furkankarakaya/GaN-Studies/README.md

# GaN-Studies
In this repository, GaN FET characterization and some power electronics topologies with GaN FETs are studied. <br />
Power Lab - http://power.eee.metu.edu.tr/
