furkankarakaya/GaN-Studies/Thesis/Appendix/Readme.md

# Personal Background
* [You can see my background through this link (CV)](https://sites.google.com/view/furkankarakaya/ana-sayfa)

# Papers
* [Investigation of Turn-on and Turn-off Characteristics of Enhancement-Mode GaN Power Transistors](https://ieeexplore.ieee.org/document/8515323)
* [PCB Layout Based Short-Circuit Protection Scheme for GaN HEMTs](https://ieeexplore.ieee.org/document/8913081)
* [Comparison of Wide-Band-Gap Technologies for Soft-Switching Losses at High Frequencies](https://ieeexplore.ieee.org/document/9079584)
* [Enhanced DAB for Efficiency Preservation Using Adjustable-Tap High-Frequency Transformer](https://ieeexplore.ieee.org/document/8930089)
* [High-Accuracy Calibration-Free Calorimeter for the Measurement of Low Power Losses](https://ieeexplore.ieee.org/document/9112711)
* [97.4%-Efficient All-GaN Dual-Active-Bridge Converter with High Step-up High-Frequency Matrix Transformer](https://ieeexplore.ieee.org/document/9178210)

# Simulation Documents

* [Switching Performance Analysis in Chapter 3](Chapter3_SimulinkModel.slx)
* [Buck Converter in Chapter 5](BuckConverter.asc)
* [Boost Converter in Chapter 5](BoostConverter.asc)

# PCB Documents
## Gate Charge Characterization Board

#### Top layer and top overlay

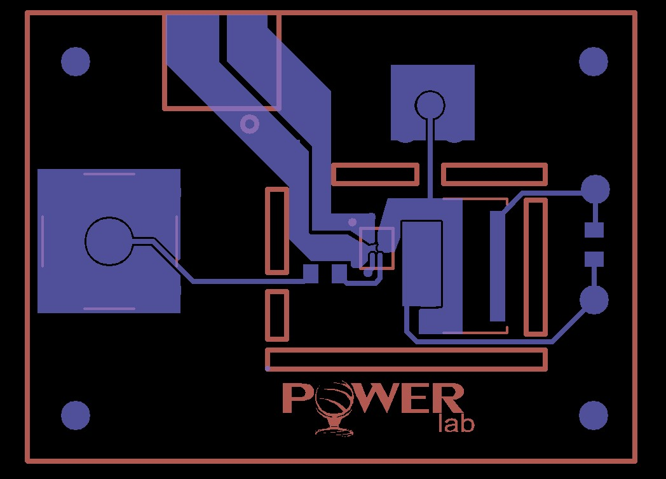
[picture p1: Thesis/Appendix/GateLossPCB.jpg]
</br>

## Output Capacitance Characterization Board

#### Top layer and top overlay

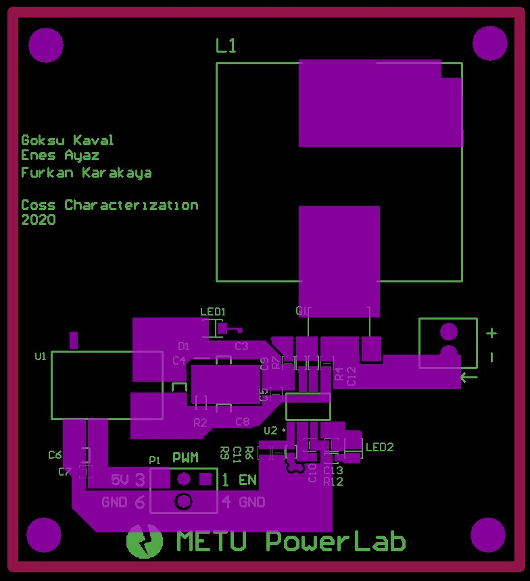
[picture p2: Thesis/Appendix/CossPCBTL.jpg]
</br>

#### Bottom layer and bottom overlay

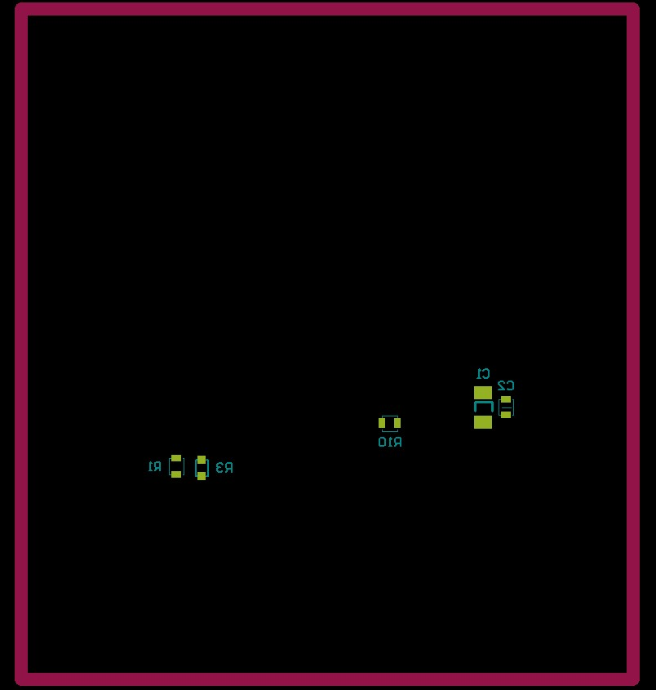
[picture p3: Thesis/Appendix/CossPCBBL.jpg]
</br>

## Control Board

#### Top layer and top overlay

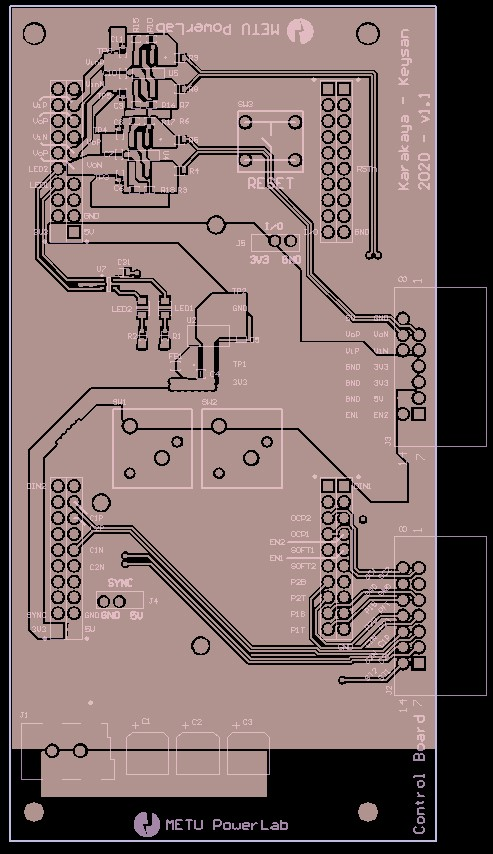
[picture p4: Thesis/Appendix/ControlBoardTL.jpg]
</br>

#### Bottom layer and bottom overlay

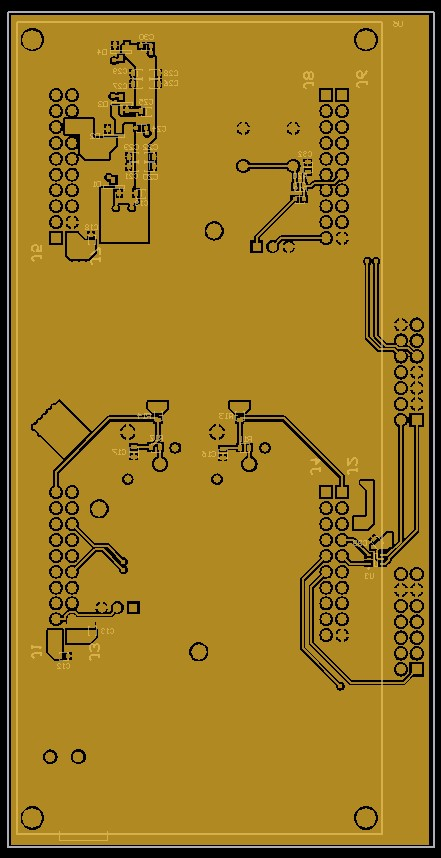
[picture p5: Thesis/Appendix/ControlBoardBL.jpg]
</br>

## DC/DC Converter Board

#### Top layer and top overlay

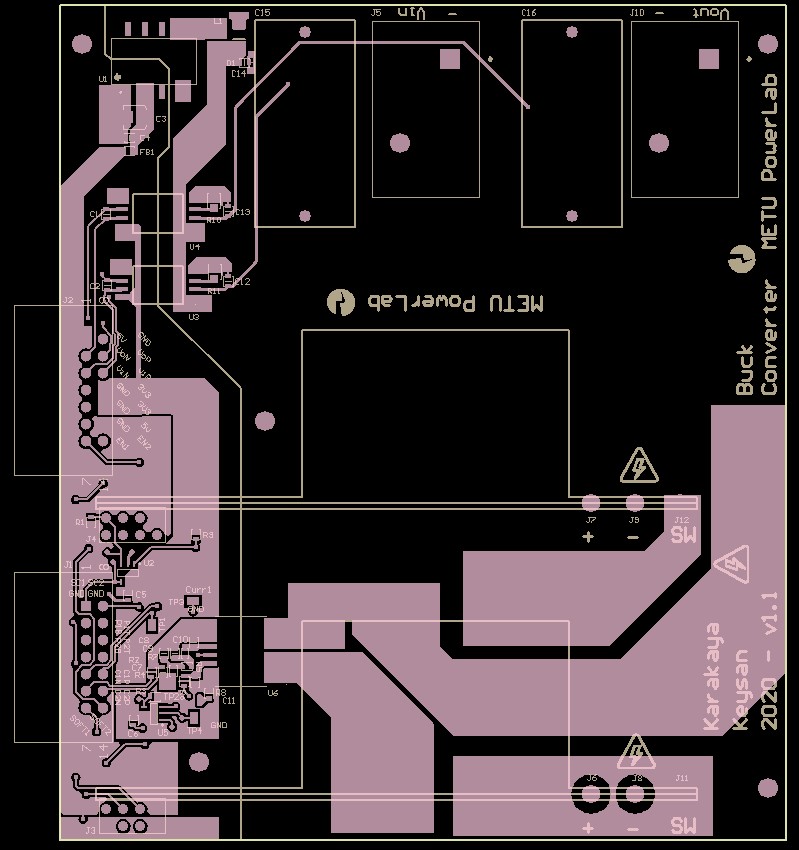
[picture p6: Thesis/Appendix/ConverterBoardTL.jpg]
</br>

#### Bottom layer and bottom overlay

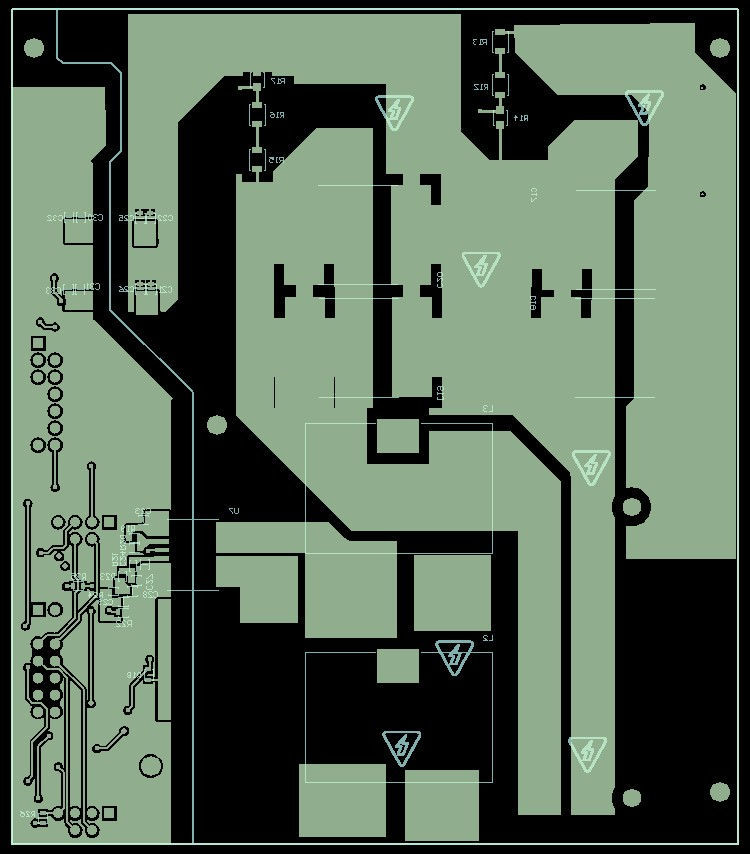
[picture p7: Thesis/Appendix/ConverterBoardBL.jpg]
</br>

## Half Bridge Board

#### Top layer and top overlay

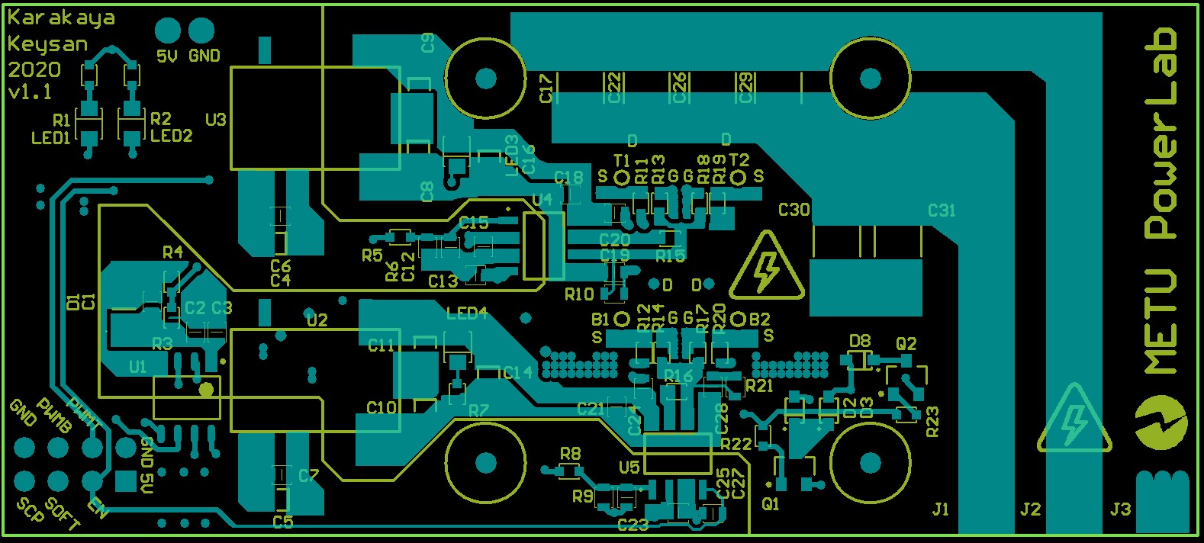
[picture p8: Thesis/Appendix/HalfBridgeBoardTL.jpg]
</br>

#### Middle 1

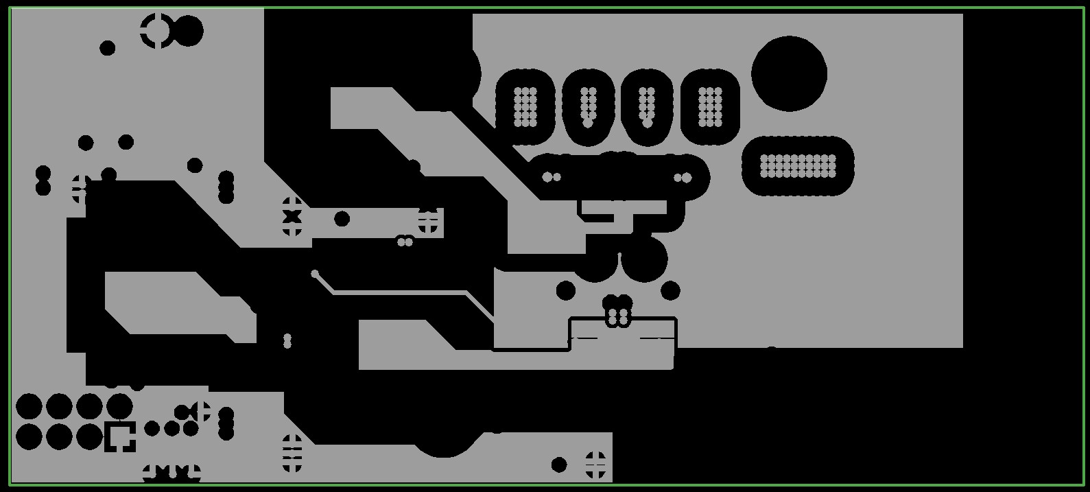
[picture p9: Thesis/Appendix/HalfBridgeBoardG1.jpg]
</br>

#### Middle 2

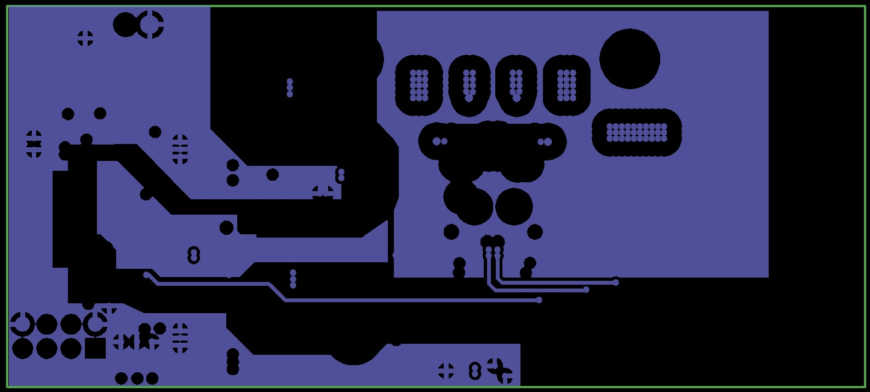
[picture p10: Thesis/Appendix/HalfBridgeBoardG2.jpg]
</br>

#### Bottom layer and bottom overlay

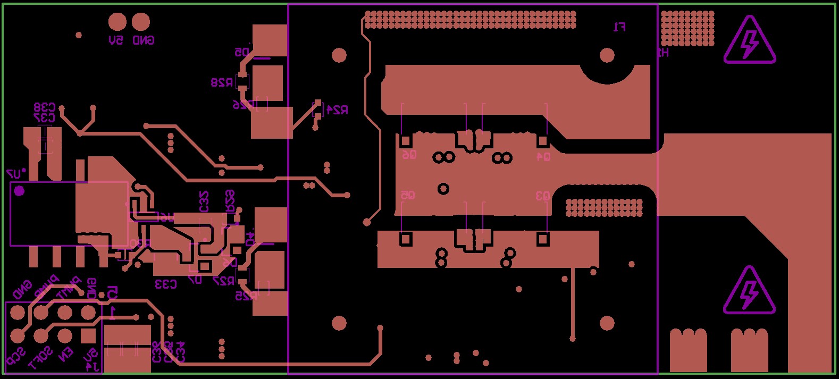
[picture p11: Thesis/Appendix/HalfBridgeBoardBL.jpg]
</br>
