furkankarakaya/GaN-Studies/Thesis/abbreviations.tex

\begin{theglossary}{LONGESTABBRV}

\item[2D]   2 Dimensional
\item[3D]   3 Dimensional
\item[UAV]  Unmanned Aerial Vehicle
\item[MDP]  Markov Decision Processes
\item[RL]   Reinforcement Learning
\item[DRL]  Deep Reinforcement Learning
\item[TRPO] Trust Region Policy Optimization
\item[PPO]  Proximal Policy Optimization
\item[PSO]  Particle Swarm Optimization
\item[MLP]  Multilayer Perceptron
\item[KL]   Kullback–Leibler
\item[PD]   Proportional-Derivative
\item[CoM]  Center of Mass
\item[p2p]  Point-to-point

\end{theglossary}

\newpage

\begin{theglossaryvar}{LONGESTABBRV}

\item[$M$]  Mass of bi-rotor body
\item[$m$]  Mass of tail
\item[$I$]  Inertia of bi-rotor body
\item[$I_{tail}$]  Inertia of tail
\item[$g$]  Gravitational acceleration
\item[$\mathbf{x}$]  State vector of bi-rotor system
\item[$p_x$]  Position of bi-rotor in x-direction
\item[$p_y$]  Position of bi-rotor in y-direction
\item[$\vartheta$]  Orientation of bi-rotor
\item[$v_x$]  Velocity of bi-rotor in x-direction
\item[$v_y$]  Velocity of bi-rotor in y-direction
\item[$\omega$]  Angular velocity of bi-rotor
\item[$\varphi$]  Orientation of tail with respect to bi-rotor body
\item[$\mathbf{u}$]  Input vector of bi-rotor system
\item[$f_l$]    Thrust of left rotor
\item[$f_r$]    Thrust of right rotor
\item[$\tau_{tail}$]   Torque applied to tail
\item[$\tau$]   Equivalent torque of left and right rotor thrusts
\item[$f$]   Sum of left and right rotor thrusts
\item[$s$]   State of an MDP
\item[$a$]   Action of an MDP
\item[$r$]   Reward of an MDP

\end{theglossaryvar}
