furkankarakaya/GaN-Studies/Thesis/chapters/chapter_2relwork.tex

\chapter{Related Work}%subject to change
\label{chp:relwork}

\section{Deep Reinforcement Learning}

\section{Curriculum Learning}

\section{Multi-rotor Control}
