furkankarakaya/GaN-Studies/Thesis/chapters/chapter_3mathbackgnd.tex

\chapter{Mathematical Background}
\label{chp:background}

\section{Bi-rotor Dynamics and Control}
\label{sec:dynamics}
