furkankarakaya/GaN-Studies/Weekly Reports/2020.05.18 - 2020.05.25.pptx

Inductor Design

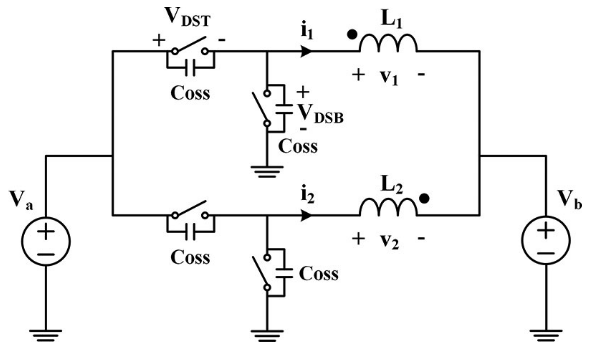
[picture p36: figure]

- Individual inductors for each phase
- Coupled inductor for two phases

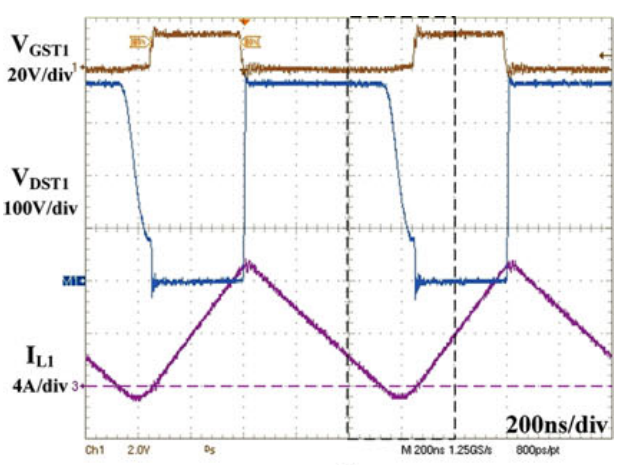
[picture p37: figure]
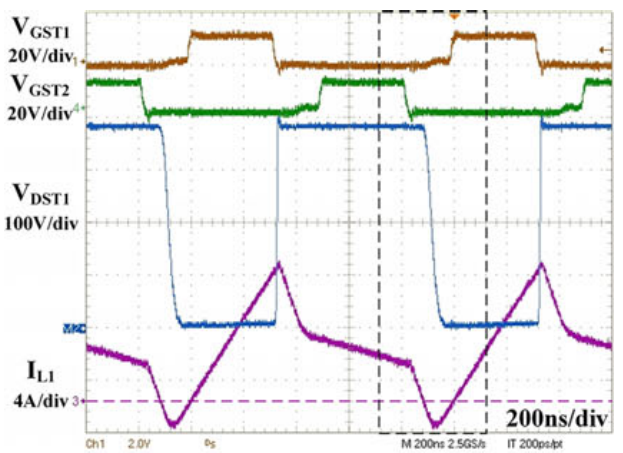
[picture p38: figure]

Individual Inductor

Coupled Inductor

## Slide 2

Inductor Design

5W losses for full load operation (8A) at 1 MHz switching frequency

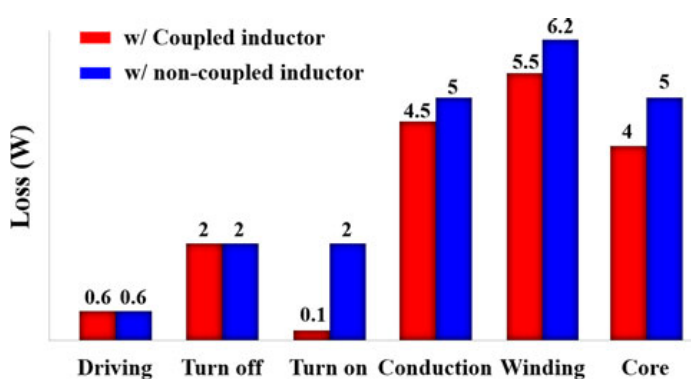
[picture p39: figure]

Coupled cores are advantageous for
  - Shorter resonant period
  - Lower core losses
  - Lower current ripple

but
  - Requires complex design

«Core loss is also reduced with coupled inductor since core volume can be shrink due to certain dc flux cancellation»

## Slide 3

Lets verify it

Non-coupled inductor material

ER23 (http://ferroxcube.home.pl/prod/assets/er23.pdf) core with 3F45 (https://elnamagnetics.com/wp-content/uploads/library/Ferroxcube-Materials/3F45_Material_Specification.pdf) material from Ferroxcube
- AL -> 1850 nH
- μr -> 840

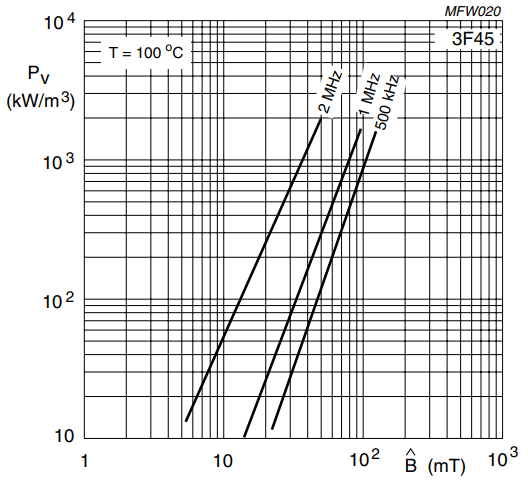
[picture p40: figure]

Specific power loss of 3F45 material

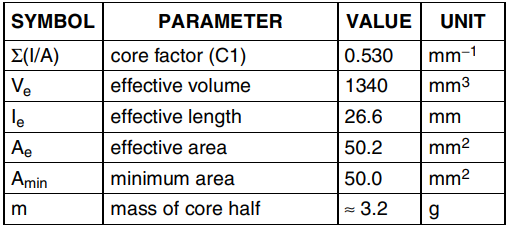
[picture p41: figure]

Effective core parameters

## Slide 4

Lets verify it

L = 8 μH
N =sqrt(L/(A_L)) = 2.079 −> 2
φ=(NI)/R
ΔB=(NΔI)/(RA_e)
R=(l_e)/(μ_r μ_o A_e)
ΔB=(NΔIμ_r μ_o)/(l_e)
ΔB=(2∗9 ∗840∗4π10^(−7))/(26.6∗10^(−3))=714 mT

Current Waveform

5Arms current with 4A average

9App ripple on inductor

## Slide 5

Lets verify it

P_(sp) =4∗10^5 (kW)/(m^3)
V_e =1340 mm^3
P_(core) =1340∗10^(−9) ∗4∗10^8
P_(core) =536 W

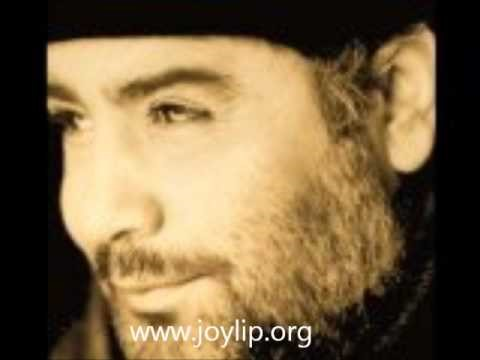
[picture p42: figure]

40x
