furkankarakaya/GaN-Studies/Weekly Reports/2020.03.30 - 2020.04.06.pptx

Common Mode Noise

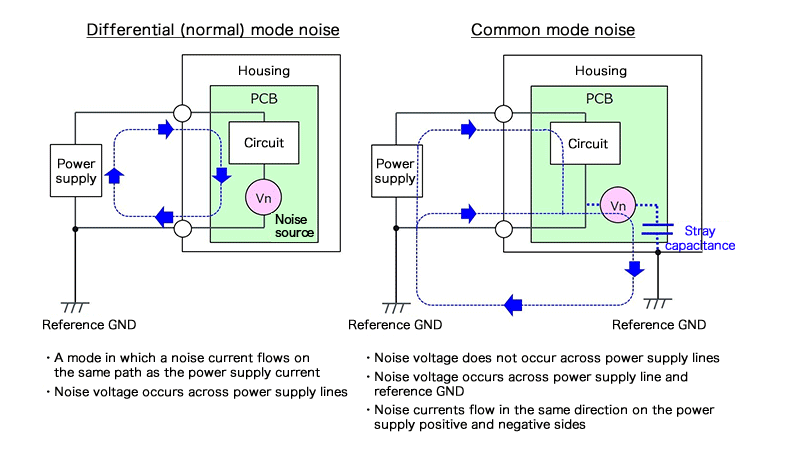
[picture p48: figure]

## Slide 2

Common Mode Noise

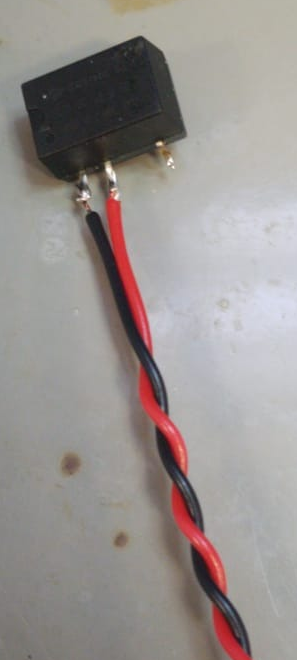
[picture p49: figure]

High side isolated converter

## Slide 3

Common Mode Noise

## Slide 4

Common Mode Noise

## Slide 5

SCP

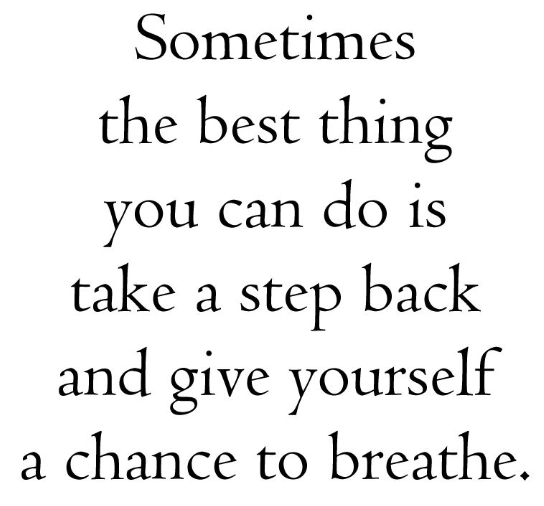
[picture p50: figure]

## Slide 6

Power Converters

Ciso -> Not given

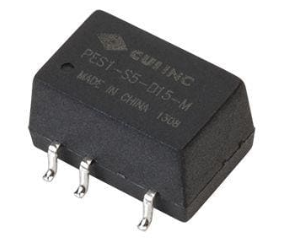
[picture p51: figure]

PES1-S5-S9-M (https://www.mouser.com.tr/ProductDetail/CUI-Inc/PES1-S5-S9-M)

Ciso -> 15 pF

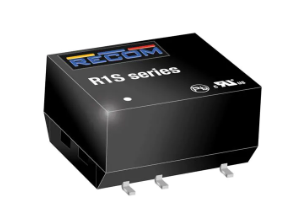
[picture p52: figure]

R1S-0509/HP (https://www.mouser.com.tr/ProductDetail/RECOM-Power/R1S-0509-HP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)

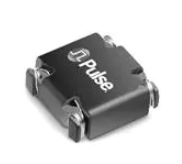
[picture p53: figure]

PL8209 (https://www.mouser.com.tr/ProductDetail/PulseR/PL8209?qs=sGAEpiMZZMsVJzu5wKIZCQwVz3yUW2PGb9zrT75a8DU%3D)

6 kohm @ 10 MHz

R1S-0505/HP (https://www.mouser.com.tr/ProductDetail/RECOM-Power/R1S-0505-HP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)

Ciso -> 35 pF

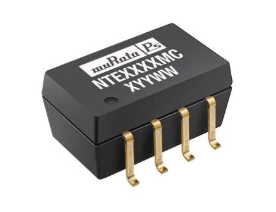
[picture p54: figure]

NTE0505MC (https://www.mouser.com.tr/ProductDetail/Murata-Power-Solutions/NTE0505MC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)

## Slide 7

Thesis Outline

- Introduction
- Gate Charge Characterization (EPFL, TPEL), Output Capacitance Characterization (Göksu + Enes)
- Modelling and Switching Characteristics (EPE + ECCE)
- Half-Bridge Design, Layout, SC, Paralleling (TPEL)
- DC/DC Converter Design (TPEL)
- 5-ph Inverter Design (Optional ?)
- Conclusion
