furkankarakaya/GaN-Studies/Weekly Reports/2020.03.02 - 2020.03.09.pptx

DPT

Ferrite Core + Normal Wire
vs
Air Core + Litz Wire

Air core + litz wire have linear characteristic which makes them preferrable

## Slide 2

DPT

Voltage/Current ratio is as constant as 10

## Slide 3

DPT

## Slide 4

DPT

Clamped before SC Trig

This is a pure noise

DSP is triggered by an AND gate IC which ands SCP and OCP signals. Even though the SCP had not been triggered yet (green), STO was enabled (red) which indicated the OCP signal reaction. All damaged current sensor ICs are desoldered and then, DPTs are done upto 350V without a mis-trigger.

## Slide 5

SCT

Actual
response for SC

We have a clear noise problem which requires filtering for best result

Probe neg. terminal is connected to variable voltage point

SC exists for 100 nsec

## Slide 6

SCT

0 < fbandpass < 150 MHz

On-board R-C filter

0 < fbandpass < 15 MHz

## Slide 7

SCT

BONUS
How to decide threshold level?

## Slide 8

SCT

SC exists for 200 nsec

SC exists for 100 nsec

## Slide 9

SCT

100V

200V

## Slide 10

SCT

300V

400V
