furkankarakaya/GaN-Studies/Weekly Reports/2020.01.20 - 2020.01.27 - Kopya.pptx

Thermal Tests

0.5 C/W

3.5 C/W

15.87 C/W

Measured
90˚ rotated
Theatsink -> 76.4 C
Vgan = 461 mV
Igan = 7.5 A
Ploss = 3.46 W
Thermal resistance of HS 15.87 C/W heatsink resist.
Nonrotated
Theatsink -> 74 C
Vgan = 450.5 mV
Igan = 7.5 A
Ploss = 3.38 W

20 C

7.5 A source current

Rotation does not affect the result significantly but it worsened the situation

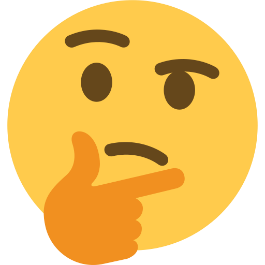
[picture p67: figure]
emoji thinking ile ilgili görsel sonucu

## Slide 2

Thermal Tests

These results are valid for 6mm HS with the fan (LLB)

The resistance varies with temperature

Rated Loss
Ptop = 4.6 W
Pbot = 3.8 W
Ptotal = 16.8 W

Similar loss is applied

The tests are completed without a failure

## Slide 3

Thermal Tests

Estimated thermal resistance of heatsink

R_(heatsink) =11.97∗T_(heatsink)^0.356

These results are valid for 6mm HS with the fan (LLB)

140˚ of junction temperature
has been achieved

## Slide 4

Thermal Tests

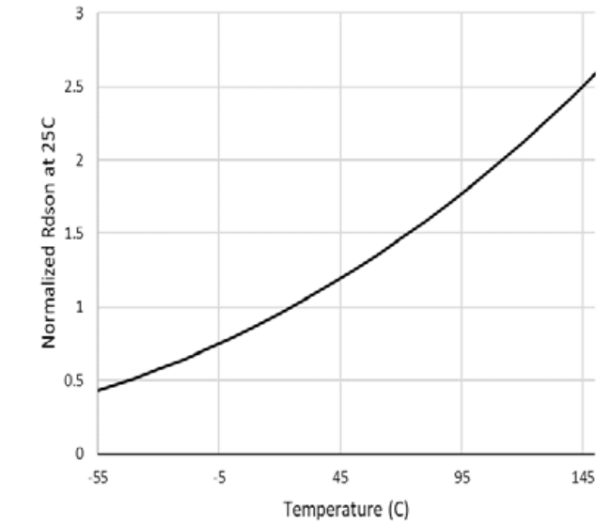
[picture p68: figure]

Junction temperature does not affect the on-state resistance that significantly

## Slide 5

Thermal Tests - Conclusion

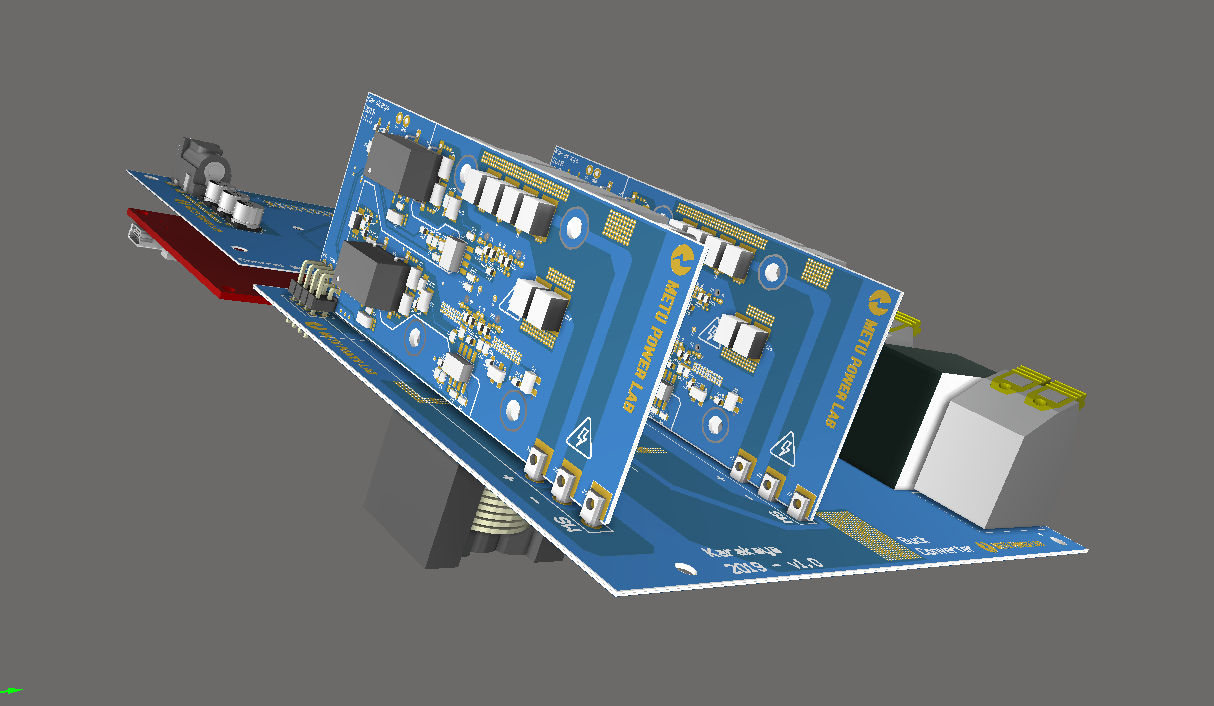
[picture p69: figure]

Version 1.0
Volume = 0.8545 lt
Power Denisty = 9.363 kW/lt
Version 1.1 – 6mm HS
Volume = 0.7652 lt
Power Density = 10.455 kW/lt
Version 1.1 – 10mm HS
Volume = 0.80901 lt
Power Density = 9.889 kW/lt

134 mm edge should be reduced to 125 mm to have 10 kW/lt power density

40

109

18.5

134

## Slide 6

Analog Voltage Measurements

Input Voltage
VDC | Vamp,out | DSP
51.7 V | -263 mV | -25V ± 3
100.9 V | -505 mV | -48V ± 2.5
150.7 V | -760 mV | -72V ± 2
201.7 | -1017 mV | -98V ± 3

0.5% error at rated voltage

Output Voltage
VDC | Vamp,out | DSP
51.11 V | -346 mV | -25V ± 2
101.2 V | -681 mV | -50V ± 2.5
150.5 V | -1012 mV | -72V ± 3
199.6 V | -1325 mV | -98V ± 2.5

0.75% error at rated voltage

How to reduce error ?

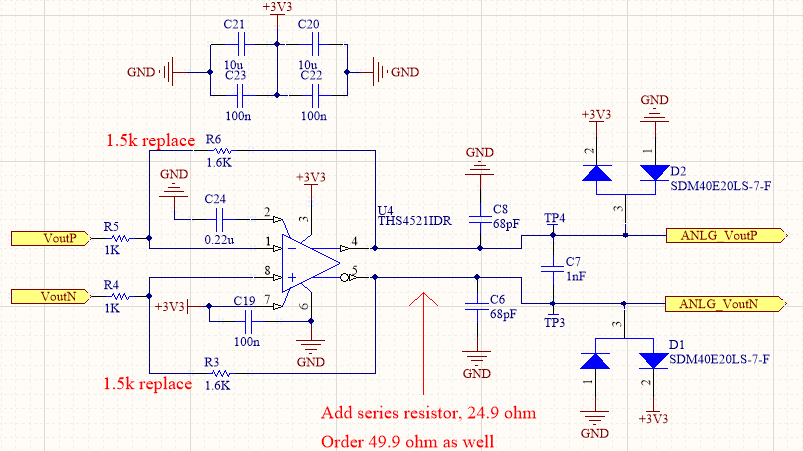
[picture p70: figure]

## Slide 7

New Board Designs – Connector Selection

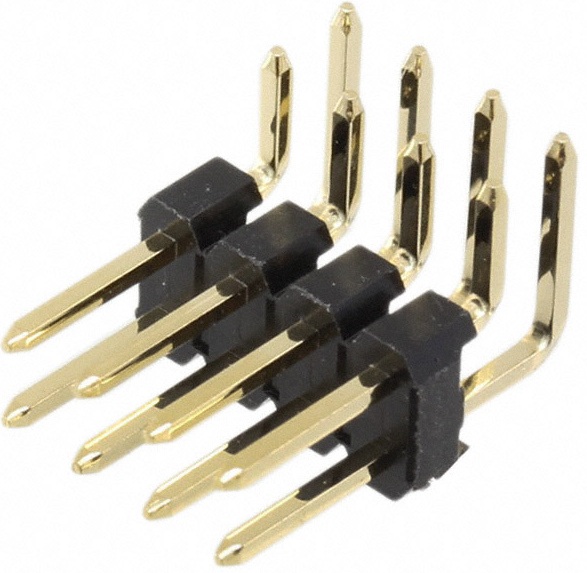
[picture p71: figure]

0.906 mm diameter

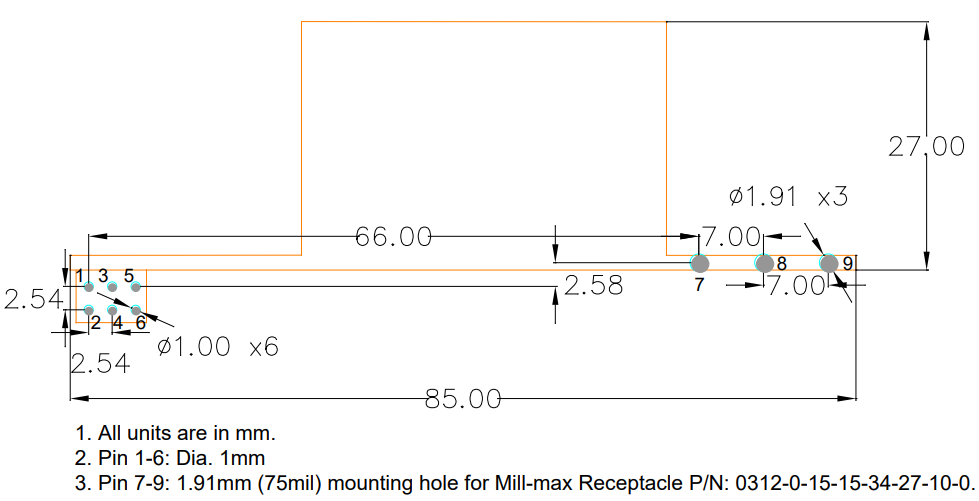
[picture p72: figure]

GaN Systems Solution

8 vias with 0.95 mm hole diameter

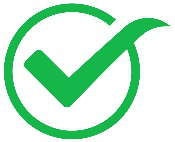
[picture p73: figure]
tick symbol ile ilgili görsel sonucu
