furkankarakaya/GaN-Studies/Weekly Reports/2019.09.18 - 2019.09.25 Report.pptx

Capacitor Selection

(x2)

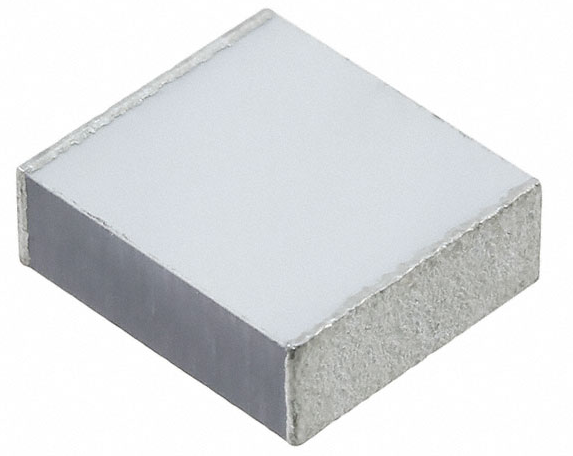
[picture p74: figure]

(x1)

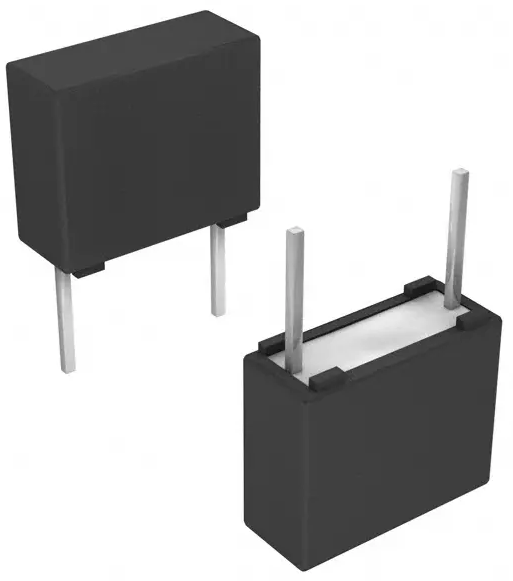
[picture p75: figure]

SMD component – 0.22uF
(LDEPH3220KA5N00 (https://www.digikey.com/product-detail/en/kemet/LDEPH3220KA5N00/399-12904-1-ND/5731478))

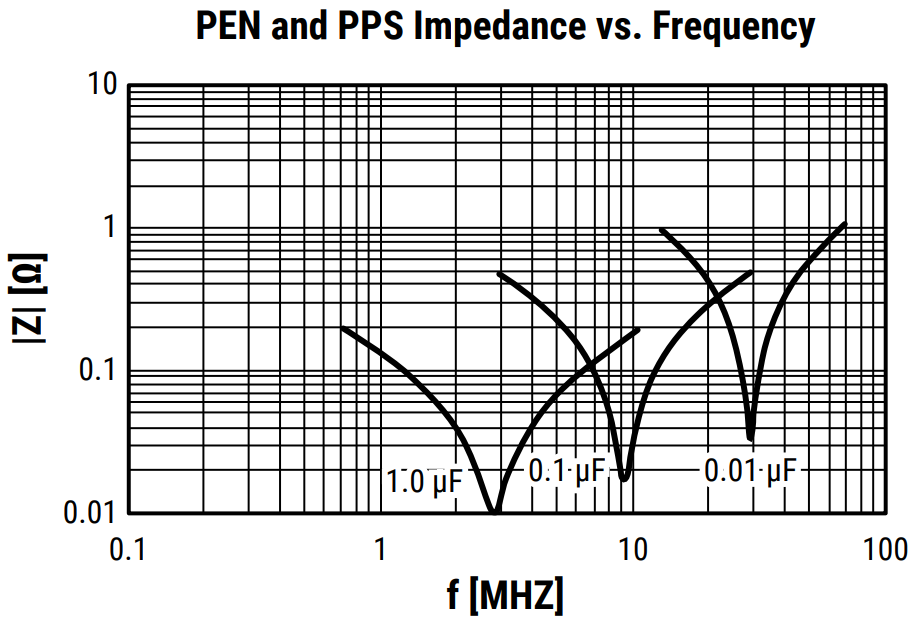
[picture p76: figure]

+

TH component – 0.68uF
(BFC238320684 (https://www.digikey.com/product-detail/en/vishay-bc-components/BFC238320684/BC1880-ND/502660))

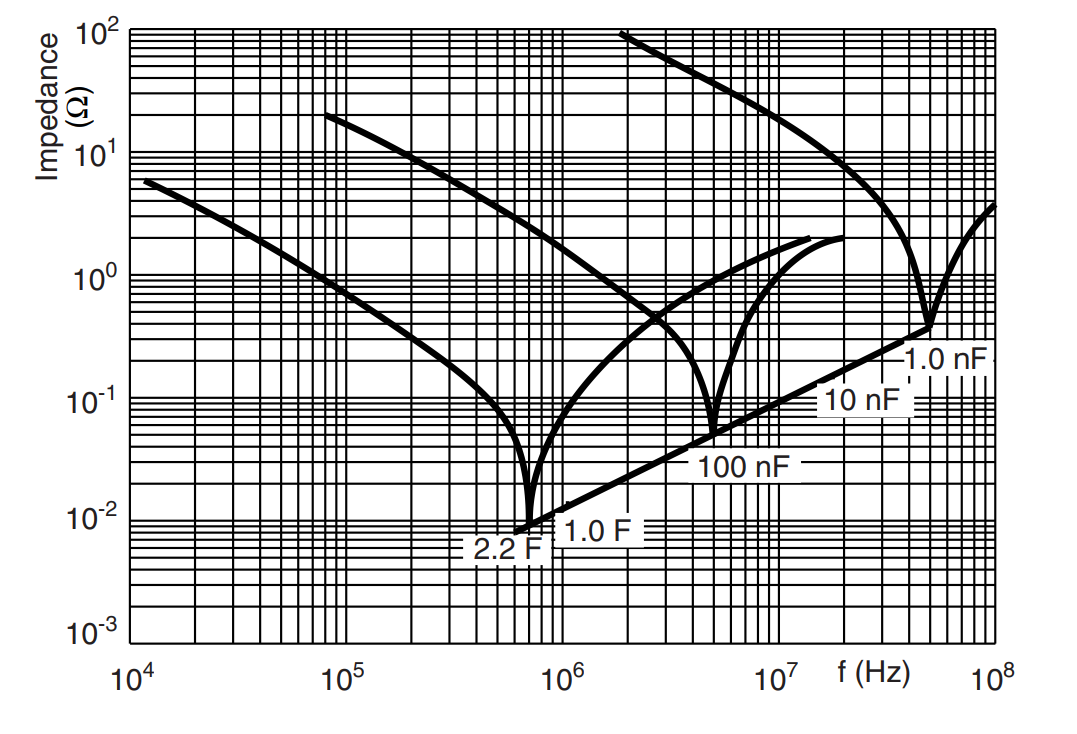
[picture p77: figure]

= 6 Capacitors: 3 Inp + 3 Out

## Slide 2

Capacitor Selection – Bypass Capacitor

IMMD Bypass Capacitors
C3216X7T2W104K160AE – 1206 Package
- Capacitance: 100 nF
- ESL: 0.75 nH
- ESR: 17.5 mohm
- Voltage: 450 Vdc

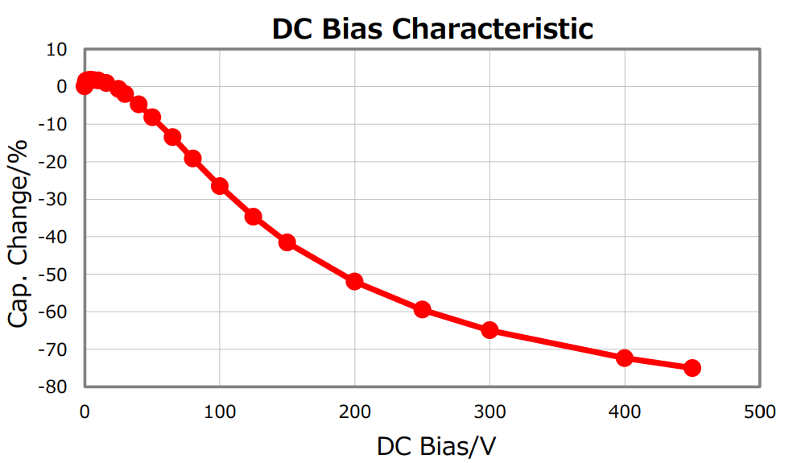
[picture p78: figure]

Buck Conv. Bypass Capacitors
C4532X7T2J224M200KC – 1812 Package
- Capacitance: 220 nF
- ESL: 0.7 nH
- ESR: 13.4 mohm
- Voltage: 630 Vdc

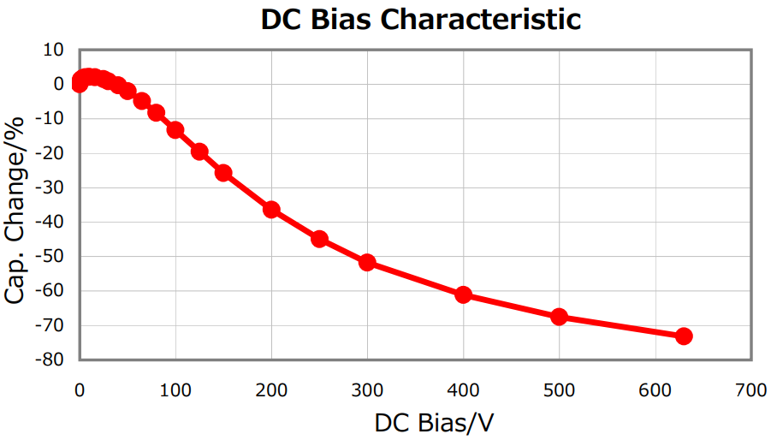
[picture p79: figure]

Effective Capacitance
35 nF

Effective Capacitance
66 nF

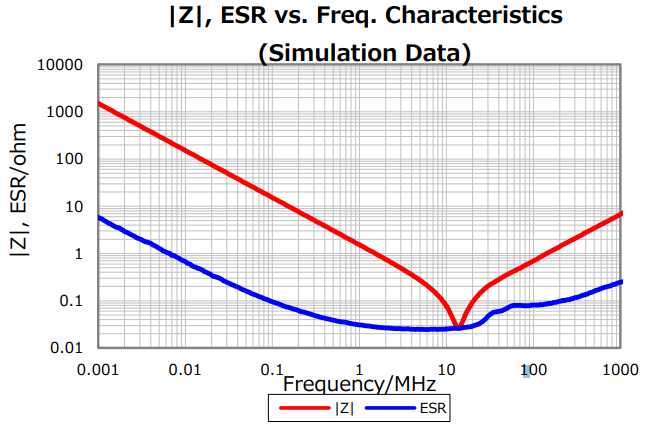
[picture p80: figure]
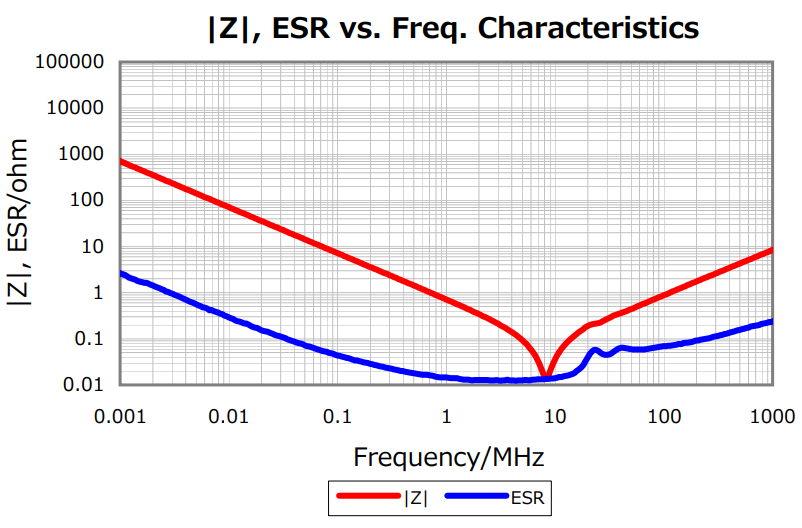
[picture p81: figure]

Low number of this capacitor can be used

## Slide 3

Heat Sink Selection – Daughter Board Example

TIM is the bottleneck

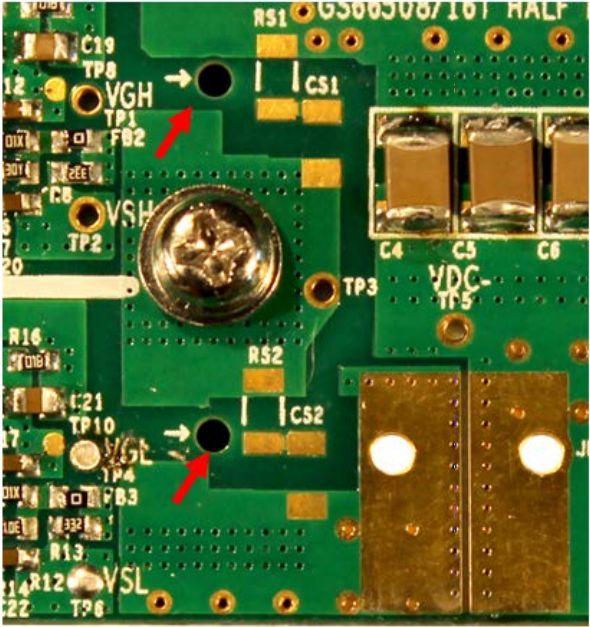
[picture p82: figure]
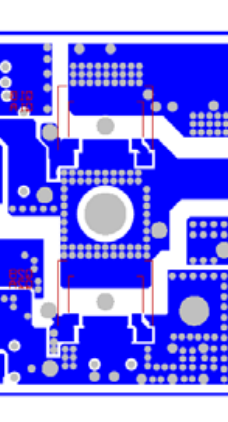
[picture p83: figure]
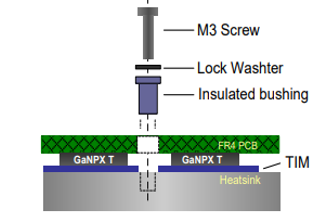
[picture p84: figure]
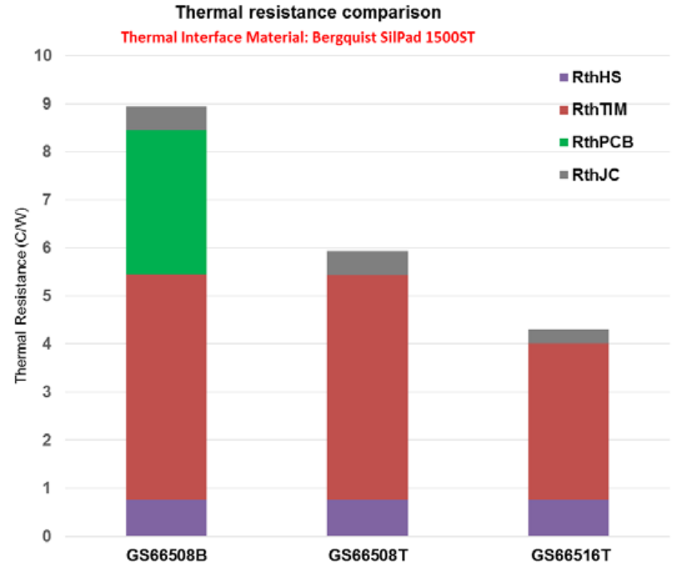
[picture p85: figure]

Thermal pad of 516T is 2.3 times of 508T’s thermal pad

Important Disadvantage for Bottom Cooled Transistors

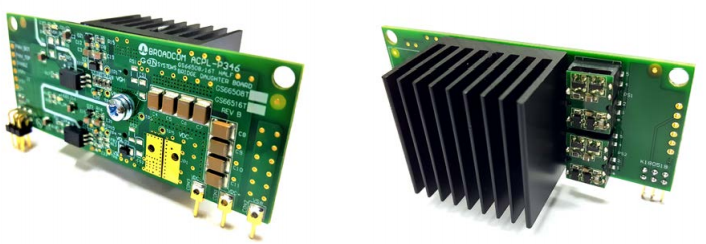
[picture p86: figure]

## Slide 4

Heat Sink Selection – Thermal Resistance Calculation

Assumptions:
- Losses are calculated as 4.6 W and 3.8 W for top and bottom transistors. These losses are assumed as 6 W.
- Ambient temperature is assumed as 40 ˚C.
- Operation temperature is set as 120 ˚C.
- Junction-to-case thermal resistance is taken from datasheet and its value is 0.45 ˚C/W.
- TIM is selected as A17682-008 (https://www.mouser.com.tr/ProductDetail/Laird-Performance-Materials/A17682-008) and its thermal resistance is calculated as 3.56 K/W. (A better option is A10092-01 (https://www.digikey.com/product-detail/en/laird-technologies-thermal-materials/A10092-01/926-1540-ND/2754543) and its thermal resistance is 2.28 K/W)

R_(TIM) =α ∗(25.4)^2 ∗1/((Length_(mm) ∗Width_(mm) ∗1.5^2 ))

α is thermal impedance in °C∗(in^2)/W

R_(th) _(total) =(T_j −T_(amb))/(P_(loss))

R_(th) _(total) −R_(TIM) −R_(JC) =8∗R_(HS)

R_(th) _(total) −R_(TIM) −R_(JC) =8∗R_(HS) →R_(HS) ≅1.21 °C/W

OR

R_(HS) ≅2.4 °C/W for seperate bridges

## Slide 5

Heat Sink Selection – Option #1

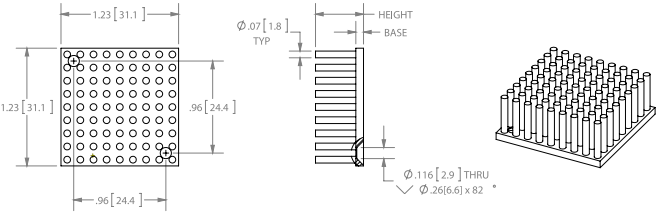
[picture p87: figure]

Air flow (CFM) is proportional to thickness of fan and its power

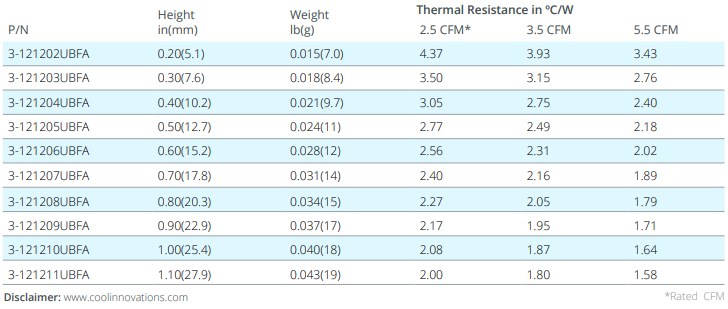
[picture p88: figure]

240.13 LFM - 1.22 m/s

Link (http://www.coolinnovations.com/datasheets/3-1212XXUBFA.pdf)

## Slide 6

Heat Sink Selection – Option #2

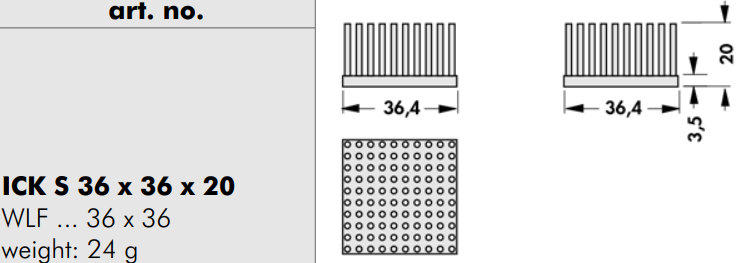
[picture p89: figure]
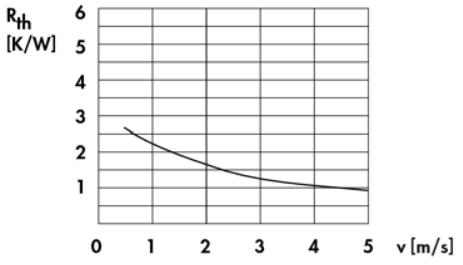
[picture p90: figure]

@ 2.75 CFM & 197 LFM

Link - NonStock (https://tr.rsdelivers.com/product/fischer-elektronik/%c4%b1ck-s-36x36x20/heatsink-soutucu-32k-w-yapkan-folyo-iletken-folyo/6744822)

## Slide 7

Heat Sink Selection – Option #3

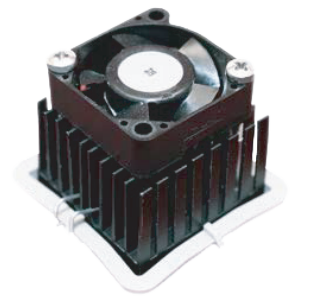
[picture p91: figure]
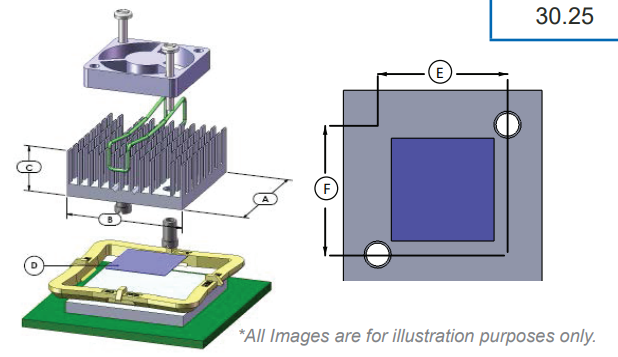
[picture p92: figure]

L x W x H – 30.25 x 30.25 x 14.5 - 2.1 C/W @ 200LFM, 1 m/s, 2 CFM

Link (https://www.mouser.com.tr/ProductDetail/Advanced-Thermal-Solutions/ATS-61310K-C1-R0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)

## Slide 8

Heat Sink Selection – Option #4

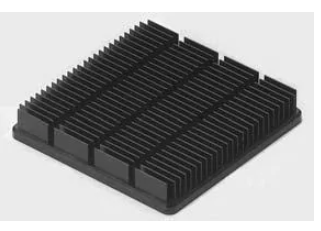
[picture p93: figure]
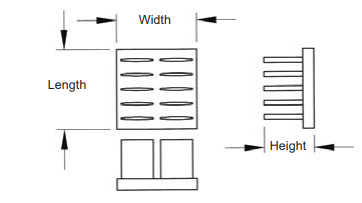
[picture p94: figure]

L x W x H – 30 x 30 x 12.7 - 2.7 C/W @ 200LFM, 1 m/s, 2 CFM

L x W x H – 40 x 40 x 9.5 – 2.5 C/W @ 200LFM, 1 m/s, 3.44 CFM

Link (https://www.digikey.com/product-detail/en/cts-thermal-management-products/APF30-30-13CB-A01/294-1156-ND/1278282)

## Slide 9

Heat Sink Selection – Option #5

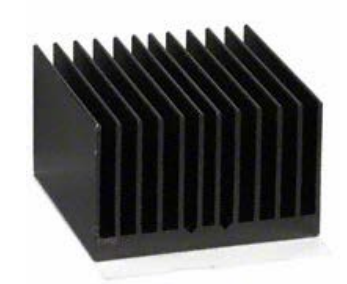
[picture p95: figure]
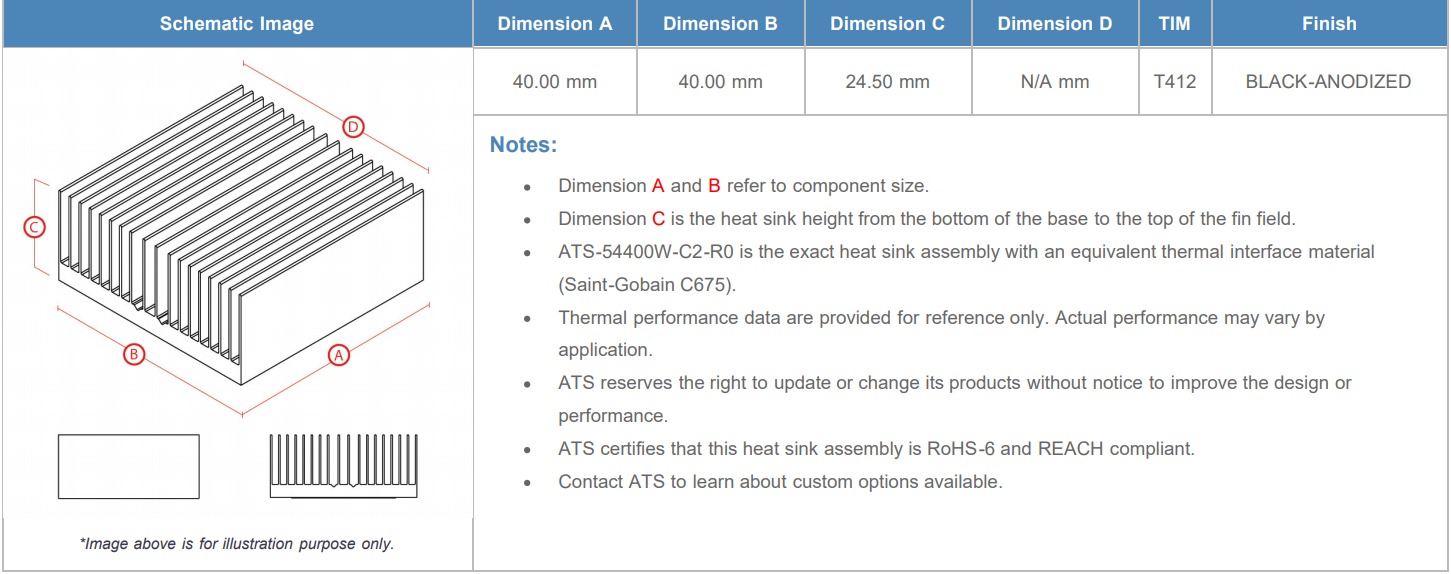
[picture p96: figure]

L x W x H – 40 x 40 x 24.5 – 2.4 C/W @ 200LFM, 1 m/s, 3.44 CFM

Link (https://www.mouser.com.tr/ProductDetail/Advanced-Thermal-Solutions/ATS-54400W-C1-R0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)

## Slide 10

Heat Sink Selection – Option #6

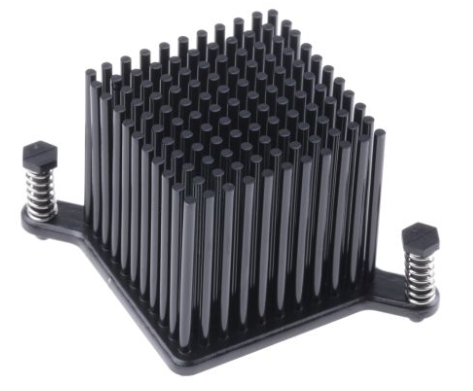
[picture p97: figure]

L x W x H –37.5 x 37.5 x 33 – 2.4 C/W @ 100LFM, 1 m/s, 1.51 CFM

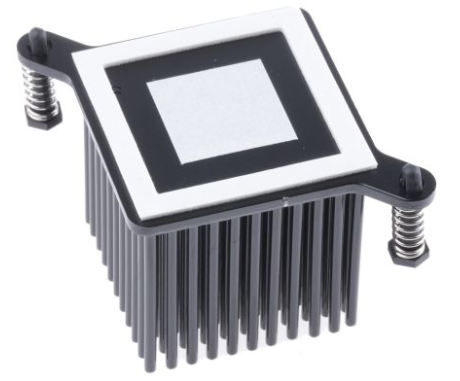
[picture p98: figure]

Link (https://tr.rsdelivers.com/product/malico/cmba024949/heatsink-soutucu-25k-w-vidal-bga/0467523)
