furkankarakaya/GaN-Studies/Weekly Reports/2019.12.23 - 2019.12.30.pptx

Peak level (234V)

SC Begins

Hard Turn-Off

10V

## Slide 2

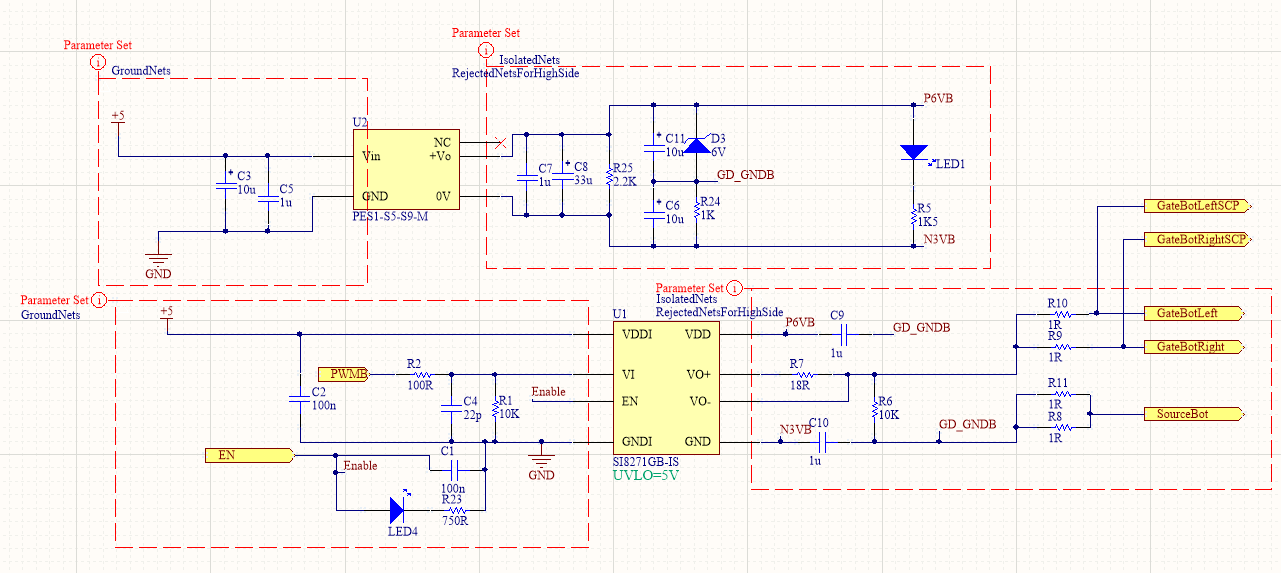
[picture p124: figure]
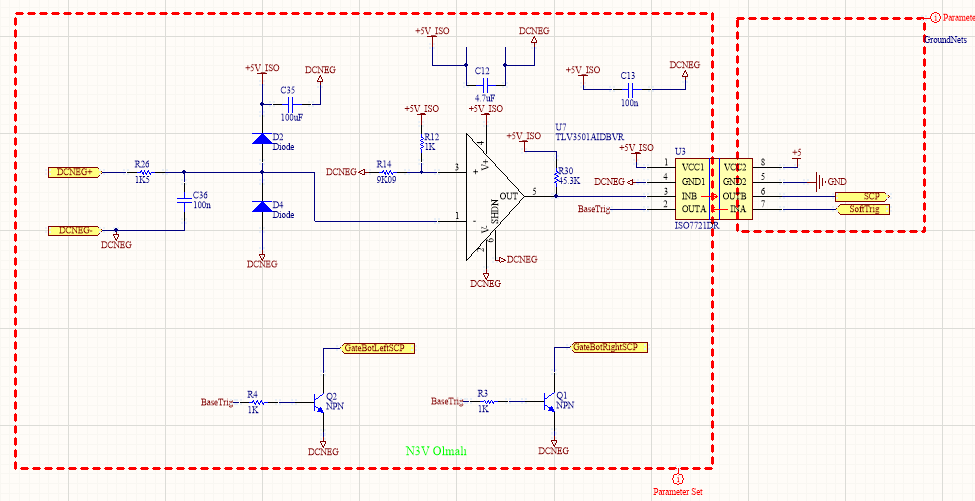
[picture p125: figure]

## Slide 3

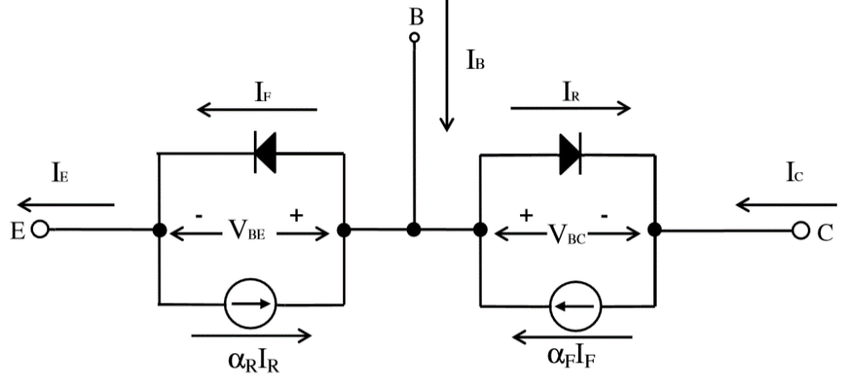
[picture p126: figure]
bjt eber moll model ile ilgili görsel sonucu

Ebers Moll Model

## Slide 4

???

Observation List
- BJT Base voltage wrt Emitter voltage
- BJT Collector voltage wrt Emitter voltage
- BaseTrig voltage wrt Emitter voltage
- Isolated supply for comparator
- Positive and negative terminal voltages of isolated gate driver supply wrt gnd net

## Slide 5

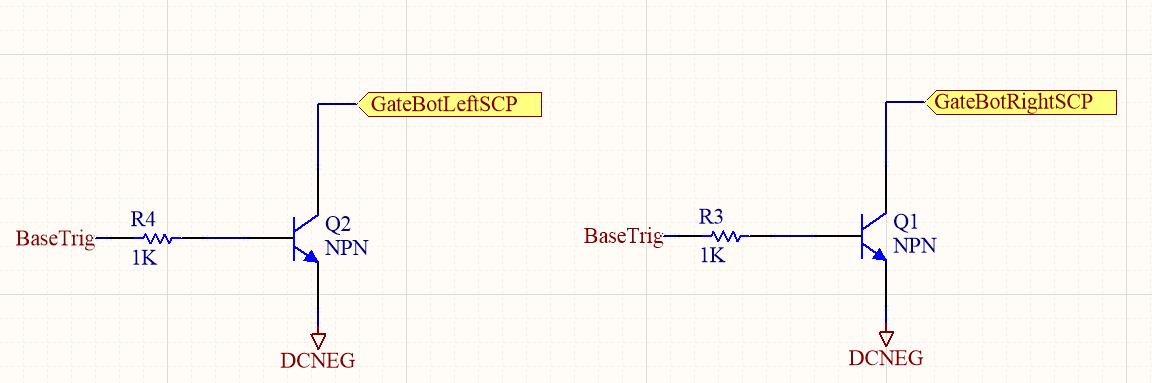
[picture p127: figure]

Solution
