furkankarakaya/GaN-Studies/Weekly Reports/2019.11.25 - 2019.12.02.pptx

Inductor Loss Considerations

Aim: To investigate temperature rise of inductor w.r.t. switching frequency under constant current ripple

Conditions: ΔI = 30App L = 6.8uH
Rload = 24 Ω
Iout = 6A
Vout = 144V
Pout = 864W

Outcome:
There will be a temperature vs frequency plot at the end of this test

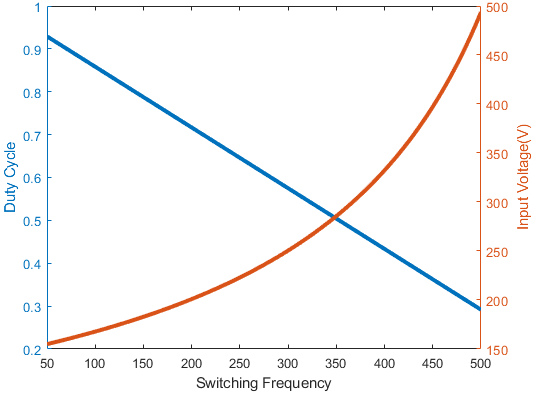
[picture p128: figure]

D=1−(L∗f_(sw) ∗δI)/(V_(out))

V_(inp) =(V_(out))/D
