furkankarakaya/GaN-Studies/Weekly Reports/2019.09.25 - 2019.10.02 Report.pptx

Heatsink Selections – Fan Selection

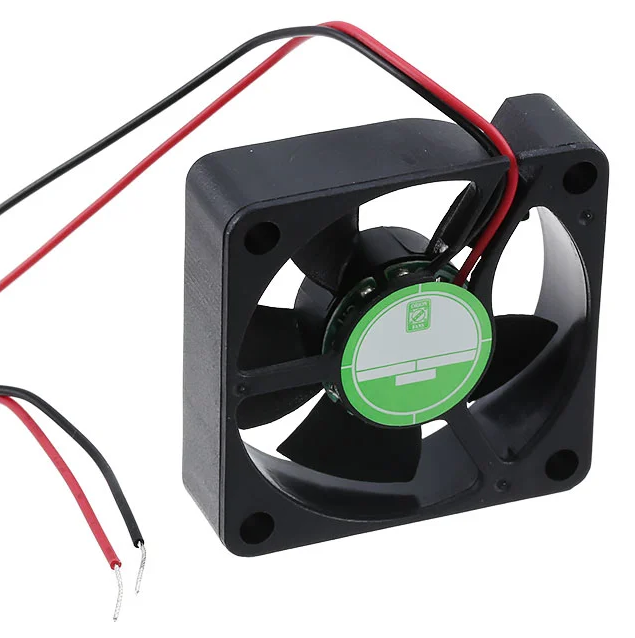
[picture p129: figure]
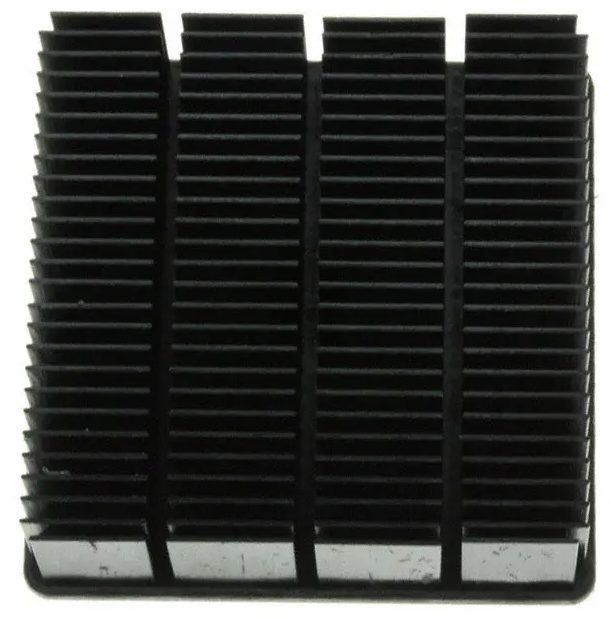
[picture p130: figure]
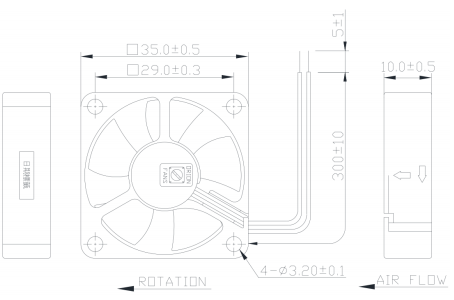
[picture p131: figure]

Link (https://www.digikey.com/product-detail/en/cts-thermal-management-products/APF40-40-13CB/294-1161-ND/1278287)

Link (https://www.digikey.com/product-detail/en/orion-fans/OD3510-05LLB/1053-1684-ND/5361041)

## Slide 2

PCB Design – Gate Loop

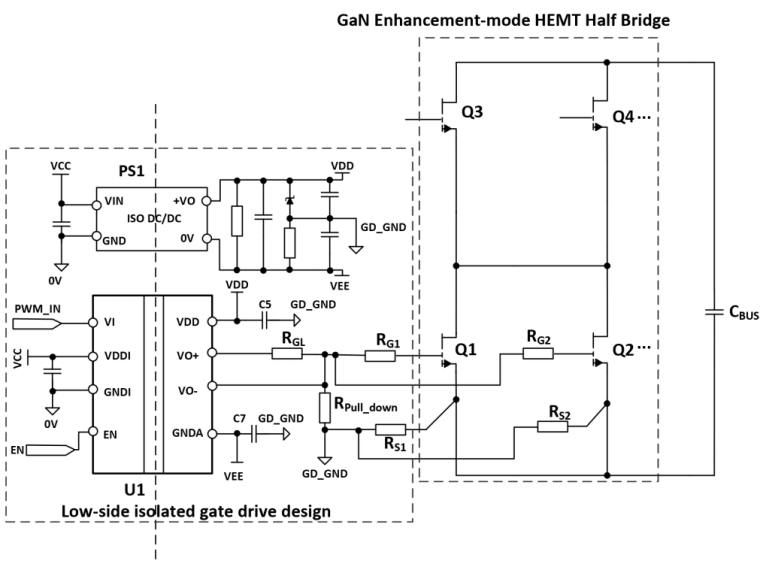
[picture p132: figure]

Resistances to be placed on CSI loops to eliminate unbalance and oscillations

## Slide 3

PCB Design – Power Loop

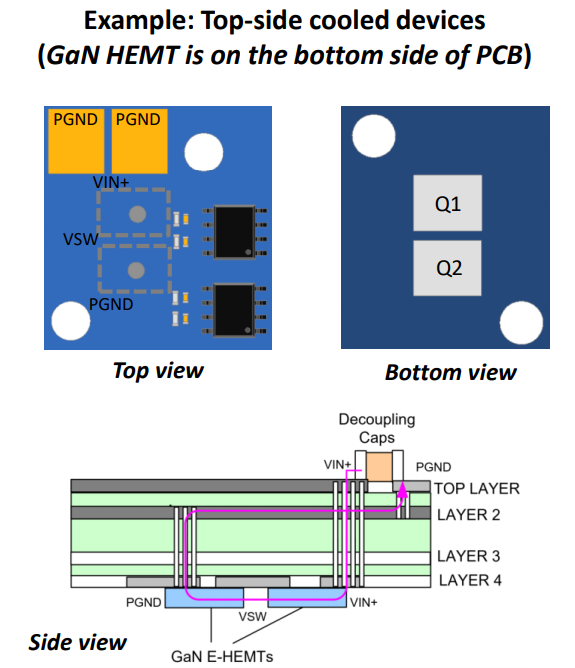
[picture p133: figure]

The main concern for top cooled transistors is having bypass capacitors on the top layer because of the heatsink

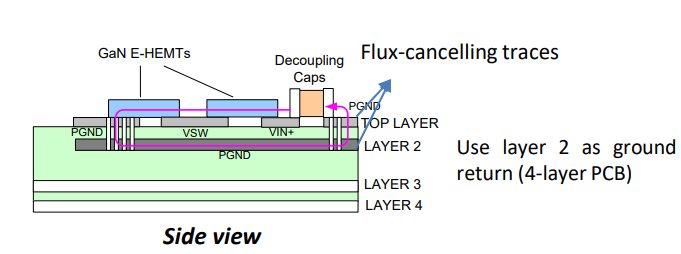
[picture p134: figure]

Not possible

Positive and negative nets of DC Bus coincide here. Clearence and route width are the concerns
