furkankarakaya/GaN-Studies/Paralleling/Parallelling Report.docx

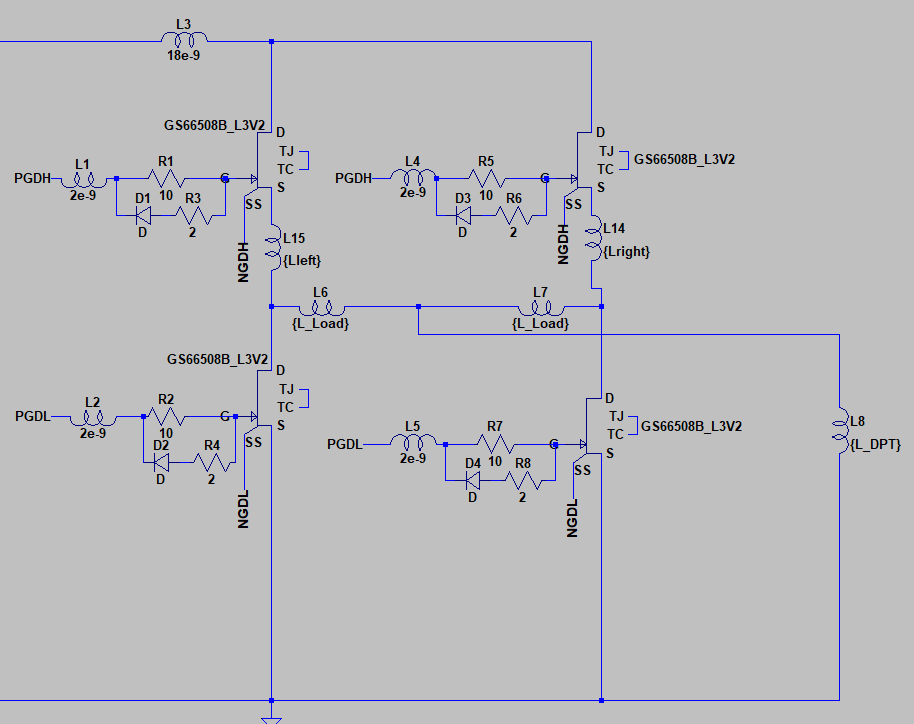
[picture p176: figure]

Figure 1: Simulation Circuit

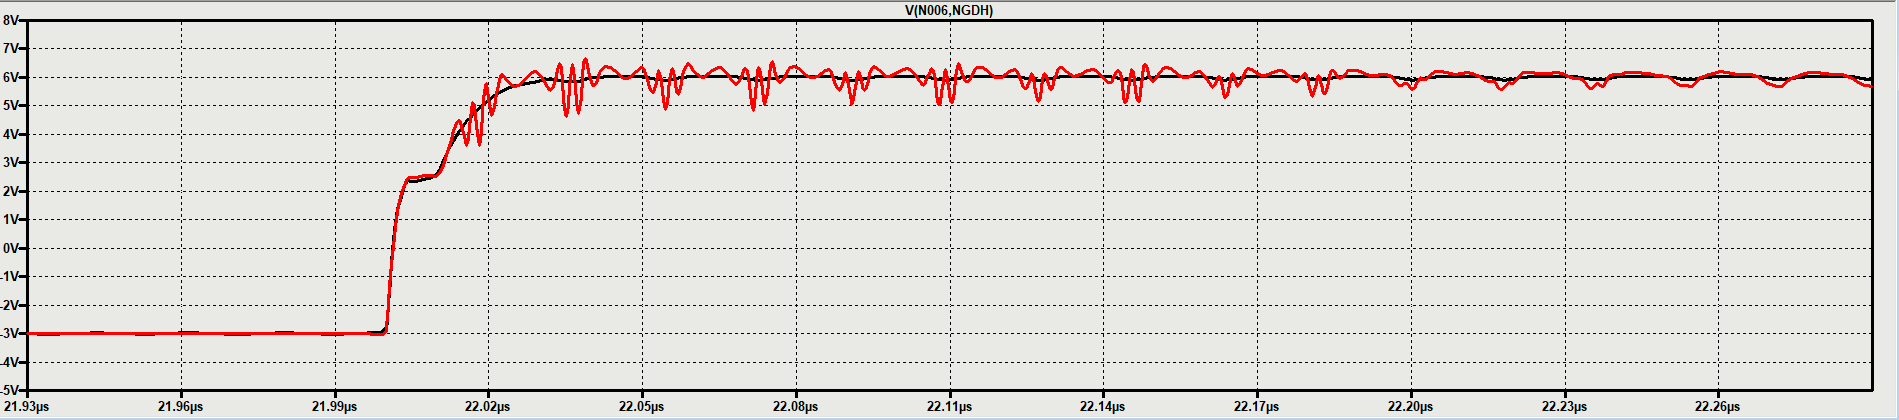
[picture p177: figure]

Figure 2: 1nH - 1nH & 1nH - 6nH Top Switch GS Waveforms when Load Conn. Ind. is 3nH

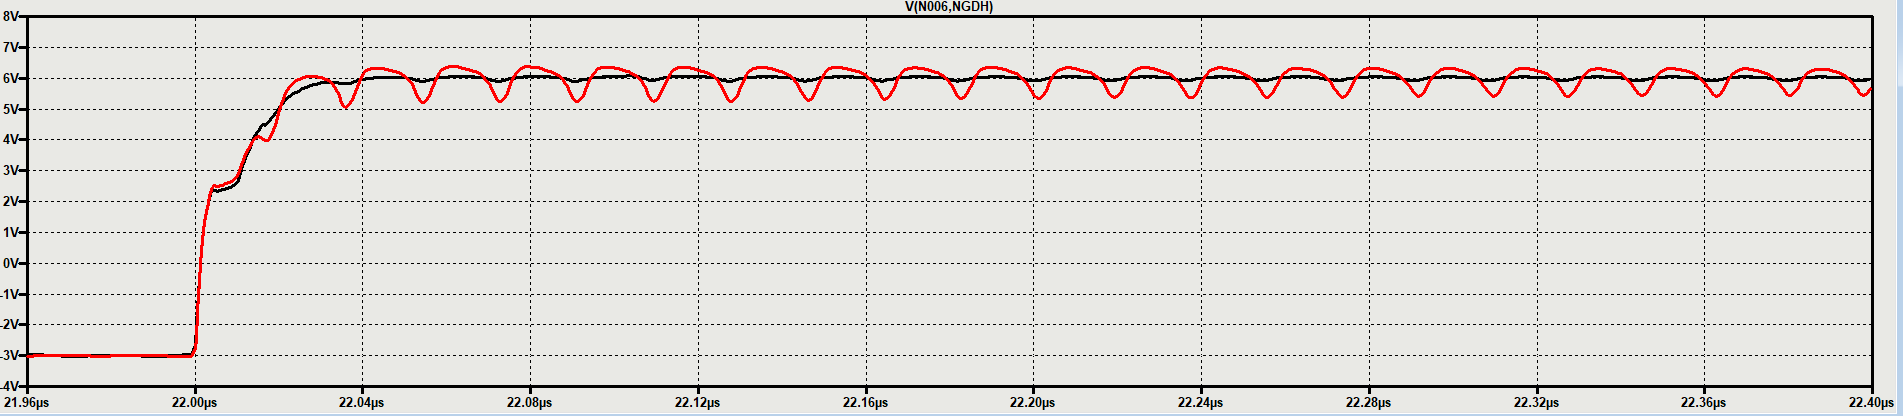
[picture p178: figure]

Figure 3: 1nH - 1nH & 1nH - 6nH Top Switch GS Waveforms when Load Conn. Ind. is 0 nH

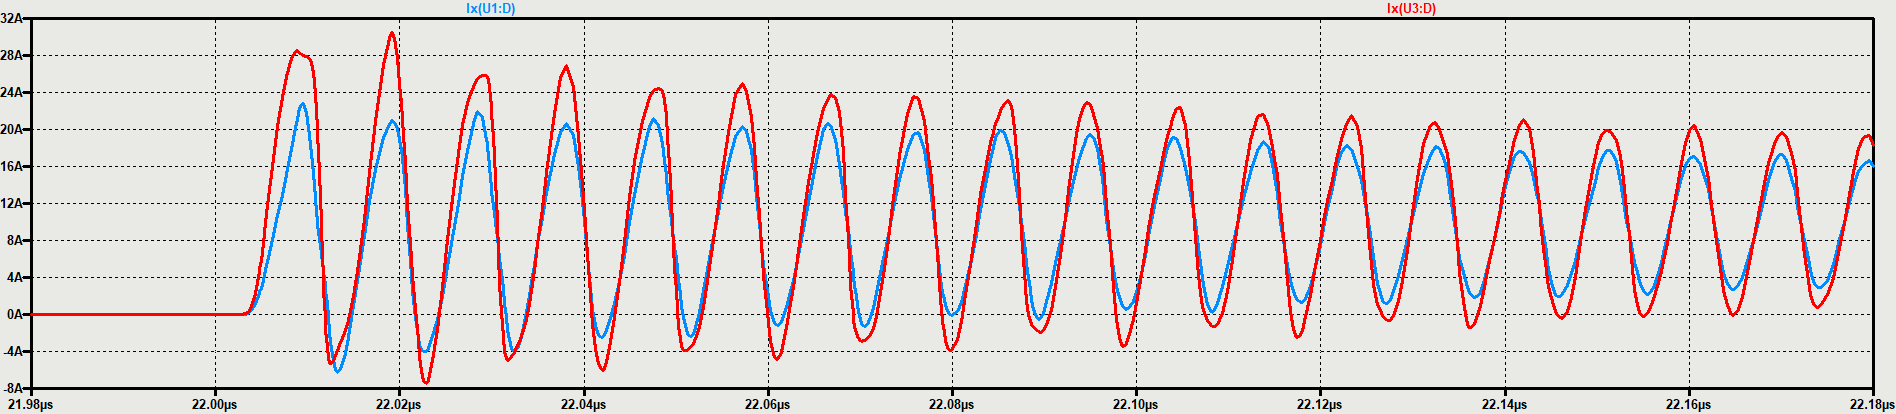
[picture p179: figure]

Figure 4: 1nH - 6nH Switching Current Waveforms when the Load Conn. Ind. is 3nH

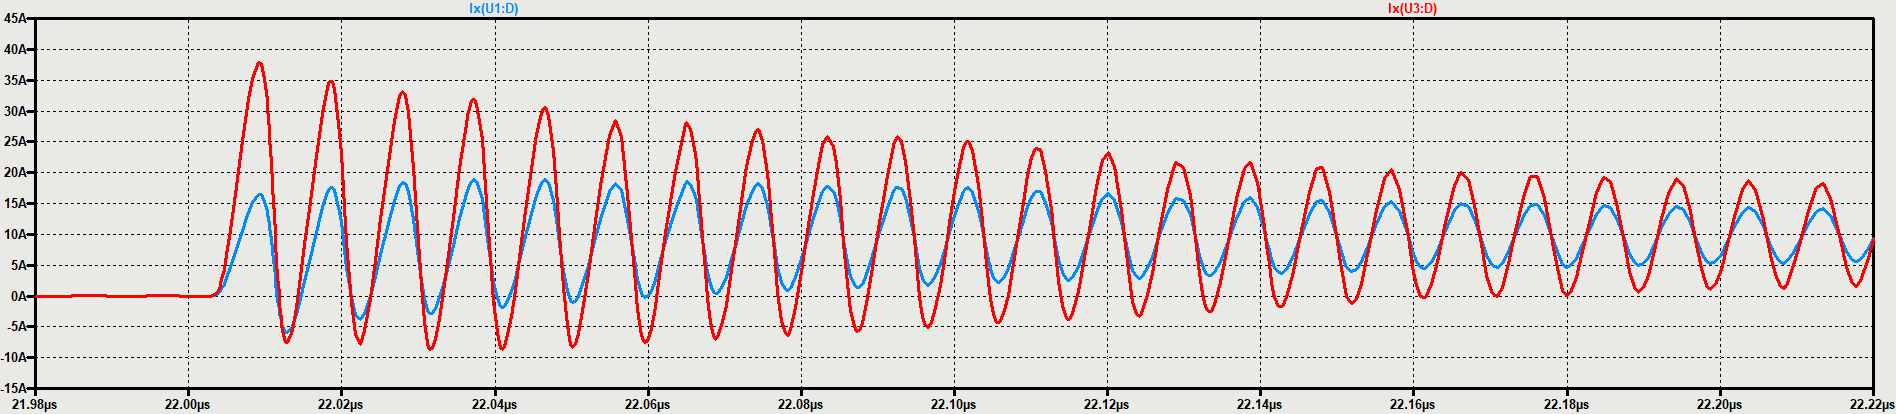
[picture p180: figure]

Figure 5: 1nH - 6nH Switching Current when the Load Conn. Ind. is 0
