furkankarakaya/GaN-Studies/Protection Circuits/TPEL Letter/PaperFigures/Fig7-FEA.pdf

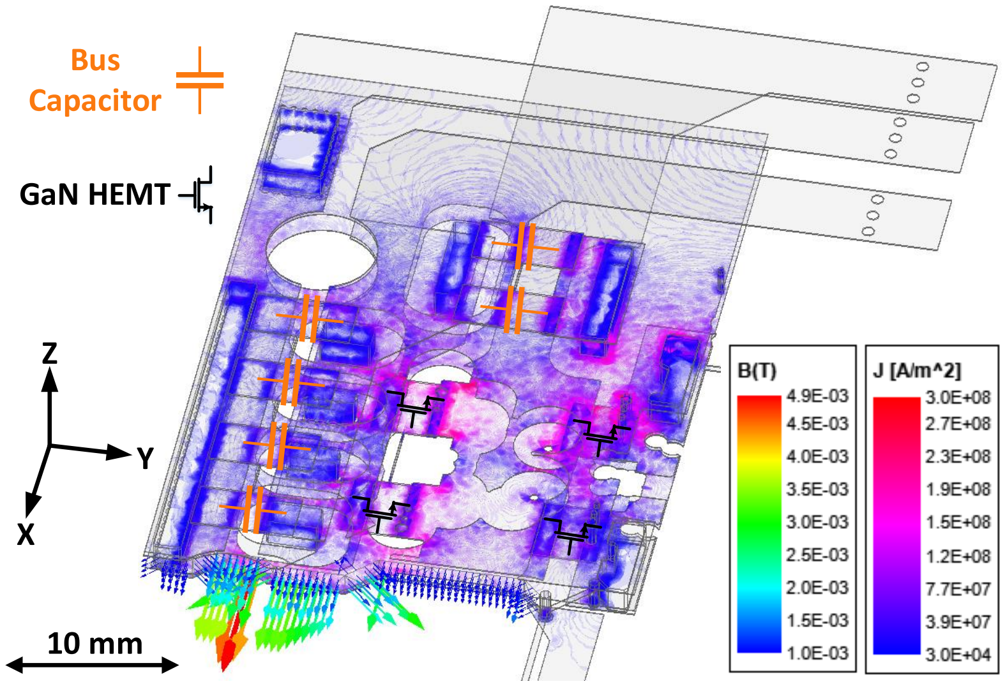
[picture p217: page 1]

Bus
Capacitor

GaN HEMT

### 10 mm

X

Y

Z
