furkankarakaya/GaN-Studies/Protection Circuits/TPEL Letter/PaperFigures/Fig1a-CircuitSchematic-v2.pdf

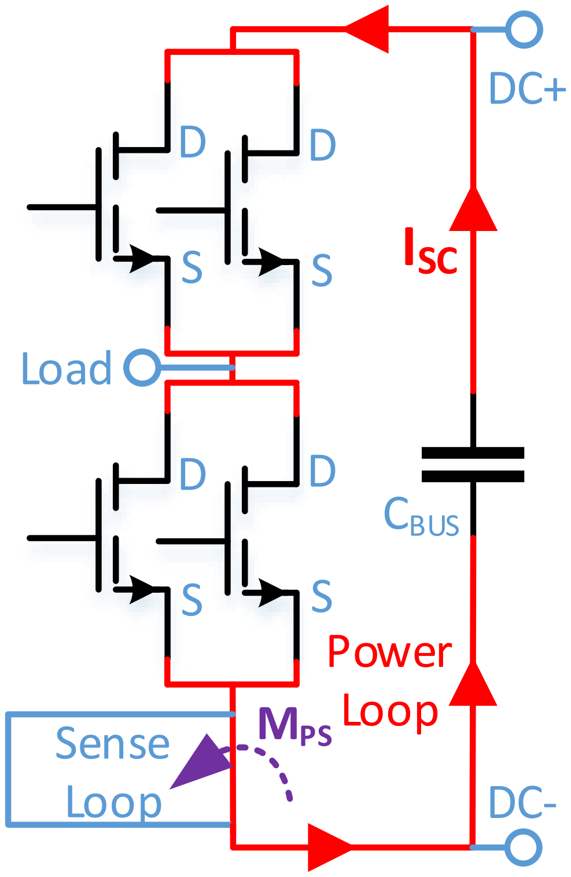
[picture p218: page 1]

D

S

DC+

CBUS

ISC

D

S

D

S

Load

D

S
Power
Loop

DC-

Sense
Loop

MPS
