furkankarakaya/GaN-Studies/Thesis/Figures/Ch5/Ch5_BuckModeEfficiency.pdf

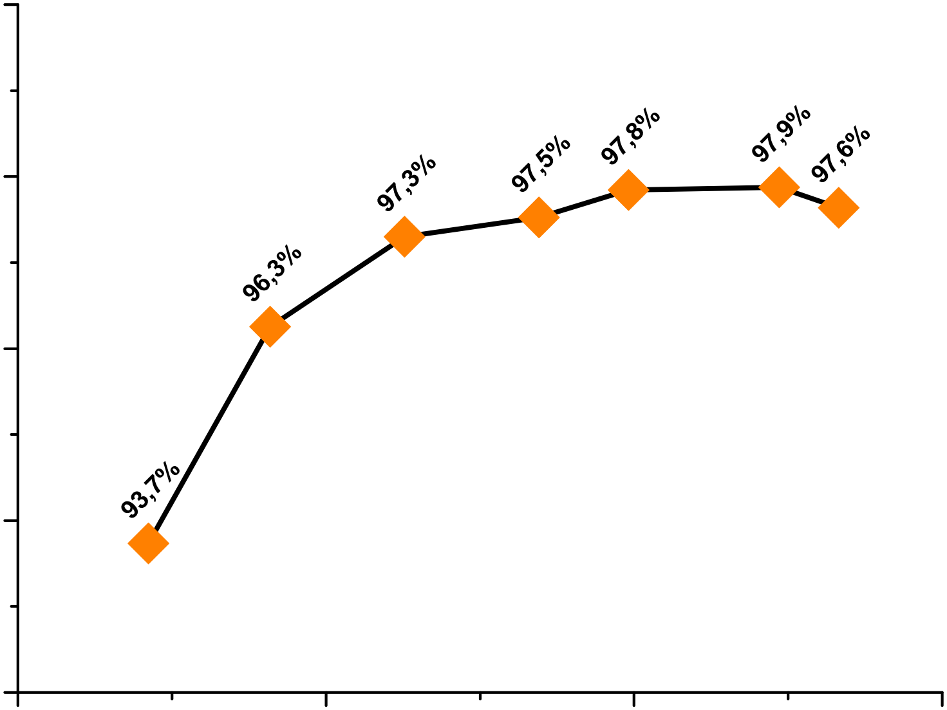
[picture p219: figure]

0 | 2 | 4 | 6

92

94

96

98

1 00

# Ou tpu t Power (kW)

E

f

fi ci e

n

c

y

(

%

)
