furkankarakaya/GaN-Studies/Thesis/Figures/Ch5/Ch5_BoostModeTemp.pdf

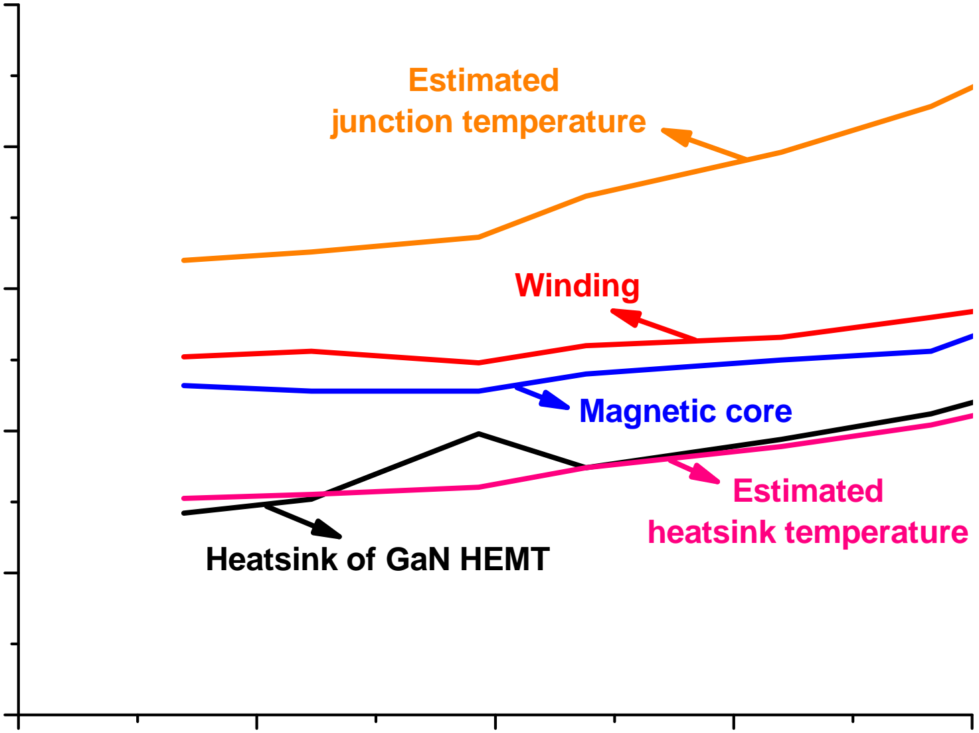
[picture p220: figure]
Estimated ju n ction temperatu re; Magneti c core; Wi ndi ng; Heatsi n k of GaN HEMT; Estimated heatsi n k temperatu re

0 | 5 | 1 0 | 1 5 | 20

25

50

75

1 00

1 25

1 50

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
### I n pu t Cu rren t (A)
