furkankarakaya/GaN-Studies/Thesis/Figures/Ch5/Ch5_ConstantAverageVaryingRipple.pdf

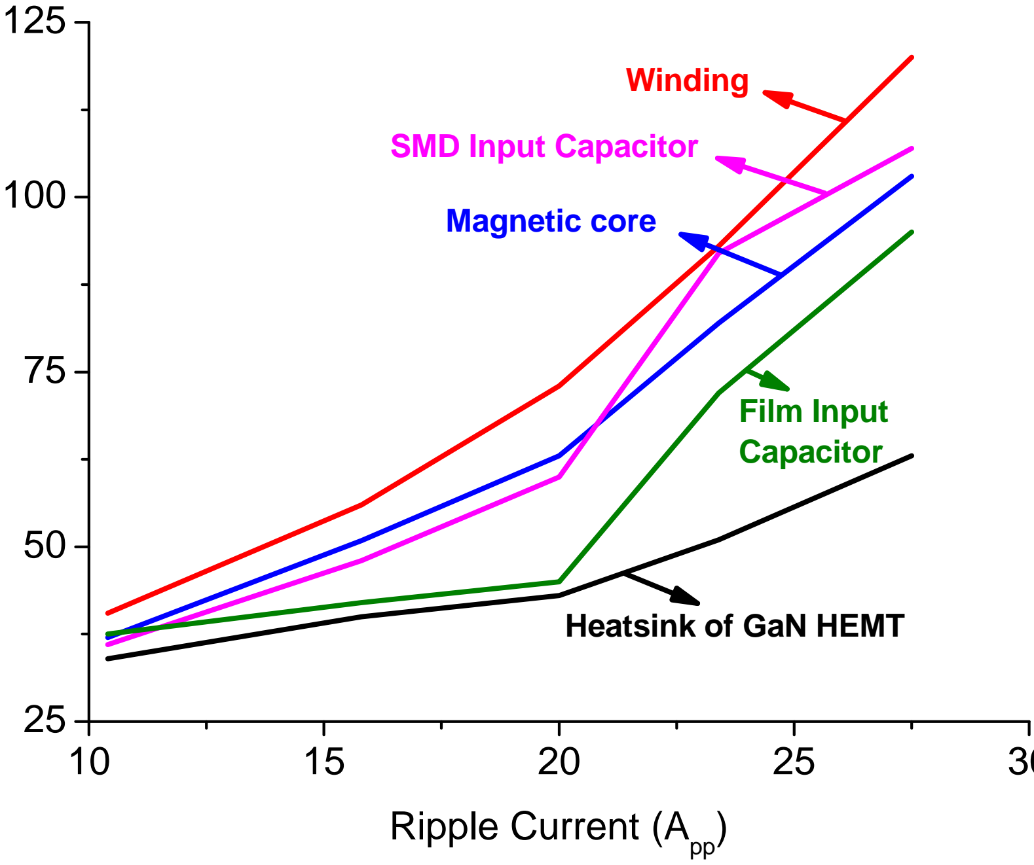
[picture p221: figure]
citor Magneti c core; u rre; p) Wi ndi n; atsi n; u t Capacitor

0

### Temperatu re ( oC)
