furkankarakaya/GaN-Studies/Thesis/Figures/Ch5/Ch5_ConstantRippleVaryingAverage.pdf

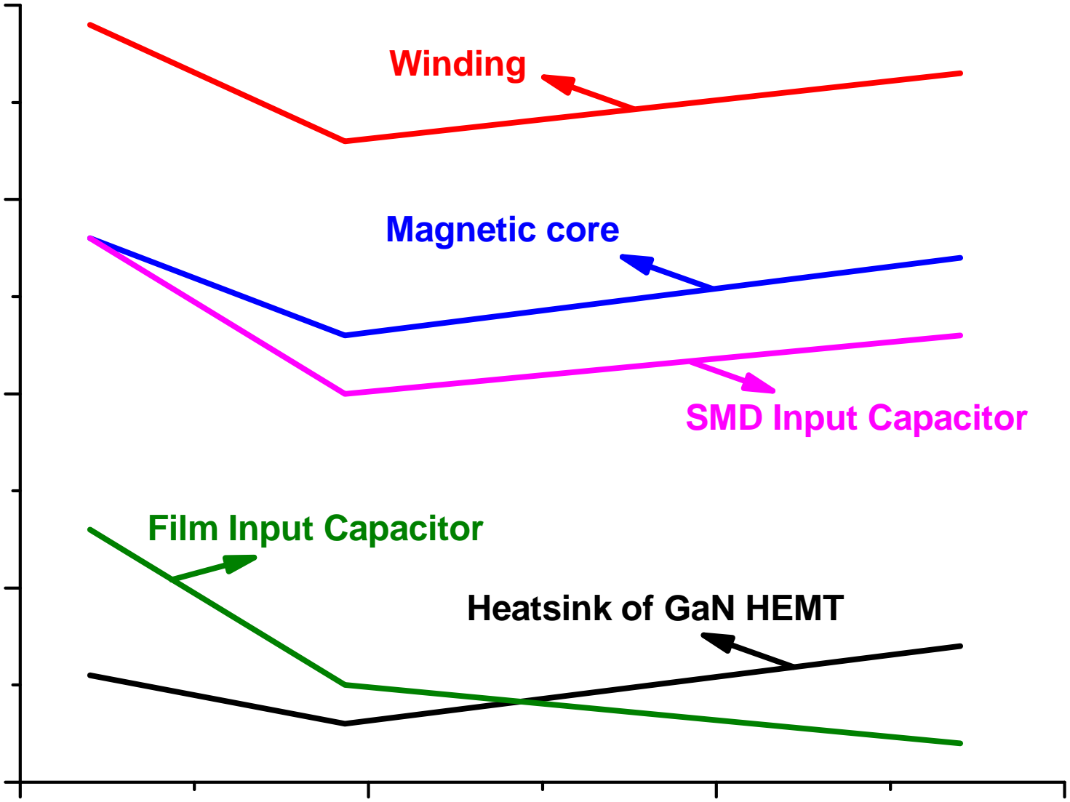
[picture p222: figure]
SMD I npu t Capacitor; Magneti c core; Wi ndi ng; Heatsi n k of GaN HEMT; Fi lm I npu t Capacitor

3 | 6 | 9 | 1 2

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
### Average Cu rren t (A)
