furkankarakaya/GaN-Studies/Thesis/Figures/Ch5/Ch5_FanPlacedView.pdf

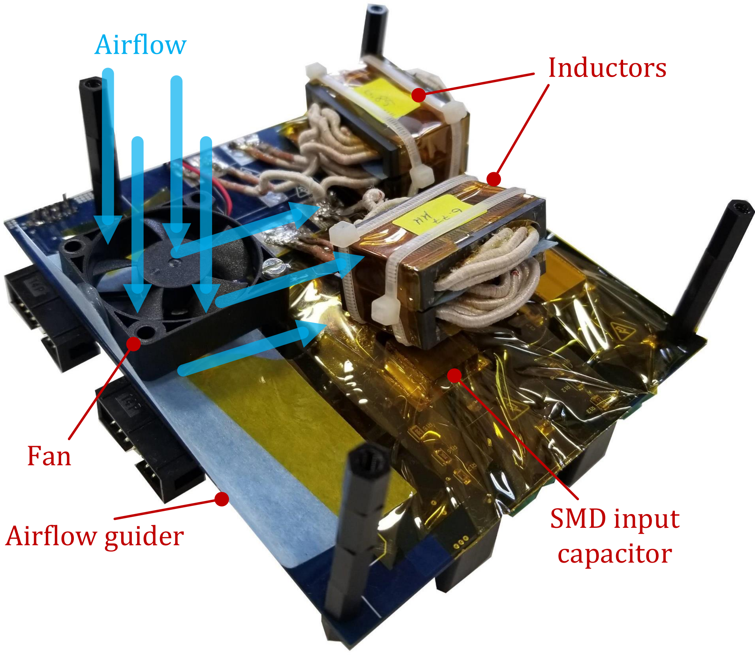
[picture p223: page 1]

Inductors

Fan

SMD input
capacitor

Airflow

Airflow guider
