furkankarakaya/GaN-Studies/Thesis/Figures/Ch5/Ch5_THCapacitorFreq.pdf

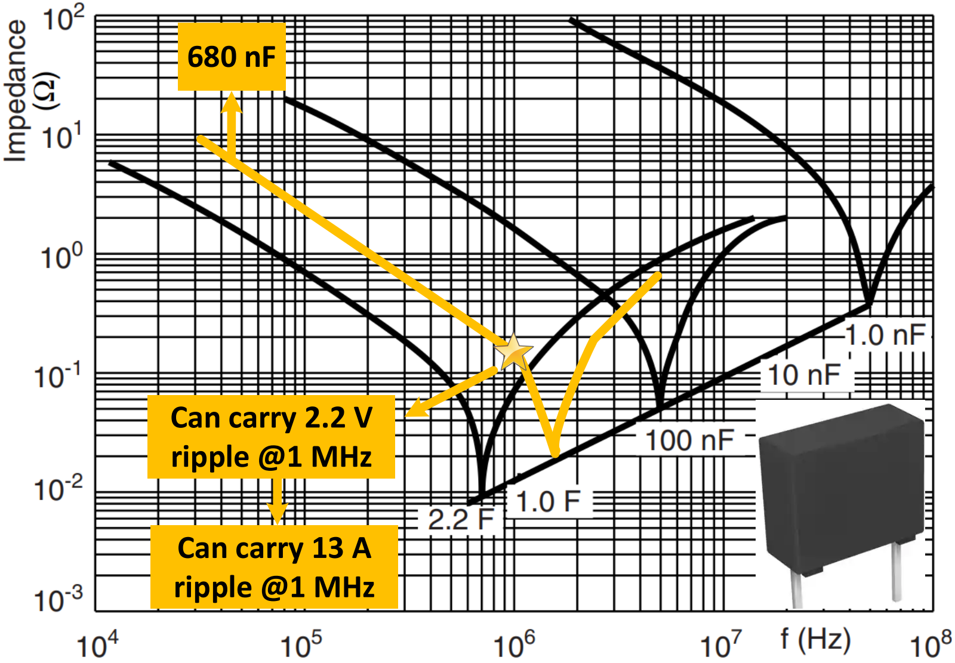
[picture p224: page 1]

680 nF

Can carry 2.2 V
ripple @1 MHz

Can carry 13 A
ripple @1 MHz
