furkankarakaya/GaN-Studies/Protection Circuits/TPEL Letter/PaperFigures/Fig9-FFT_DPTvsSC.pdf

0 | 1 00 | 200 | 300 | 400 | 500

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
0 | 25 | 50 | 75 | 1 00

1 0
0
I n terested
Range

Short Circu it Fau lt
Normal Switch i ng

M

a

g

n i t

u

d

e

(

V

)

### Frequ en cy (MH z)

Osci l l ation
Frequen cy
