furkankarakaya/GaN-Studies/Thesis/Presentation/Excel Plots.xlsx

Sheet: Sheet1
Method | Gate Charge (Qg)
Datasheet | 6.10
Thermal Calibration | 4.90
Impedance Analyzer | 4.70

Sheet: Sheet2
 | Left switch | Right switch
Power Loop | 0.87 | 0.87
P. Gate Loop | 4.14 | 4.23
N. Gate Loop | 3.88 | 4.04
Mutual | 0.114 | 0.117

Sheet: Sheet3
Boost |  | Buck
0.8804 | 94.0500 | 0.8479 | 93.7354
1.5948 | 96.5830 | 1.6362 | 96.2520
2.5382 | 97.5990 | 2.5087 | 97.3005
3.1447 | 98.0320 | 3.3829 | 97.5270
4.2739 | 98.9450 | 3.9636 | 97.8457
5.1128 | 98.6380 | 4.9413 | 97.8759
5.3785 | 98.7210 | 5.3280 | 97.6380
