furkankarakaya/GaN-Studies/Thesis/chapters/chapter_1intro.tex

\chapter{introduction}
\label{chp:intro}

\section{Motivation and Problem Definition}  %subject to change
\label{sec:intro_motivation}

%\begin{figure}[ht]
%   \centering
%    \includegraphics[width=0.6\textwidth]{figures/crazyflie.jpg}
%    \caption{A crazyflie 2.0 quad-rotor UAV \cite{bitcraze2016crazyflie}}
%    \label{fig:quad_sample_image}
%\end{figure}

\section{Contributions} %subject to change

\section{The Outline of the Thesis} %subject to change
