furkankarakaya/GaN-Studies/MDPI_template/MDPI_template/template.tex

%  LaTeX support: latex@mdpi.com 
%  For support, please attach all files needed for compiling as well as the log file, and specify your operating system, LaTeX version, and LaTeX editor.

%=================================================================
\documentclass[journal,article,submit,moreauthors,pdftex]{Definitions/mdpi} 

% For posting an early version of this manuscript as a preprint, you may use "preprints" as the journal and change "submit" to "accept". The document class line would be, e.g., \documentclass[preprints,article,accept,moreauthors,pdftex]{mdpi}. This is especially recommended for submission to arXiv, where line numbers should be removed before posting. For preprints.org, the editorial staff will make this change immediately prior to posting.
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
\TitleCitation{Title}

% Author Orchid ID: enter ID or remove command
\newcommand{\orcidauthorA}{0000-0000-0000-000X} % Add \orcidA{} behind the author's name
%\newcommand{\orcidauthorB}{0000-0000-0000-000X} % Add \orcidB{} behind the author's name

% Authors, for the paper (add full first names)
\Author{Firstname Lastname $^{1,\dagger,\ddagger}$\orcidA{}, Firstname Lastname $^{1,\ddagger}$ and Firstname Lastname $^{2,}$*}

% MDPI internal command: Authors, for metadata in PDF
\AuthorNames{Firstname Lastname, Firstname Lastname and Firstname Lastname}

% MDPI internal command: Authors, for citation in the left column
\AuthorCitation{Lastname, F.; Lastname, F.; Lastname, F.}

% Affiliations / Addresses (Add [1] after \address if there is only one affiliation.)
\address{%
$^{1}$ \quad Affiliation 1; e-mail@e-mail.com\\
$^{2}$ \quad Affiliation 2; e-mail@e-mail.com}

% Contact information of the corresponding author
\corres{Correspondence: e-mail@e-mail.com; Tel.: (optional; include country code; if there are multiple corresponding authors, add author initials) +xx-xxxx-xxx-xxxx (F.L.)}

% Current address and/or shared authorship
\firstnote{Current address: Affiliation 3} 
\secondnote{These authors contributed equally to this work.}
% The commands \thirdnote{} till \eighthnote{} are available for further notes

%\simplesumm{} % Simple summary

%\conference{} % An extended version of a conference paper

% Abstract (Do not insert blank lines, i.e. \\) 
\abstract{A single paragraph of about 200 words maximum. For research articles, abstracts should give a pertinent overview of the work. We strongly encourage authors to use the following style of structured abstracts, but without headings: (1) Background: place the question addressed in a broad context and highlight the purpose of the study; (2) Methods: describe briefly the main methods or treatments applied; (3) Results: summarize the article's main findings; (4) Conclusion: indicate the main conclusions or interpretations. The abstract should be an objective representation of the article, it must not contain results which are not presented and substantiated in the main text and should not exaggerate the main conclusions.}

% Keywords
\keyword{keyword 1; keyword 2; keyword 3 (List three to ten pertinent keywords specific to the article; yet reasonably common within the subject discipline.)} 

% The fields PACS, MSC, and JEL may be left empty or commented out if not applicable
%\PACS{J0101}
%\MSC{}
%\JEL{}

%%%%%%%%%%%%%%%%%%%%%%%%%%%%%%%%%%%%%%%%%%
% Only for the journal Diversity
%\LSID{\url{http://}}

%%%%%%%%%%%%%%%%%%%%%%%%%%%%%%%%%%%%%%%%%%
% Only for the journal Applied Sciences:
%\featuredapplication{Authors are encouraged to provide a concise description of the specific application or a potential application of the work. This section is not mandatory.}
%%%%%%%%%%%%%%%%%%%%%%%%%%%%%%%%%%%%%%%%%%

%%%%%%%%%%%%%%%%%%%%%%%%%%%%%%%%%%%%%%%%%%
% Only for the journal Data:
%\dataset{DOI number or link to the deposited data set in cases where the data set is published or set to be published separately. If the data set is submitted and will be published as a supplement to this paper in the journal Data, this field will be filled by the editors of the journal. In this case, please make sure to submit the data set as a supplement when entering your manuscript into our manuscript editorial system.}

%\datasetlicense{license under which the data set is made available (CC0, CC-BY, CC-BY-SA, CC-BY-NC, etc.)}

%%%%%%%%%%%%%%%%%%%%%%%%%%%%%%%%%%%%%%%%%%
% Only for the journal Toxins
%\keycontribution{The breakthroughs or highlights of the manuscript. Authors can write one or two sentences to describe the most important part of the paper.}

%%%%%%%%%%%%%%%%%%%%%%%%%%%%%%%%%%%%%%%%%%
% Only for the journal Encyclopedia
%\encyclopediadef{Instead of the abstract}
%\entrylink{The Link to this entry published on the encyclopedia platform.}
%%%%%%%%%%%%%%%%%%%%%%%%%%%%%%%%%%%%%%%%%%

\begin{document}
%%%%%%%%%%%%%%%%%%%%%%%%%%%%%%%%%%%%%%%%%%

\section{How to Use this Template}

The template details the sections that can be used in a manuscript. Note that the order and names of article sections may differ from the requirements of the journal (e.g., the positioning of the Materials and Methods section). Please check the instructions on the authors' page of the journal to verify the correct order and names. For any questions, please contact the editorial office of the journal or support@mdpi.com. For LaTeX-related questions please contact latex@mdpi.com.
%The order of the section titles is: Introduction, Materials and Methods, Results, Discussion, Conclusions for these journals: aerospace,algorithms,antibodies,antioxidants,atmosphere,axioms,biomedicines,carbon,crystals,designs,diagnostics,environments,fermentation,fluids,forests,fractalfract,informatics,information,inventions,jfmk,jrfm,lubricants,neonatalscreening,neuroglia,particles,pharmaceutics,polymers,processes,technologies,viruses,vision

\section{Introduction}

The introduction should briefly place the study in a broad context and highlight why it is important. It should define the purpose of the work and its significance. The current state of the research field should be reviewed carefully and key publications cited. Please highlight controversial and diverging hypotheses when necessary. Finally, briefly mention the main aim of the work and highlight the principal conclusions. As far as possible, please keep the introduction comprehensible to scientists outside your particular field of research. Citing a journal paper \cite{ref-journal}. Now citing a book reference \cite{ref-book1,ref-book2} or other reference types \cite{ref-unpublish,ref-communication,ref-proceeding}. Please use the command \citep{ref-thesis,ref-url} for the following MDPI journals, which use author--date citation: Administrative Sciences, Arts, Econometrics, Economies, Genealogy, Histories, Humanities, IJFS, Journal of Intelligence, Journalism and Media, JRFM, Languages, Laws, Religions, Risks, Social Sciences.
 
%%%%%%%%%%%%%%%%%%%%%%%%%%%%%%%%%%%%%%%%%%
\section{Materials and Methods}

Materials and Methods should be described with sufficient details to allow others to replicate and build on published results. Please note that publication of your manuscript implicates that you must make all materials, data, computer code, and protocols associated with the publication available to readers. Please disclose at the submission stage any restrictions on the availability of materials or information. New methods and protocols should be described in detail while well-established methods can be briefly described and appropriately cited.

Research manuscripts reporting large datasets that are deposited in a publicly avail-able database should specify where the data have been deposited and provide the relevant accession numbers. If the accession numbers have not yet been obtained at the time of submission, please state that they will be provided during review. They must be provided prior to publication.

Interventionary studies involving animals or humans, and other studies require ethical approval must list the authority that provided approval and the corresponding ethical approval code.
\begin{quote}
This is an example of a quote.
\end{quote}

%%%%%%%%%%%%%%%%%%%%%%%%%%%%%%%%%%%%%%%%%%
\section{Results}

This section may be divided by subheadings. It should provide a concise and precise description of the experimental results, their interpretation as well as the experimental conclusions that can be drawn.
\subsection{Subsection}
\subsubsection{Subsubsection}

Bulleted lists look like this:
\begin{itemize}
\item	First bullet;
\item	Second bullet;
\item	Third bullet.
\end{itemize}

Numbered lists can be added as follows:
\begin{enumerate}
\item	First item; 
\item	Second item;
\item	Third item.
\end{enumerate}

The text continues here. 

\subsection{Figures, Tables and Schemes}

All figures and tables should be cited in the main text as Figure~\ref{fig1}, Table~\ref{tab1}, etc.

\begin{figure}[H]

\caption{This is a figure. Schemes follow the same formatting. If there are multiple panels, they should be listed as: (\textbf{a}) Description of what is contained in the first panel. (\textbf{b}) Description of what is contained in the second panel. Figures should be placed in the main text near to the first time they are cited. A caption on a single line should be centered.\label{fig1}}
\end{figure}   

% The MDPI table float is called specialtable
\begin{specialtable}[H] 
\caption{This is a table caption. Tables should be placed in the main text near to the first time they are~cited.\label{tab1}}
%%% \tablesize{} %% You can specify the fontsize here, e.g., \tablesize{\footnotesize}. If commented out \small will be used.
\begin{tabular}{ccc}
\toprule
\textbf{Title 1}	& \textbf{Title 2}	& \textbf{Title 3}\\
\midrule
Entry 1		& Data			& Data\\
Entry 2		& Data			& Data\\
\bottomrule
\end{tabular}
\end{specialtable}

%\begin{listing}[H]
%\caption{Title of the listing}
%\rule{\columnwidth}{1pt}
%\raggedright Text of the listing. In font size footnotesize, small, or normalsize. Preferred format: left aligned and single spaced. Preferred border format: top border line and bottom border line.
%\rule{\columnwidth}{1pt}
%\end{listing}

Text.

Text.

\subsection{Formatting of Mathematical Components}

This is the example 1 of equation:
\begin{equation}
a = 1,
\end{equation}
the text following an equation need not be a new paragraph. Please punctuate equations as regular text.
%% If the documentclass option "submit" is chosen, please insert a blank line before and after any math environment (equation and eqnarray environments). This ensures correct linenumbering. The blank line should be removed when the documentclass option is changed to "accept" because the text following an equation should not be a new paragraph.

This is the example 2 of equation:
\end{paracol}
\nointerlineskip
\begin{equation}
a = b + c + d + e + f + g + h + i + j + k + l + m + n + o + p + q + r + s + t + u + v + w + x + y + z
\end{equation}

% Example of a figure that spans the whole page width (the commands \widefigure and \begin{paracol}{2}, \linenumbers, and\switchcolumn need to be present). The same concept works for tables, too.
\begin{figure}[H]	
\widefigure

\caption{This is a wide figure.\label{fig2}}
\end{figure}  
\begin{paracol}{2}
\linenumbers
\switchcolumn

Please punctuate equations as regular text. Theorem-type environments (including propositions, lemmas, corollaries etc.) can be formatted as follows:
%% Example of a theorem:
\begin{Theorem}
Example text of a theorem.
\end{Theorem}

The text continues here. Proofs must be formatted as follows:

%% Example of a proof:
\begin{proof}[Proof of Theorem 1]
Text of the proof. Note that the phrase ``of Theorem 1'' is optional if it is clear which theorem is being referred to.
\end{proof}
The text continues here.

%%%%%%%%%%%%%%%%%%%%%%%%%%%%%%%%%%%%%%%%%%
\section{Discussion}

Authors should discuss the results and how they can be interpreted from the perspective of previous studies and of the working hypotheses. The findings and their implications should be discussed in the broadest context possible. Future research directions may also be highlighted.

%%%%%%%%%%%%%%%%%%%%%%%%%%%%%%%%%%%%%%%%%%
\section{Conclusions}

This section is not mandatory, but can be added to the manuscript if the discussion is unusually long or complex.

%%%%%%%%%%%%%%%%%%%%%%%%%%%%%%%%%%%%%%%%%%
\section{Patents}

This section is not mandatory, but may be added if there are patents resulting from the work reported in this manuscript.

%%%%%%%%%%%%%%%%%%%%%%%%%%%%%%%%%%%%%%%%%%
\vspace{6pt} 

%%%%%%%%%%%%%%%%%%%%%%%%%%%%%%%%%%%%%%%%%%
%% optional
%\supplementary{The following are available online at \linksupplementary{s1}, Figure S1: title, Table S1: title, Video S1: title.}

% Only for the journal Methods and Protocols:
% If you wish to submit a video article, please do so with any other supplementary material.
% \supplementary{The following are available at \linksupplementary{s1}, Figure S1: title, Table S1: title, Video S1: title. A supporting video article is available at doi: link.} 

%%%%%%%%%%%%%%%%%%%%%%%%%%%%%%%%%%%%%%%%%%
\authorcontributions{For research articles with several authors, a short paragraph specifying their individual contributions must be provided. The following statements should be used ``Conceptualization, X.X. and Y.Y.; methodology, X.X.; software, X.X.; validation, X.X., Y.Y. and Z.Z.; formal analysis, X.X.; investigation, X.X.; resources, X.X.; data curation, X.X.; writing---original draft preparation, X.X.; writing---review and editing, X.X.; visualization, X.X.; supervision, X.X.; project administration, X.X.; funding acquisition, Y.Y. All authors have read and agreed to the published version of the manuscript.'', please turn to the  \href{http://img.mdpi.org/data/contributor-role-instruction.pdf}{CRediT taxonomy} for the term explanation. Authorship must be limited to those who have contributed substantially to the work~reported.}

\funding{Please add: ``This research received no external funding'' or ``This research was funded by NAME OF FUNDER grant number XXX.'' and  and ``The APC was funded by XXX''. Check carefully that the details given are accurate and use the standard spelling of funding agency names at \url{https://search.crossref.org/funding}, any errors may affect your future funding.}

\institutionalreview{In this section, you should add the Institutional Review Board Statement and approval number, if relevant to your study. You might choose to exclude this statement if the study did not require ethical approval. Please note that the Editorial Office might ask you for further information. Please add ``The study was conducted according to the guidelines of the Declaration of Helsinki, and approved by the Institutional Review Board (or Ethics Committee) of NAME OF INSTITUTE (protocol code XXX and date of approval).'' OR ``Ethical review and approval were waived for this study, due to REASON (please provide a detailed justification).'' OR ``Not applicable'' for studies not involving humans or animals.}

\informedconsent{Please add ``Informed consent was obtained from all subjects involved in the study.'' OR ``Patient consent was waived due to REASON (please provide a detailed justification).'' OR ``Not applicable'' for studies not involving humans.}

\dataavailability{Please refer to suggested Data Availability Statements in section “MDPI Research Data Policies” at \href{https://www.mdpi.com/ethics}{https://www.mdpi.com/ethics}.} 

\acknowledgments{In this section you can acknowledge any support given which is not covered by the author contribution or funding sections. This may include administrative and technical support, or donations in kind (e.g., materials used for experiments).}

\conflictsofinterest{Declare conflicts of interest or state ``The authors declare no conflict of interest.'' Authors must identify and declare any personal circumstances or interest that may be perceived as inappropriately influencing the representation or interpretation of reported research results. Any role of the funders in the design of the study; in the collection, analyses or interpretation of data; in the writing of the manuscript, or in the decision to publish the results must be declared in this section. If there is no role, please state ``The funders had no role in the design of the study; in the collection, analyses, or interpretation of data; in the writing of the manuscript, or in the decision to publish the~results''.} 

%% Optional
\sampleavailability{Samples of the compounds ... are available from the authors.}

%%%%%%%%%%%%%%%%%%%%%%%%%%%%%%%%%%%%%%%%%%
%% Only for journal Encyclopedia
%\entrylink{The Link to this entry published on the encyclopedia platform.}

%%%%%%%%%%%%%%%%%%%%%%%%%%%%%%%%%%%%%%%%%%
%% Optional
\abbreviations{The following abbreviations are used in this manuscript:\\

\noindent 
\begin{tabular}{@{}ll}
MDPI & Multidisciplinary Digital Publishing Institute\\
DOAJ & Directory of open access journals\\
TLA & Three letter acronym\\
LD & Linear dichroism
\end{tabular}}

%%%%%%%%%%%%%%%%%%%%%%%%%%%%%%%%%%%%%%%%%%
%% Optional
\appendixtitles{no} % Leave argument "no" if all appendix headings stay EMPTY (then no dot is printed after "Appendix A"). If the appendix sections contain a heading then change the argument to "yes".
\appendix
\section{}
\subsection{}
The appendix is an optional section that can contain details and data supplemental to the main text---for example, explanations of experimental details that would disrupt the flow of the main text but nonetheless remain crucial to understanding and reproducing the research shown; figures of replicates for experiments of which representative data are shown in the main text can be added here if brief, or as Supplementary Data. Mathematical proofs of results not central to the paper can be added as an appendix.

\section{}
All appendix sections must be cited in the main text. In the appendices, Figures, Tables, etc. should be labeled, starting with ``A''---e.g., Figure A1, Figure A2, etc. 

%%%%%%%%%%%%%%%%%%%%%%%%%%%%%%%%%%%%%%%%%%
\end{paracol}
\reftitle{References}

% Please provide either the correct journal abbreviation (e.g. according to the “List of Title Word Abbreviations” http://www.issn.org/services/online-services/access-to-the-ltwa/) or the full name of the journal.
% Citations and References in Supplementary files are permitted provided that they also appear in the reference list here. 

%=====================================
% References, variant A: external bibliography
%=====================================
%\externalbibliography{yes}
%\bibliography{your_external_BibTeX_file}

%=====================================
% References, variant B: internal bibliography
%=====================================
\begin{thebibliography}{999}
% Reference 1
\bibitem[Author1(year)]{ref-journal}
Author~1, T. The title of the cited article. {\em Journal Abbreviation} {\bf 2008}, {\em 10}, 142--149.
% Reference 2
\bibitem[Author2(year)]{ref-book1}
Author~2, L. The title of the cited contribution. In {\em The Book Title}; Editor1, F., Editor2, A., Eds.; Publishing House: City, Country, 2007; pp. 32--58.
% Reference 3
\bibitem[Author3(year)]{ref-book2}
Author 1, A.; Author 2, B. \textit{Book Title}, 3rd ed.; Publisher: Publisher Location, Country, 2008; pp. 154--196.
% Reference 4
\bibitem[Author4(year)]{ref-unpublish}
Author 1, A.B.; Author 2, C. Title of Unpublished Work. \textit{Abbreviated Journal Name} stage of publication (under review; accepted; in~press).
% Reference 5
\bibitem[Author5(year)]{ref-communication}
Author 1, A.B. (University, City, State, Country); Author 2, C. (Institute, City, State, Country). Personal communication, 2012.
% Reference 6
\bibitem[Author6(year)]{ref-proceeding}
Author 1, A.B.; Author 2, C.D.; Author 3, E.F. Title of Presentation. In Title of the Collected Work (if available), Proceedings of the Name of the Conference, Location of Conference, Country, Date of Conference; Editor 1, Editor 2, Eds. (if available); Publisher: City, Country, Year (if available); Abstract Number (optional), Pagination (optional).
% Reference 7
\bibitem[Author7(year)]{ref-thesis}
Author 1, A.B. Title of Thesis. Level of Thesis, Degree-Granting University, Location of University, Date of Completion.
% Reference 8
\bibitem[Author8(year)]{ref-url}
Title of Site. Available online: URL (accessed on Day Month Year).
\end{thebibliography}

% The following MDPI journals use author-date citation: Arts, Econometrics, Economies, Genealogy, Humanities, IJFS, JRFM, Laws, Religions, Risks, Social Sciences. For those journals, please follow the formatting guidelines on http://www.mdpi.com/authors/references
% To cite two works by the same author: \citeauthor{ref-journal-1a} (\citeyear{ref-journal-1a}, \citeyear{ref-journal-1b}). This produces: Whittaker (1967, 1975)
% To cite two works by the same author with specific pages: \citeauthor{ref-journal-3a} (\citeyear{ref-journal-3a}, p. 328; \citeyear{ref-journal-3b}, p.475). This produces: Wong (1999, p. 328; 2000, p. 475)

%%%%%%%%%%%%%%%%%%%%%%%%%%%%%%%%%%%%%%%%%%
%% for journal Sci
%\reviewreports{\\
%Reviewer 1 comments and authors’ response\\
%Reviewer 2 comments and authors’ response\\
%Reviewer 3 comments and authors’ response
%}
%%%%%%%%%%%%%%%%%%%%%%%%%%%%%%%%%%%%%%%%%%
\end{document}
