furkankarakaya/GaN-Studies/Weekly Reports/2020.05.11 - 2020.05.18.pptx

Soft Starting

Constant Inductor Ripple (30App)

Max 5% Ripple

Capacitor Stress

## Slide 2

Soft Starting @150 kHz

Soft start of duty cycle from 0.2 to 0.788

## Slide 3

Soft Starting @200 kHz

Soft start of duty cycle from 0.18 to 0.717

## Slide 4

Soft Starting @250 kHz

Soft start of duty cycle from 0.162 to 0.646

## Slide 5

Soft Starting @300 kHz

Soft start of duty cycle from 0.144 to 0.575

## Slide 6

Soft Starting @350 kHz

Soft start of duty cycle from 0.126 to 0.504

## Slide 7

Soft Starting @400 kHz

Soft start of duty cycle from 0.108 to 0.433

## Slide 8

Soft Starting @450 kHz

Soft start of duty cycle from 0.091 to 0.363

## Slide 9

Soft Starting @500 kHz

Soft start of duty cycle from 0.073 to 0.292
