furkankarakaya/GaN-Studies/Protection Circuits/TPEL Letter/PaperFigures/Fig10-RC_FilterBode.pdf

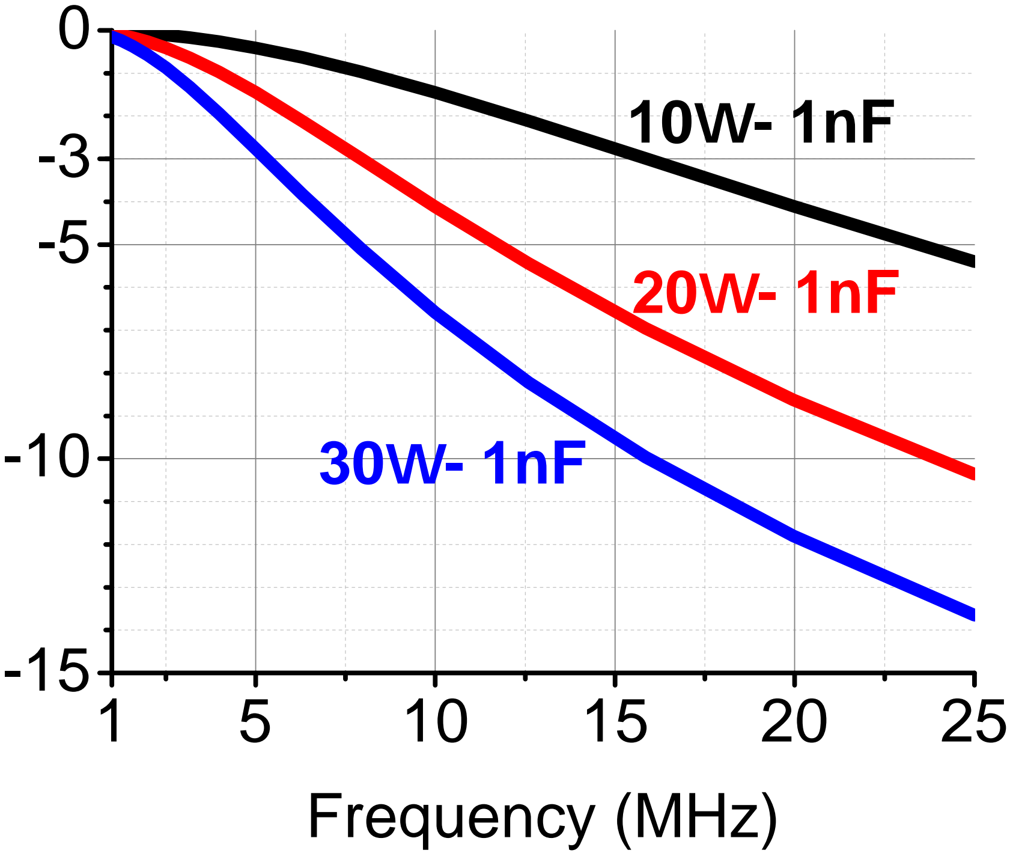
[picture p225: figure]
Fre

Magn i tu de (dB)
