furkankarakaya/GaN-Studies/Thesis/Figures/Ch5/Ch5_BoostModeEfficiency.pdf

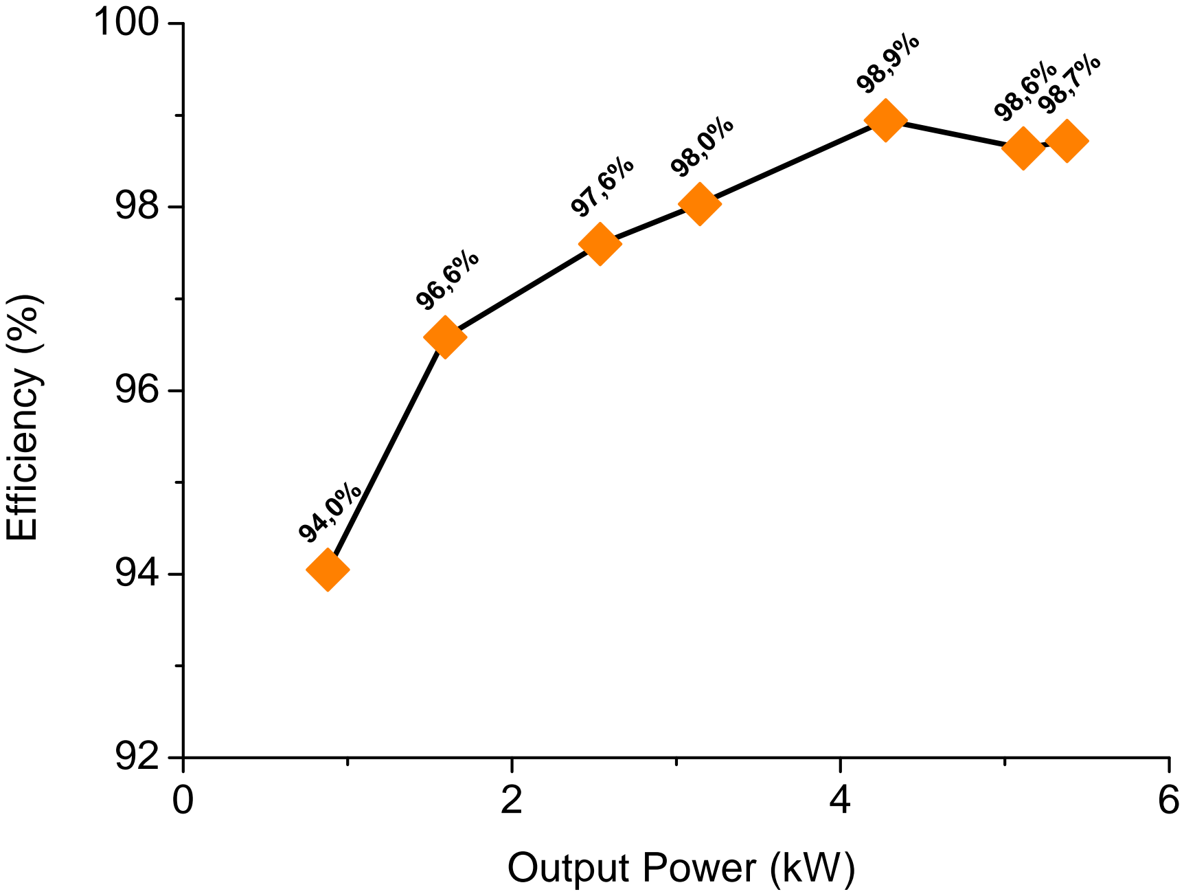
[picture p226: figure]
W) E ffi ci en cy ⁽%⁾
