furkankarakaya/GaN-Studies/Thesis/Figures/Ch5/Ch5_BoostThermalCamera.pdf

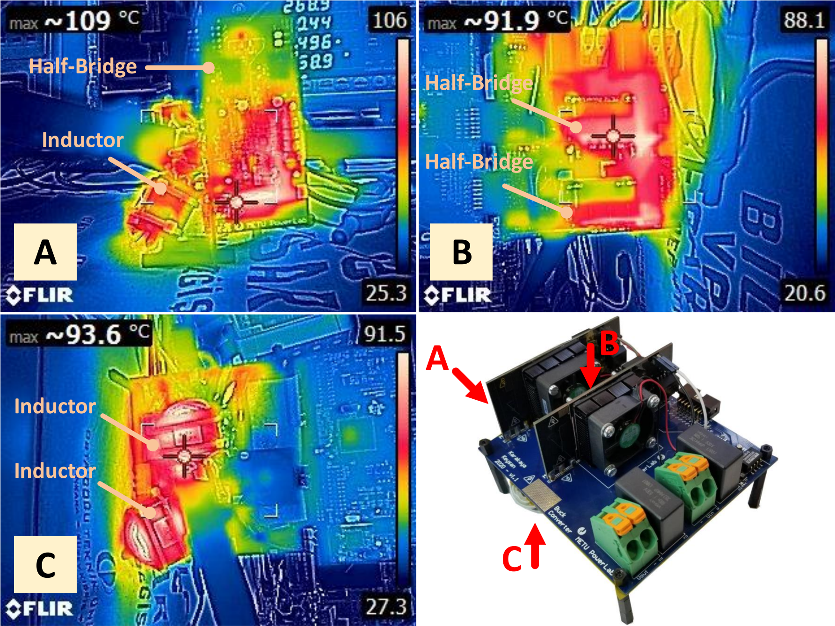
[picture p227: page 1]

A B

C

A

B

C

Half-Bridge

Inductor

Inductor

Inductor

Half-Bridge

Half-Bridge
