furkankarakaya/GaN-Studies/Thesis/Figures/Ch5/Ch5_ECore.pdf

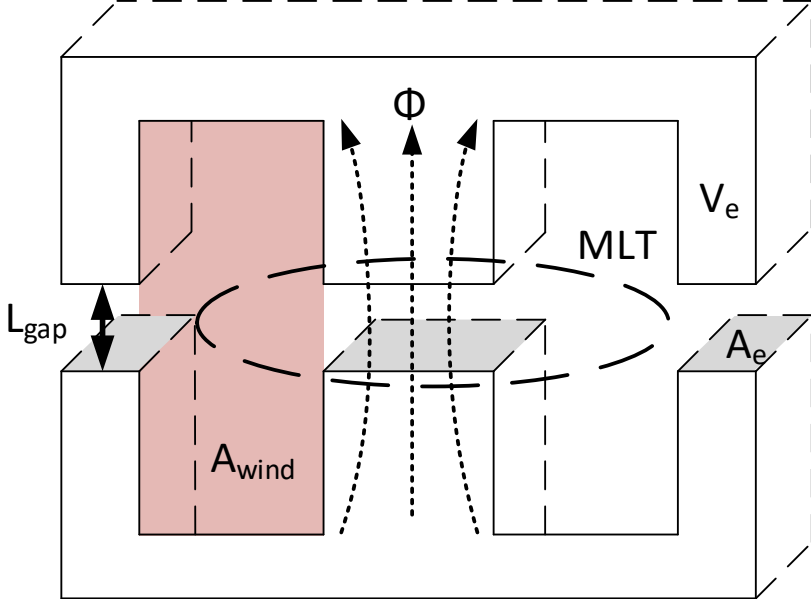
[picture p228: figure]
Lgap; Awind; MLT
