furkankarakaya/GaN-Studies/Thesis/Figures/Ch5/Ch5_InductorClosedView.pdf

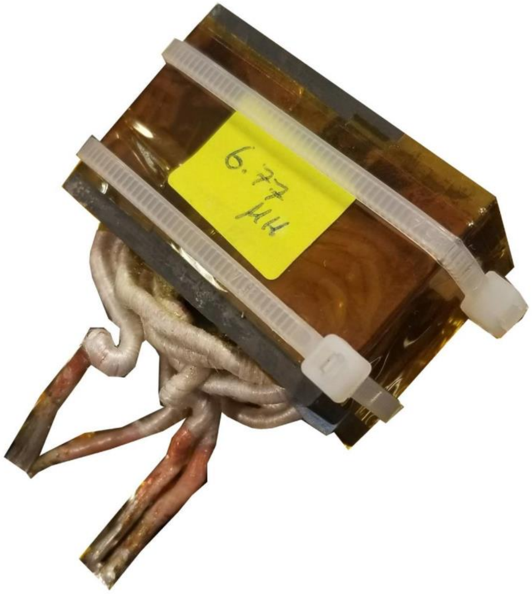
[picture p229: page 1]
