furkankarakaya/GaN-Studies/Thesis/Figures/Ch5/Ch5_InductorHeating.pdf

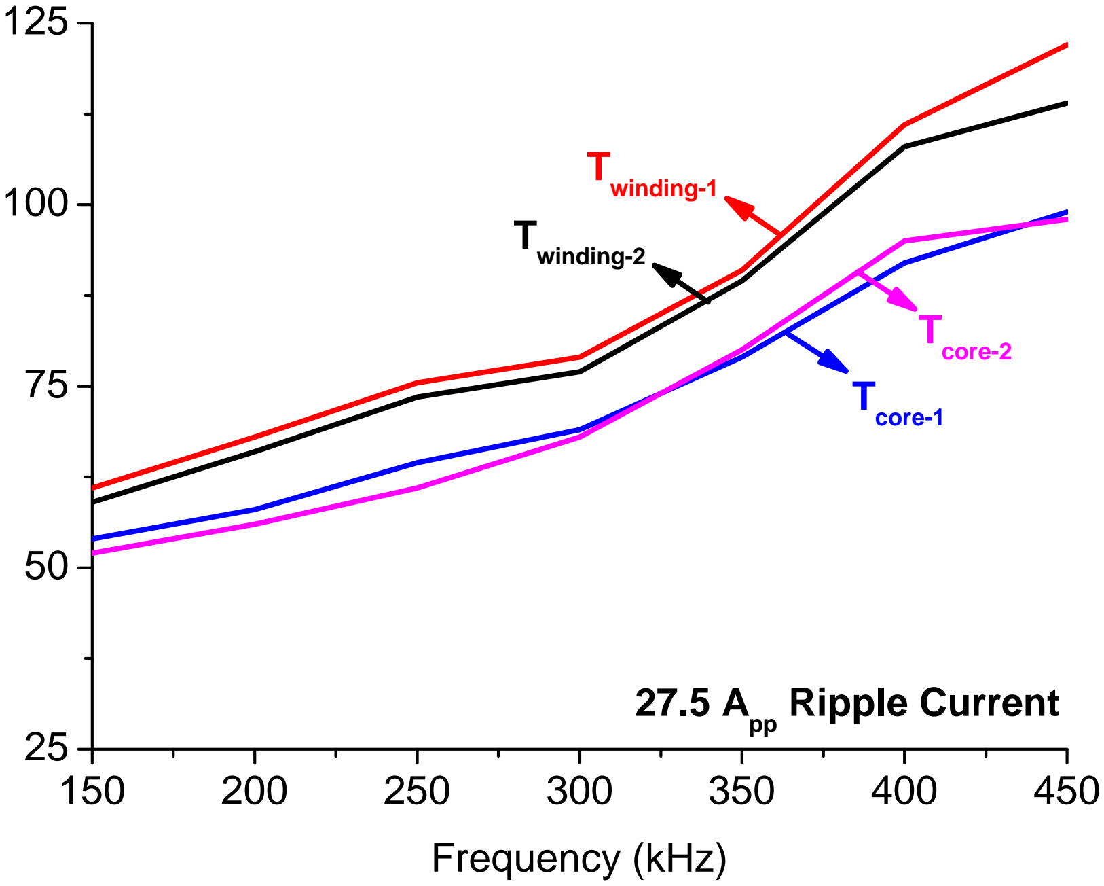
[picture p230: figure]
T core-2; T wi ndi ng-2; Frequ en cy (kH z); T wi ndi ng-1; T core-1; Ri ppl e Cu rren t

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
