furkankarakaya/GaN-Studies/Thesis/Figures/Ch5/Ch5_InductorOpenView.pdf

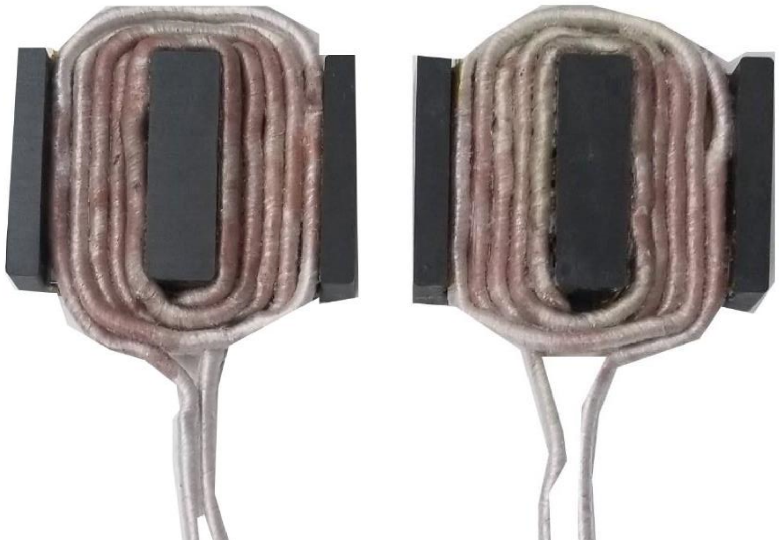
[picture p231: page 1]
