furkankarakaya/GaN-Studies/Thesis/Figures/Ch5/Ch5_InductorThermalPoints.pdf

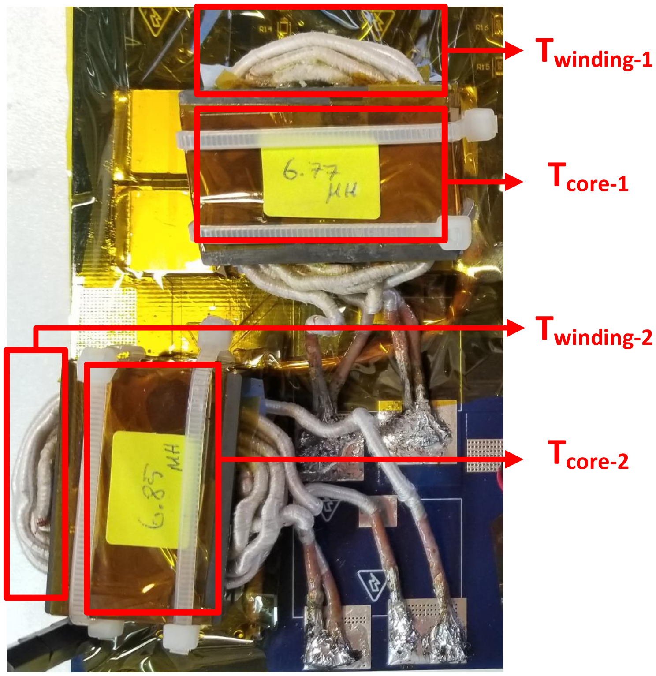
[picture p232: page 1]

Twinding-1

Tcore-1

Twinding-2

Tcore-2
