furkankarakaya/GaN-Studies/Thesis/Figures/Ch5/Ch5_InterleavedConverterTiming.pdf

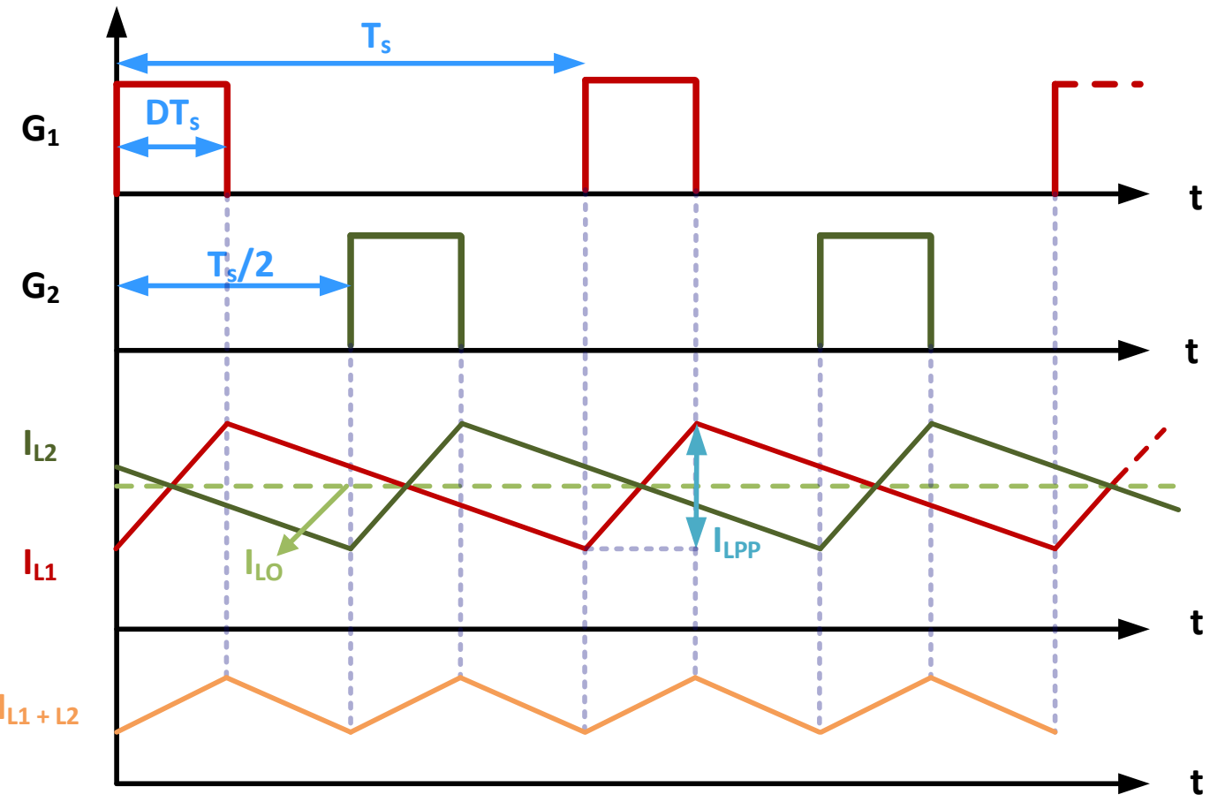
[picture p233: figure]
tttt; LPP

G

G

I

I
