furkankarakaya/GaN-Studies/Thesis/Figures/Ch5/Ch5_SMDCapacitorFreq.pdf

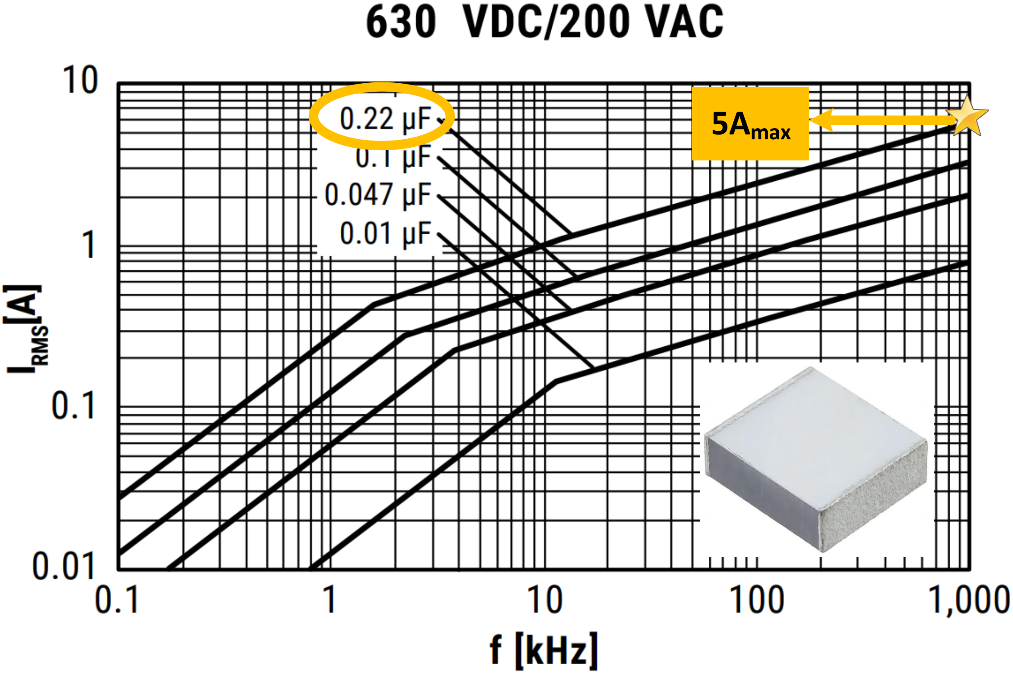
[picture p234: page 1]

5Amax
