furkankarakaya/GaN-Studies/Thesis/Figures/Ch4/Ch4_SenseLoopBVector.pdf

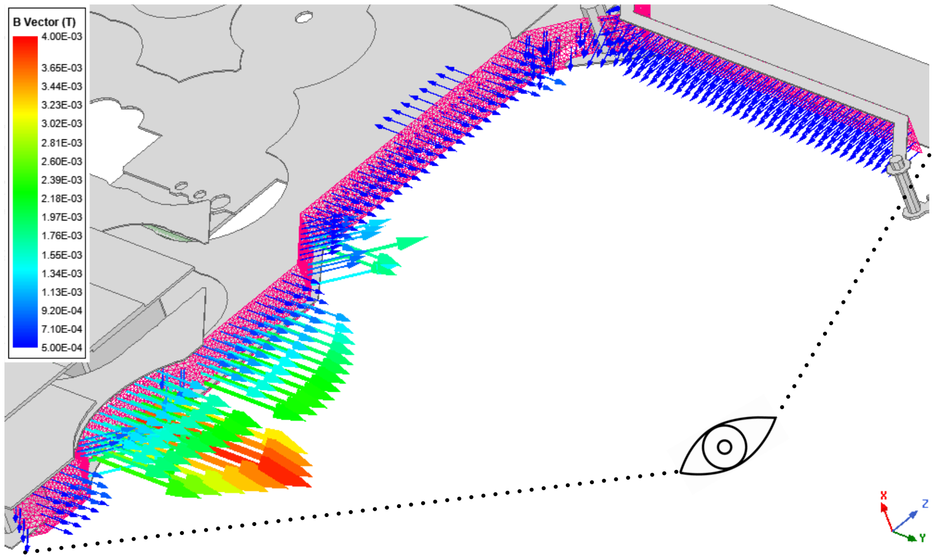
[picture p235: page 1]
