furkankarakaya/GaN-Studies/Thesis/Figures/Ch4/Ch4_RC_FilterBode.pdf

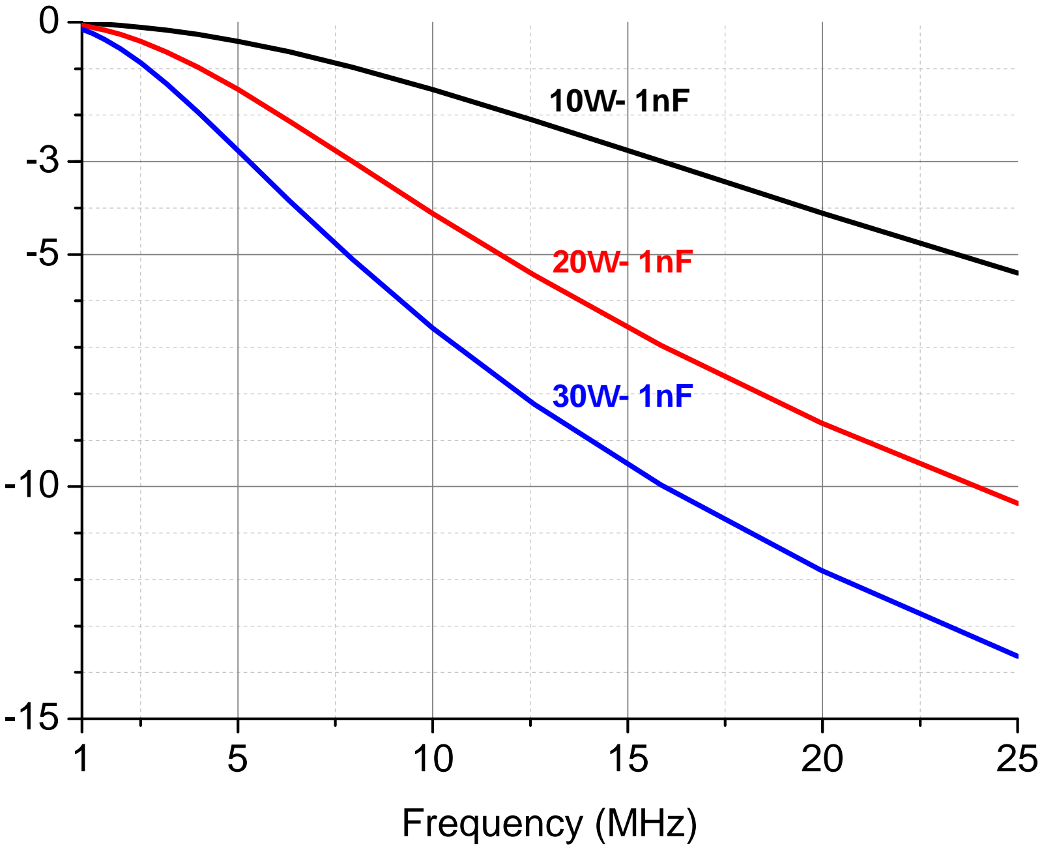
[picture p236: figure]
Fre

Magn i tu de (dB)
