furkankarakaya/GaN-Studies/Thesis/Figures/Ch1/Ch1_Cascode.pdf

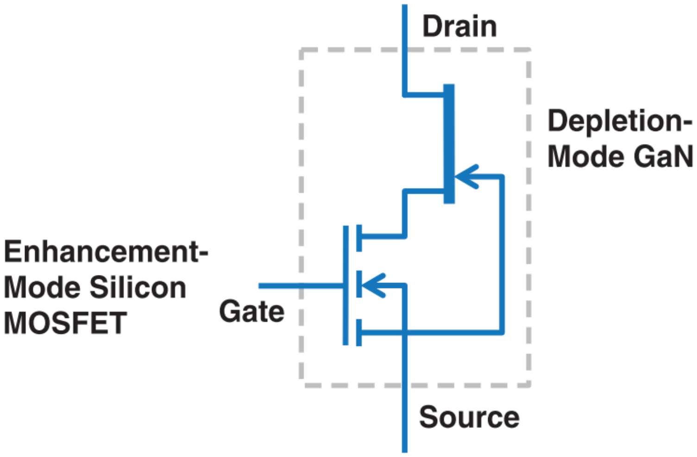
[picture p237: page 1]
