furkankarakaya/GaN-Studies/Thesis/Figures/Ch1/Ch1_CSI.pdf

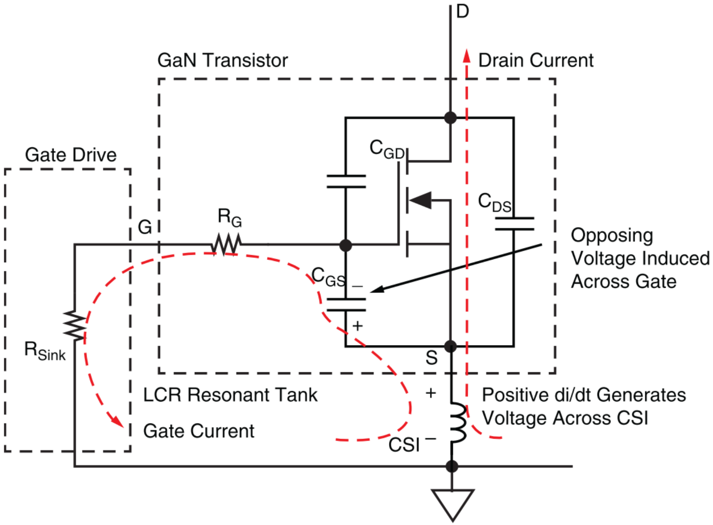
[picture p238: page 1]
