furkankarakaya/GaN-Studies/Thesis/Figures/Ch1/Ch1_CurrentCollapse.pdf

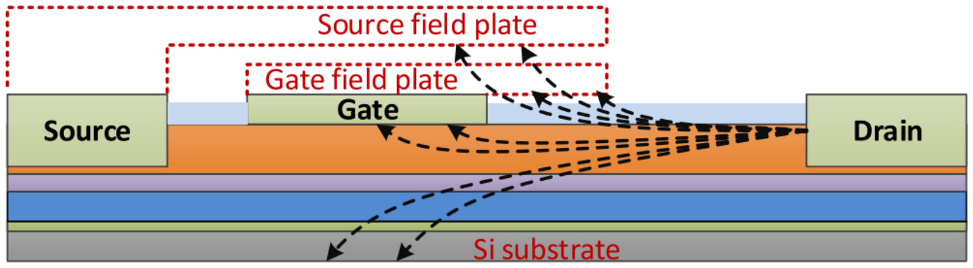
[picture p239: page 1]
