furkankarakaya/GaN-Studies/Thesis/Figures/Ch1/Ch1_DepletionMode.pdf

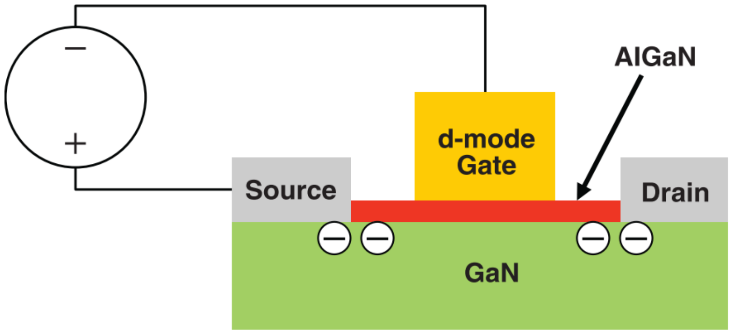
[picture p240: page 1]
