furkankarakaya/GaN-Studies/Thesis/Figures/Ch1/Ch1_ParasiticCapacitance.pdf

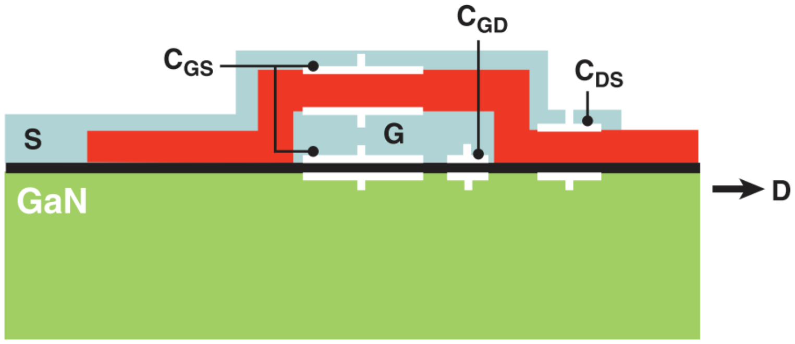
[picture p241: page 1]
