furkankarakaya/GaN-Studies/GaNCircConf.jpg

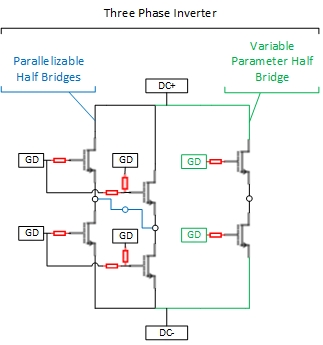
GaNCircConf.jpg
