furkankarakaya/GaN-Studies/images/SwitchingEnergyScaling.png

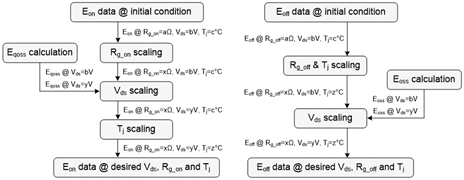
images/SwitchingEnergyScaling.png
