furkankarakaya/GaN-Studies/Protection Circuits/ECCE2019/BodePlot.jpg

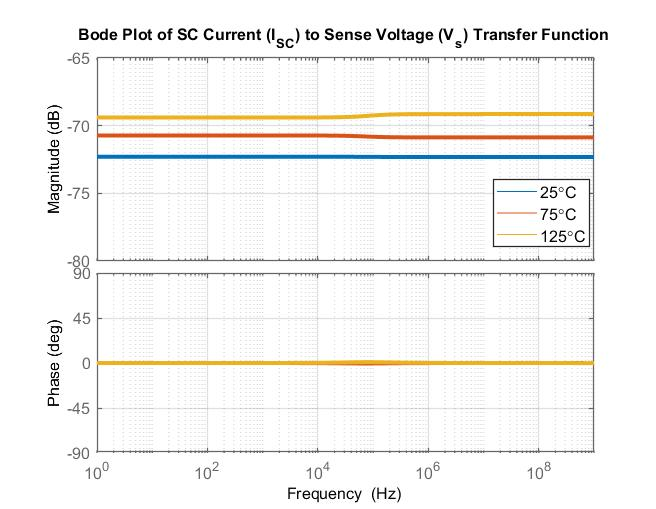
Protection Circuits/ECCE2019/BodePlot.jpg
