furkankarakaya/GaN-Studies/Protection Circuits/ECCE2019/Full Paper/MainBlockDiagram.jpg

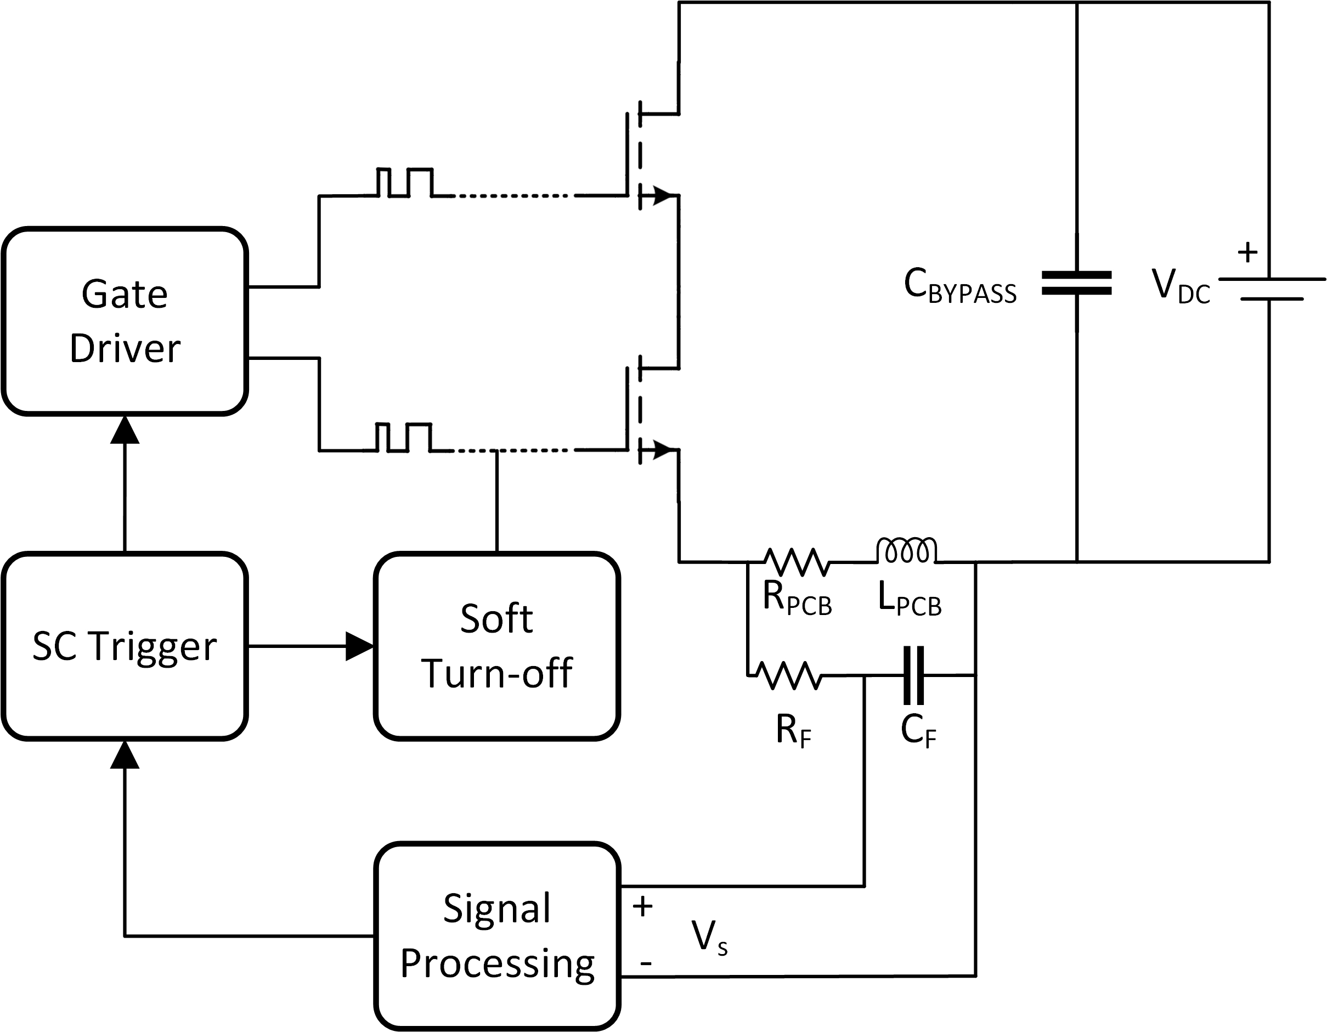
Protection Circuits/ECCE2019/Full Paper/MainBlockDiagram.jpg
