furkankarakaya/GaN-Studies/Protection Circuits/ECCE2019/MainBlockDiagram.jpg

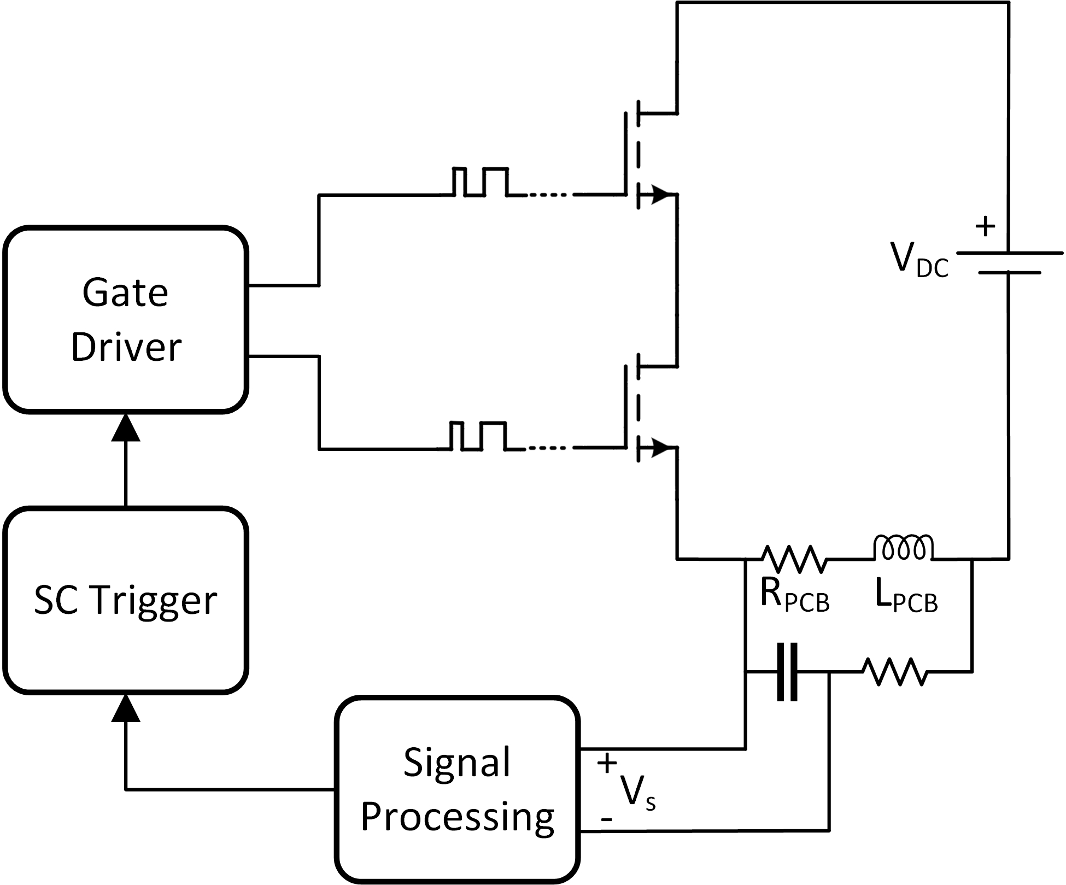
Protection Circuits/ECCE2019/MainBlockDiagram.jpg
