furkankarakaya/GaN-Studies/Protection Circuits/ECCE2019/PCB.jpeg

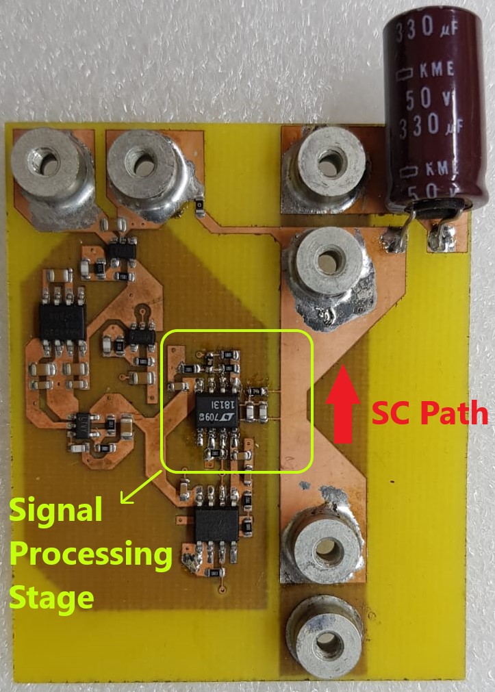
Protection Circuits/ECCE2019/PCB.jpeg
