furkankarakaya/GaN-Studies/Protection Circuits/ECCE2019/RC_Network.jpg

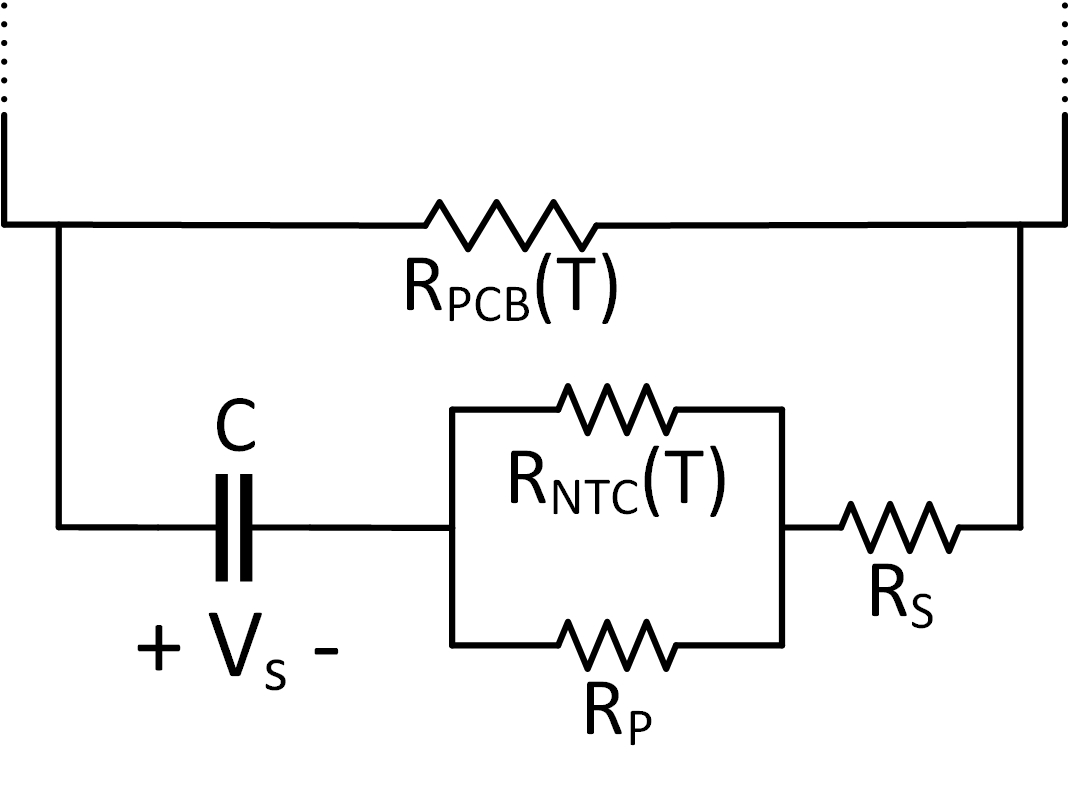
Protection Circuits/ECCE2019/RC_Network.jpg
