furkankarakaya/GaN-Studies/Protection Circuits/ECCE2019/SignalProcessingBlock.jpg

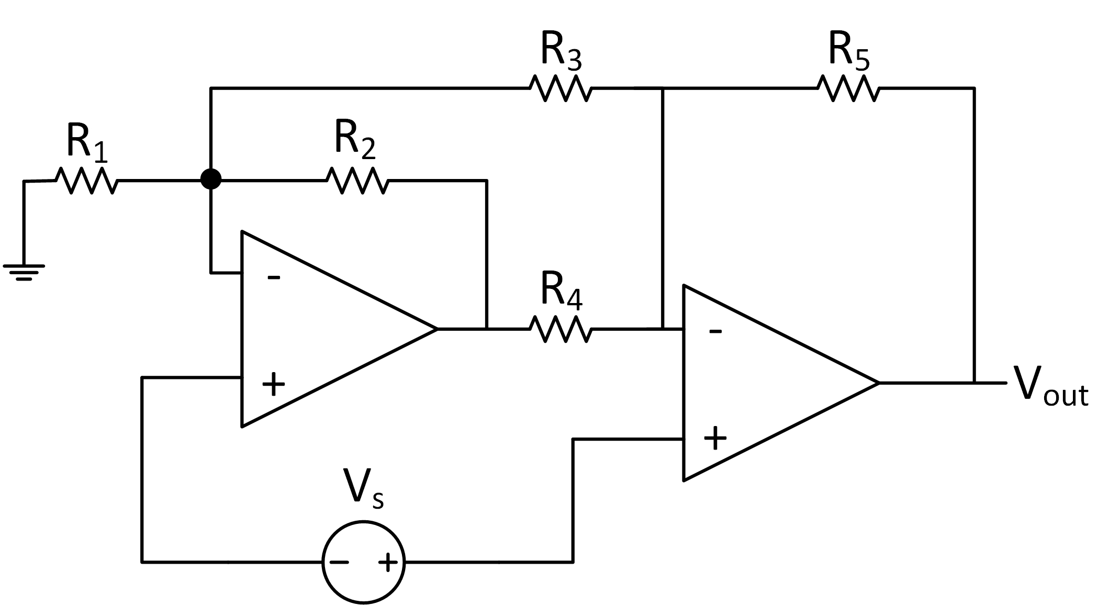
Protection Circuits/ECCE2019/SignalProcessingBlock.jpg
