furkankarakaya/GaN-Studies/Protection Circuits/ECCE2019/TrackFrequency.jpg

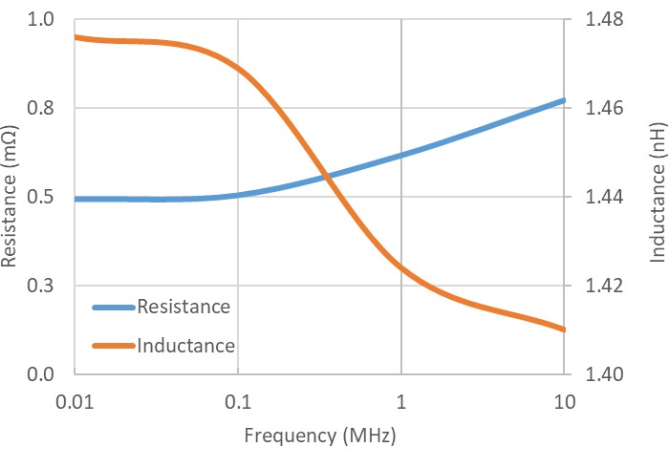
Protection Circuits/ECCE2019/TrackFrequency.jpg
