furkankarakaya/GaN-Studies/Protection Circuits/ECCE2019/TrackLength.jpg

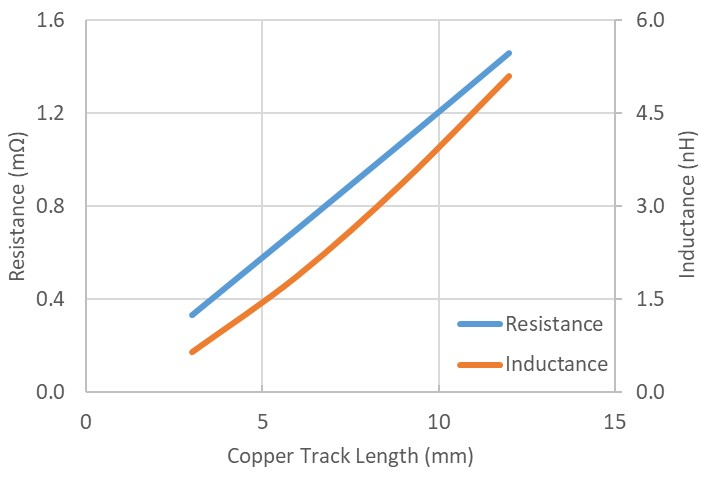
Protection Circuits/ECCE2019/TrackLength.jpg
