furkankarakaya/GaN-Studies/Protection Circuits/ECCE2019/TrackThickness.jpg

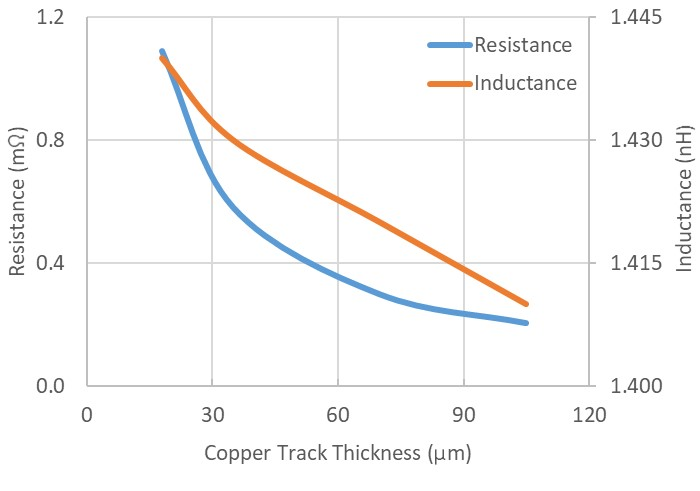
Protection Circuits/ECCE2019/TrackThickness.jpg
