furkankarakaya/GaN-Studies/Protection Circuits/ECCE2019/TrackWidth.jpg

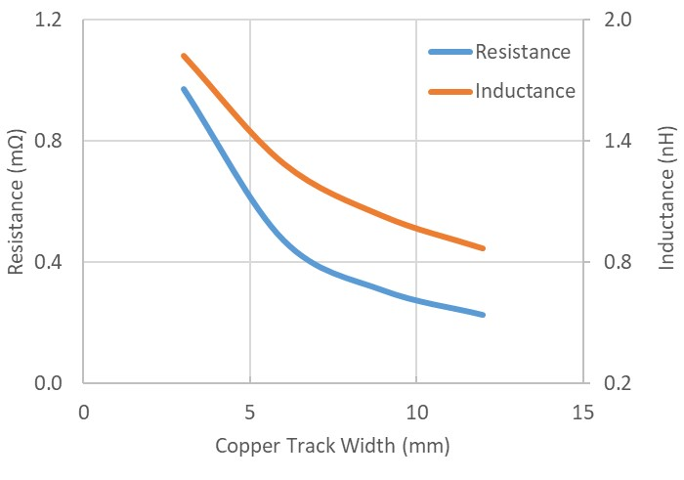
Protection Circuits/ECCE2019/TrackWidth.jpg
