furkankarakaya/GaN-Studies/Protection Circuits/TPEL Letter/20200427_124608.jpg

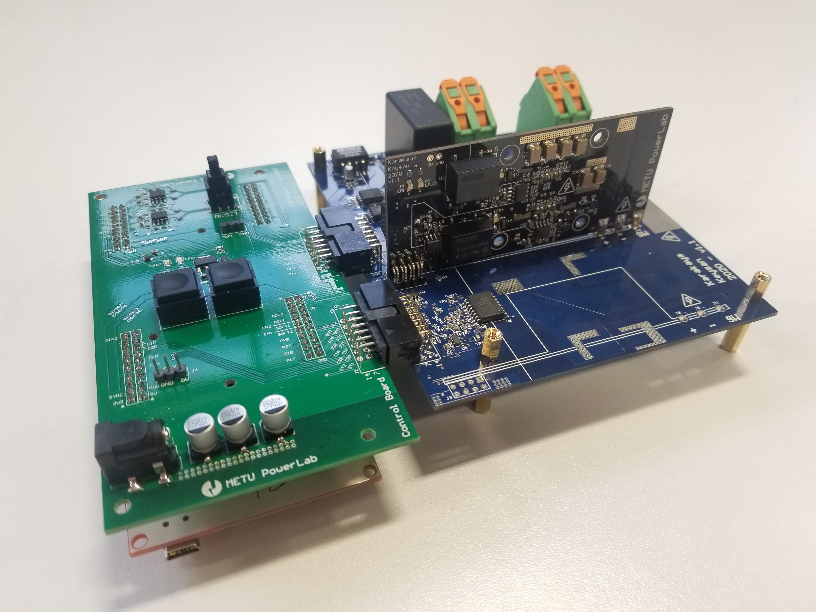
Protection Circuits/TPEL Letter/20200427_124608.jpg
