furkankarakaya/GaN-Studies/Protection Circuits/TPEL Letter/OLAB/Graph2.jpg

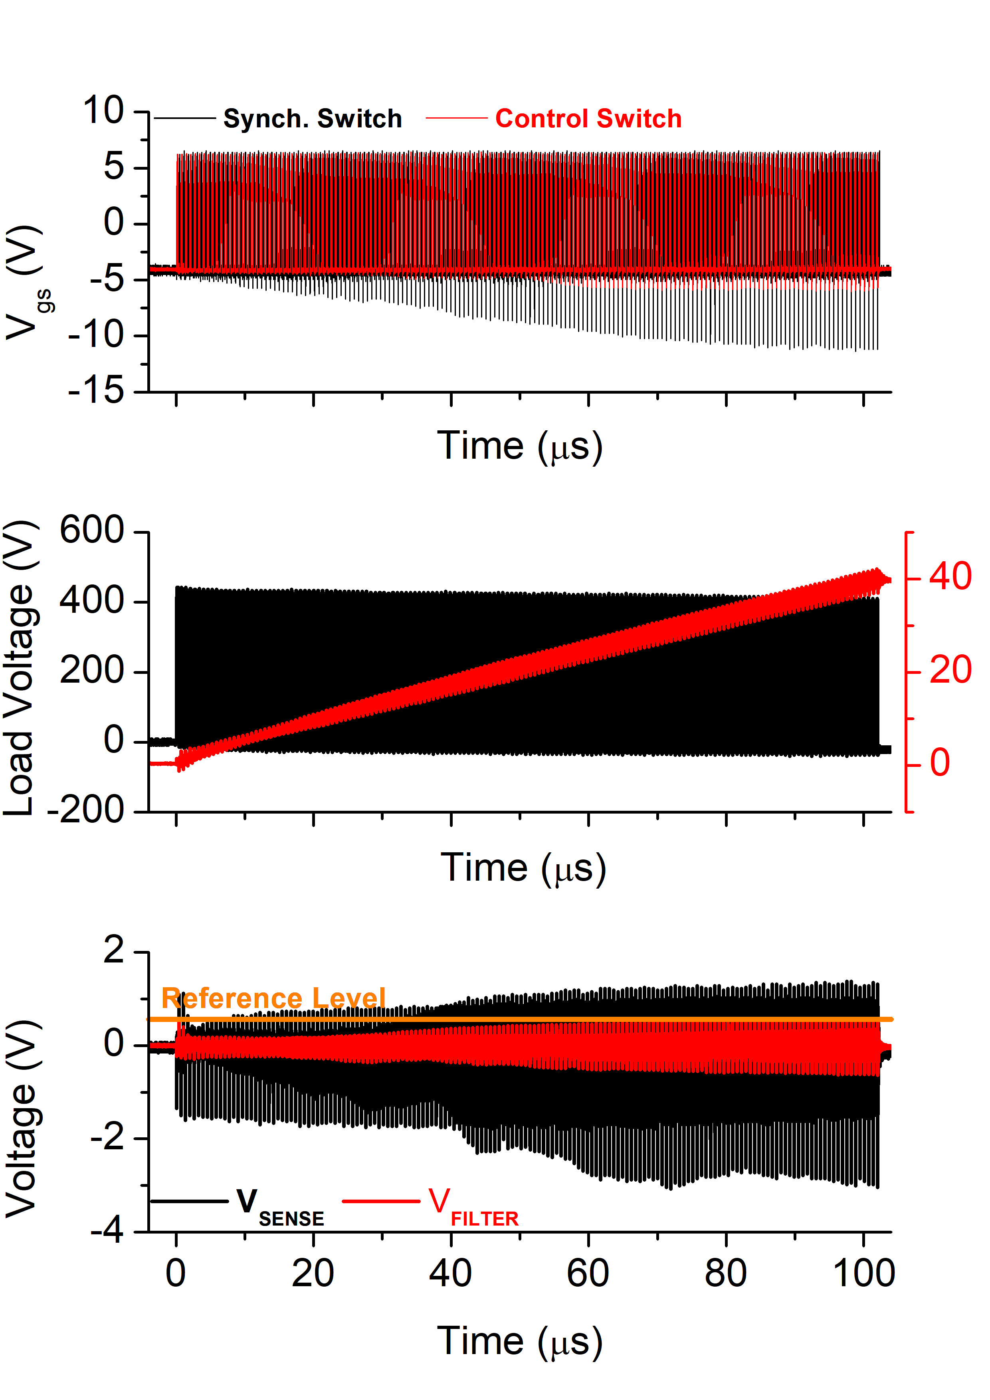
Protection Circuits/TPEL Letter/OLAB/Graph2.jpg
