furkankarakaya/GaN-Studies/Protection Circuits/TPEL Letter/PNG/DecreaseGraphandCirc.png

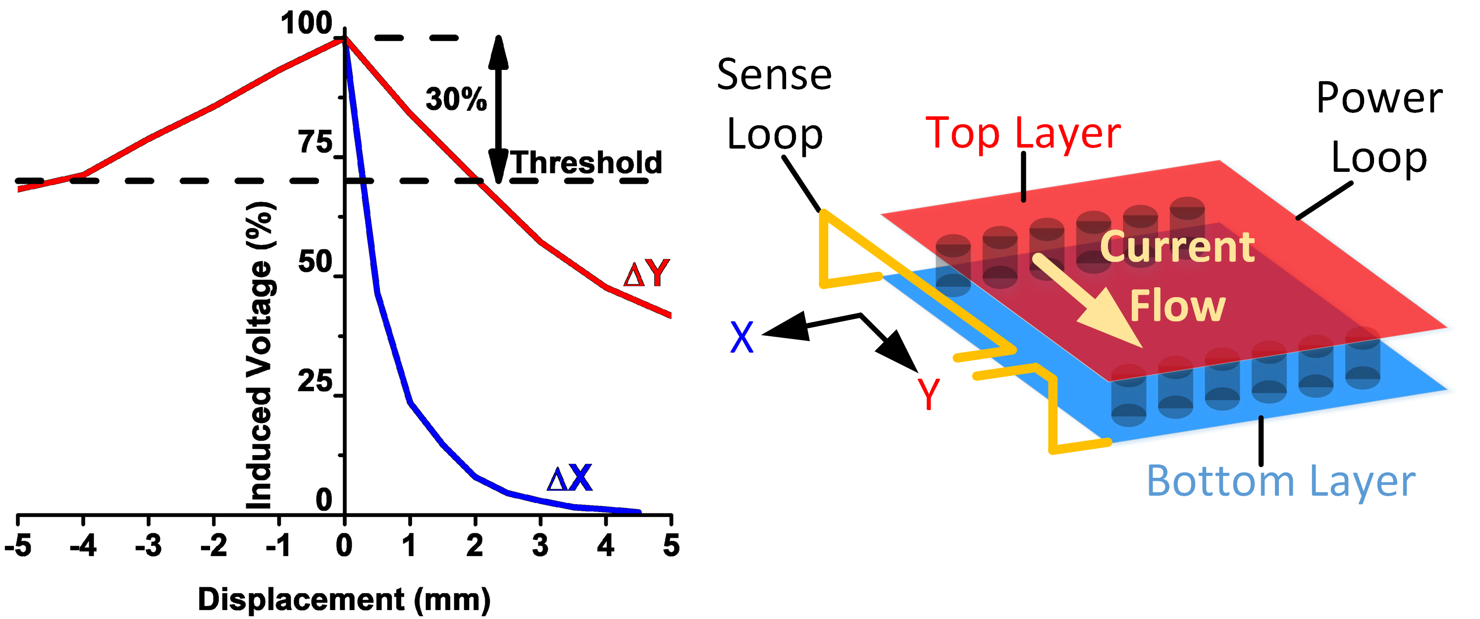
Protection Circuits/TPEL Letter/PNG/DecreaseGraphandCirc.png
