furkankarakaya/GaN-Studies/Protection Circuits/TPEL Letter/PNG/DecreasePNG.png

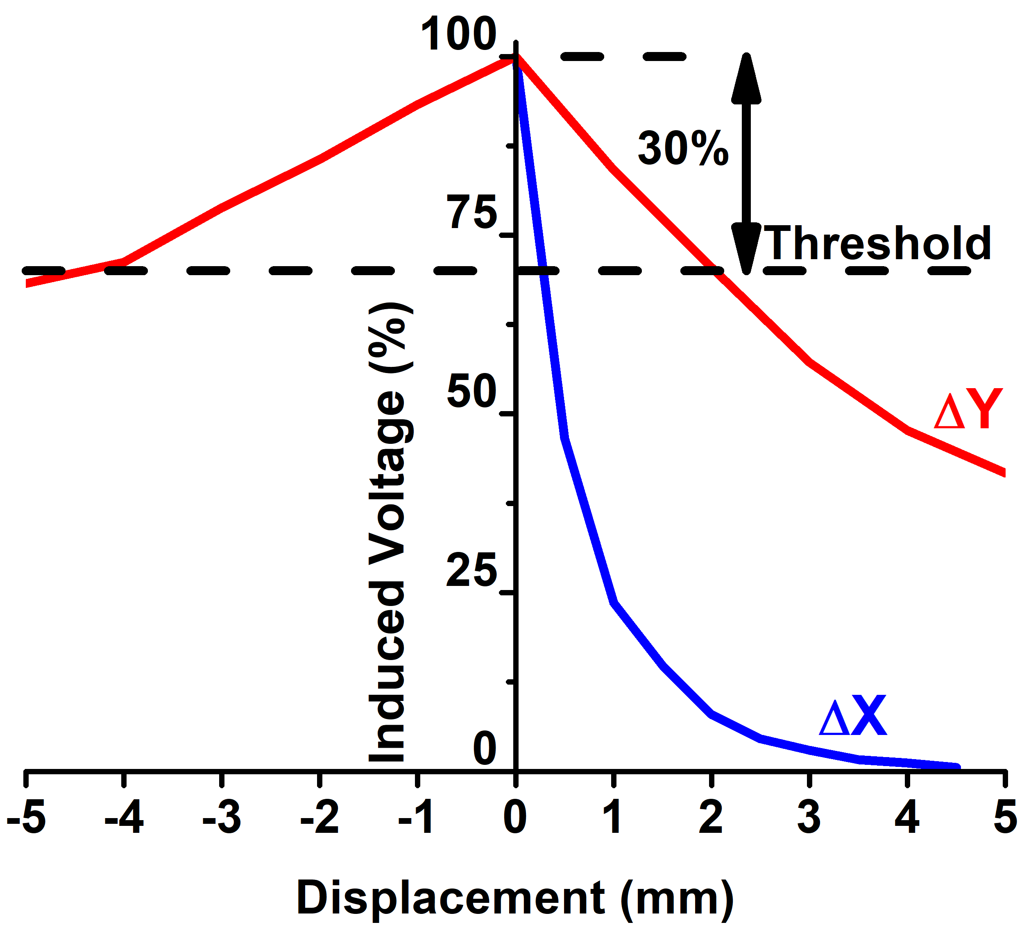
Protection Circuits/TPEL Letter/PNG/DecreasePNG.png
