furkankarakaya/GaN-Studies/Protection Circuits/TPEL Letter/PNG/Difference.png

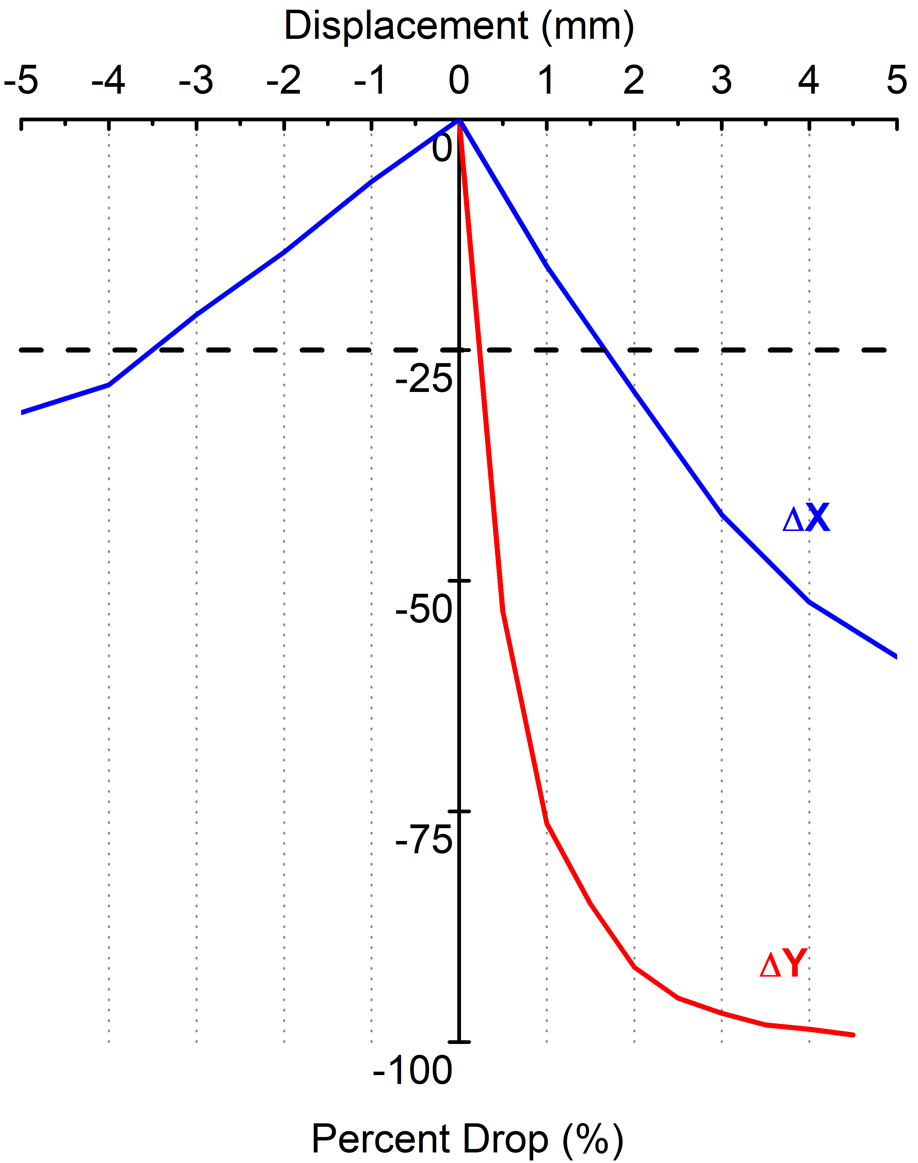
Protection Circuits/TPEL Letter/PNG/Difference.png
