furkankarakaya/GaN-Studies/Protection Circuits/TPEL Letter/PNG/DPTvsSCPFiltouts.png

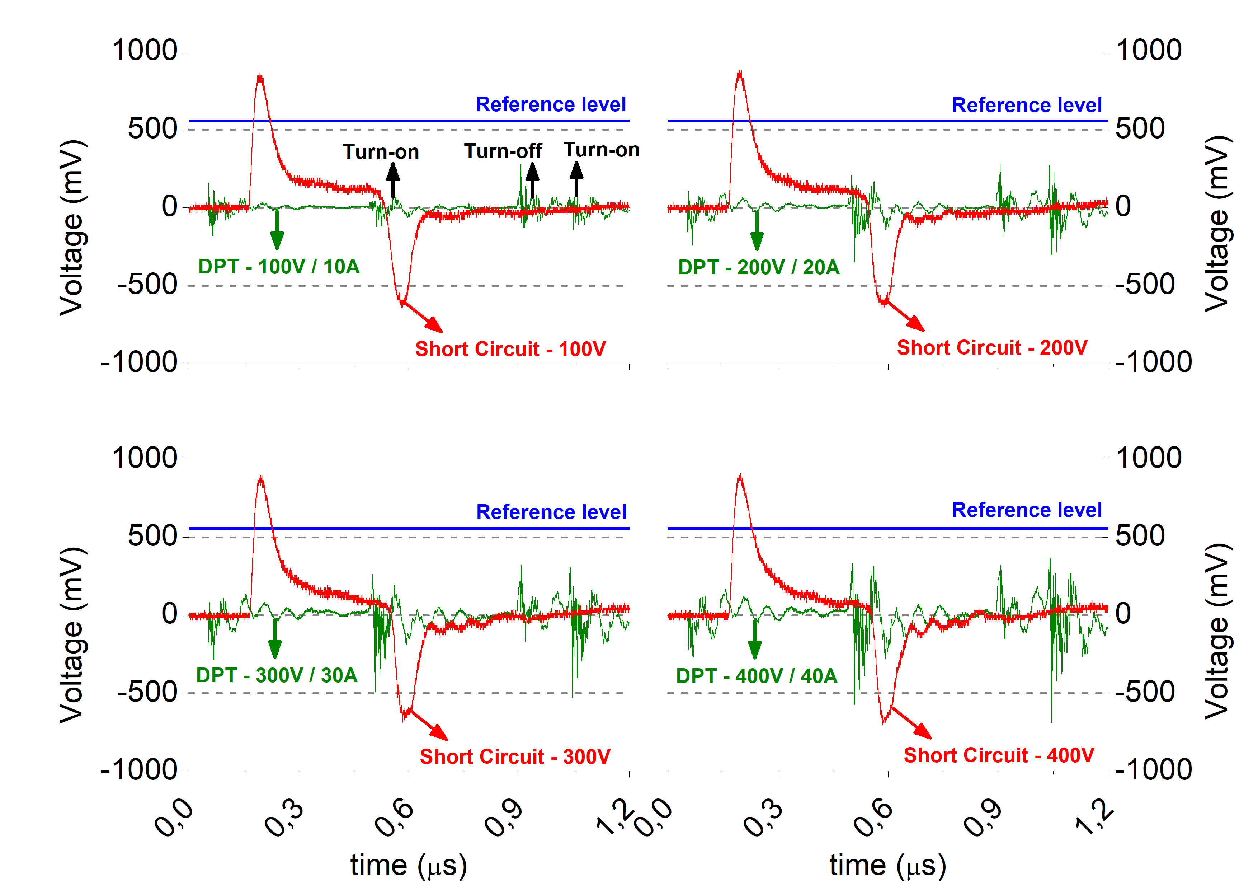
Protection Circuits/TPEL Letter/PNG/DPTvsSCPFiltouts.png
