furkankarakaya/GaN-Studies/Protection Circuits/TPEL Letter/PNG/FFTComparison.png

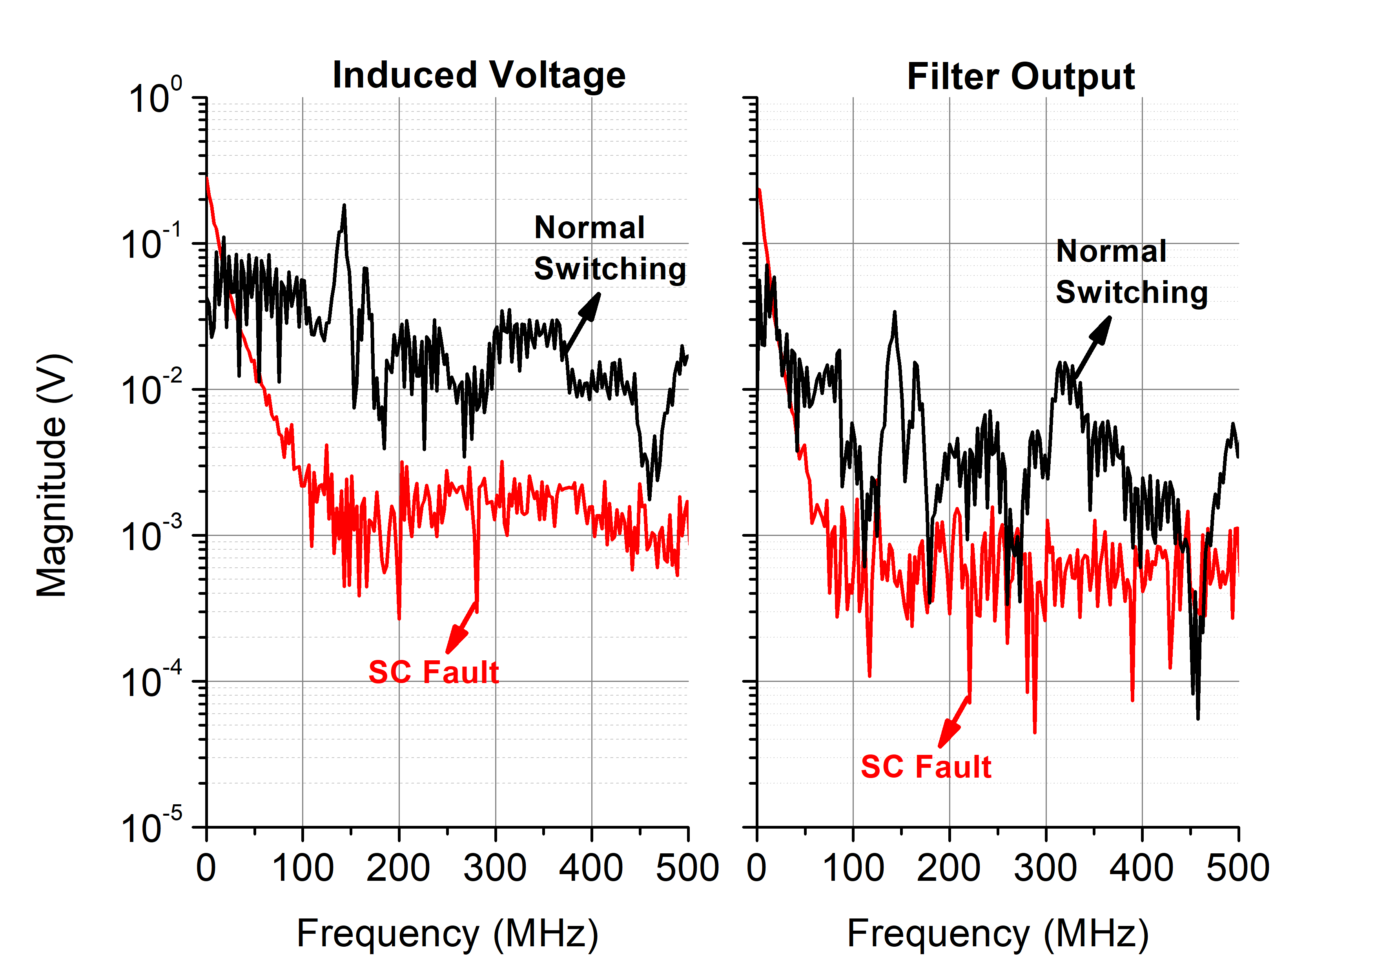
Protection Circuits/TPEL Letter/PNG/FFTComparison.png
