furkankarakaya/GaN-Studies/Protection Circuits/TPEL Letter/PNG/LayoutDrawing.png

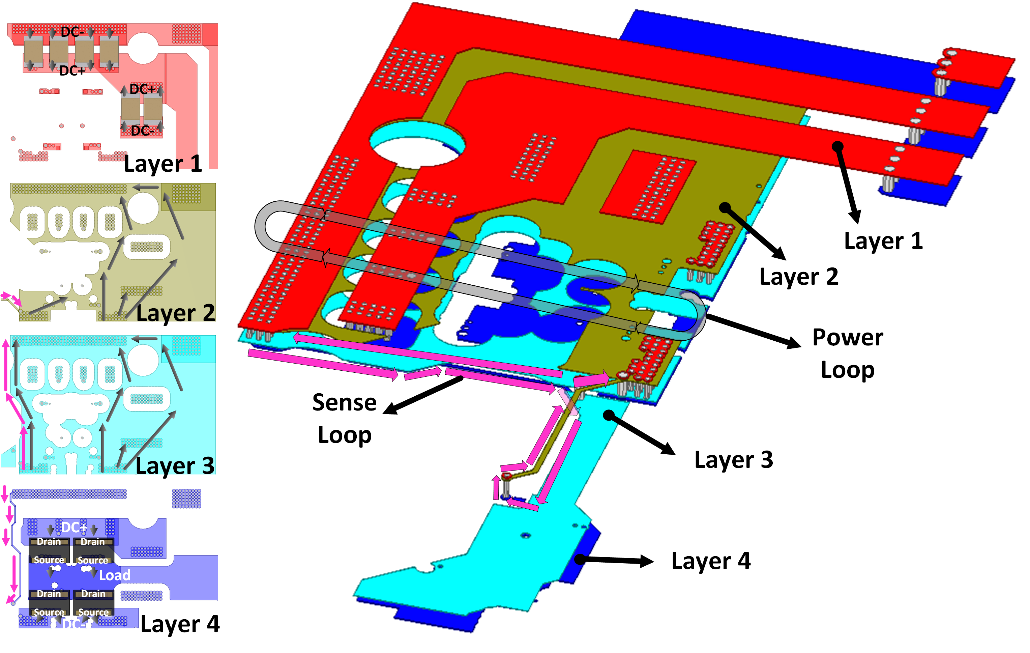
Protection Circuits/TPEL Letter/PNG/LayoutDrawing.png
