furkankarakaya/GaN-Studies/Protection Circuits/TPEL Letter/PNG/SCDynamics.png

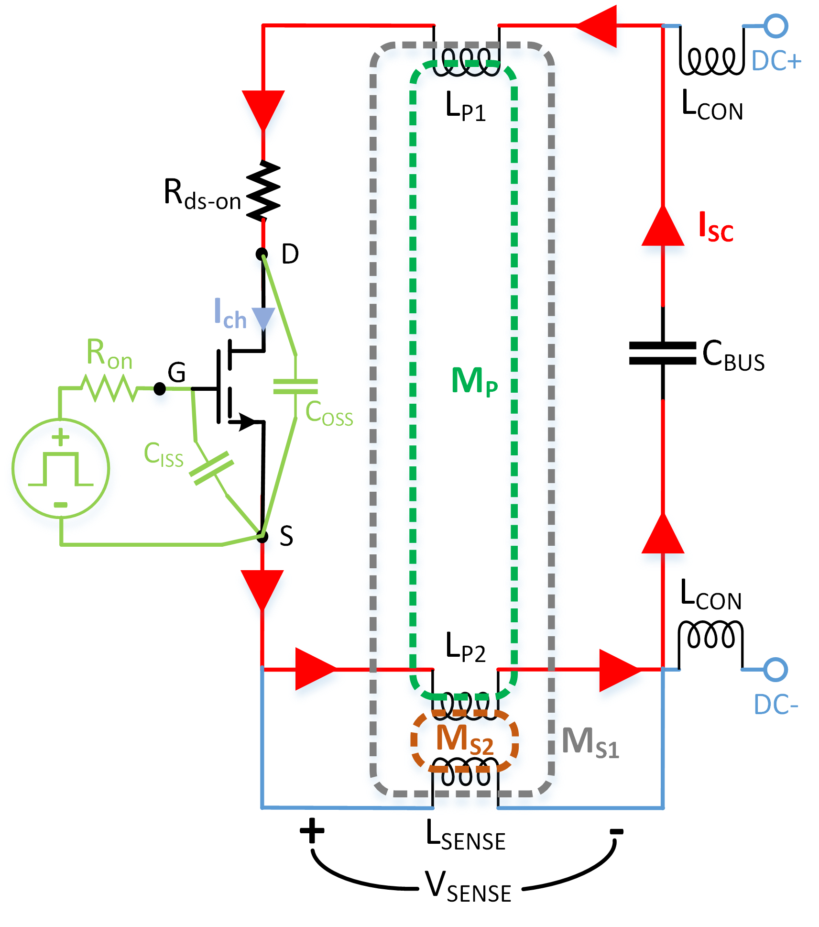
Protection Circuits/TPEL Letter/PNG/SCDynamics.png
