furkankarakaya/GaN-Studies/Protection Circuits/TPEL Letter/PNG/SenseOptions - v2.png

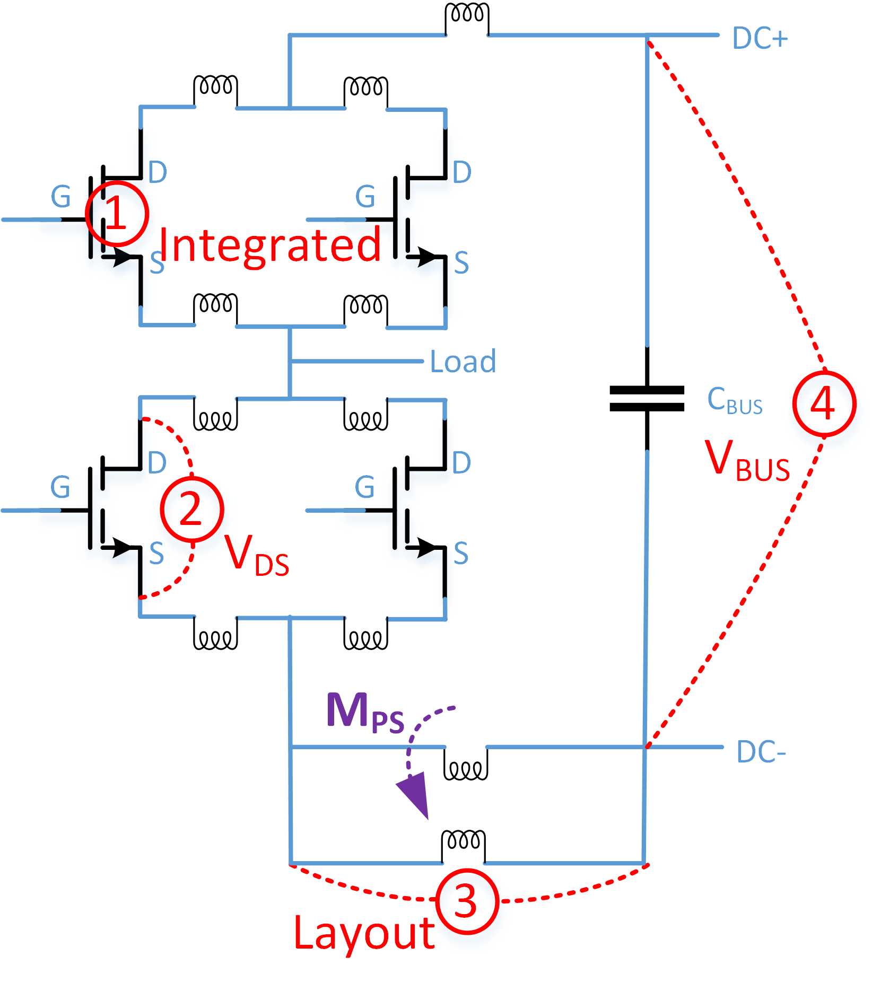
Protection Circuits/TPEL Letter/PNG/SenseOptions - v2.png
