furkankarakaya/GaN-Studies/Protection Circuits/TPEL Letter/PNG/SignalProcessingBlock - v2.png

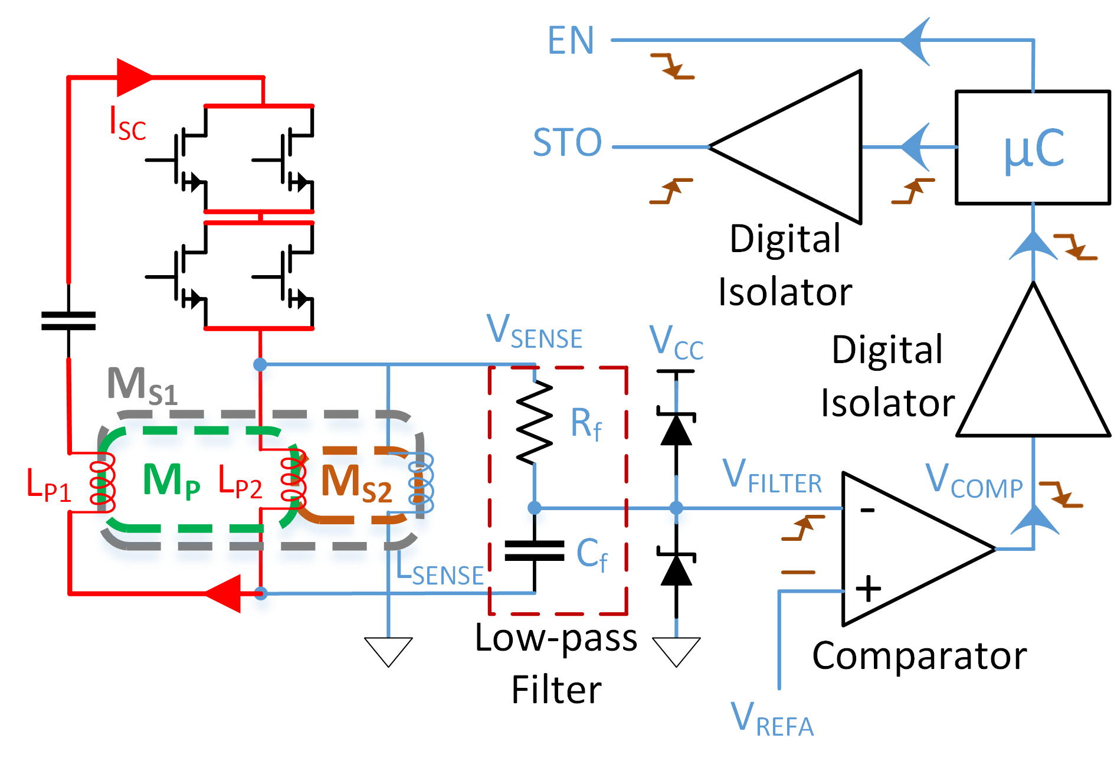
Protection Circuits/TPEL Letter/PNG/SignalProcessingBlock - v2.png
