furkankarakaya/GaN-Studies/Protection Circuits/TPEL Letter/Symbolic Layout-axes.png

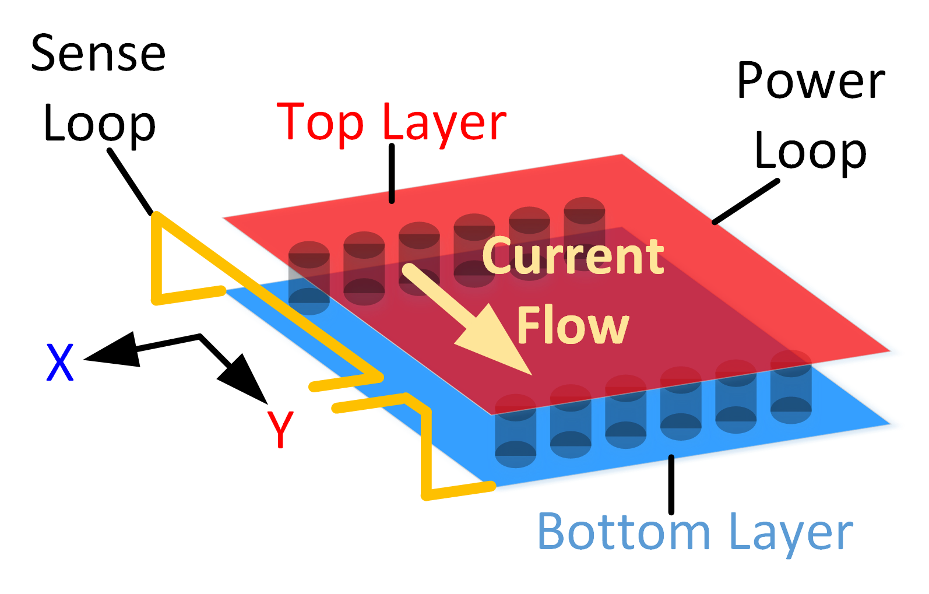
Protection Circuits/TPEL Letter/Symbolic Layout-axes.png
