furkankarakaya/GaN-Studies/Protection Circuits/TPEL Letter/timing.jpg

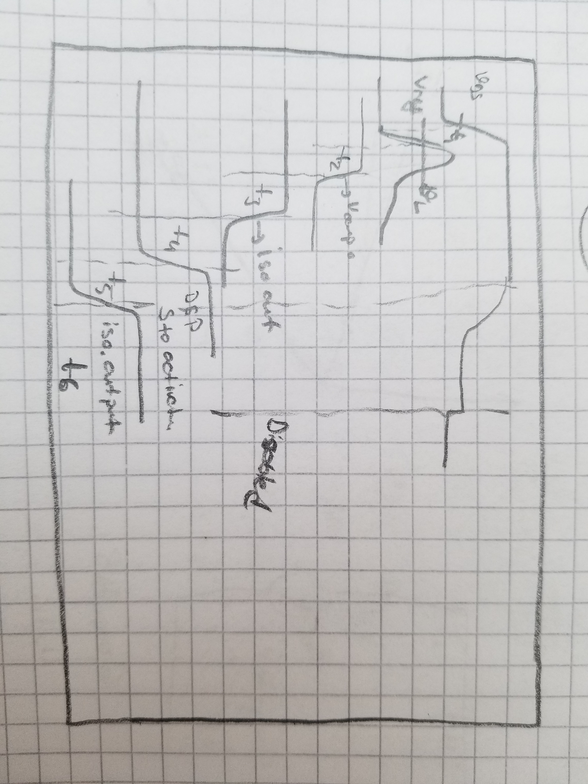
Protection Circuits/TPEL Letter/timing.jpg
