furkankarakaya/GaN-Studies/Thesis/Figures/Ch1/Pentagon.jpg

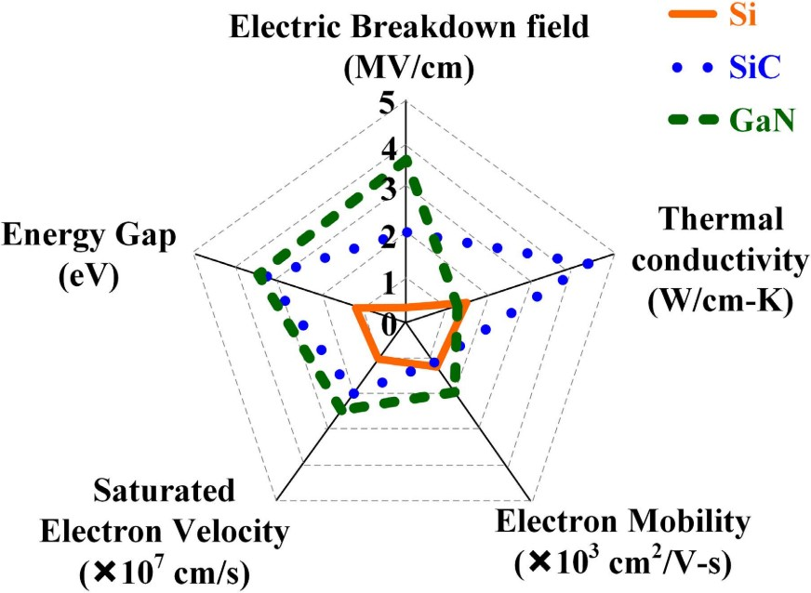
Thesis/Figures/Ch1/Pentagon.jpg
