furkankarakaya/GaN-Studies/Thesis/Figures/Ch1/Piezo.jpg

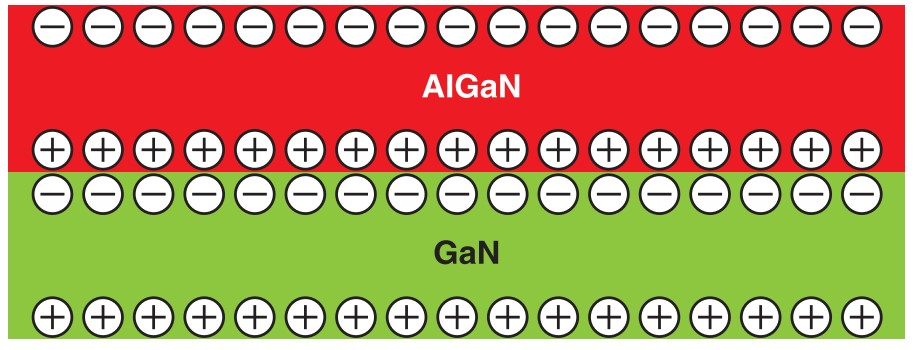
Thesis/Figures/Ch1/Piezo.jpg
