furkankarakaya/GaN-Studies/Thesis/Figures/Ch2/Ch2_HardGateDriver.jpg

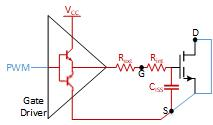
Thesis/Figures/Ch2/Ch2_HardGateDriver.jpg
