furkankarakaya/GaN-Studies/Thesis/Figures/Ch2/Ch2_HardGateDriver.png

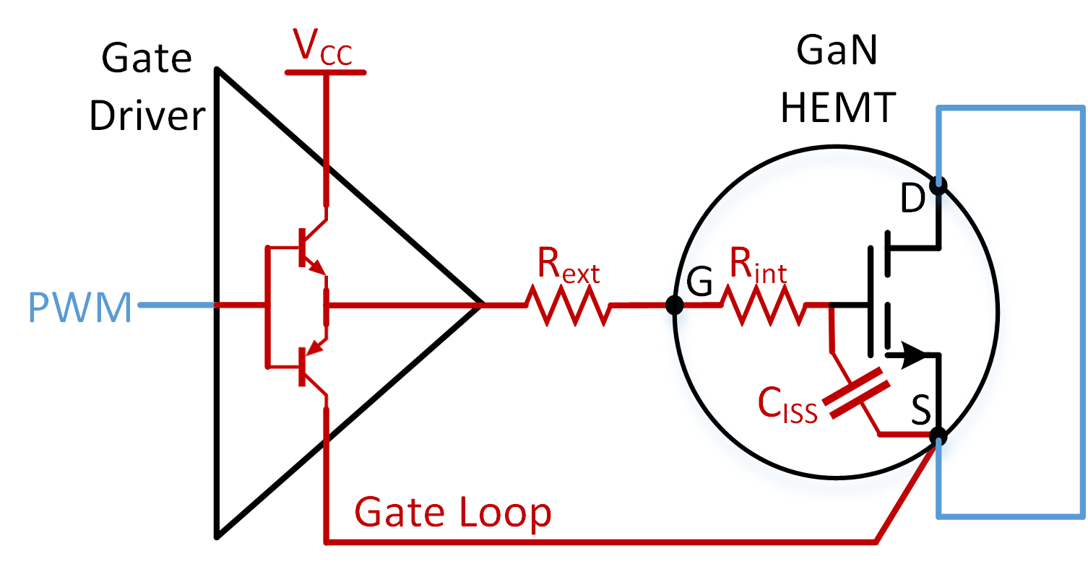
Thesis/Figures/Ch2/Ch2_HardGateDriver.png
