furkankarakaya/GaN-Studies/Thesis/Figures/Ch4/Ch4_SimplifiedModel.jpg

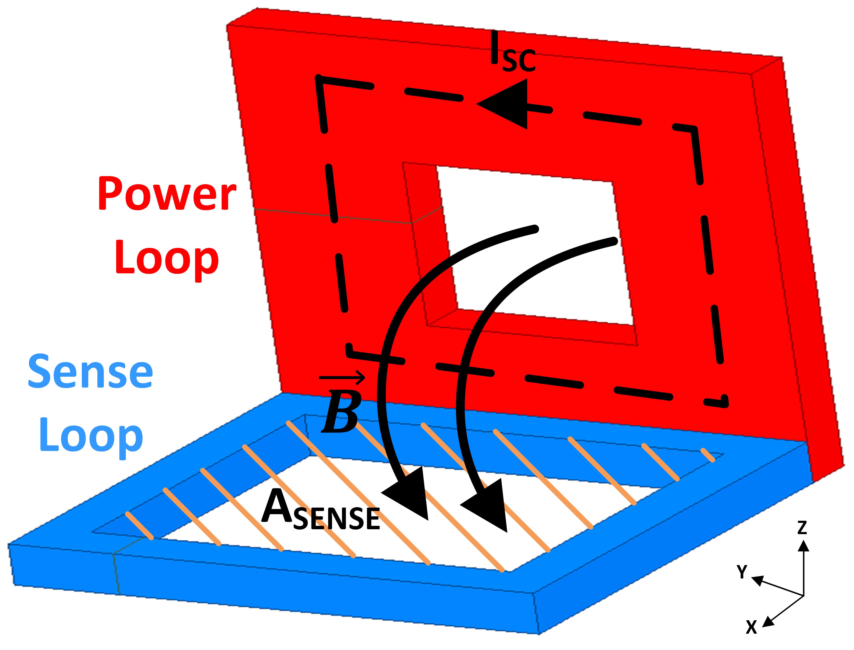
Thesis/Figures/Ch4/Ch4_SimplifiedModel.jpg
