furkankarakaya/GaN-Studies/Thesis/Presentation/Ch2_CissVSVgs.jpg

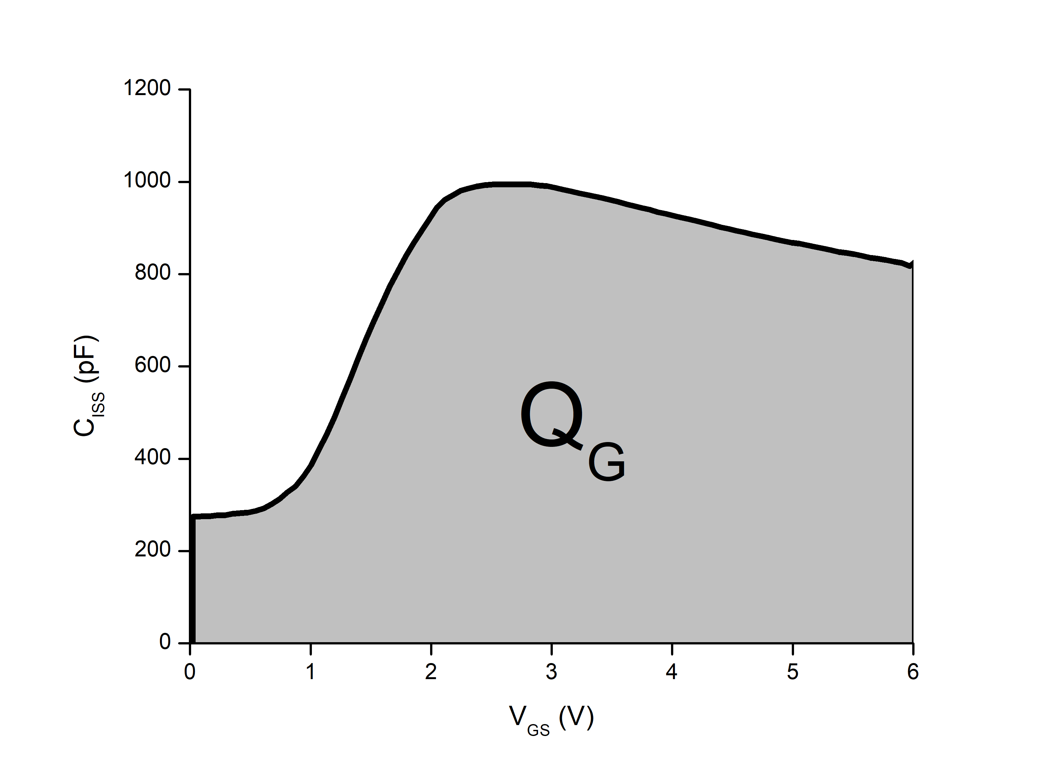
Thesis/Presentation/Ch2_CissVSVgs.jpg
