furkankarakaya/GaN-Studies/Thesis/Presentation/Ch2_CossCircuit.jpg

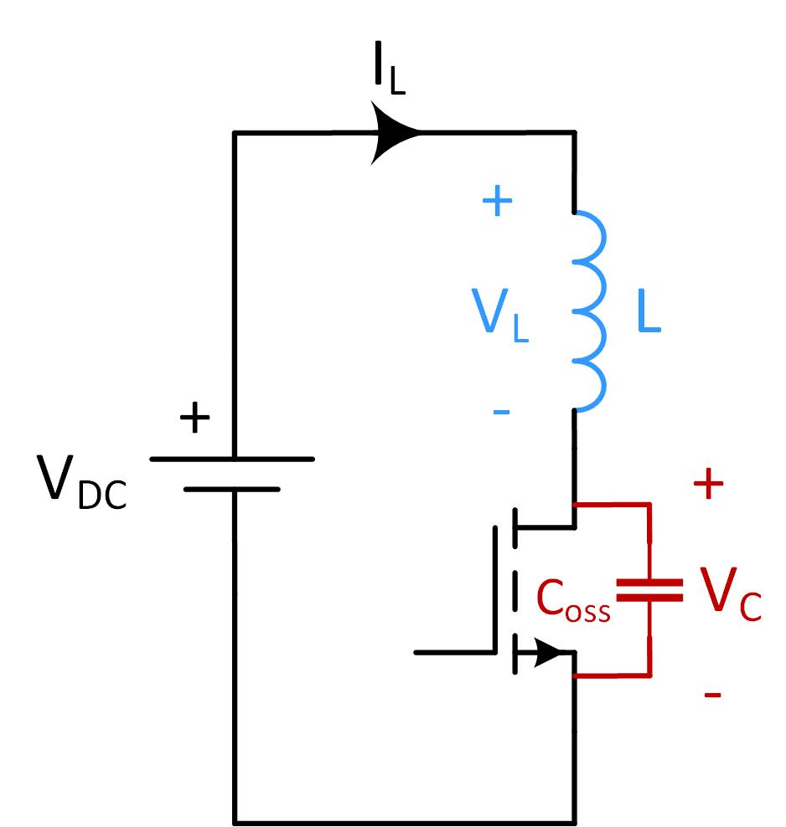
Thesis/Presentation/Ch2_CossCircuit.jpg
