furkankarakaya/GaN-Studies/Thesis/Presentation/Ch2_CossTheory.jpg

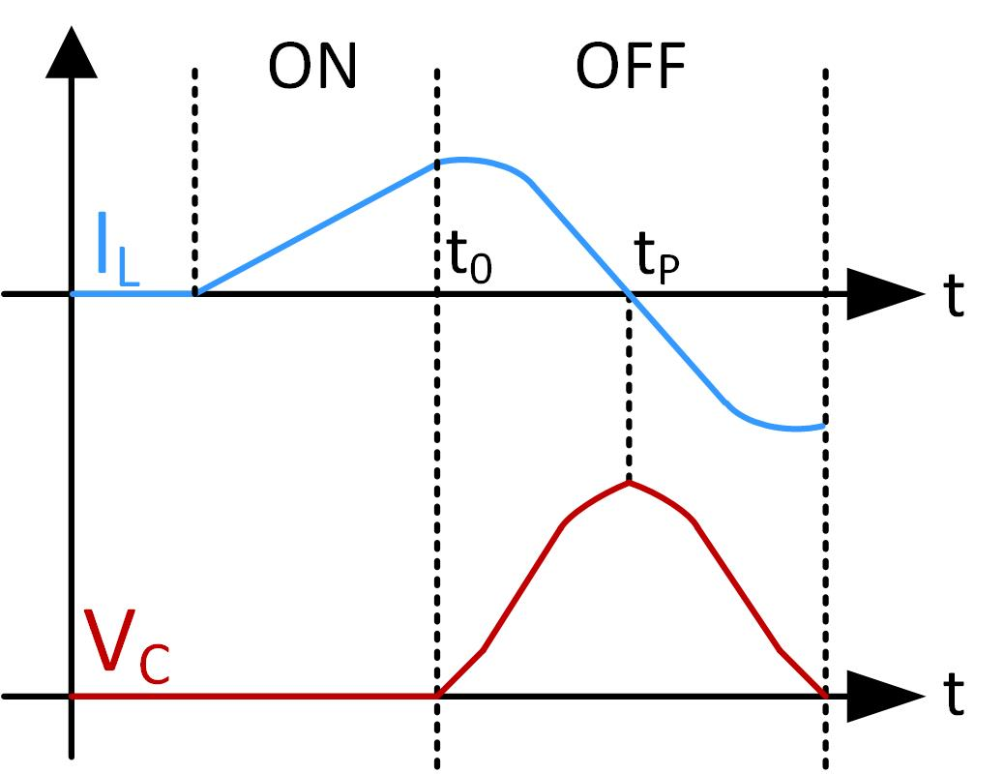
Thesis/Presentation/Ch2_CossTheory.jpg
