furkankarakaya/GaN-Studies/Thesis/Presentation/Ch2_CossVds.jpg

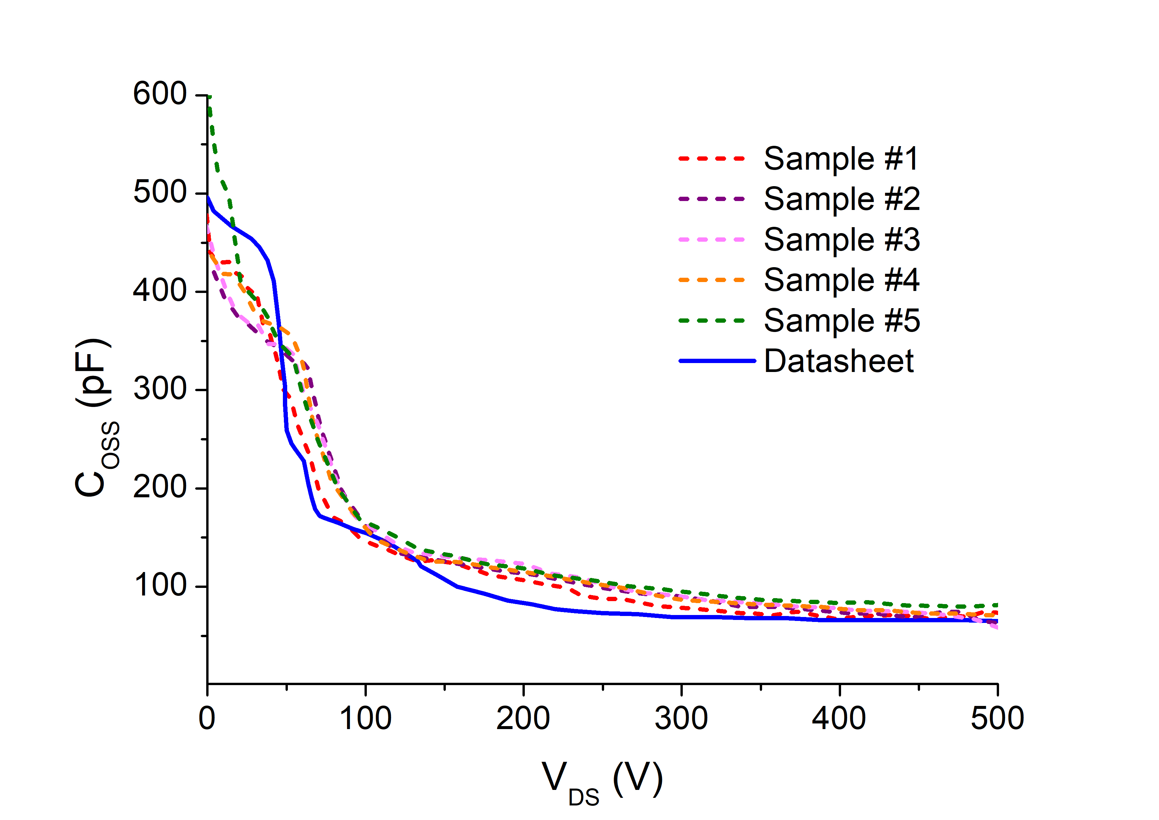
Thesis/Presentation/Ch2_CossVds.jpg
