furkankarakaya/GaN-Studies/Thesis/Presentation/Ch2_EossVds.jpg

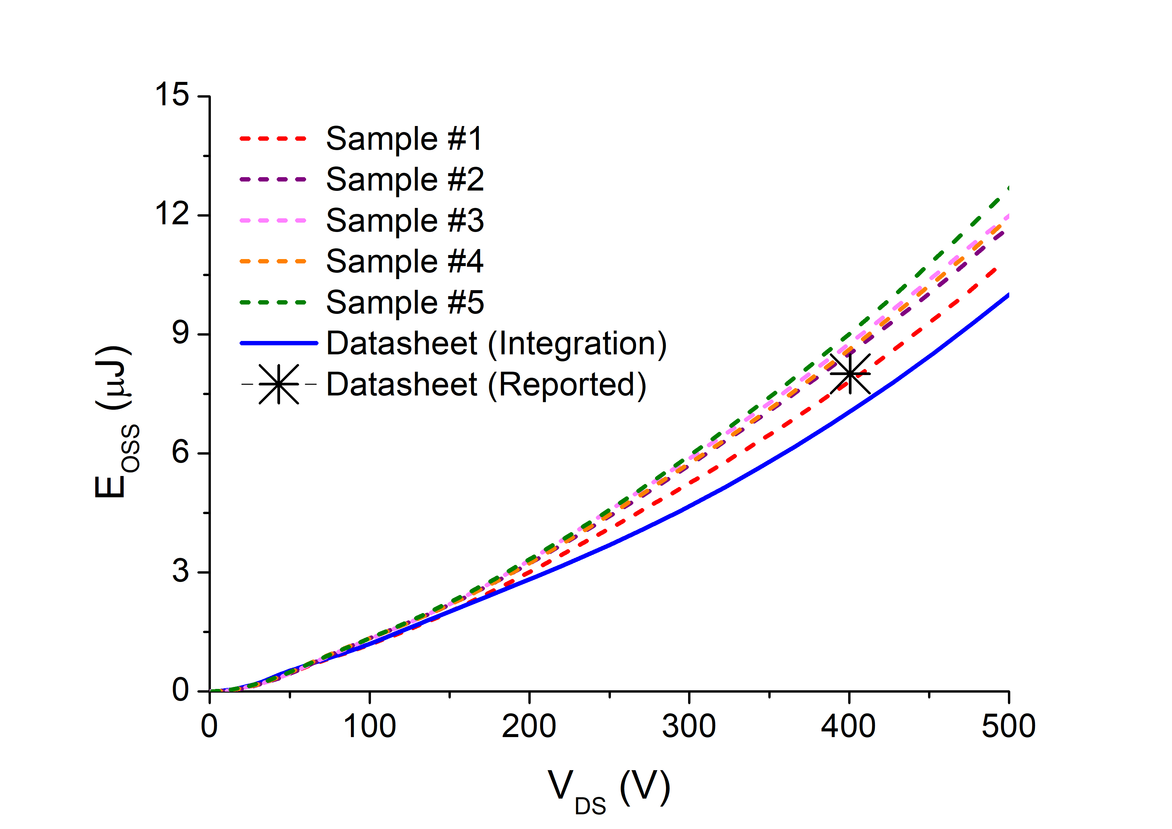
Thesis/Presentation/Ch2_EossVds.jpg
