furkankarakaya/GaN-Studies/Thesis/Presentation/Ch2_GateChargePCB.jpg

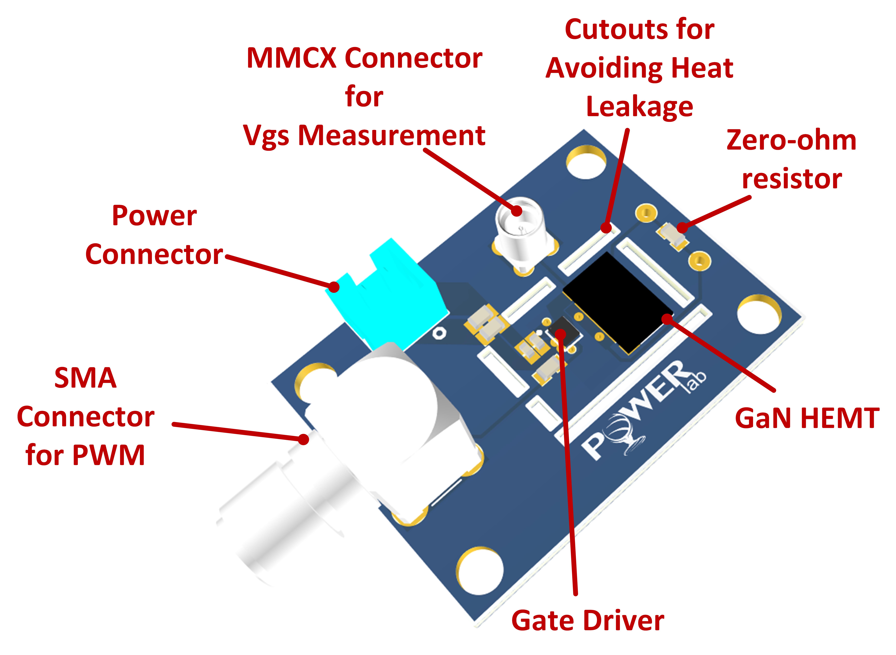
Thesis/Presentation/Ch2_GateChargePCB.jpg
