furkankarakaya/GaN-Studies/Thesis/Presentation/Ch2_GateDriverLoss .jpg

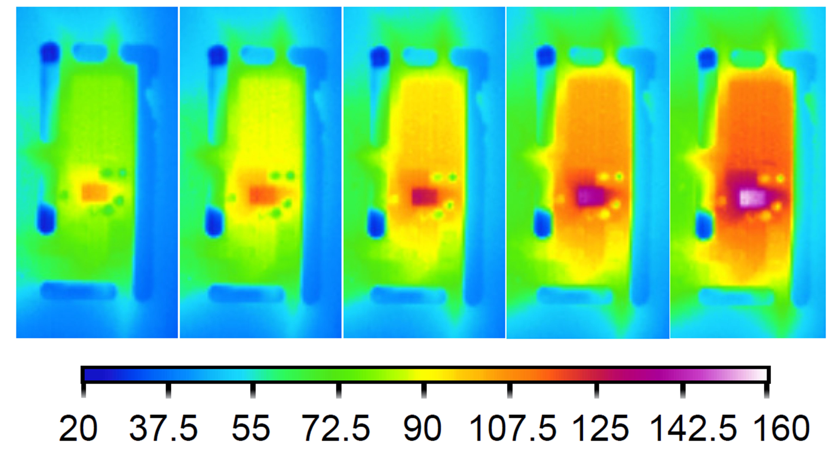
Thesis/Presentation/Ch2_GateDriverLoss .jpg
