furkankarakaya/GaN-Studies/Thesis/Presentation/Ch2_GateLossvsFreq.jpg

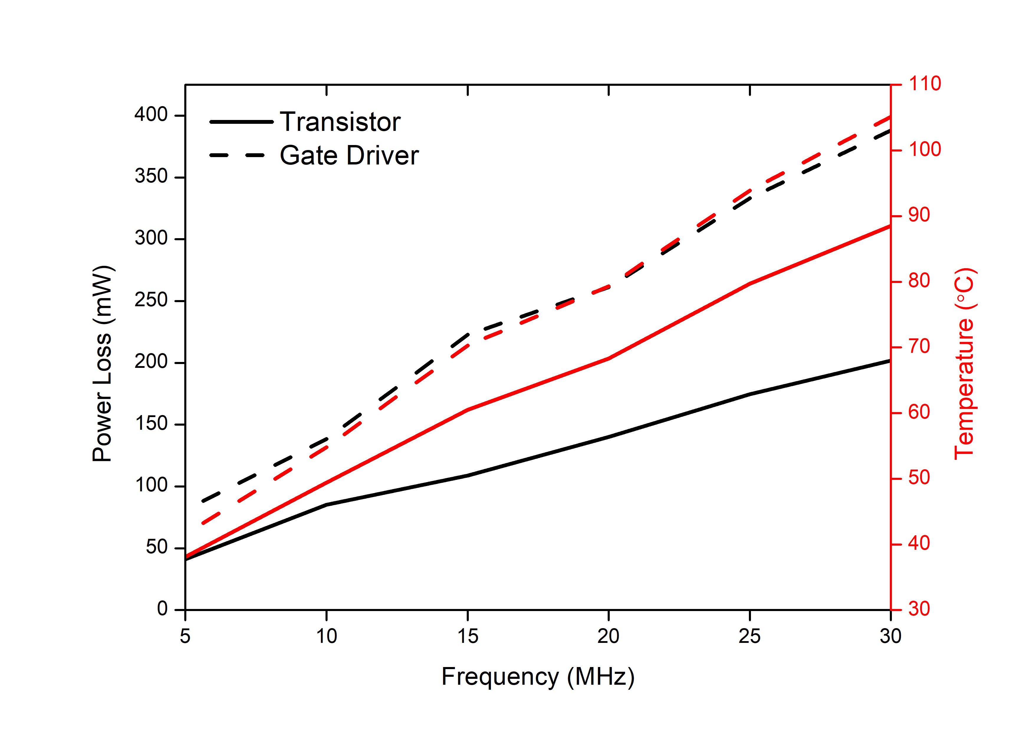
Thesis/Presentation/Ch2_GateLossvsFreq.jpg
