furkankarakaya/GaN-Studies/Thesis/Presentation/Ch2_Thermal Network.jpg

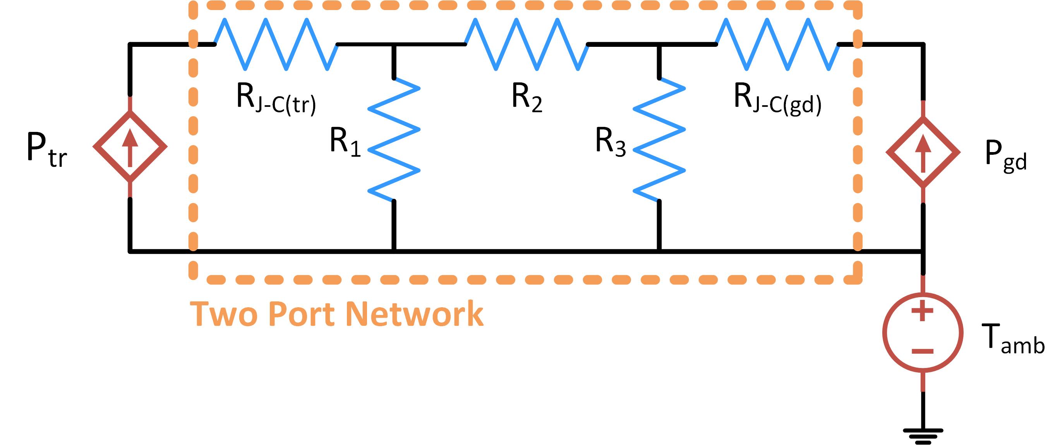
Thesis/Presentation/Ch2_Thermal Network.jpg
