furkankarakaya/GaN-Studies/Thesis/Presentation/Ch2_ThermalCamera.jpg

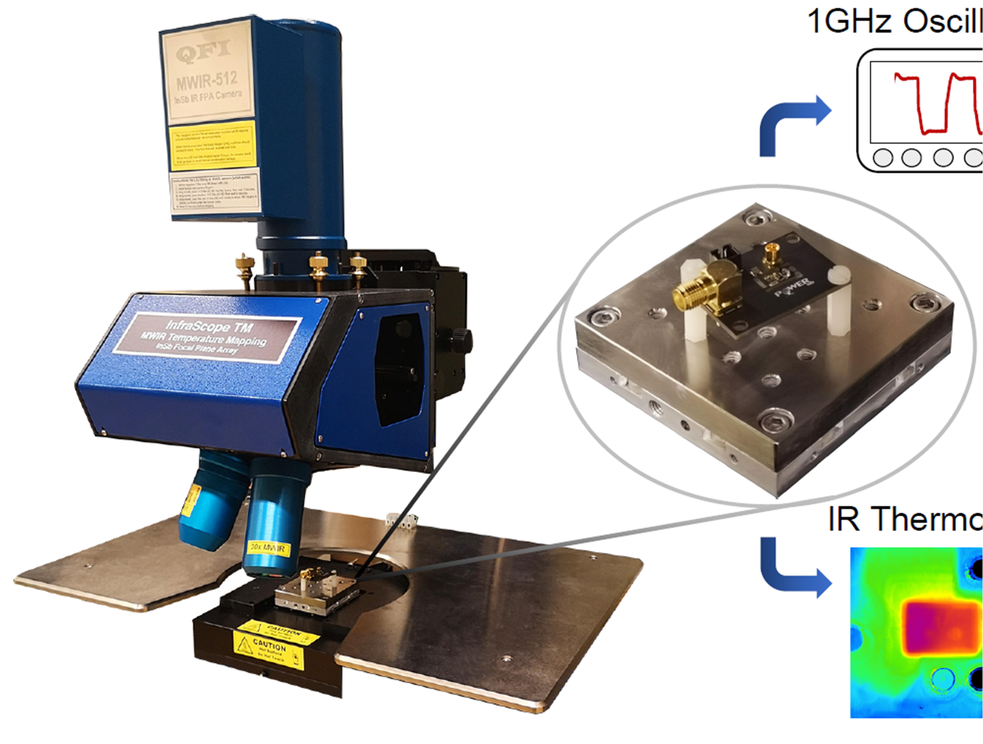
Thesis/Presentation/Ch2_ThermalCamera.jpg
