furkankarakaya/GaN-Studies/Thesis/Presentation/Ch2_TransistorLoss.jpg

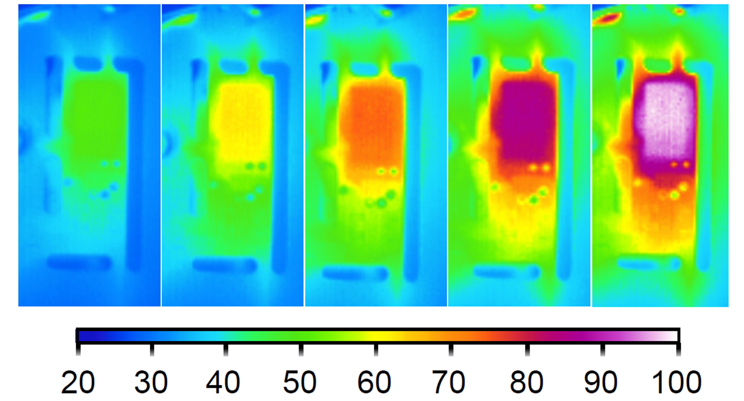
Thesis/Presentation/Ch2_TransistorLoss.jpg
