furkankarakaya/GaN-Studies/Thesis/Presentation/Ch2_VdsVgsCoss.jpg

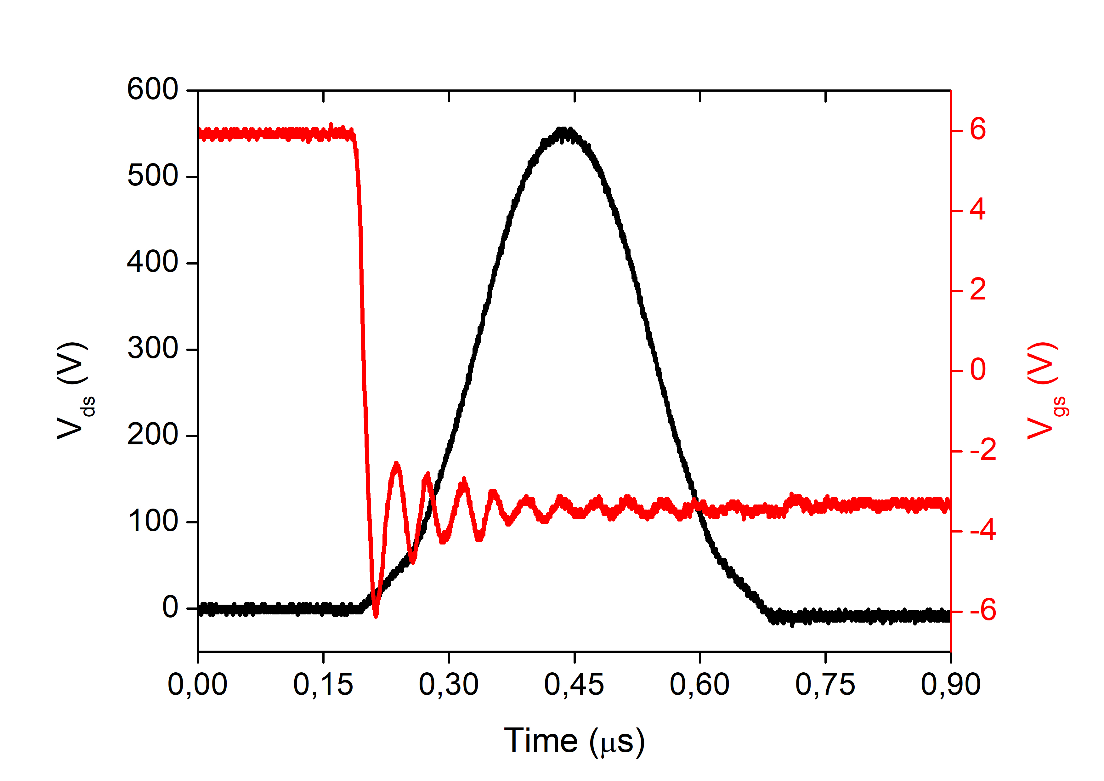
Thesis/Presentation/Ch2_VdsVgsCoss.jpg
