furkankarakaya/GaN-Studies/Thesis/Presentation/Ch3_DPT Circuit.jpg

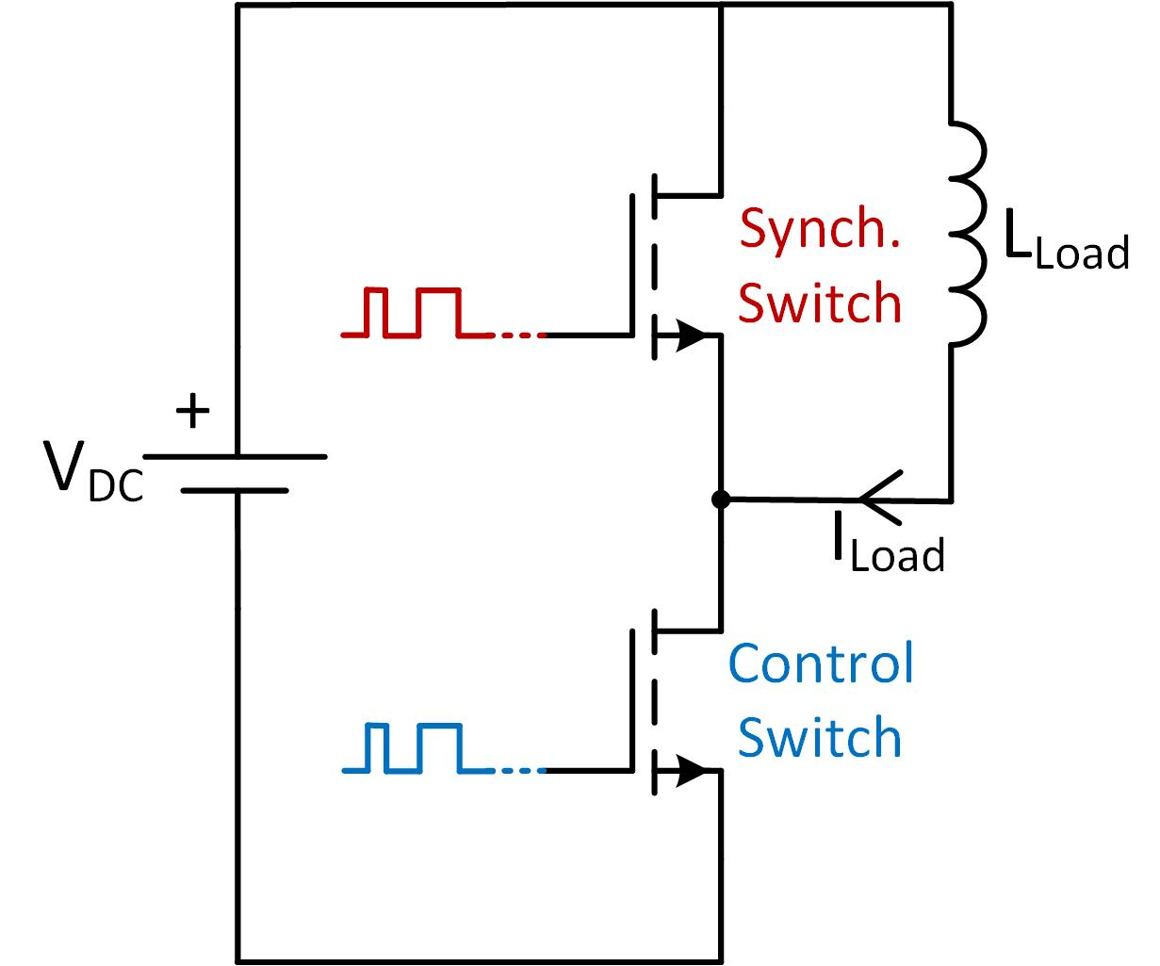
Thesis/Presentation/Ch3_DPT Circuit.jpg
