furkankarakaya/GaN-Studies/Thesis/Presentation/Ch3_Model1_BON.jpg

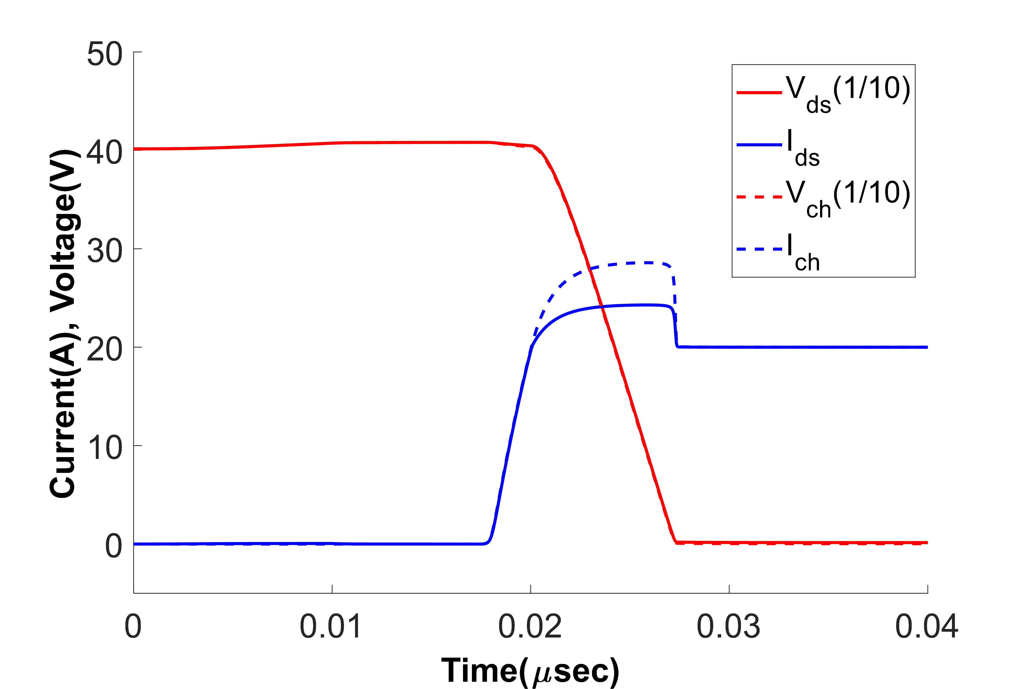
Thesis/Presentation/Ch3_Model1_BON.jpg
