furkankarakaya/GaN-Studies/Thesis/Presentation/Ch3_Model2_BON.jpg

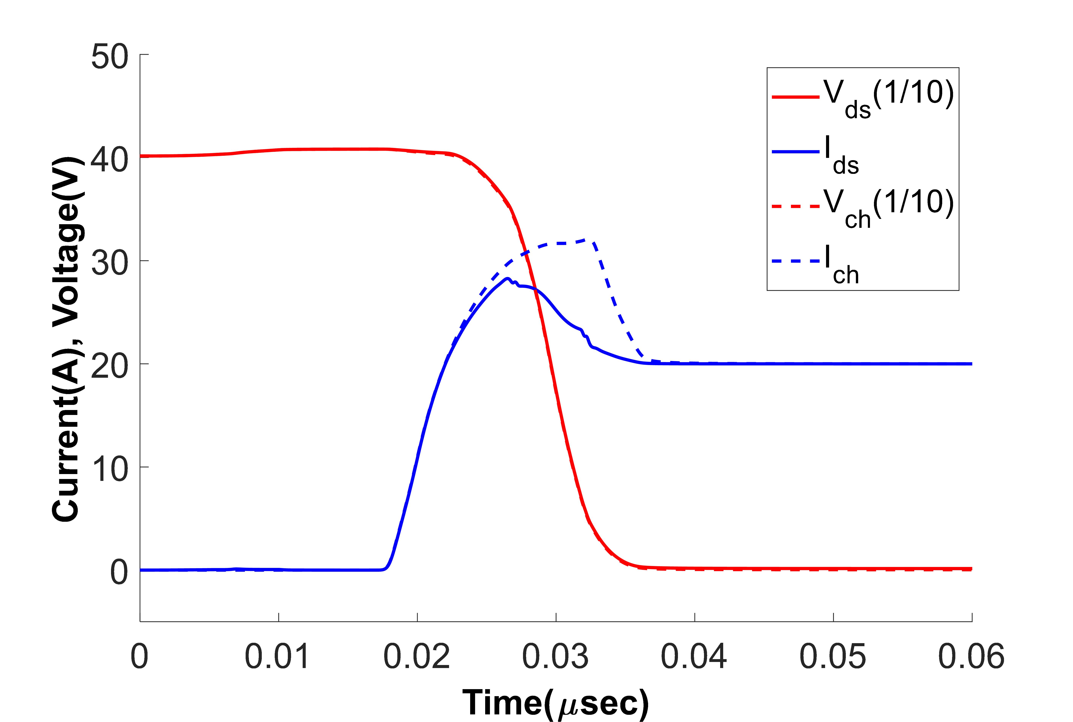
Thesis/Presentation/Ch3_Model2_BON.jpg
