furkankarakaya/GaN-Studies/Thesis/Presentation/Ch3_Model3_BON.jpg

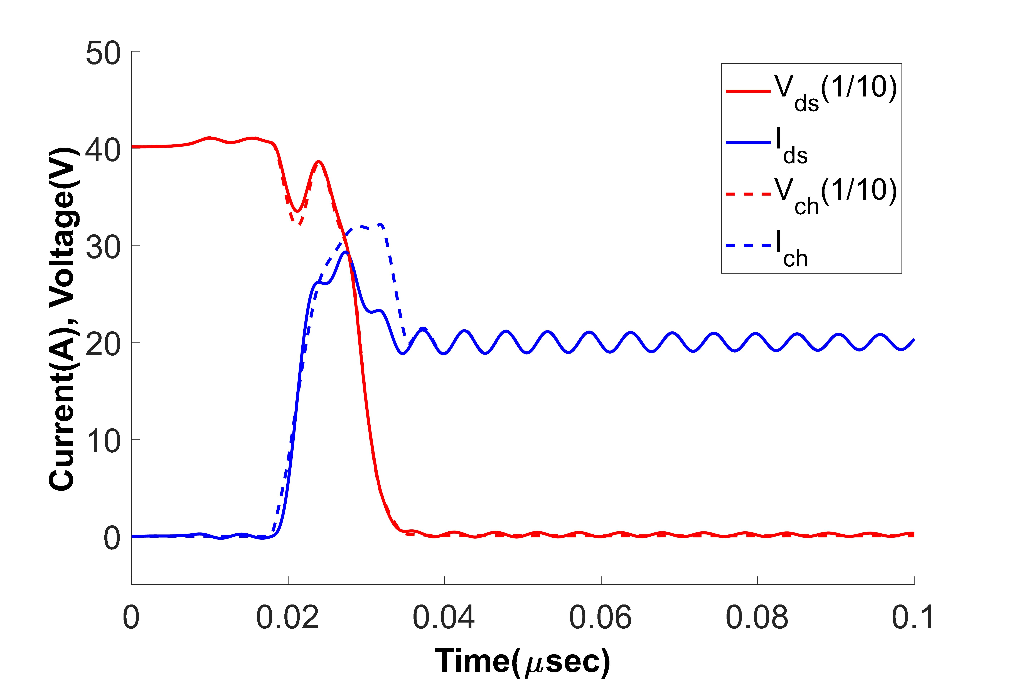
Thesis/Presentation/Ch3_Model3_BON.jpg
