furkankarakaya/GaN-Studies/Thesis/Presentation/Ch3_R_BOFF.jpg

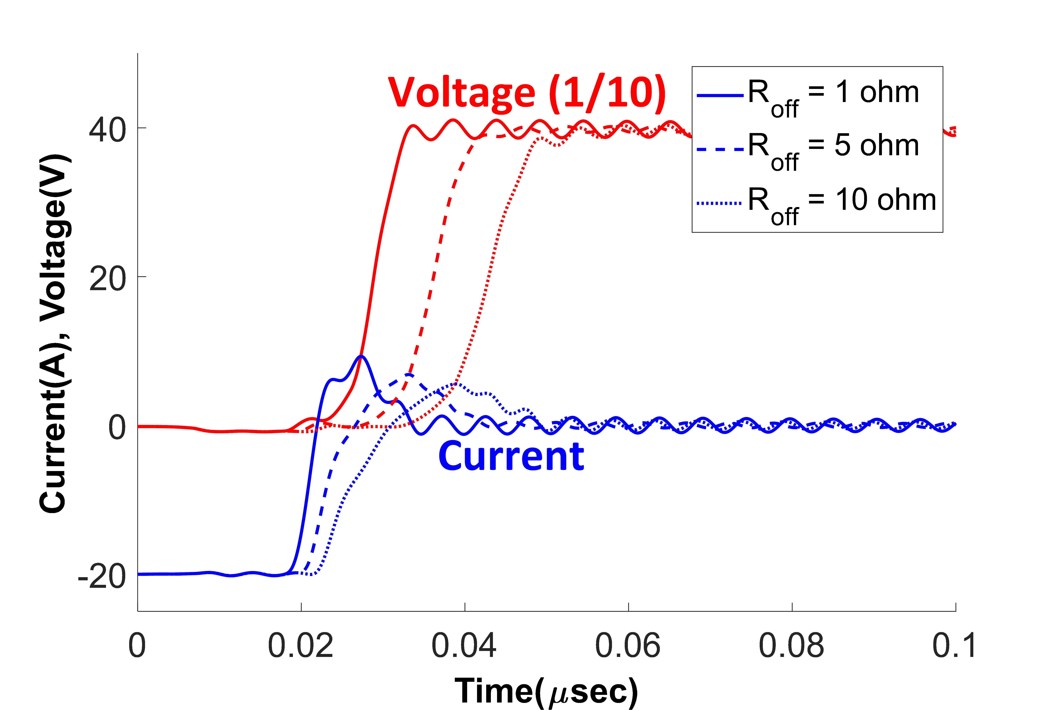
Thesis/Presentation/Ch3_R_BOFF.jpg
