furkankarakaya/GaN-Studies/Thesis/Presentation/Ch3_R_BON.jpg

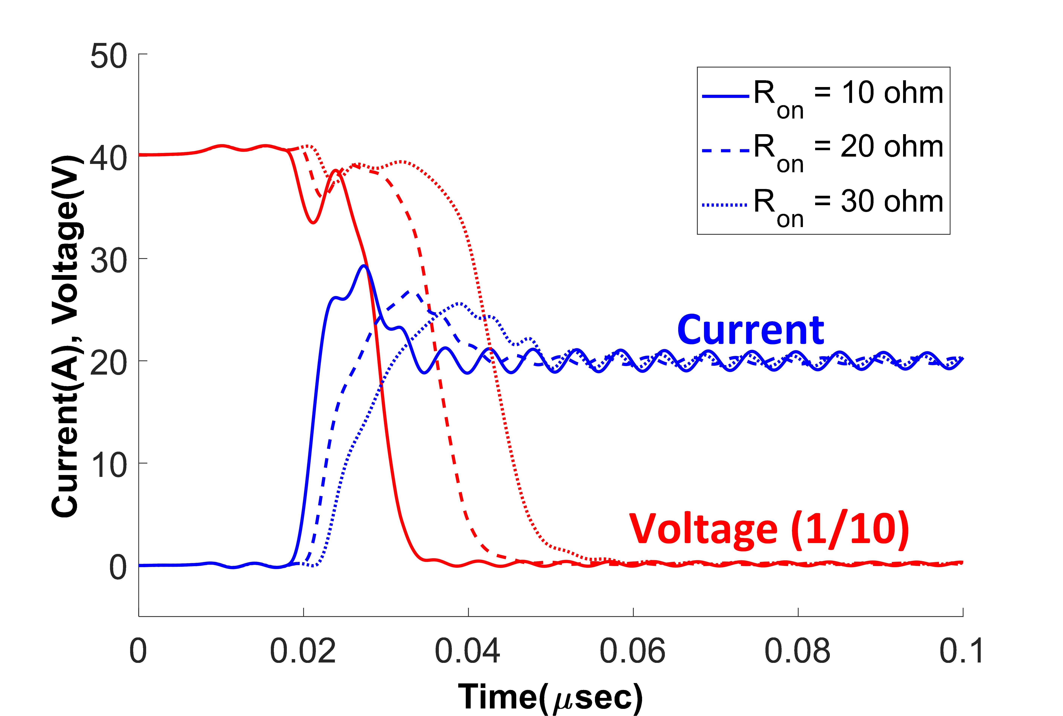
Thesis/Presentation/Ch3_R_BON.jpg
