furkankarakaya/GaN-Studies/Thesis/Presentation/Ch3_R_TOFF.jpg

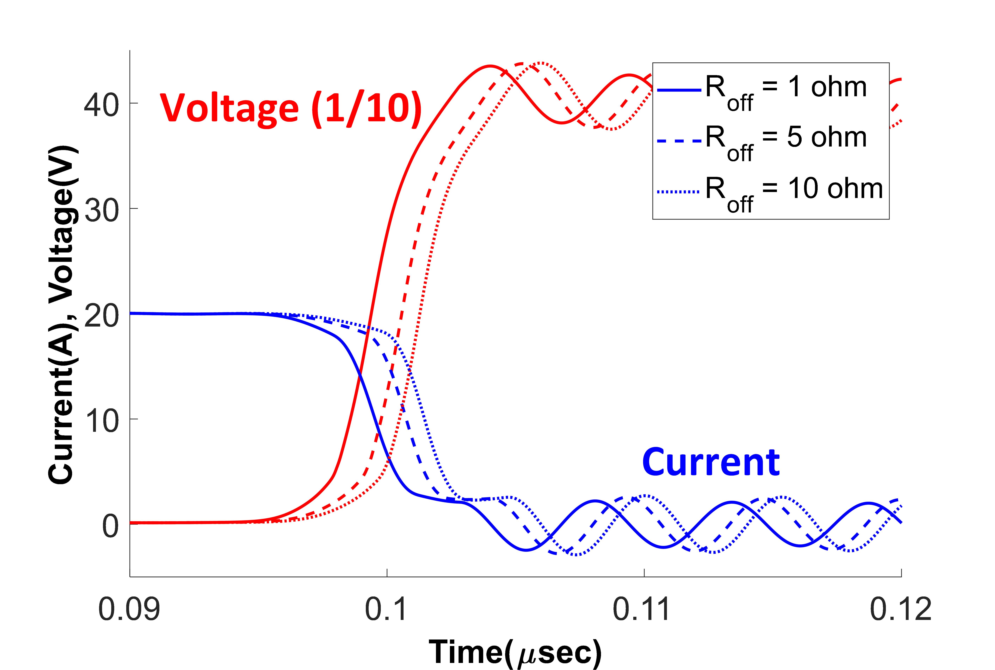
Thesis/Presentation/Ch3_R_TOFF.jpg
