furkankarakaya/GaN-Studies/Thesis/Presentation/Ch3_R_TON.jpg

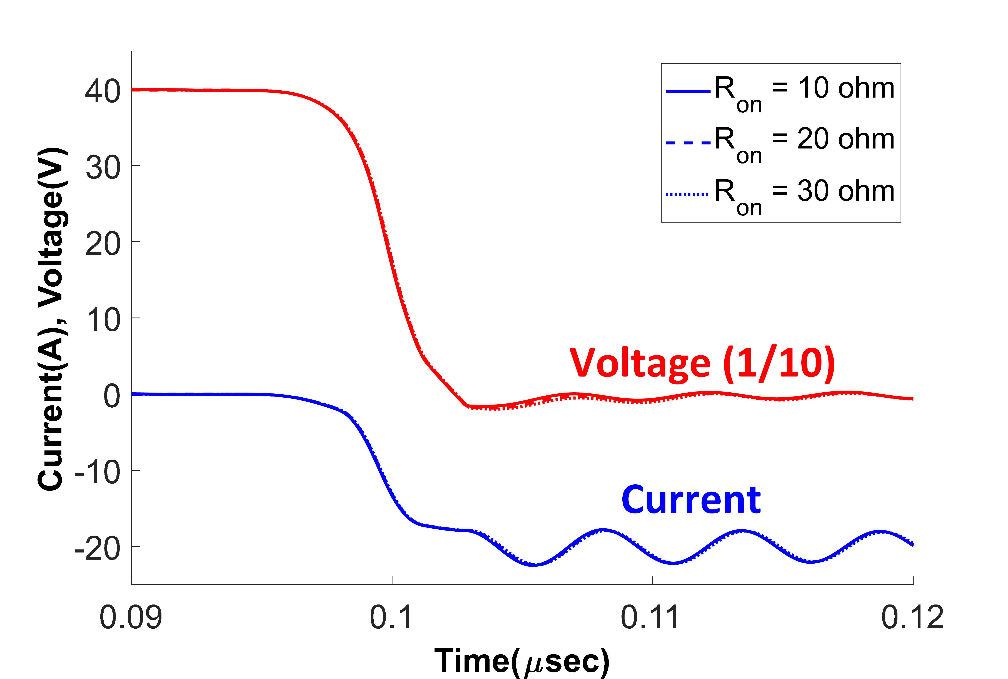
Thesis/Presentation/Ch3_R_TON.jpg
