furkankarakaya/GaN-Studies/Thesis/Presentation/Ch4_CircuitSchematic.jpg

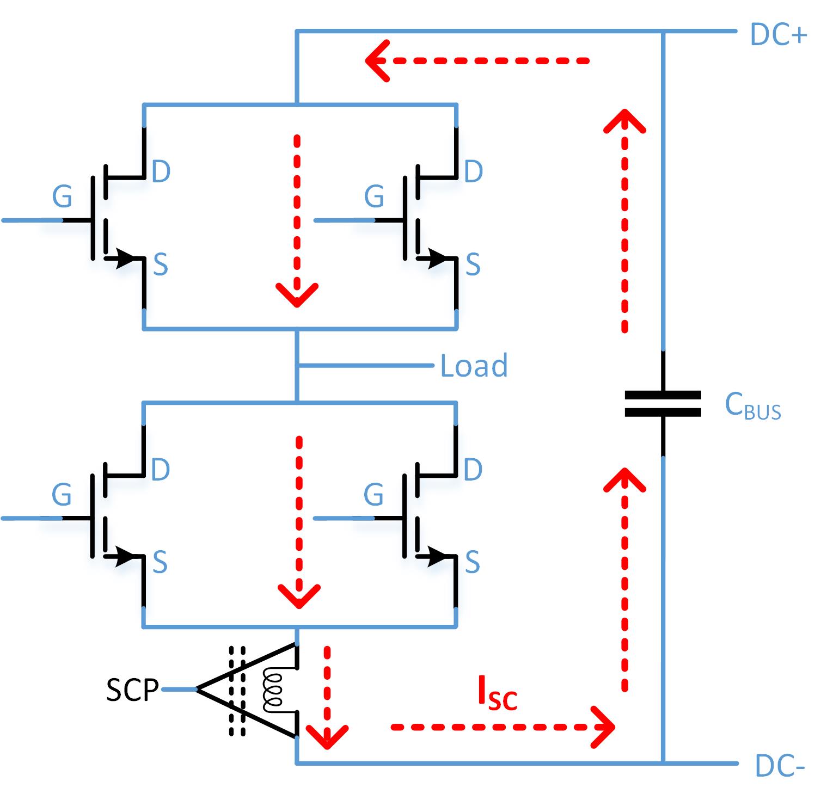
Thesis/Presentation/Ch4_CircuitSchematic.jpg
