furkankarakaya/GaN-Studies/Thesis/Presentation/Ch4_DPT400.jpg

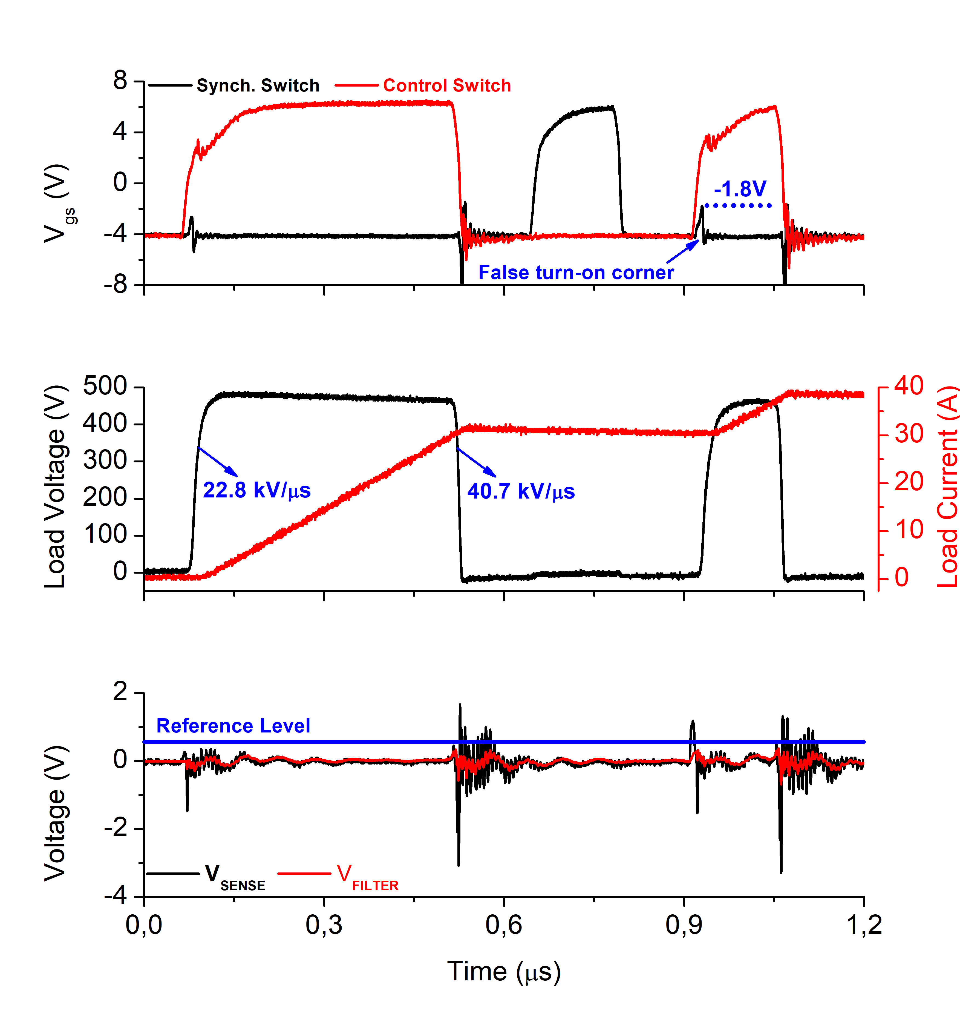
Thesis/Presentation/Ch4_DPT400.jpg
