furkankarakaya/GaN-Studies/Thesis/Presentation/Ch4_DPTvsSCPSimFFT.jpg

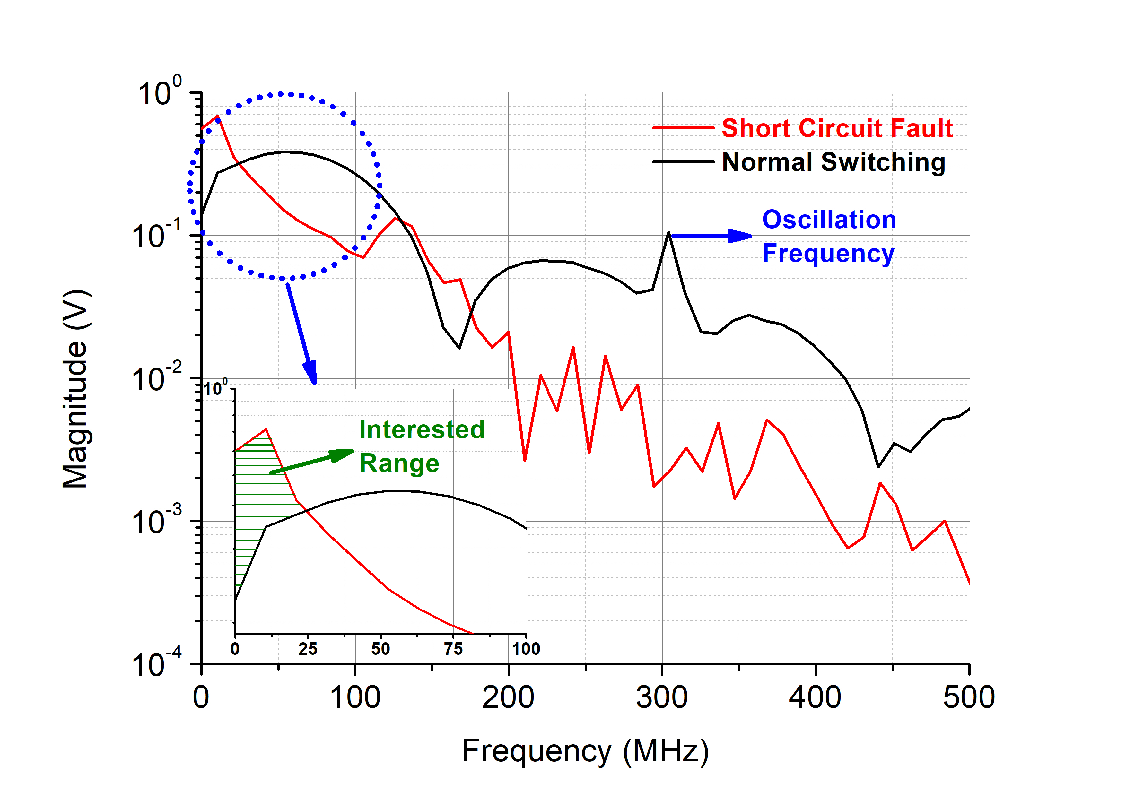
Thesis/Presentation/Ch4_DPTvsSCPSimFFT.jpg
