furkankarakaya/GaN-Studies/Thesis/Presentation/Ch4_DPTvsSCPWaveformSim.jpg

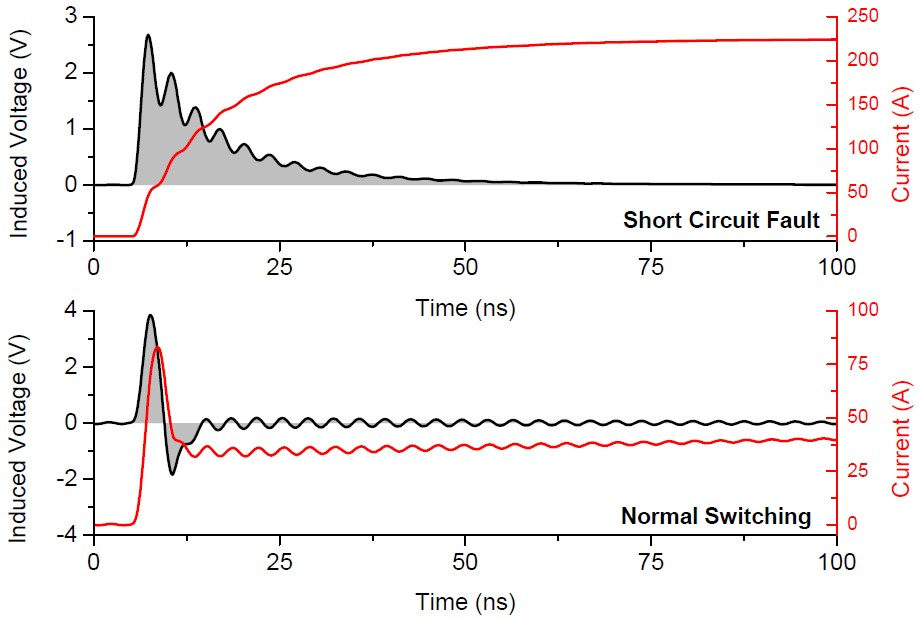
Thesis/Presentation/Ch4_DPTvsSCPWaveformSim.jpg
