furkankarakaya/GaN-Studies/Thesis/Presentation/Ch4_GateLoop.jpg

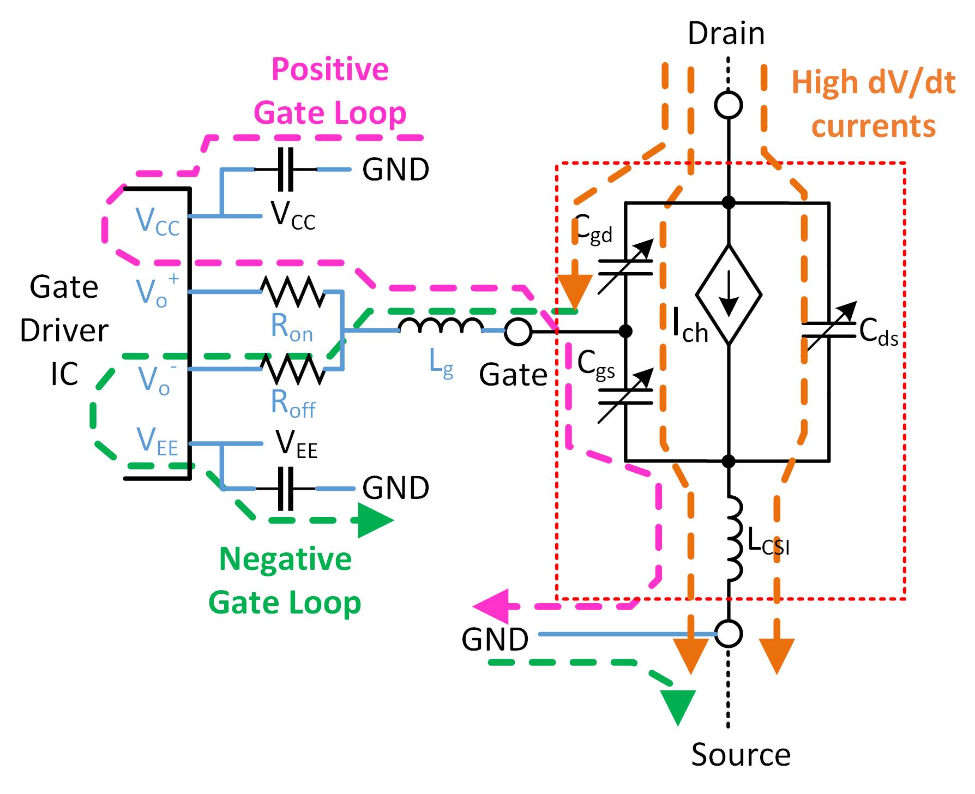
Thesis/Presentation/Ch4_GateLoop.jpg
