furkankarakaya/GaN-Studies/Thesis/Presentation/Ch4_GateLoopPCB.jpg

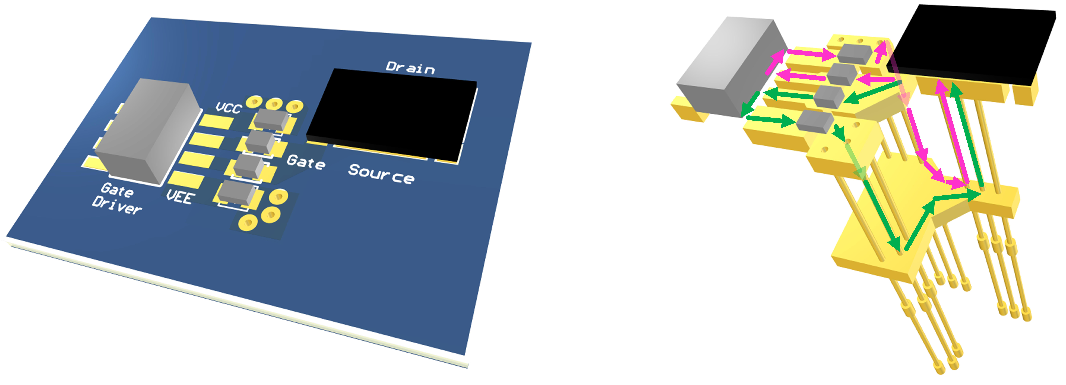
Thesis/Presentation/Ch4_GateLoopPCB.jpg
