furkankarakaya/GaN-Studies/Thesis/Presentation/Ch4_HalfBridgeSch.jpg

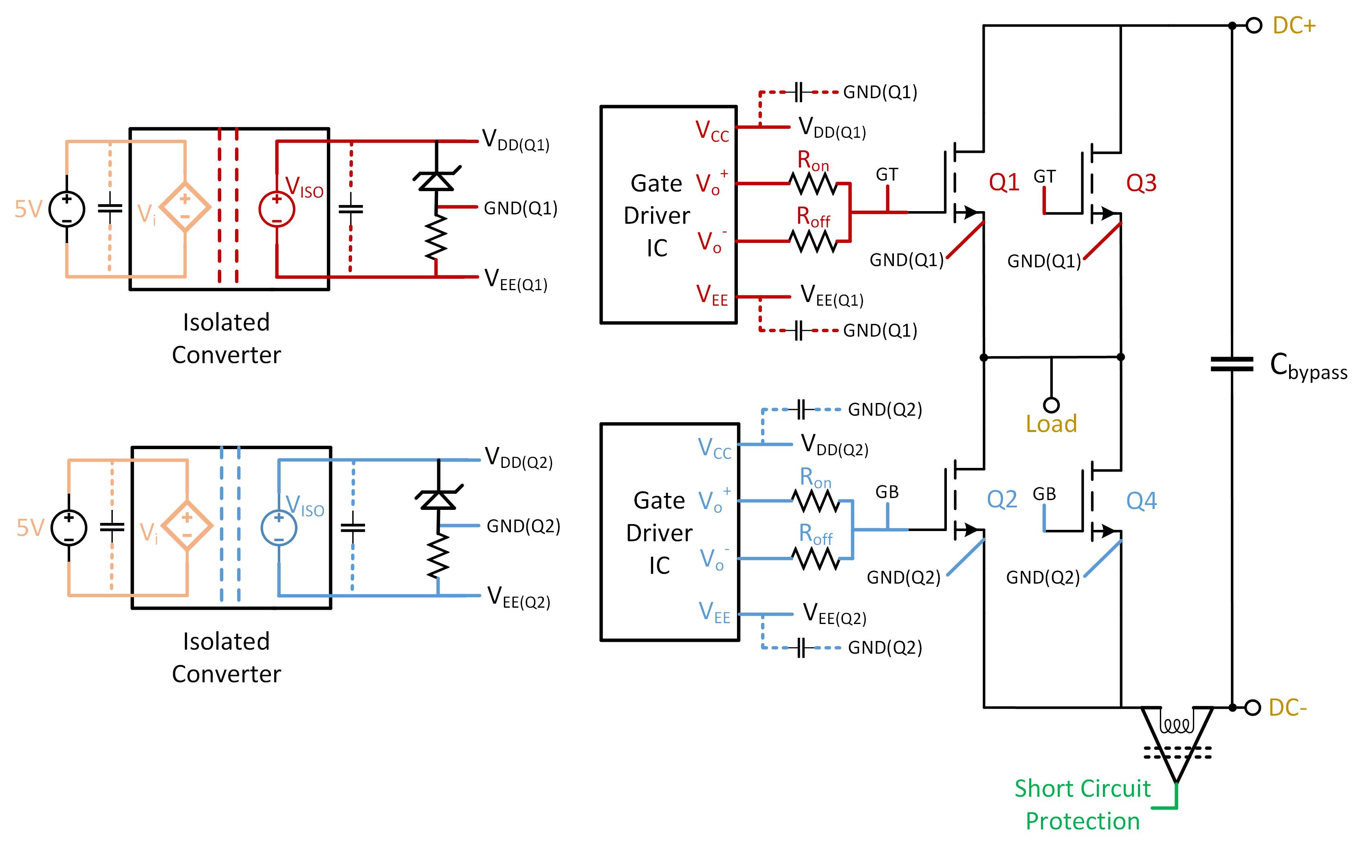
Thesis/Presentation/Ch4_HalfBridgeSch.jpg
