furkankarakaya/GaN-Studies/Thesis/Presentation/Ch4_ParallelGateDriver.jpg

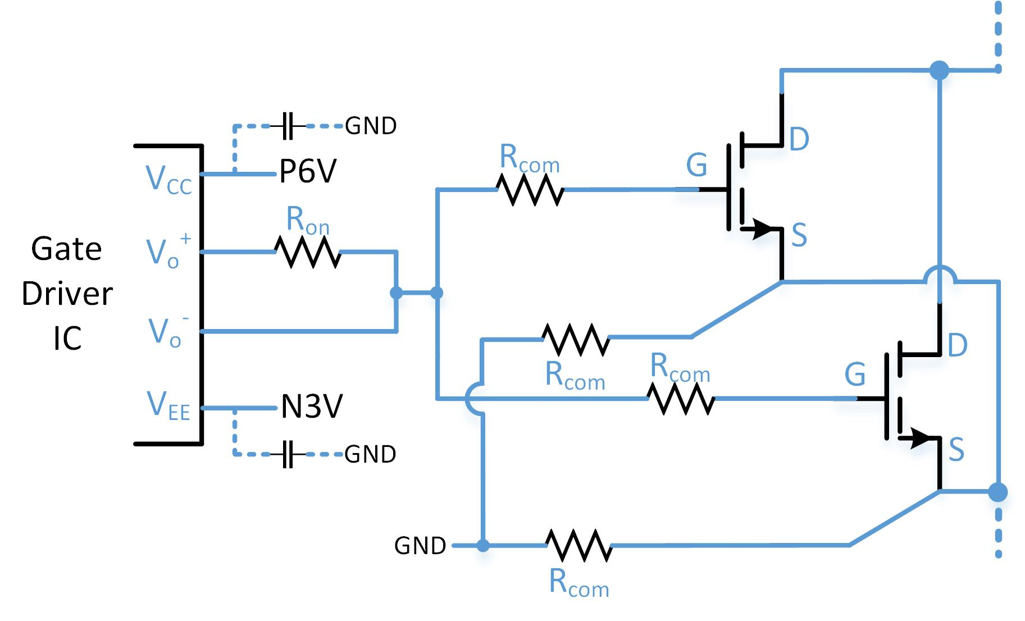
Thesis/Presentation/Ch4_ParallelGateDriver.jpg
