furkankarakaya/GaN-Studies/Thesis/Presentation/Ch4_ParallelGateDriverNotDistr.jpg

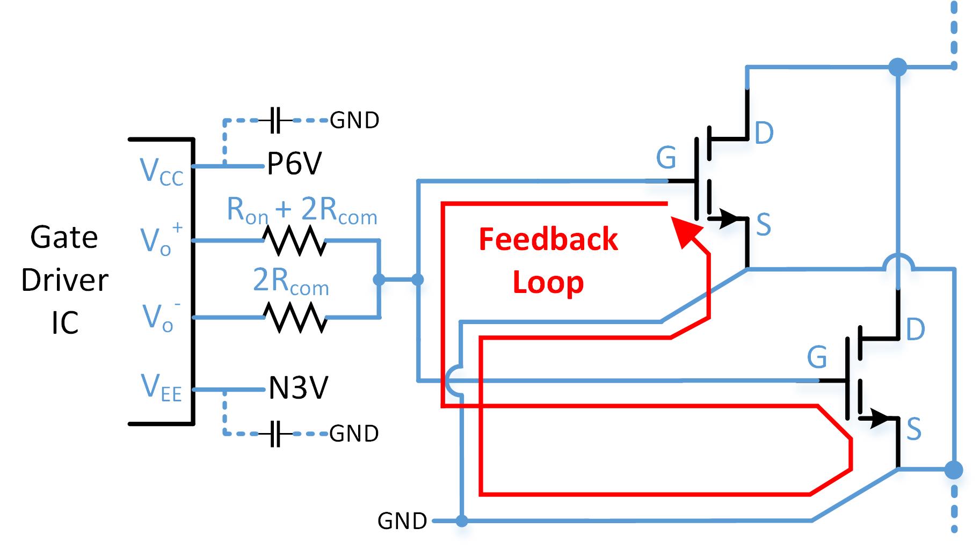
Thesis/Presentation/Ch4_ParallelGateDriverNotDistr.jpg
