furkankarakaya/GaN-Studies/Thesis/Presentation/Ch4_PCBFEA.jpg

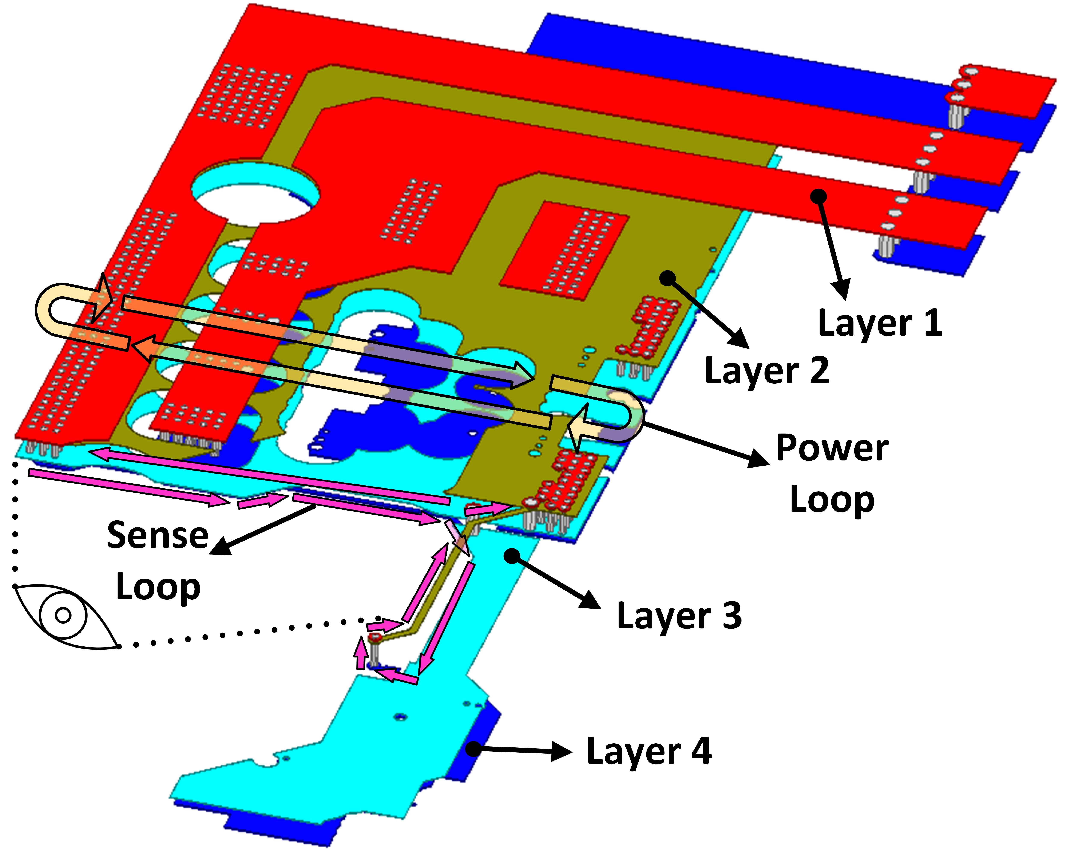
Thesis/Presentation/Ch4_PCBFEA.jpg
