furkankarakaya/GaN-Studies/Thesis/Presentation/Ch4_PowerLoop.jpg

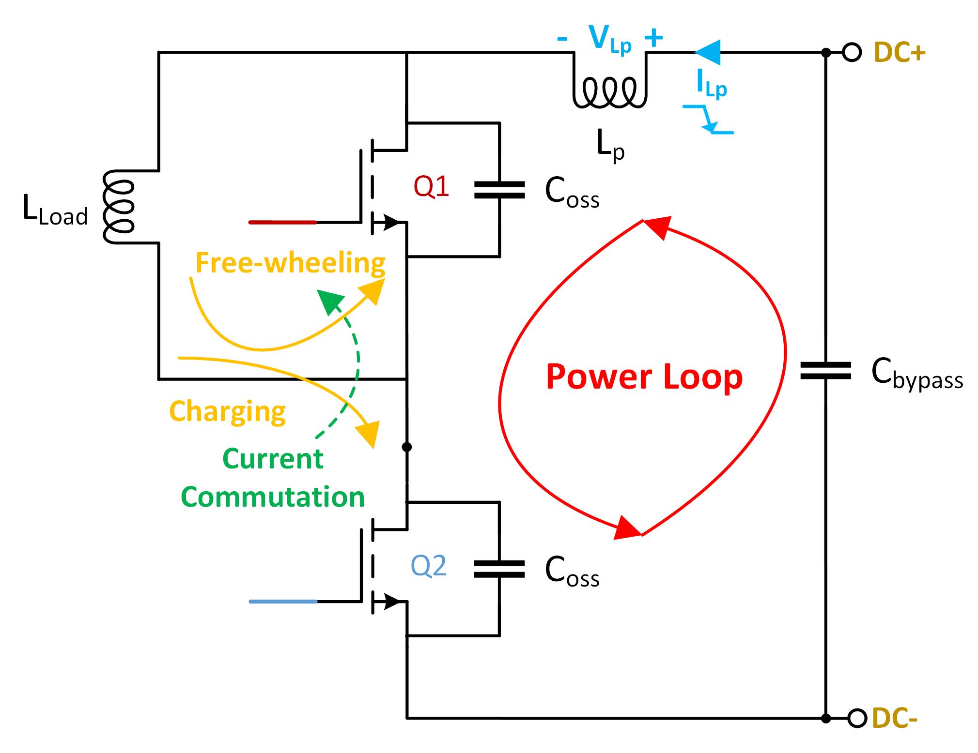
Thesis/Presentation/Ch4_PowerLoop.jpg
