furkankarakaya/GaN-Studies/Thesis/Presentation/Ch4_SCDynamics.jpg

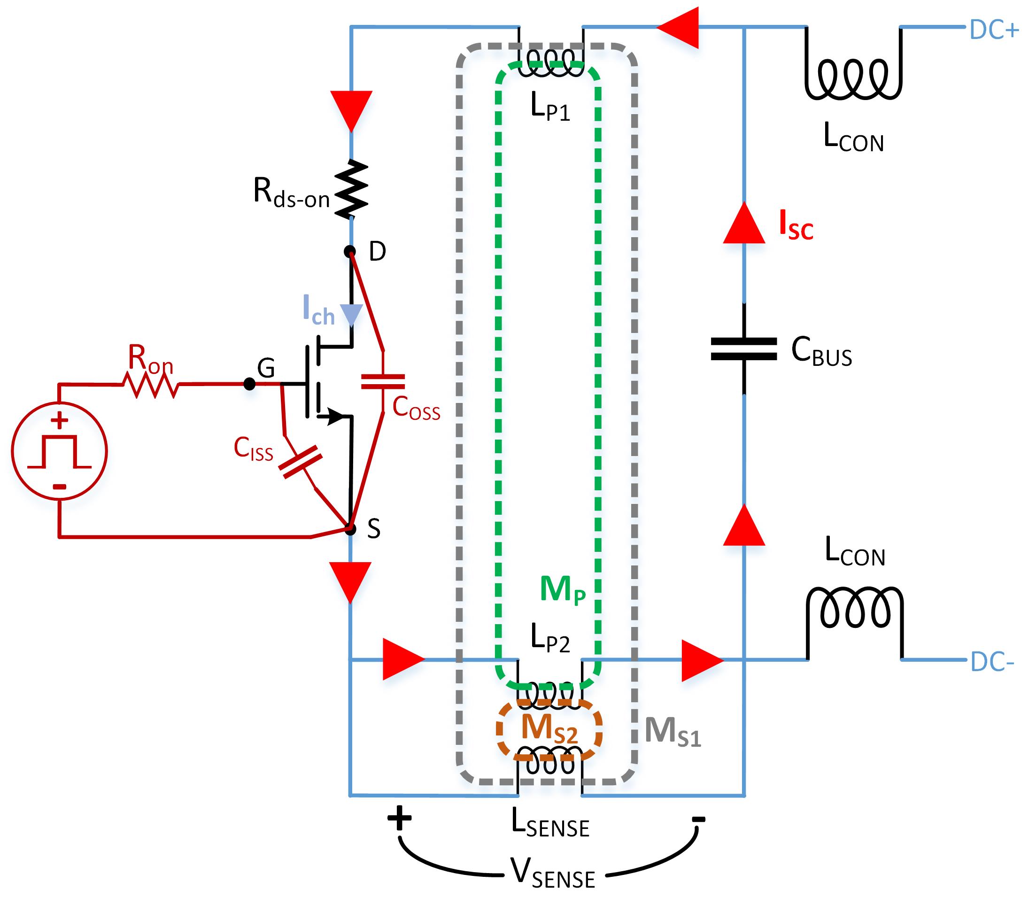
Thesis/Presentation/Ch4_SCDynamics.jpg
