furkankarakaya/GaN-Studies/Thesis/Presentation/Ch4_SCGateDriver.jpg

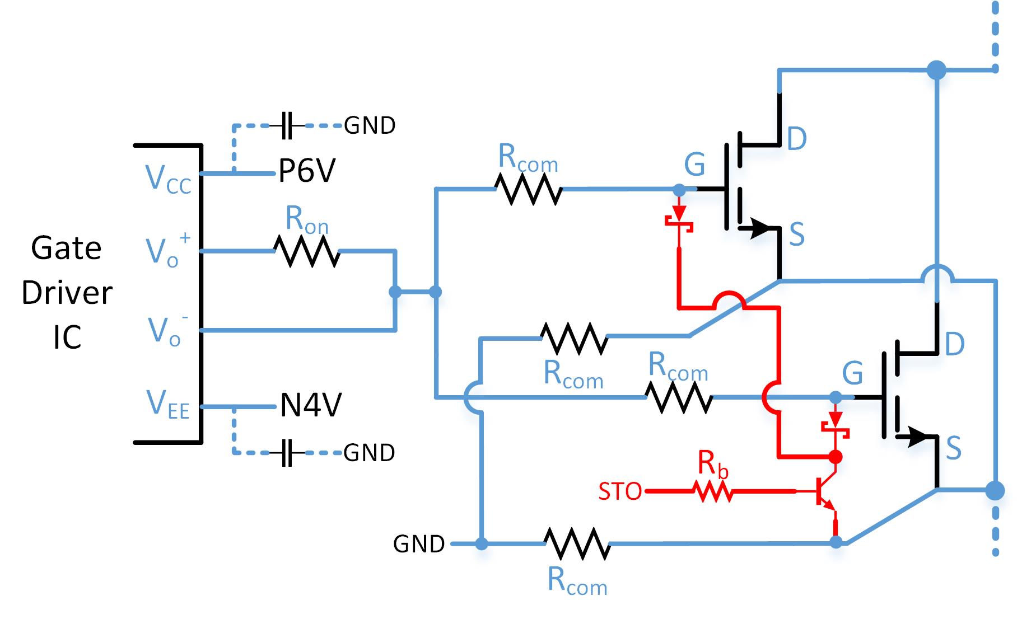
Thesis/Presentation/Ch4_SCGateDriver.jpg
