furkankarakaya/GaN-Studies/Thesis/Presentation/Ch4_SCTiming.jpg

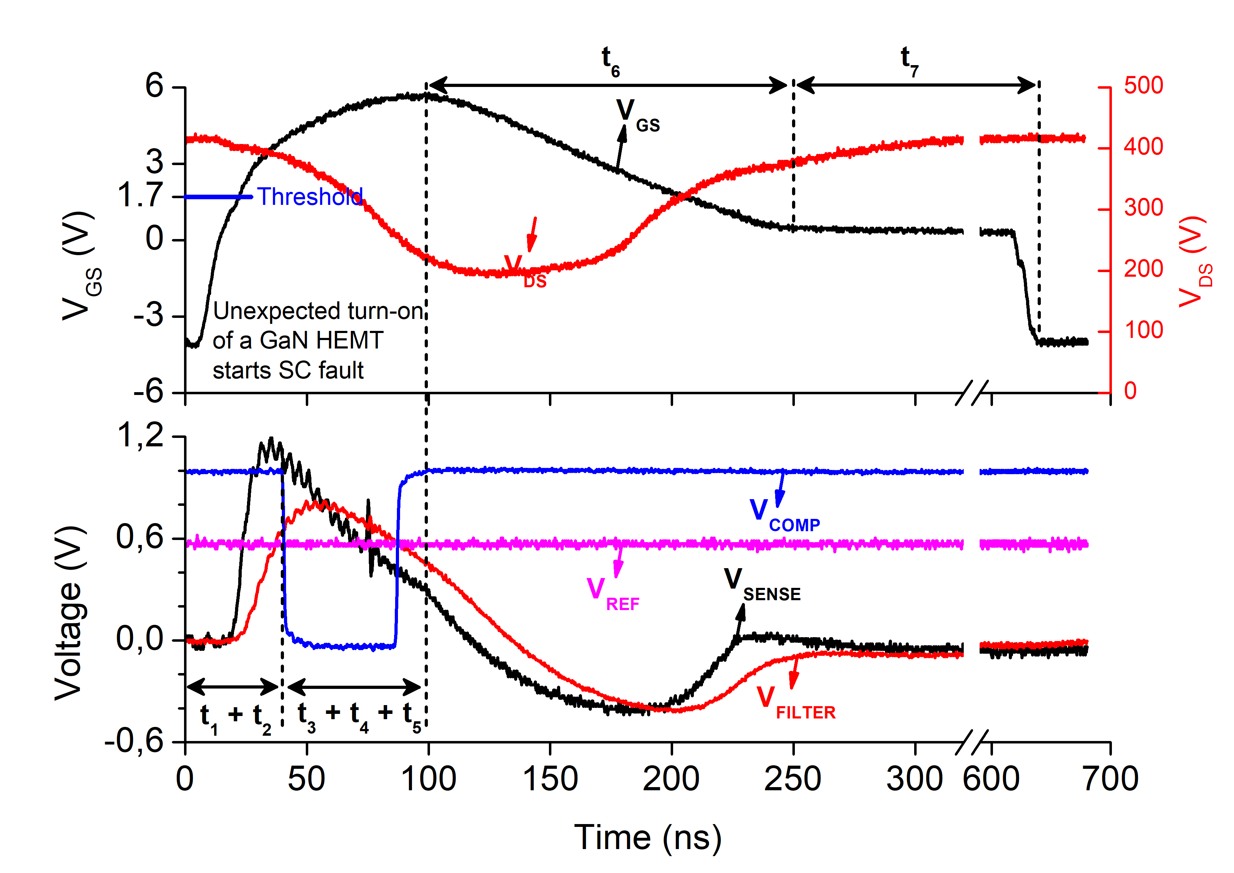
Thesis/Presentation/Ch4_SCTiming.jpg
