furkankarakaya/GaN-Studies/Thesis/Presentation/Ch4_SenseOptions.jpg

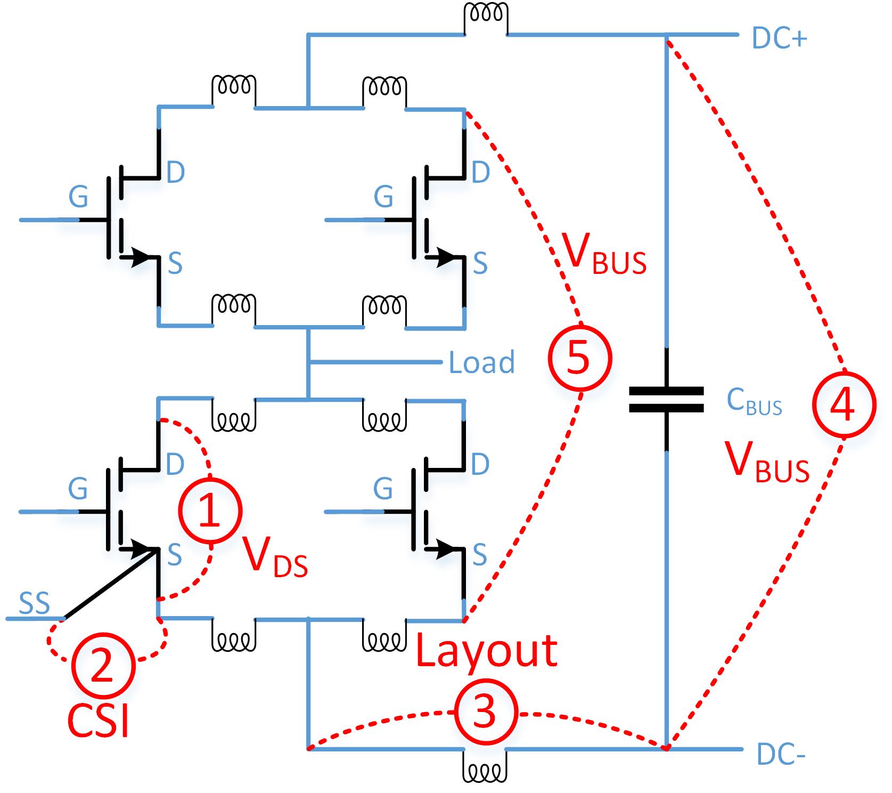
Thesis/Presentation/Ch4_SenseOptions.jpg
