furkankarakaya/GaN-Studies/Thesis/Presentation/Ch4_SignalProcessingBlock.jpg

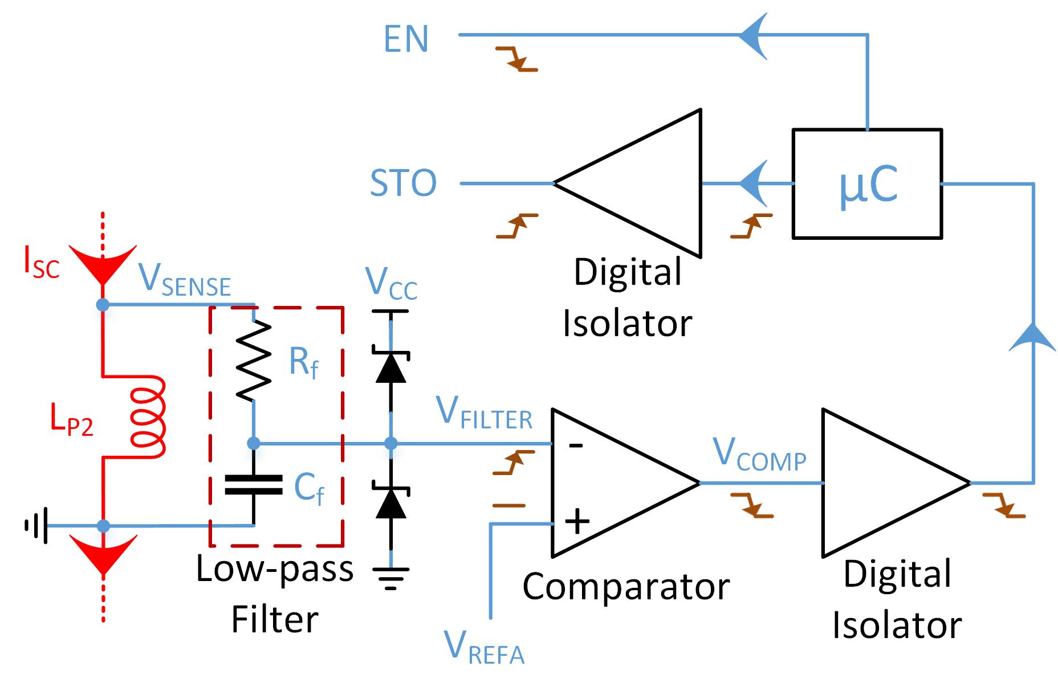
Thesis/Presentation/Ch4_SignalProcessingBlock.jpg
