furkankarakaya/GaN-Studies/Thesis/Presentation/Ch4_SimTurnOFF.jpg

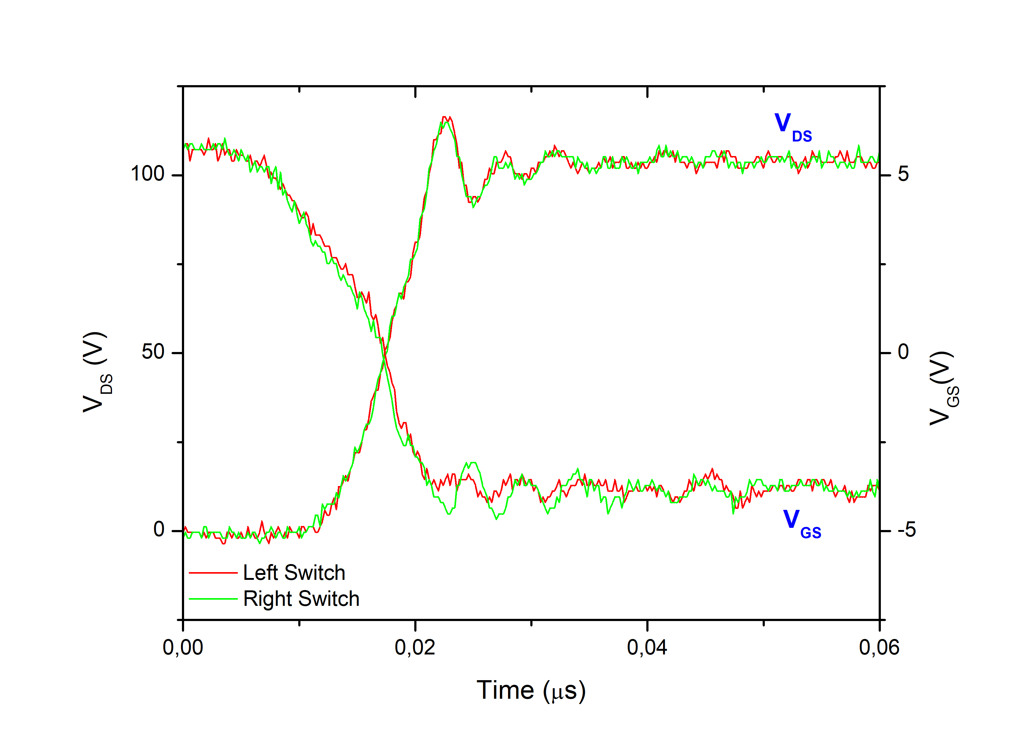
Thesis/Presentation/Ch4_SimTurnOFF.jpg
