furkankarakaya/GaN-Studies/Thesis/Presentation/Ch4_SimTurnOn.jpg

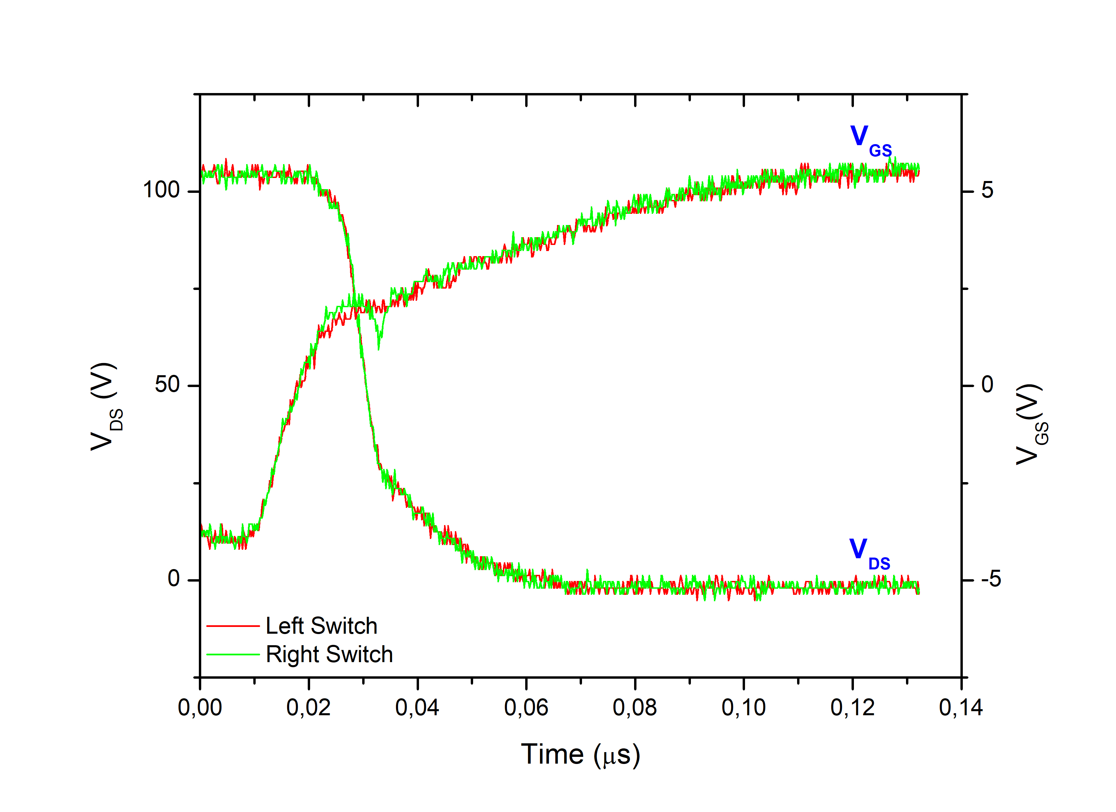
Thesis/Presentation/Ch4_SimTurnOn.jpg
