furkankarakaya/GaN-Studies/Thesis/Presentation/Ch4_STOvsHTO.jpg

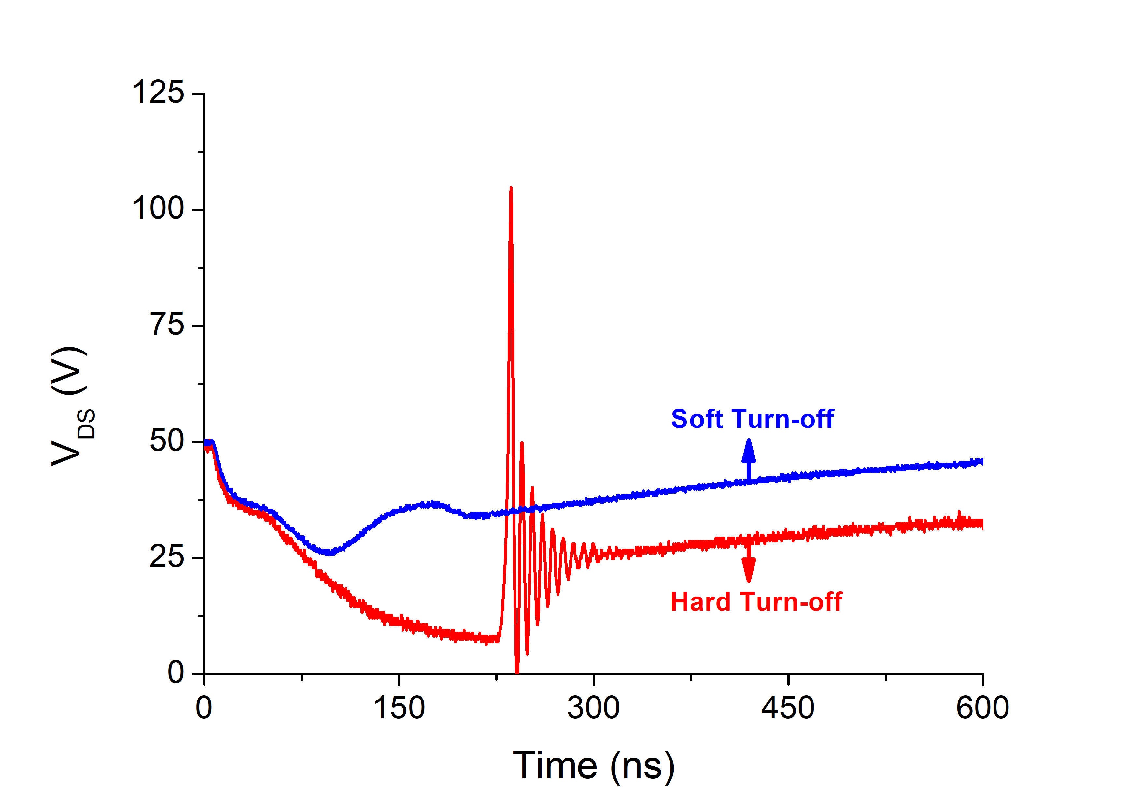
Thesis/Presentation/Ch4_STOvsHTO.jpg
