furkankarakaya/GaN-Studies/Thesis/Presentation/Ch5_ConstAverageVaryRipple.jpg

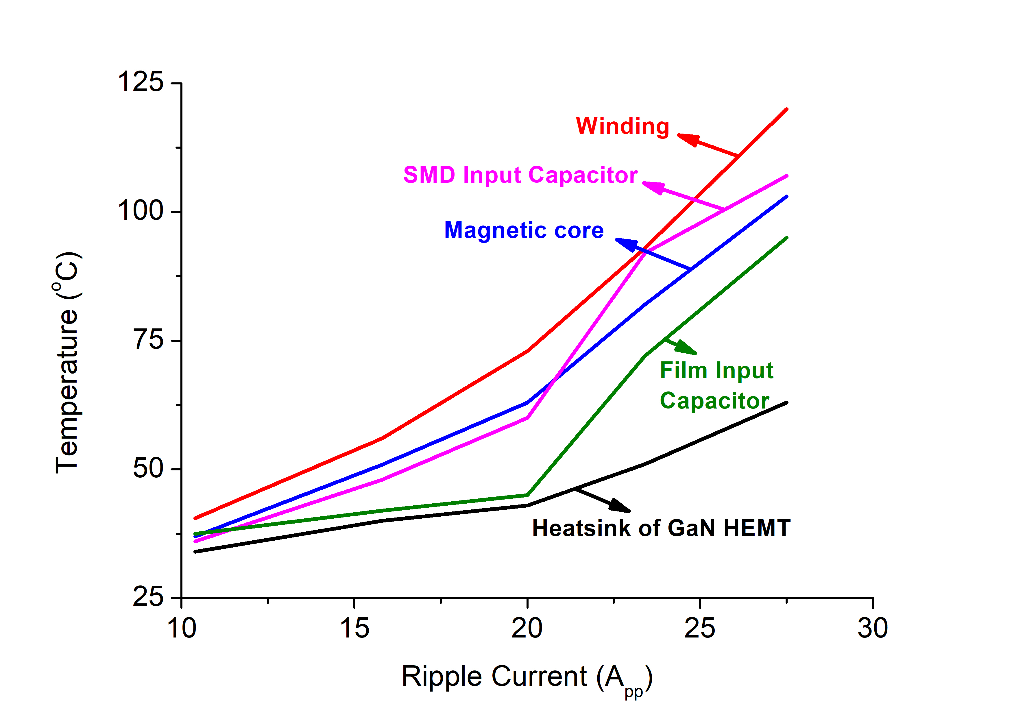
Thesis/Presentation/Ch5_ConstAverageVaryRipple.jpg
