furkankarakaya/GaN-Studies/Thesis/Presentation/Ch5_ConstRippleVaryAverage.jpg

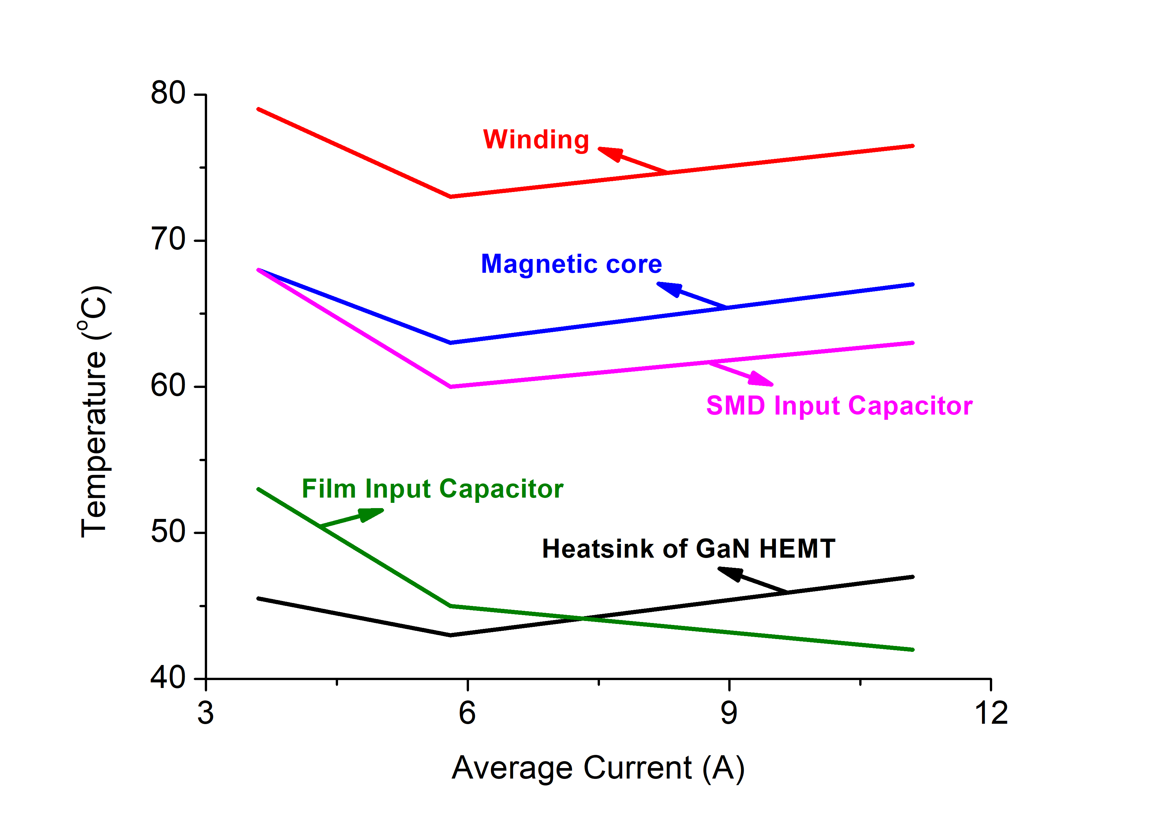
Thesis/Presentation/Ch5_ConstRippleVaryAverage.jpg
