furkankarakaya/GaN-Studies/Thesis/Presentation/Ch5_Converter3D.jpg

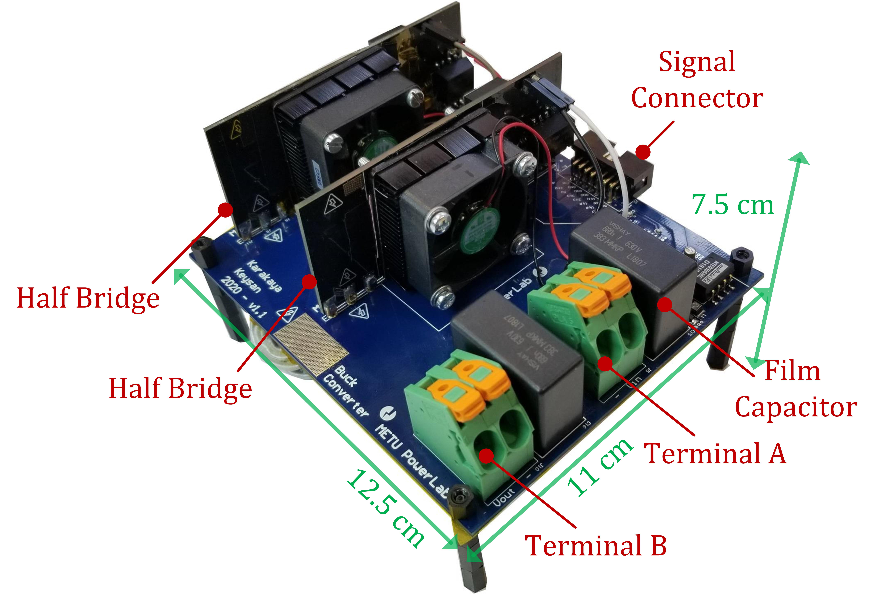
Thesis/Presentation/Ch5_Converter3D.jpg
