furkankarakaya/GaN-Studies/Thesis/Presentation/Ch5_ConverterComparison.jpg

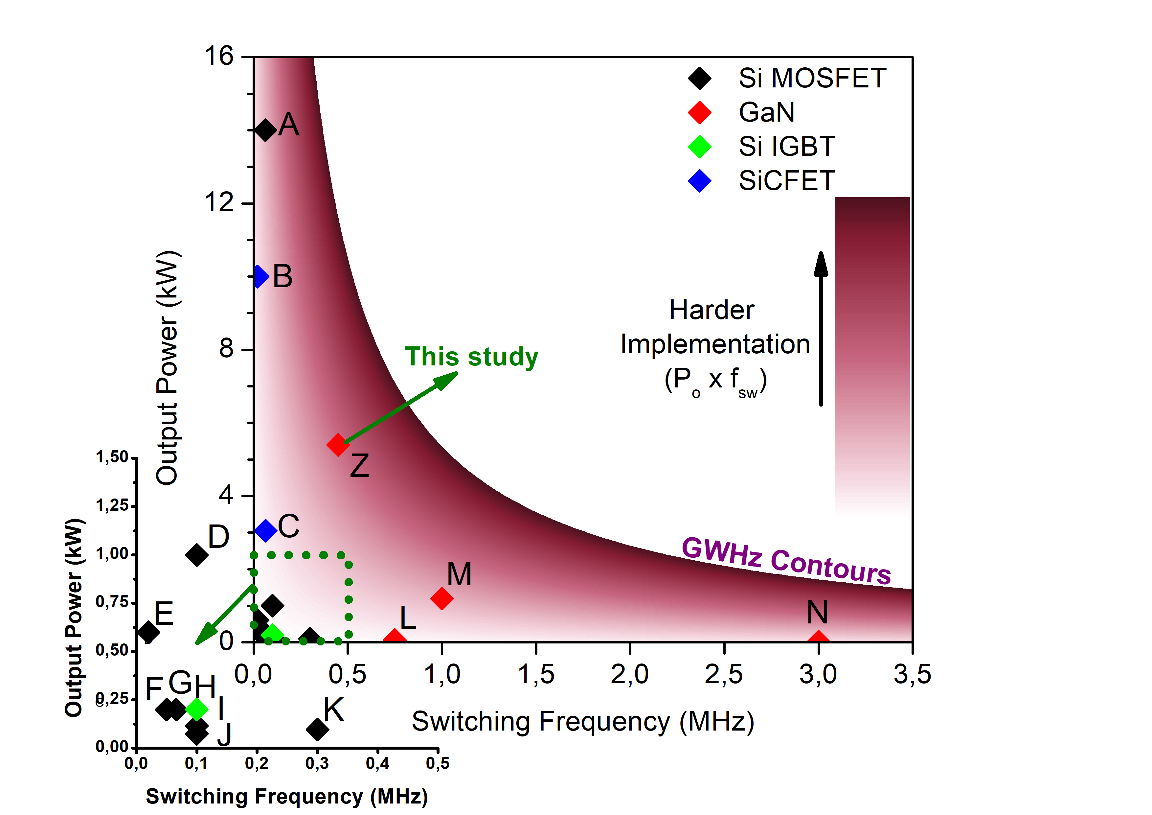
Thesis/Presentation/Ch5_ConverterComparison.jpg
