furkankarakaya/GaN-Studies/Thesis/Presentation/Ch5_ConverterScheme.jpg

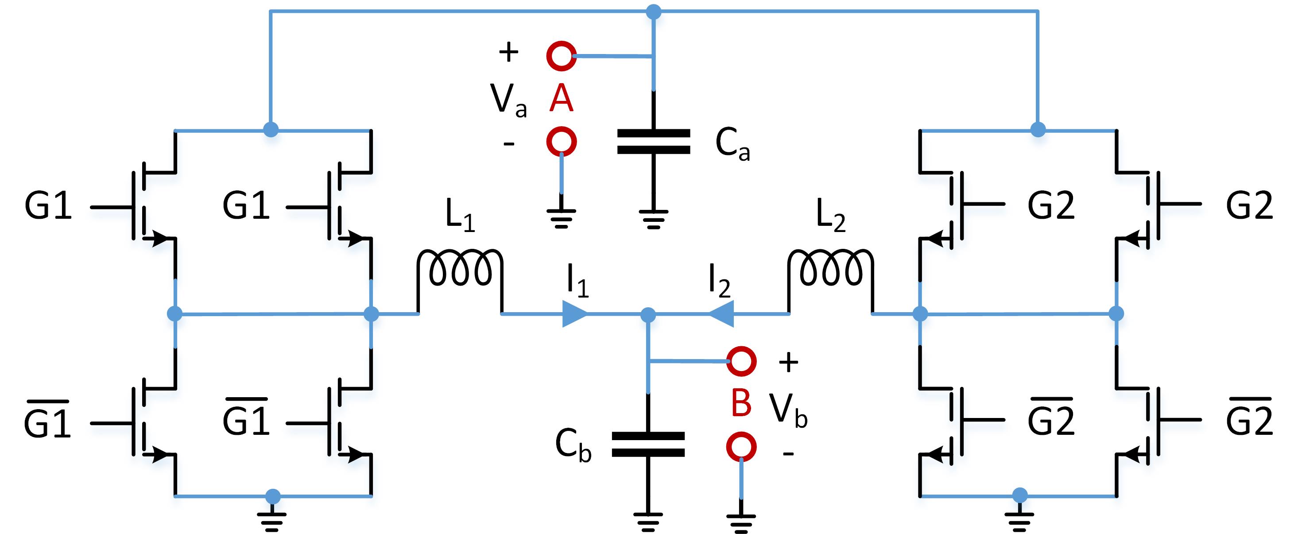
Thesis/Presentation/Ch5_ConverterScheme.jpg
