furkankarakaya/GaN-Studies/Thesis/Presentation/Ch5_InductorHeating.jpg

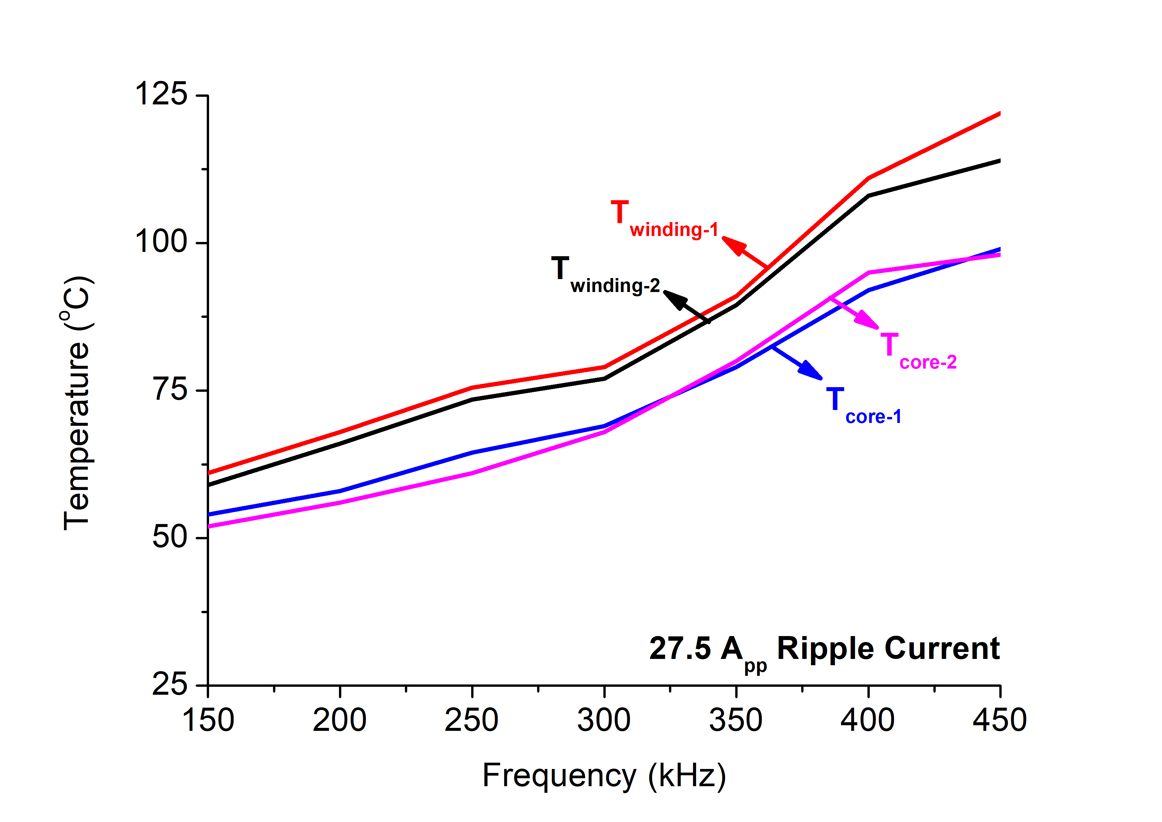
Thesis/Presentation/Ch5_InductorHeating.jpg
