furkankarakaya/GaN-Studies/Thesis/Presentation/Ch5_InductorLoss.jpg

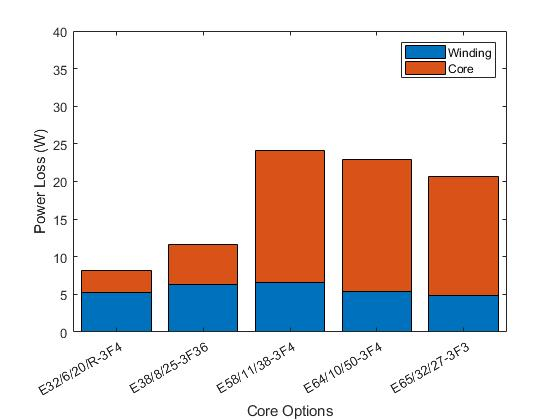
Thesis/Presentation/Ch5_InductorLoss.jpg
