furkankarakaya/GaN-Studies/Thesis/Presentation/Ch5_LogicDiagram.jpg

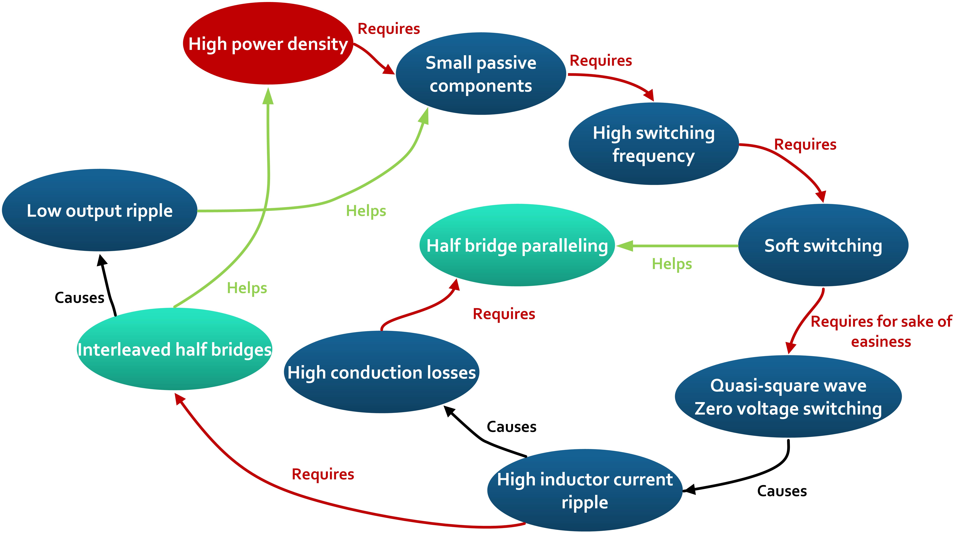
Thesis/Presentation/Ch5_LogicDiagram.jpg
