furkankarakaya/GaN-Studies/Thesis/Presentation/Ch5_SoftSwitchSim.jpg

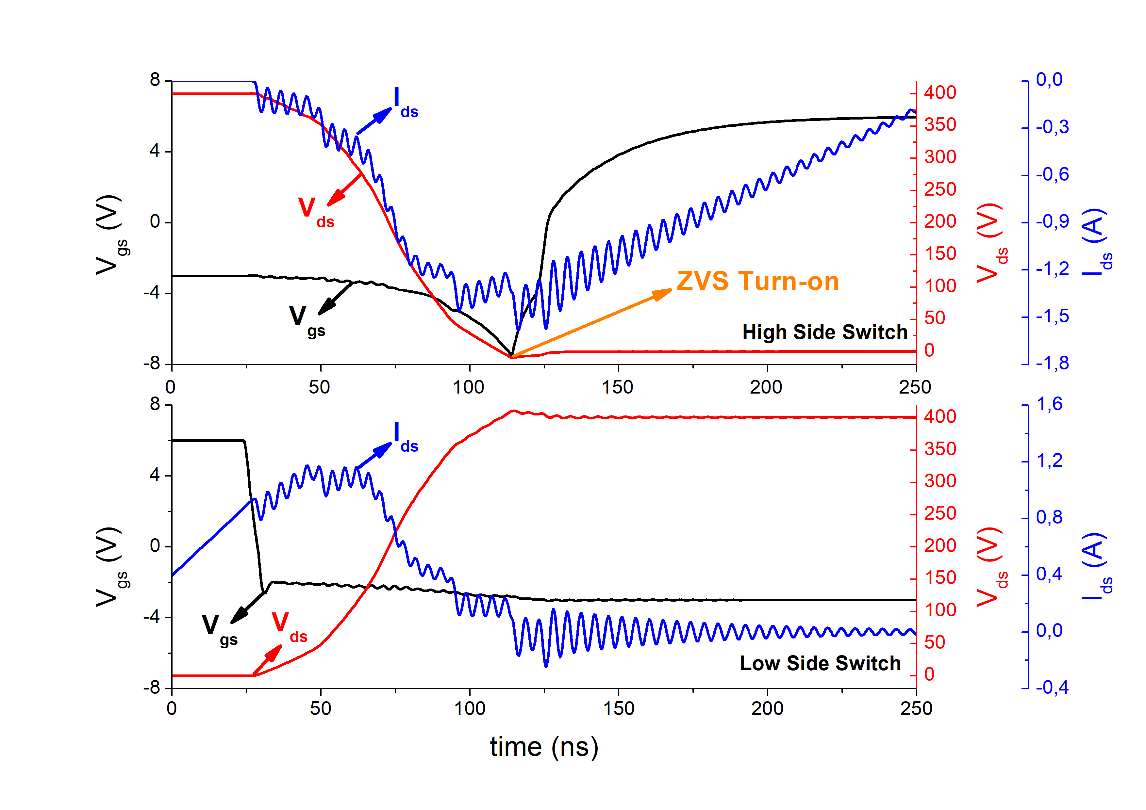
Thesis/Presentation/Ch5_SoftSwitchSim.jpg
