furkankarakaya/GaN-Studies/Thesis/Presentation/Converter3D.jpg

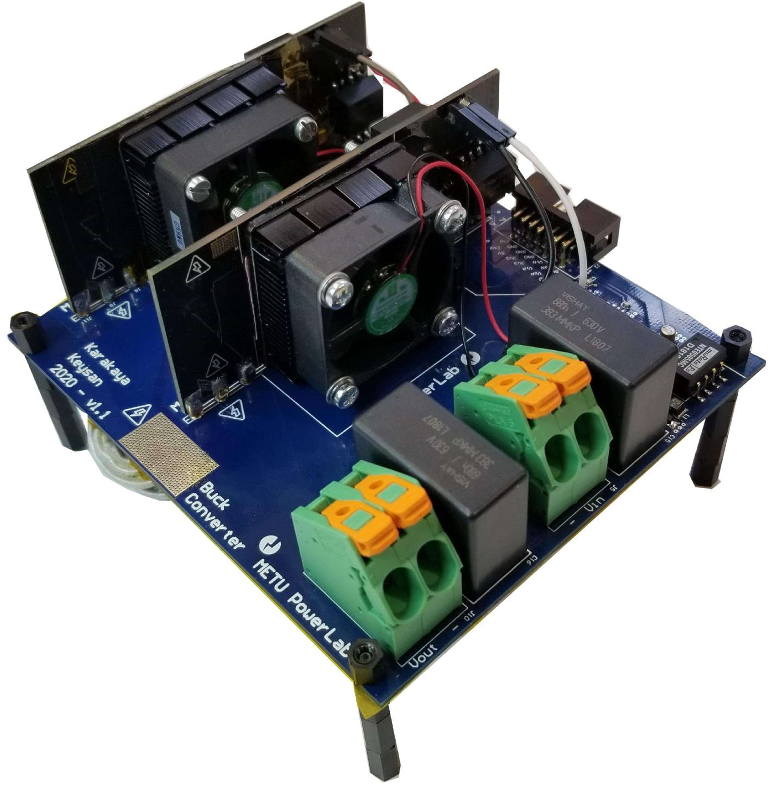
Thesis/Presentation/Converter3D.jpg
