furkankarakaya/GaN-Studies/Thesis/Presentation/Design1_Layers.jpg

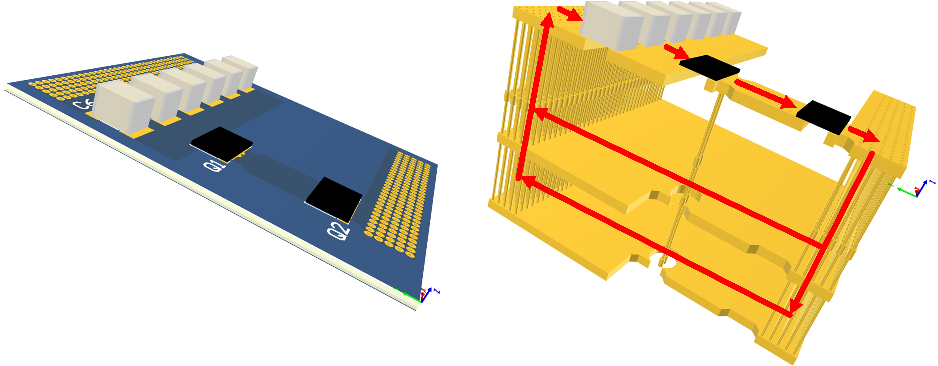
Thesis/Presentation/Design1_Layers.jpg
