furkankarakaya/GaN-Studies/Thesis/Presentation/Design2_Layers.jpg

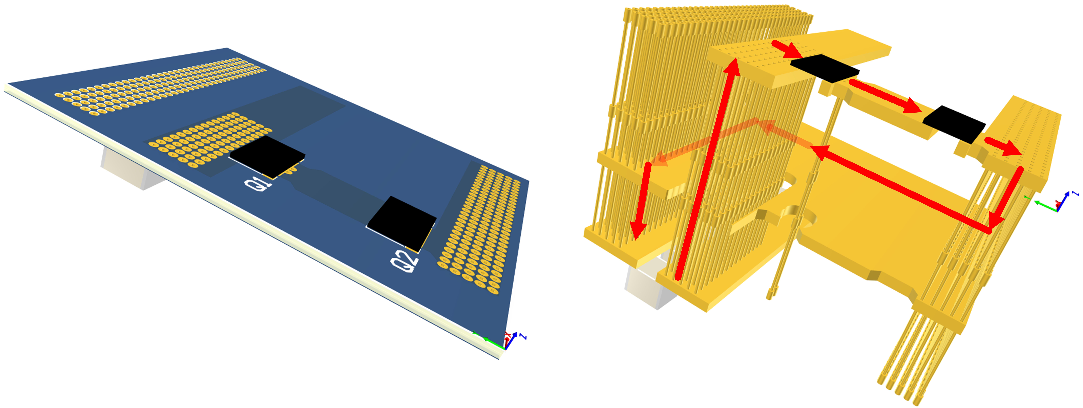
Thesis/Presentation/Design2_Layers.jpg
