furkankarakaya/GaN-Studies/Thesis/Presentation/Design3_Layers.jpg

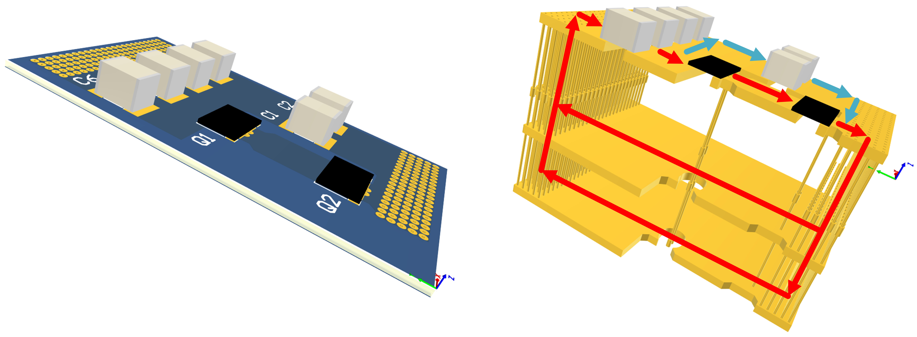
Thesis/Presentation/Design3_Layers.jpg
