furkankarakaya/GaN-Studies/Thesis/Presentation/HalfBridge2.jpg

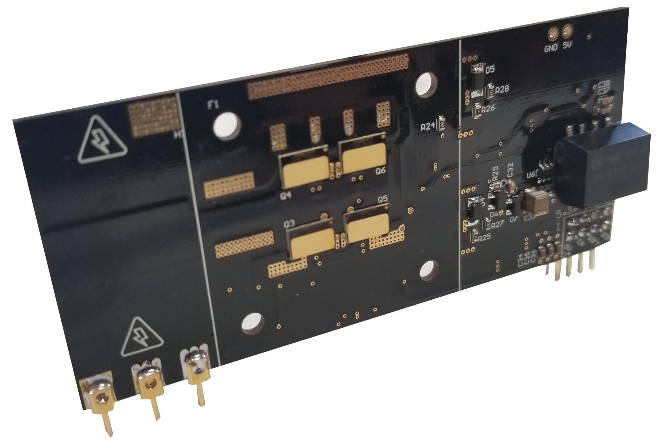
Thesis/Presentation/HalfBridge2.jpg
