furkankarakaya/GaN-Studies/Thesis/Presentation/HalfBridge.jpg

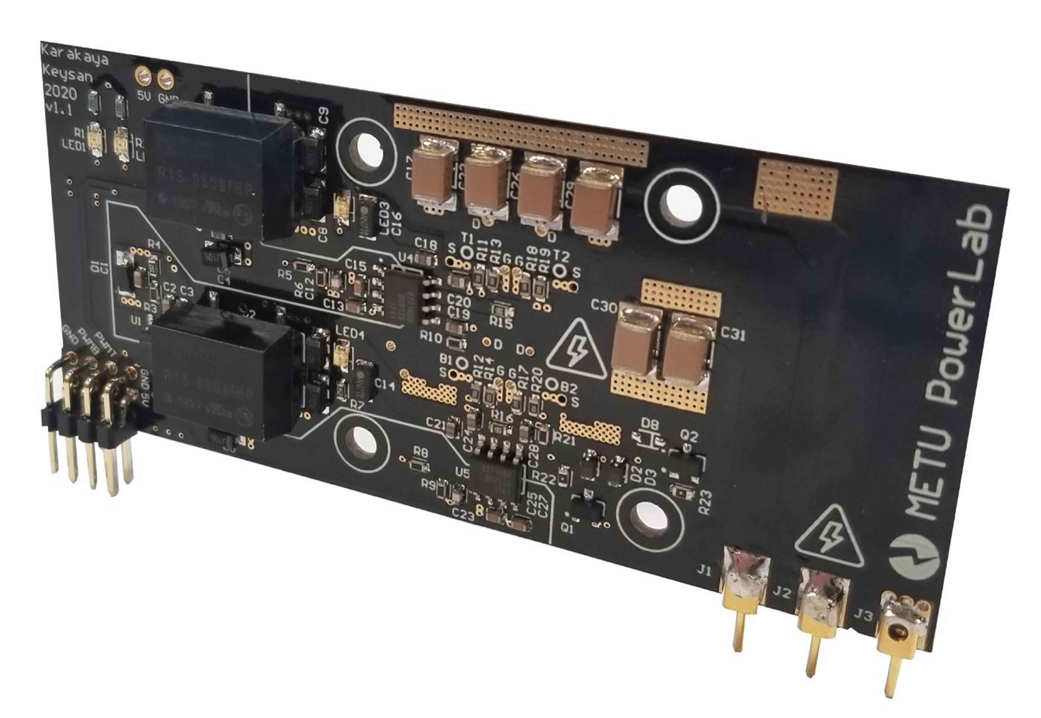
Thesis/Presentation/HalfBridge.jpg
