furkankarakaya/GaN-Studies/Weekly Reports/Thesis converter.jpg

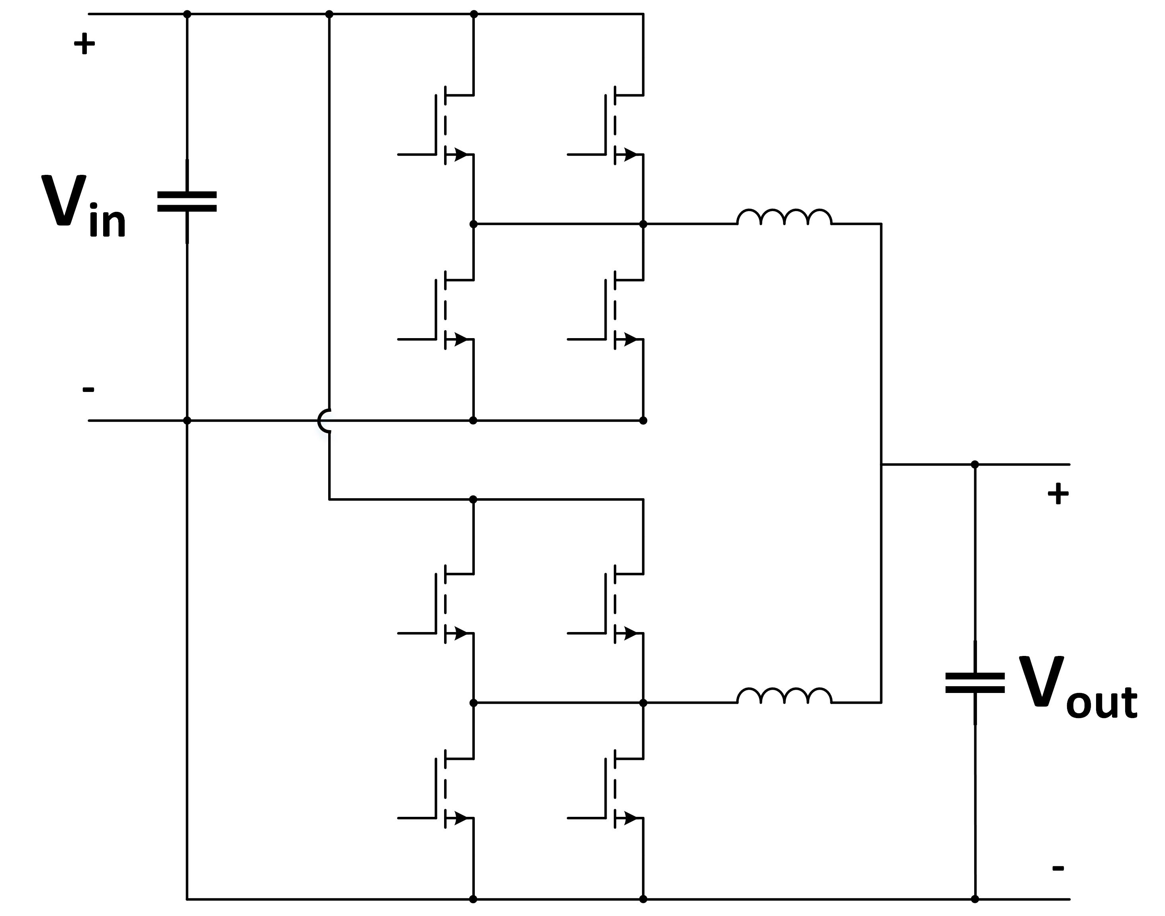
Weekly Reports/Thesis converter.jpg
