furkankarakaya/GaN-Studies/BuyList/Nisan2020.xlsx

Description | Manufacturer Part Number | Link | Quantity
Thin Film Resistors - SMD 1/10W 1 ohm ohm 50 ppm | RT0603FRE071RL | https://www.mouser.com.tr/ProductDetail/Yageo/RT0603FRE071RL | 20
Thin Film Resistors - SMD .1W 1.5ohms 1% 0603 50ppm Auto | MCT06030C1508FP500 | https://www.mouser.com.tr/ProductDetail/Vishay-Beyschlag/MCT06030C1508FP500 | 20
Thin Film Resistors - SMD 2 ohm 1% 50 ppm High-Precision | RT0603FRE072RL | https://www.mouser.com.tr/ProductDetail/Yageo/RT0603FRE072RL | 20
Thin Film Resistors - SMD 2.49 ohm 1% 50ppm | RT0603FRE072R49L | https://www.mouser.com.tr/ProductDetail/Yageo/RT0603FRE072R49L | 20
Thin Film Resistors - SMD 3 ohm 1% 50ppm | RT0603FRE073RL | https://www.mouser.com.tr/ProductDetail/Yageo/RT0603FRE073RL | 20
Thin Film Resistors - SMD CPF 0603 3R48 1% 50PPM 1K RL | CPF0603F3R48C1 | https://www.mouser.com.tr/ProductDetail/TE-Connectivity-Neohm/CPF0603F3R48C1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 | 20
Thin Film Resistors - SMD 1/10W 4.99 ohm 1% 50ppm | RT0603FRE074R99L | https://www.mouser.com.tr/ProductDetail/Yageo/RT0603FRE074R99L | 20
Thin Film Resistors - SMD CPF 0603 6R04 1% 50PPM 1K RL | CPF0603F6R04C1 | https://www.mouser.com.tr/ProductDetail/TE-Connectivity-Neohm/CPF0603F6R04C1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 | 20
Thin Film Resistors - SMD CPF 0603 6R81 1% 50PPM 1K RL | CPF0603F6R81C1 | https://www.mouser.com.tr/ProductDetail/TE-Connectivity-Neohm/CPF0603F6R81C1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 | 20
Thin Film Resistors - SMD 1/10W 8.2 ohm 1% 50ppm | RT0603FRE078R2L | https://www.mouser.com.tr/ProductDetail/Yageo/RT0603FRE078R2L | 20
Thin Film Resistors - SMD CPF 0603 10R 1% 50PPM 1K RL | CPF0603F10RC1 | https://www.mouser.com.tr/ProductDetail/TE-Connectivity-Holsworthy/CPF0603F10RC1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 | 20
Thin Film Resistors - SMD 12 OHM 1% 50PPM | RT0603FRE0712RL | https://www.mouser.com.tr/ProductDetail/Yageo/RT0603FRE0712RL | 20
Thin Film Resistors - SMD CPF 0603 13R 1% 50PPM 1K RL | CPF0603F13RC1 | https://www.mouser.com.tr/ProductDetail/TE-Connectivity-Neohm/CPF0603F13RC1 | 20
Thin Film Resistors - SMD 1/10W 14 ohm 1% 50ppm | RT0603FRE0714RL | https://www.mouser.com.tr/ProductDetail/Yageo/RT0603FRE0714RL | 20
Thin Film Resistors - SMD .1W 15ohms 1% 0603 50ppm Auto | MCT06030C1509FP500 | https://www.mouser.com.tr/ProductDetail/Vishay-Beyschlag/MCT06030C1509FP500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 | 20
Thin Film Resistors - SMD | RT0603FRE0716RL | https://www.mouser.com.tr/ProductDetail/Yageo/RT0603FRE0716RL | 20
Thin Film Resistors - SMD 1/10W 18.2 ohm 1% 50ppm | RT0603FRE0718R2L | https://www.mouser.com.tr/ProductDetail/Yageo/RT0603FRE0718R2L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 | 20
Thin Film Resistors - SMD CPF 0603 20R 1% 50PPM 1K RL | CPF0603F20RC1 | https://www.mouser.com.tr/ProductDetail/TE-Connectivity-Neohm/CPF0603F20RC1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 | 20
Thin Film Resistors - SMD 1/10W 21 ohm 1% 50ppm | RT0603FRE0721RL | https://www.mouser.com.tr/ProductDetail/Yageo/RT0603FRE0721RL | 20
Thin Film Resistors - SMD | RT0603FRD0722RL | https://www.mouser.com.tr/ProductDetail/Yageo/RT0603FRD0722RL | 20
Thin Film Resistors - SMD .1W 24ohms 1% 0603 50ppm | MCT06030C2409FP500 | https://www.mouser.com.tr/ProductDetail/Vishay-Beyschlag/MCT06030C2409FP500 | 20
Thin Film Resistors - SMD CPF 0603 24R9 1% 50PPM 1K RL | CPF0603F24R9C1 | https://www.mouser.com.tr/ProductDetail/TE-Connectivity-Neohm/CPF0603F24R9C1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 | 20
Thin Film Resistors - SMD 1/10W 27 ohm 1% 50ppm | RT0603FRE0727RL | https://www.mouser.com.tr/ProductDetail/Yageo/RT0603FRE0727RL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 | 20
Thin Film Resistors - SMD 30 OHM 1% 50PPM | RT0603FRE0730RL | https://www.mouser.com.tr/ProductDetail/Yageo/RT0603FRE0730RL | 20
Thin Film Resistors - SMD 1/10W 34.8 ohm 1% 50ppm | RT0603FRE0734R8L | https://www.mouser.com.tr/ProductDetail/Yageo/RT0603FRE0734R8L | 20
Thin Film Resistors - SMD 1/10W 39.2 ohm 1% 50ppm | RT0603FRE0739R2L | https://www.mouser.com.tr/ProductDetail/Yageo/RT0603FRE0739R2L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 | 20
Multilayer Ceramic Capacitors MLCC - SMD/SMT WCAP-CSGP 1000pF 0603 5% 16V MLCC | 885012006029 | https://www.mouser.com.tr/ProductDetail/Wurth-Elektronik/885012006029 | 50
Multilayer Ceramic Capacitors MLCC - SMD/SMT WCAP-CSGP 2200pF 0603 5% 10V MLCC | 885012006015 | https://www.mouser.com.tr/ProductDetail/Wurth-Elektronik/885012006015 | 50
Multilayer Ceramic Capacitors MLCC - SMD/SMT WCAP-CSGP 0.1uF 0603 10% 25V MLCC | 885012206071 (https://www.mouser.com.tr/ProductDetail/Wurth-Elektronik/885012206071) | https://www.mouser.com.tr/ProductDetail/Wurth-Elektronik/885012206071 | 50
Multilayer Ceramic Capacitors MLCC - SMD/SMT 1.0uF 25V X5R 10% | CC0603KRX5R8BB105 | https://www.mouser.com.tr/ProductDetail/Yageo/CC0603KRX5R8BB105 | 50
Multilayer Ceramic Capacitors MLCC - SMD/SMT 6.3V 4.7uF 0603 X5R 10% | C0603C475K9PACTU | https://www.mouser.com.tr/ProductDetail/KEMET/C0603C475K9PACTU | 50
Multilayer Ceramic Capacitors MLCC - SMD/SMT 0603 6.3V 3.3uF X7S 20% T: 0.8mm | C1608X7S0J335M080AC | https://www.mouser.com.tr/ProductDetail/TDK/C1608X7S0J335M080AC | 50
Zener Diodes 6V 500mW | MMSZ5233B-7-F | https://www.mouser.com.tr/ProductDetail/Diodes-Incorporated/MMSZ5233B-7-F | 30
MOSFET 650V, 30A, GaN E-HEMT, GaNPX package, Top-side cooling | GS66508T-E02-MR | https://www.mouser.com.tr/ProductDetail/GaN-Systems/GS66508T-E02-MR | 5
