furkankarakaya/GaN-Studies/Protection Circuits/GaNCharBoard.xls

ComponentLink1Description | ComponentLink1URL | ComponentLink2Description | ComponentLink2URL | Description | Designator | Quantity | Cost
Column1 | Column2 | Column3 | Column4 | Column5 | Column6 | Column7 | Column8 | Column9
Digikey | https://www.digikey.com/product-detail/en/diodes-incorporated/AP2204K-5.0TRG1/AP2204K-5.0TRG1DICT-ND/4505289 | Digikey PN | AP2204K-5.0TRG1DICT-ND | IC REG LINEAR 5V 150MA SOT23-5 | U13_PRTC1, U13_PRTC2, U13_PRTC3, U13_PRTC4, U13_PRTC5 | 1 | 0.47 | 0.47
Digikey | https://www.digikey.com/product-detail/en/linear-technology-analog-devices/LT1964ES5-5-TRMPBF/LT1964ES5-5-TRMPBFCT-ND/889481 | Digikey PN | LT1964ES5-5#TRMPBFCT-ND | IC REG LINEAR -5V 200MA TSOT23-5 | U12_PRTC1, U12_PRTC2, U12_PRTC3, U12_PRTC4, U12_PRTC5 | 1 | 3.33 | 3.33
Digikey | https://www.digikey.com/product-detail/en/panasonic-electronic-components/ERJ-3EKF2741V/P2.74KHCT-ND/198232 | Digikey PN | P2.74KHCT-ND | RES SMD 2.74K OHM 1% 1/10W 0603 | R43_PRTC1, R43_PRTC2, R43_PRTC3, R43_PRTC4, R43_PRTC5 | 1 | 0.1 | 0.1
Digikey | https://www.digikey.com/product-detail/en/te-connectivity-passive-product/CPF0603B20RE1/A103063CT-ND/2728614 | Digikey PN | A103063CT-ND | RES SMD 20 OHM 0.1% 1/16W 0603 | R42_PRTC1, R42_PRTC2, R42_PRTC3, R42_PRTC4, R42_PRTC5 | 1 | 0.55 | 0.55
Digikey | https://www.digikey.com/product-detail/en/texas-instruments/ISO7710DR/296-48557-1-ND/8567601 | Digikey PN | 296-48557-1-ND | DGTL ISO 3KV GEN PRP 8SOIC | U16_PRTC1, U16_PRTC2, U16_PRTC3, U16_PRTC4, U16_PRTC5 | 1 | 1.65 | 1.65
Digikey | https://www.digikey.com/product-detail/en/yageo/RC0603FR-0720KL/311-20.0KHRCT-ND/729987 | Digikey PN | 311-20.0KHRCT-ND | RC0603FR-0720KL | R35_PRTC1, R35_PRTC2, R35_PRTC3, R35_PRTC4, R35_PRTC5 | 1 | 0.1 | 0.1
Digikey | https://www.digikey.com/product-detail/en/yageo/RT0603DRE072K43L/311-2517-1-ND/6128936 | Digikey PN | 311-2517-1-ND | RES SMD 2.43KOHM 0.5% 1/10W 0603 | R34_PRTC1, R34_PRTC2, R34_PRTC3, R34_PRTC4, R34_PRTC5 | 1 | 0.12 | 0.12
Digikey | https://www.digikey.com/products/en/integrated-circuits-ics/linear-amplifiers-instrumentation-op-amps-buffer-amps/687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 | Digikey PN | 296-14178-1-ND | IC OPAMP VFB 800MHZ SOT23-5 |  | 2 | 4.72 | 9.44
Digikey | https://www.digikey.com/product-detail/en/texas-instruments/OPA847IDBVR/296-46172-1-ND/7033347 | Digikey PN | 296-46172-1-ND | IC OPAMP VFB 3.9GHZ SOT23-6 | U14_PRTC1, U14_PRTC2, U14_PRTC3, U14_PRTC4, U14_PRTC5, U15_PRTC1, U15_PRTC2, U15_PRTC3, U15_PRTC4, U15_PRTC5 | 2 | 5.45 | 10.9
Digikey | https://www.digikey.com/product-detail/en/analog-devices-inc/ADA4860-1YRJZ-RL7/ADA4860-1YRJZ-RL7CT-ND/1120070 | Digikey PN | ADA4860-1YRJZ-RL7CT-ND | IC OPAMP CFA 520MHZ SOT23-6 | U17_PRTC1, U17_PRTC2, U17_PRTC3, U17_PRTC4, U17_PRTC5 | 1 | 1.76 | 1.76
Digikey | https://www.digikey.com/product-detail/en/yageo/RC0603FR-072K2L/311-2.20KHRCT-ND/729963 | Digikey PN | 311-2.20KHRCT-ND | RC0603FR-072K2L, RES SMD 2.2K OHM 1% 1/10W 0603 | R2_GD1, R2_GD2, R2_GD3, R2_GD4, R2_GD5, R2_GD6, R40_PRTC1, R40_PRTC2, R40_PRTC3, R40_PRTC4, R40_PRTC5 | 1 | 0.1 | 0.1
Digikey | https://www.digikey.com/products/en?keywords=P10.0KHCT-ND | Digikey PN | P10.0KHCT-ND | ERJ-3EKF1002V, RES SMD 10K OHM 1% 1/10W 0603, THERMISTOR NTC 10KOHM 3380K 0603 | R36_PRTC1, R36_PRTC2, R36_PRTC3, R36_PRTC4, R36_PRTC5, R37_PRTC1, R37_PRTC2, R37_PRTC3, R37_PRTC4, R37_PRTC5, R38_PRTC1, R38_PRTC2, R38_PRTC3, R38_PRTC4, R38_PRTC5, R39_PRTC1, R39_PRTC2, R39_PRTC3, R39_PRTC4, R39_PRTC5 | 4 | 0.1 | 0.4
Digikey | https://www.digikey.com/products/en?keywords=1276-6582-1-ND | Digikey PN | 1276-6582-1-ND | CAP CER 0.1UF 16V X7R 0603 | C51_PRTC1, C51_PRTC2, C51_PRTC3, C51_PRTC4, C51_PRTC5, C52_PRTC1, C52_PRTC2, C52_PRTC3, C52_PRTC4, C52_PRTC5, C53_PRTC1, C53_PRTC2, C53_PRTC3, C53_PRTC4, C53_PRTC5, C54_PRTC1, C54_PRTC2, C54_PRTC3, C54_PRTC4, C54_PRTC5 | 2 | 0.1 | 0.2
Digikey | https://www.digikey.com/products/en?keywords=399-7831-1-ND | Digikey PN | 399-7831-1-ND | CAP CER 1000PF 100V X7R 0603 | C35_PRTC1, C35_PRTC2, C35_PRTC3, C35_PRTC4, C35_PRTC5, C46_PRTC1, C46_PRTC2, C46_PRTC3, C46_PRTC4, C46_PRTC5 | 2 | 0.11 | 0.22
Digikey | https://www.digikey.com/product-detail/en/tdk-corporation/C1608X5R1V335K080AC/445-14167-1-ND/3955833 | Digikey PN | 445-14167-1-ND | CAP CER 3.3UF 35V X5R 0603 | C42_PRTC1, C42_PRTC2, C42_PRTC3, C42_PRTC4, C42_PRTC5, C43_PRTC1, C43_PRTC2, C43_PRTC3, C43_PRTC4, C43_PRTC5, C44_PRTC1, C44_PRTC2, C44_PRTC3, C44_PRTC4, C44_PRTC5, C45_PRTC1, C45_PRTC2, C45_PRTC3, C45_PRTC4, C45_PRTC5 | 4 | 0.47 | 1.88
Digikey | https://www.digikey.com/products/en?keywords=P1.0KDBCT-ND | Digikey PN | P1.0KDBCT-ND | ESR03EZPF1001, RES SMD 1K OHM 0.1% 1/10W 0603 | R41_PRTC1, R41_PRTC2, R41_PRTC3, R41_PRTC4, R41_PRTC5 | 1 | 0.35 | 0.35
Digikey | https://www.digikey.com/product-detail/en/tdk-corporation/MPZ1608S101ATAH0/445-1564-1-ND/571894 | Digikey PN | 445-1564-1-ND | FERRITE BEAD 100 OHM 0603 1LN | FB6_PRTC1, FB6_PRTC2, FB6_PRTC3, FB6_PRTC4, FB6_PRTC5, FB7_PRTC1, FB7_PRTC2, FB7_PRTC3, FB7_PRTC4, FB7_PRTC5 | 2 | 0.1 | 0.2
 |  |  |  |  |  |  |  | 31.77
