furkankarakaya/GaN-Studies/Protection Circuits/TPEL Letter/PaperFigures/Fig11-Setupv2.pdf

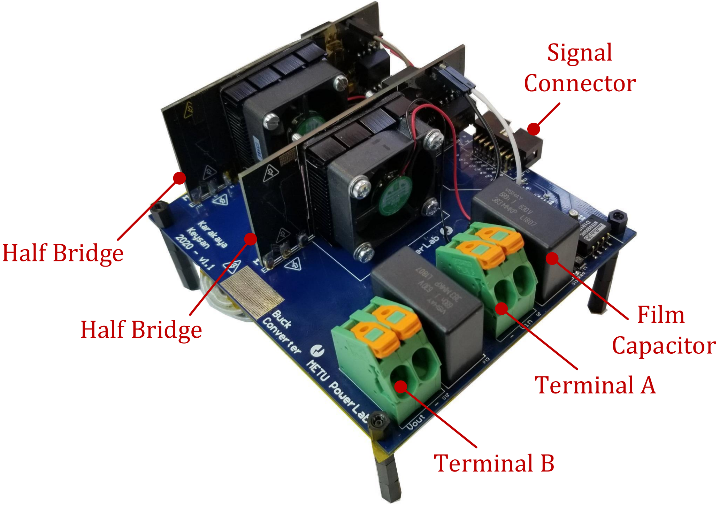
[picture p328: page 1]

Terminal A

Terminal B

Film
Capacitor

Half Bridge

Half Bridge

Signal
Connector
