furkankarakaya/GaN-Studies/Thesis/Figures/Ch5/Ch5_ExpSetup.pdf

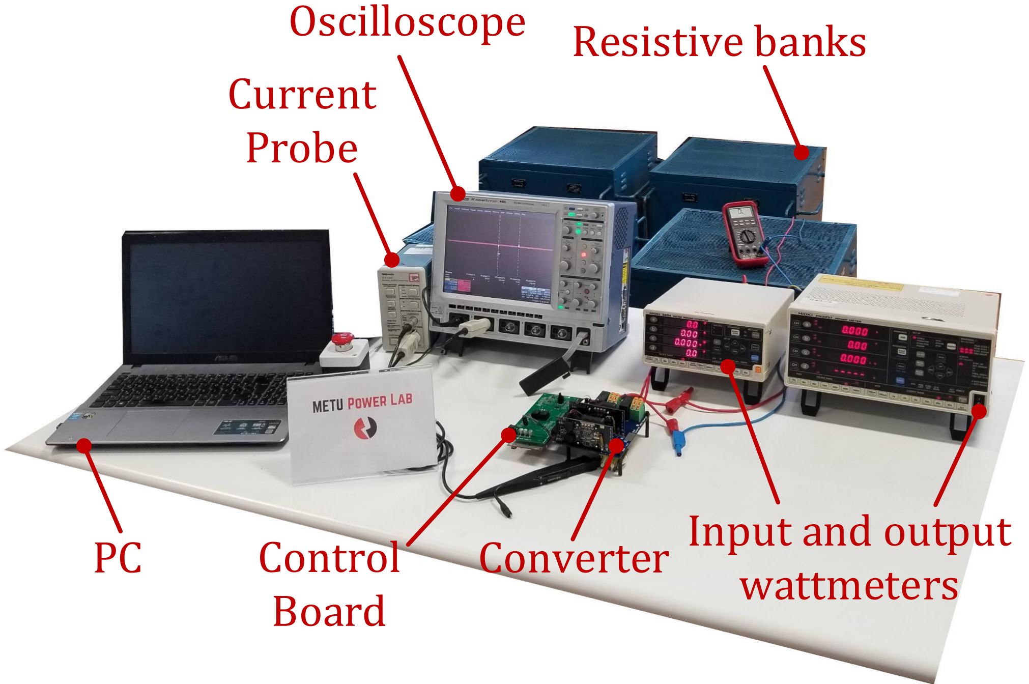
[picture p329: page 1]

Resistive banks

Input and output
wattmeters

Oscilloscope
Current
Probe
PC | Control | Converter
| Board
