furkankarakaya/GaN-Studies/Thesis/Figures/Ch5/Ch5_CCM_Steps_2.pdf

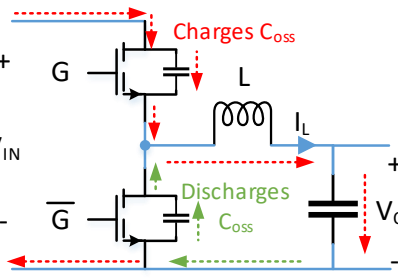
[picture p330: figure]
Charges Coss; Discharges Coss

## +-VIN

# +- VOUT
