furkankarakaya/GaN-Studies/Thesis/Figures/Ch5/Ch5_CCM_Steps_4.pdf

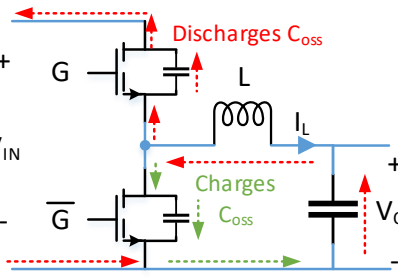
[picture p331: figure]
Discharges Coss; Charges Coss

## +-VIN

# +- VOUT
