furkankarakaya/GaN-Studies/Buck Converter/Soldering & Test Procedure.xlsx

Sheet: SOLDER
 | Column1 | Column2 | Column3 | Column4 | Column5 | Column6 | Column7 | Column8
HAND | 0.68uF, 630V | BC1880-ND | CAP FILM 0.68UF 5% 630VDC RADIAL | C9, C10 | FILM_31X15X25_27.5PITCH | 2 | Top
SOLDER | 100n | 399-1097-1-ND, [NoParam] | CAP CER 0.1UF 16V X7R 0603, C0603C104J4RACTU | C1, C3, C4, C5, C13 | 0603 (1608) - cap | 5 | Top
SOLDER | 10u |  | UWX1C100MCL2GB | C14 | CAP_CAN_D3 | 1 | Top
SOLDER | 150pF | 732-7948-1-ND | CAP CER 150PF 16V X7R 0603 | C2 | 0603 (1608) - cap | 1 | Top
HAND | 1792229 | 277-9886-ND | COMBICON PLA Series 7.5mm Pitch Angled PCB Trm Blk w/ Spring Cage Term, PCB Mount | J11, J12 | *PHOENIX_1792229 | 2 | Top
SOLDER | 1K | 311-1.00KHRCT-ND | RES SMD 1K OHM 1% 1/10W 0603 | R2 | 0603 (1608) | 1 | Top
SOLDER | 22R | A129668CT-ND | 22 Ohms ±1% 0.1W, 1/10W Chip Resistor 0603 (1608 Metric) Automotive AEC-Q200, Moisture Resistant Thick Film | R5, R6 | CAP0603 | 2 | Top
CHANGE | 23.2K | P23.2KHCT-ND | RES SMD 23.2K OHM 1% 1/10W 0603 | R3 | 0603 (1608) | 1 | Top | 0R
SOLDER | 249R | RG20P249BCT-ND | RES SMD 249 OHM 0.1% 1/8W 0805 | R8, R9 | R0805 | 2 | Top
SOLDER | 3.3uF | 445-14167-1-ND | CAP CER 3.3UF 35V X5R 0603 | C6 | 0603 (1608) - cap | 1 | Top
SOLDER | 330p |  | C0603C331J5GACTU | C7, C8, C11, C12 | 0603 (1608) - cap | 4 | Top
SOLDER | 4.02K | 311-4.02KHRCT-ND | RES SMD 4.02K OHM 1% 1/10W 0603 | R1 | 0603 (1608) | 1 | Top
SOLDER | 4.7uF | 1276-2087-1-ND | CAP CER 4.7UF 6.3V X7R 0603 | C15 | 0603 (1608) - cap | 1 | Top
SOLDER | 45.3K | 311-45.3KHRCT-ND | RES SMD 45.3K OHM 1% 1/10W 0603 | R7 | 0603 (1608) | 1 | Top
CHANGE | 45.3K | 311-45.3KHRCT-ND | RES SMD 45.3K OHM 1% 1/10W 0603 | R4 | 0603 (1608) | 1 | Top | OPEN
SOLDER | 5.1V | DDZ5V1BDICT-ND | DIODE ZENER 5.1V 500MW SOD123 | D1 | SOD123 | 1 | Top
SOLDER | 82473C | 811-2477-1-ND | FIXED IND 47UH 250MA 1.69 OHM | L1 | *CAPC1210X102N | 1 | Top
HAND | ACS732KLATR-40AB-T | 620-1987-1-ND | Current Sensor 40A 1 Channel Hall Effect, Differential Bidirectional 16-SOIC (0.295", 7.50mm Width) | U2 | *SOIC127P1030X265-16N | 1 | Top
SOLDER | AMC1301 |  | AMC1301DWVR isolation amplifier | U4, U5 | SOIC-8 - DWV | 2 | Top
WAIT | Header 4x2 |  |  | J1, J6 | HDR4X2_VIAS | 2 | Top
WAIT | Header 7X2 | S9178-ND | CONN HEADER R/A 14POS 2.54MM | J5, J10 | HDR7X2_IPL - R/A | 2 | Top
SOLDER | MPZ1608S101ATAH0 |  | FERRITE BEAD 100 OHM 0603 1LN | FB1 | 0603 (1608) | 1 | Top
SOLDER | NTE0505MC-R |  | NTE0505MC | U6 | NTE0505MC | 1 | Top
WAIT | PC PIN RCPT | ED11311-ND | CONN PIN RCPT .032-.046 SOLDER | J2, J3, J4, J7, J8, J9 | PC PIN RCPT | 6 | Top
SOLDER | SN74LVC1G11DBVR | 296-16810-1-ND | IC GATE AND 1CH 3-INP SOT23-6 | U1, U3 | SOT23-6 | 2 | Top
SOLDER | Test Point | A106145CT-ND | PC TEST POINT NATURAL | TP1, TP2, TP3, TP4 | Test Point | 4 | Top
SOLDER | 0.22uF / 630V | 399-12904-1-ND | CAP FILM 0.22UF 10% 630VDC 6054 | C22, C23, C28, C29 | 6054 PACKAGE | 4 | Bottom
SOLDER | 100n | 399-1097-1-ND | CAP CER 0.1UF 16V X7R 0603 | C16, C18, C19, C20, C24, C27, C31, C32 | 0603 (1608) - cap | 8 | Bottom
SOLDER | 10u |  | GRM188R60J106ME47D | C25, C26, C30, C33 | 0603 (1608) - cap | 4 | Bottom
SOLDER | 150pF | 732-7948-1-ND | CAP CER 150PF 16V X7R 0603 | C21 | 0603 (1608) - cap | 1 | Bottom
SOLDER | 1K | 311-1.00KHRCT-ND | RES SMD 1K OHM 1% 1/10W 0603 | R19 | 0603 (1608) | 1 | Bottom
SOLDER | 226K | RNCF1206BTE226KCT-ND | RES 226K OHM 0.1% 1/4W 1206 | R24, R26 | 1206 (3216) | 2 | Bottom
SOLDER | 22R | A129668CT-ND | 22 Ohms ±1% 0.1W, 1/10W Chip Resistor 0603 (1608 Metric) Automotive AEC-Q200, Moisture Resistant Thick Film | R11, R12, R13, R14 | CAP0603 | 4 | Bottom
CHANGE | 23.2K | P23.2KHCT-ND | RES SMD 23.2K OHM 1% 1/10W 0603 | R18 | 0603 (1608) | 1 | Bottom | 0R
SOLDER | 249R | RG20P249BCT-ND | RES SMD 249 OHM 0.1% 1/8W 0805 | R22, R25 | R0805 | 2 | Bottom
SOLDER | 3.3uF | 445-14167-1-ND | CAP CER 3.3UF 35V X5R 0603 | C17 | 0603 (1608) - cap | 1 | Bottom
SOLDER | 300K | P300KBCCT-ND | RES SMD 300K OHM 0.1% 1/4W 1206 | R21, R23 | 1206 (3216) | 2 | Bottom
SOLDER | 4.02K | 311-4.02KHRCT-ND | RES SMD 4.02K OHM 1% 1/10W 0603 | R20 | 0603 (1608) | 1 | Bottom
SOLDER | 45.3K | 311-45.3KHRCT-ND | RES SMD 45.3K OHM 1% 1/10W 0603 | R10, R15, R16 | 0603 (1608) | 3 | Bottom
CHANGE | 45.3K | 311-45.3KHRCT-ND | RES SMD 45.3K OHM 1% 1/10W 0603 | R17 | 0603 (1608) | 1 | Bottom | OPEN
SOLDER | 6.8 uH, 47.5 A | https://katalog.we-online.de/pbs/datasheet/7443640680B.pdf | SMT High Current Inductor WE-HCF, size 2818, 6.8 uH, 47.5 A | L2, L3 | WE-HCF_2818 | 2 | Bottom
HAND | ACS732KLATR-40AB-T | 620-1987-1-ND | Current Sensor 40A 1 Channel Hall Effect, Differential Bidirectional 16-SOIC (0.295", 7.50mm Width) | U7 | *SOIC127P1030X265-16N | 1 | Bottom
 | Column1 | Column2 | Column3 | Column4 | Column5 | Column6 | Column7
SOLDER | 100u |  | CAP ALUM 100UF 20% 25V SMD | C1, C2, C3 | Cap4 (6.3x) | 3 | Top
SOLDER | MPZ1608S101ATAH0 |  | FERRITE BEAD 100 OHM 0603 1LN | FB1 | MPZ1608S101ATAH0 | 1 | Top
HAND | PJ-002AH-SMT-TR |  | CONN PWR JACK 2X5.5MM SOLDER | J1 | PJ-002AH-SMT-TR | 1 | Top
WAIT | Header 7X2 |  |  | J2, J3 | Header 7X2_2.54mm_FML | 2 | Top
SOLDER | LED GREEN |  | LED GREEN CLEAR 0805 SMD | LED1, LED2 | LED RED - 603p | 2 | Top
SOLDER | 750R |  | RES SMD 750 OHM 5% 1/10W 0603 | R1, R2 | 750R - 603p | 2 | Top
SOLDER | 1.6K |  | RES SMD 1.6K OHM 1% 1/10W 0603 | R3, R6, R7, R10 | R0603 | 4 | Top
SOLDER | 1K |  | RES SMD 1K OHM 1% 1/10W 0603 | R4, R5, R8, R9 | 10K - 603p | 4 | Top
HAND | D6R90 F1 LFS |  | SWITCH PUSH SPST-NO 0.1A 32V | SW1, SW2 | PUSHBUTTON | 2 | Top
SOLDER | 3.3uF |  | CAP CER 3.3UF 35V X5R 0603 | C4 | 3.3uF35V - 603p | 1 | Top
SOLDER | 6037 |  | PC TEST POINT NATURAL | TP1, TP2 | Test Point | 2 | Top
SOLDER | Test Point |  | PC TEST POINT NATURAL | TP3, TP4, TP5, TP6 | Test Point | 4 | Top
SOLDER | NLSX4373DR2G |  | Voltage Level Translator Bidirectional 1 Circuit 2 Channel 20Mbps 8-SOIC | U1 | NLSX4373DR2G | 1 | Top
SOLDER | LM3940 |  | IC REG LINEAR 3.3V 1A SOT223-4 | U2 | LM3940 | 1 | Top
SOLDER | SN74LVC2G07DBVR |  | IC BUF NON-INVERT 5.5V SOT23-6 | U3 | SN74LVC2G07DBVR | 1 | Top
SOLDER | THS4521IDR |  | Very Low Power Rail-to-Rail Output Fully Differential Amplifier, 2.5 to 5.5 V, -40 to 85 degC, 8-pin SOIC (D8), Green (RoHS & no Sb/Br) | U4, U5 | THS4521IDR | 2 | Top
SOLDER | 33u |  | CAP TANT POLY 33UF 10V 1206 | C5 | 33uF10V - 1206p - TANTAL | 1 | Top
SOLDER | 68pF |  | CAP CER 68PF 10V C0G/NP0 0603 | C6, C8, C9, C11 | Cap5 (0603) | 4 | Top
SOLDER | 1nF |  | CAP CER 1000PF 10V X7R 0603 | C7, C10 | Cap5 (0603) | 2 | Top
SOLDER | 10R |  | RES SMD 10 OHM 1% 1/10W 0603 | R11, R12 | 10R - 603p - 0.1W | 2 | Bottom
SOLDER | 10K |  | RES SMD 10K OHM 1% 1/10W 0603 | R13, R14 | 10K - 603p | 2 | Bottom
HAND | LAUNCHXL-F28379D |  | C2000 DELFINO MCUS F28379D LAUNC | U6 | LAUNCHXL-F28379D | 1 | Bottom
SOLDER | SN74LVC2G07DBVR |  | IC BUF NON-INVERT 5.5V SOT23-6 | U7 | SN74LVC2G07DBVR | 1 | Bottom
SOLDER | 0.22u |  | 490-11507-1-ND | C12, C13, C18, C24, C30 | Cap5 (0603) | 5 | Bottom
SOLDER | 100n |  | CAP CER 0.1UF 16V X7R 0603 | C14, C15, C16, C17, C19, C22, C23, C25, C28, C29 | 100n16V - 603p | 10 | Bottom
SOLDER | 10u |  | GRM188R60J106ME47D | C20, C21, C26, C27 | C0603 | 4 | Bottom
SOLDER | SDM40E20LS-7-F |  | SDM40E20LS-7-F SOT23-3 | D1, D2, D3, D4 | SDM40E20LS-7-F | 4 | Bottom
SOLDER | 0.22uF / 630V |  | Multilayer Ceramic Capacitors MLCC - SMD/SMT 1812 630V 0.22uF X7T 20% T: 2mm | C15, C16, C27, C28, C29, C30 | 1812 Package Capacitor | 6 | Top
SOLDER | 100n | 399-1097-1-ND, [NoParam] | CAP CER 0.1UF 16V X7R 0603, C0603C104J4RACTU | C1, C2, C13, C17, C20 | 0603 (1608) - cap | 5 | Top
SOLDER | 100R | P100HCT-ND | RES SMD 100 OHM 1% 1/10W 0603 | R2, R17 | CAP0603 | 2 | Top
SOLDER | 10K | P10.0KHCT-ND | RES SMD 10K OHM 1% 1/10W 0603 | R1, R6, R13, R15 | 0603 (1608) | 4 | Top
SOLDER | 10u | 478-8151-1-ND | CAP TANT 10UF 20% 6.3V 1206 | C3, C6, C11, C21, C26, C31 | 1206 Package | 6 | Top
SOLDER | 18R | CRGP0603F18R | RES SMD 18 OHM 1% 1/4W 0603 | R7, R16 | CAP0603 | 2 | Top
SOLDER | 1K5 | 311-1.5KGRCT-ND | RES SMD 1.5K OHM 5% 1/10W 0603 | R3, R4, R5, R12, R14 | CAP0603 | 5 | Top
SOLDER | 1R | CRCW06031R00FKEAHP | RES SMD 1 OHM 1% 1/4W 0603 | R8, R9, R10, R11, R18, R19, R20, R21 | CAP0603 | 8 | Top
SOLDER | 1u | 587-1241-1-ND | CAP CER 1UF 16V X7R 0603 | C5, C7, C9, C10, C18, C22, C23, C24 | 0603 (1608) - cap | 8 | Top
SOLDER | 22p | 478-1167-1-ND | CAP CER 22PF 50V C0G/NP0 0603 | C4, C19 | 0603 (1608) - cap | 2 | Top
SOLDER | 33u | P17121CT-ND | CAP TANT POLY 33UF 10V 1206 | C8, C25 | 1206 Package | 2 | Top
SOLDER | 4.7uF | 1276-2087-1-ND | CAP CER 4.7UF 6.3V X7R 0603 | C12, C14 | 0603 (1608) - cap | 2 | Top
SOLDER | 5.1V | DDZ5V1BDICT-ND | DIODE ZENER 5.1V 500MW SOD123 | D1 | SOD123 | 1 | Top
SOLDER | 750R | 311-750GRCT-ND | RES SMD 750 OHM 5% 1/10W 0603 | R22, R23 | CAP0603 | 2 | Top
SOLDER | ISO7721DR | 296-48296-1-ND | DGTL ISO 3KV GEN PRP 8SOIC | U3 | SOIC-8 3.9x4.9 | 1 | Top
SOLDER | LED GREEN | 150080RS75000, 150080VS75000 | LED GREEN CLEAR 0805 SMD | LED1, LED2, LED3, LED4 | D0805 | 4 | Top
SOLDER | NPN | ZXTN19020DFFCT-ND | TRANS NPN 20V 6.5A SOT23F-3 | Q1, Q2 | SOT23F - 3 Lead | 2 | Top
WAIT | PC PIN PRESS FIT CONN | ED1278-ND | CONN PC PIN CIRC 0.040DIA GOLD | J1, J2, J3 | PC PIN PRESS FIT | 3 | Top
SOLDER | PES1-S5-S9-M |  | 9V 1W single output isolated DC-DC converter | U2, U5 | PES1-M Single Output | 2 | Top
SOLDER | SI8271AB-IS | 336-3530-5-ND | DGTL ISO 2.5KV GATE DRIVER 8SOIC | U1, U4 | SOIC-8 | 2 | Top
SOLDER | 100n |  | C0603C104J4RACTU | C36, C38 | 0603 (1608) - cap | 2 | Bottom
SOLDER | 100uF | 587-3152-1-ND | CAP CER 100UF 16V X5R 1210 | C35 | 1210 Package | 1 | Bottom
SOLDER | 10u |  | GRM188R60J106ME47D | C37 | 0603 (1608) - cap | 1 | Bottom
SOLDER | 1K | RHM1.00KADCT-ND | RES SMD 1K OHM 1% 1/4W 0603 | R24, R28 | CAP0603 | 2 | Bottom
SOLDER | 1K5 | 311-1.5KGRCT-ND | RES SMD 1.5K OHM 5% 1/10W 0603 | R26, R27, R30 | CAP0603 | 3 | Bottom
SOLDER | 1u | 587-1241-1-ND | CAP CER 1UF 16V X7R 0603 | C32, C33, C34 | 0603 (1608) - cap | 3 | Bottom
SOLDER | 2.2K | 311-2.20KHRCT-ND | RES SMD 2.2K OHM 1% 1/10W 0603 | R25, R29 | 0603 (1608) | 2 | Bottom
SOLDER | 6V | MMSZ5233B-FDICT-ND | DIODE ZENER 6V 500MW SOD123 | D3, D5 | SOD123 | 2 | Bottom
WAIT | APF40-40-13CB |  | HEATSINK LOW-PROFILE FORGED | H1 | HEATSINK | 1 | Bottom
SOLDER | Diode | MMBD914TPMSCT-ND | DIODE GEN PURP 75V 150MA SOT23 | D2, D4 | SOT23-3 | 2 | Bottom
WAIT | FAN AXIAL 35X10MM 5VDC WIRE | 1053-1684-ND | Fan Tubeaxial 5VDC Square - 35mm L x 35mm H Ball 3.0 CFM (0.084m³/min) 2 Wire Leads | F1 | FAN 35X35X10MM | 1 | Bottom
SOLDER | GS66508T |  | GAN TRANS E-MODE 650V 30A TOP SIDE COOL | Q3, Q5, | GS66508T | 2 | Bottom
WAIT | GS66508T |  | GAN TRANS E-MODE 650V 30A TOP SIDE COOL | Q4, Q6 | GS66508T | 2 | Bottom
WAIT | Header 4x2 | 732-5353-ND | CONN HEADER R/A 8POS 2.54MM | J4 | HDR4X2_R/A | 1 | Bottom
SOLDER | NTE0505MC-R |  | NTE0505MC | U6 | NTE0505MC | 1 | Bottom
SOLDER | TLV3501AIDBVR | 296-35977-1-ND | IC COMP 4.5NS R-R HS SOT23-6 | U7 | SOT23-6 | 1 | Bottom
SOLDER | 0.22uF / 630V |  | Multilayer Ceramic Capacitors MLCC - SMD/SMT 1812 630V 0.22uF X7T 20% T: 2mm | C15, C16, C27, C28, C29, C30 | 1812 Package Capacitor | 6 | Top
SOLDER | 100n | 399-1097-1-ND, [NoParam] | CAP CER 0.1UF 16V X7R 0603, C0603C104J4RACTU | C1, C2, C13, C17, C20 | 0603 (1608) - cap | 5 | Top
SOLDER | 100R | P100HCT-ND | RES SMD 100 OHM 1% 1/10W 0603 | R2, R17 | CAP0603 | 2 | Top
SOLDER | 10K | P10.0KHCT-ND | RES SMD 10K OHM 1% 1/10W 0603 | R1, R6, R13, R15 | 0603 (1608) | 4 | Top
SOLDER | 10u | 478-8151-1-ND | CAP TANT 10UF 20% 6.3V 1206 | C3, C6, C11, C21, C26, C31 | 1206 Package | 6 | Top
SOLDER | 18R | CRGP0603F18R | RES SMD 18 OHM 1% 1/4W 0603 | R7, R16 | CAP0603 | 2 | Top
SOLDER | 1K5 | 311-1.5KGRCT-ND | RES SMD 1.5K OHM 5% 1/10W 0603 | R3, R4, R5, R12, R14 | CAP0603 | 5 | Top
SOLDER | 1R | CRCW06031R00FKEAHP | RES SMD 1 OHM 1% 1/4W 0603 | R8, R9, R10, R11, R18, R19, R20, R21 | CAP0603 | 8 | Top
SOLDER | 1u | 587-1241-1-ND | CAP CER 1UF 16V X7R 0603 | C5, C7, C9, C10, C18, C22, C23, C24 | 0603 (1608) - cap | 8 | Top
SOLDER | 22p | 478-1167-1-ND | CAP CER 22PF 50V C0G/NP0 0603 | C4, C19 | 0603 (1608) - cap | 2 | Top
SOLDER | 33u | P17121CT-ND | CAP TANT POLY 33UF 10V 1206 | C8, C25 | 1206 Package | 2 | Top
SOLDER | 4.7uF | 1276-2087-1-ND | CAP CER 4.7UF 6.3V X7R 0603 | C12, C14 | 0603 (1608) - cap | 2 | Top
SOLDER | 5.1V | DDZ5V1BDICT-ND | DIODE ZENER 5.1V 500MW SOD123 | D1 | SOD123 | 1 | Top
SOLDER | 750R | 311-750GRCT-ND | RES SMD 750 OHM 5% 1/10W 0603 | R22, R23 | CAP0603 | 2 | Top
SOLDER | ISO7721DR | 296-48296-1-ND | DGTL ISO 3KV GEN PRP 8SOIC | U3 | SOIC-8 3.9x4.9 | 1 | Top
SOLDER | LED GREEN | 150080RS75000, 150080VS75000 | LED GREEN CLEAR 0805 SMD | LED1, LED2, LED3, LED4 | D0805 | 4 | Top
SOLDER | NPN | ZXTN19020DFFCT-ND | TRANS NPN 20V 6.5A SOT23F-3 | Q1, Q2 | SOT23F - 3 Lead | 2 | Top
WAIT | PC PIN PRESS FIT CONN | ED1278-ND | CONN PC PIN CIRC 0.040DIA GOLD | J1, J2, J3 | PC PIN PRESS FIT | 3 | Top
SOLDER | PES1-S5-S9-M |  | 9V 1W single output isolated DC-DC converter | U2, U5 | PES1-M Single Output | 2 | Top
SOLDER | SI8271AB-IS | 336-3530-5-ND | DGTL ISO 2.5KV GATE DRIVER 8SOIC | U1, U4 | SOIC-8 | 2 | Top
SOLDER | 100n |  | C0603C104J4RACTU | C36, C38 | 0603 (1608) - cap | 2 | Bottom
SOLDER | 100uF | 587-3152-1-ND | CAP CER 100UF 16V X5R 1210 | C35 | 1210 Package | 1 | Bottom
SOLDER | 10u |  | GRM188R60J106ME47D | C37 | 0603 (1608) - cap | 1 | Bottom
SOLDER | 1K | RHM1.00KADCT-ND | RES SMD 1K OHM 1% 1/4W 0603 | R24, R28 | CAP0603 | 2 | Bottom
SOLDER | 1K5 | 311-1.5KGRCT-ND | RES SMD 1.5K OHM 5% 1/10W 0603 | R26, R27, R30 | CAP0603 | 3 | Bottom
SOLDER | 1u | 587-1241-1-ND | CAP CER 1UF 16V X7R 0603 | C32, C33, C34 | 0603 (1608) - cap | 3 | Bottom
SOLDER | 2.2K | 311-2.20KHRCT-ND | RES SMD 2.2K OHM 1% 1/10W 0603 | R25, R29 | 0603 (1608) | 2 | Bottom
SOLDER | 6V | MMSZ5233B-FDICT-ND | DIODE ZENER 6V 500MW SOD123 | D3, D5 | SOD123 | 2 | Bottom
WAIT | APF40-40-13CB |  | HEATSINK LOW-PROFILE FORGED | H1 | HEATSINK | 1 | Bottom
SOLDER | Diode | MMBD914TPMSCT-ND | DIODE GEN PURP 75V 150MA SOT23 | D2, D4 | SOT23-3 | 2 | Bottom
WAIT | FAN AXIAL 35X10MM 5VDC WIRE | 1053-1684-ND | Fan Tubeaxial 5VDC Square - 35mm L x 35mm H Ball 3.0 CFM (0.084m³/min) 2 Wire Leads | F1 | FAN 35X35X10MM | 1 | Bottom
SOLDER | GS66508T |  | GAN TRANS E-MODE 650V 30A TOP SIDE COOL | Q3, Q5, | GS66508T | 2 | Bottom
WAIT | GS66508T |  | GAN TRANS E-MODE 650V 30A TOP SIDE COOL | Q4, Q6 | GS66508T | 2 | Bottom
WAIT | Header 4x2 | 732-5353-ND | CONN HEADER R/A 8POS 2.54MM | J4 | HDR4X2_R/A | 1 | Bottom
SOLDER | NTE0505MC-R |  | NTE0505MC | U6 | NTE0505MC | 1 | Bottom
SOLDER | TLV3501AIDBVR | 296-35977-1-ND | IC COMP 4.5NS R-R HS SOT23-6 | U7 | SOT23-6 | 1 | Bottom

Sheet: TEST
 | Board Under Test | Test
1 | Half Bridge | 540V Clearence
2 | Mother Board | 540V Clearence
3 | Half Bridge | Soft Turn OFF Mechanism
4 | Half Bridge | Protection Signal Generation
5 | Mother Board | Overcurrent Protection
6 | Signal Board | PWM Generation
7 | Signal Board | LED Activation
8 | Signal Board | Push Button Interrupt
9 | Signal Board | Enable Signal Generation
10 | Signal Board | Tripzone Interrupt & Soft Start Trigging
11 | Signal Board | Analog Measurements
12 | Signal Board | 5V Loading
13 | Signal Board | 3V3 Loading
14 | Half Bridge | Single Bridge Switching Vgs
15 | Half Bridge | Single Bridge Switching Vds
16 | Half Bridge | Double Bridge Switching Vgs
17 | Half Bridge | Double Bridge Switching Vds
18 | Mother Board | Low Voltage Buck Performance
 |  | CLEARENCE TESTS
 | BUT | Test | Requirements | Expected Result | Observed Results
 | Half Bridge | DCP & DCN under 650V | Wire Soldering | Safe State | Safe State (850V)
 | Half Bridge | DCP & SWN under 650V | Wire Soldering | Safe State | Safe State (850V)
 | Half Bridge | DCN & SWN under 650V | Wire Soldering | Safe State | Safe State (850V)
 | Mother Board | DCP & DCN under 650V | Wire Soldering | Safe State | Safe State (850V)
 | Mother Board | DCP & SWN1 under 650V | Wire Soldering | Safe State | Safe State (850V)
 | Mother Board | DCN & SWN2 under 650V | Wire Soldering | Safe State | Safe State (850V)
 | Mother Board | DCP & SWN1 under 650V | Wire Soldering | Safe State | Safe State (850V)
 | Mother Board | DCN & SWN2 under 650V | Wire Soldering | Safe State | Safe State (850V)
 | Mother Board | SWN1 & SWN2 under 650V | Wire Soldering | Safe State | Safe State (850V)
 |  | SOFTWARE TESTS
 | Signal Board | DSP Board Pins Voltage Tests | Multimeter | 5V / 3V3 | No problem
 | Signal Board | 3V3 Loading | Electronic Load | Plot
 | Signal Board | PWM Generation | Waveform Obs. | PWM Signal | Faz açısı ayarlanamadı, SW2'ye basınca fazda kayma oluyor
 | Signal Board | Enable Signal Generation | Waveform Obs. | High Signal | EN signalleri üretildi
 | Signal Board | LED Activation | Observation | Radiation | LED Driver is changed
 | Signal Board | Push Button Interrupt | Observation | LED | DIN1 pin is changed
 | Signal Board | Tripzone Interrupt | Software Outcom | Variable | GPIO interrupt is which trigs STO with 10nsec delay
 | Signal Board | Soft & Hard Turn-off Mechanism | Waveform Obs. | Waveform | HTO is activated 250nsec after STO
 | Signal Board | Analog Measurement Curr1 | Waveform Obs. | Low noised signal | It is being measured without any problem
 | Signal Board | Analog Measurement Curr2 | Waveform Obs. | Low noised signal | It is being measured without any problem
 | Signal Board | Analog Measurement Volt1 | Waveform Obs. | Low noised signal | It is being measured without any problem
 | Signal Board | Analog Measurement Volt2 | Waveform Obs. | Low noised signal | It is being measured without any problem
 | Signal Board | Double Pulse Test Signal Generation | Waveform Obs. | Well defined pulse | The pulses are generated without any problem
 |  | HALF BRIDGE TESTS
 | Half Bridge -1 | Low DCV, Single Brg., DPT | Waveform Obs. | Vgs Waveform
 | Half Bridge -1 | Verification of Soft Turn-off | Waveform Obs. | Soft Turn-off
 | Half Bridge -1 | Verification of SCP Signal Generation | Waveform Obs. | dI/dt creation
 | Half Bridge -1 | Verification of SC Protection Mechanism | Waveform Obs. | Safe Turn-off
 | Half Bridge -1 | Mid DCV, Single Brg., DPT | Waveform Obs. | Vgs Waveform
 | Half Bridge -1 | Mid DCV, Single Brg., DPT | Waveform Obs. | Vds Waveform
 | Half Bridge -1 | Low DCV, Double Brg., DPT | Vgs Waveform Obs. | Vgs Waveforms
 | Half Bridge -1 | Low DCV, Double Brg., DPT | 9V, 5V Waveform Obs | DC Voltages
 | Half Bridge -1 | Mid DCV, Double Brg., DPT | Vgs Waveform Obs. | Vgs Waveforms
 | Half Bridge -1 | Mid DCV, Double Brg., DPT | Waveform Obs. | Vds Waveform
 | Half Bridge -1 | Mid DCV, Double Brg., DPT | 9V, 5V Waveform Obs | DC Voltages
 | Half Bridge -2 | Low DCV, Single Brg., DPT | Waveform Obs. | Vgs Waveform
 | Half Bridge -2 | Verification of Soft Turn-off | Waveform Obs. | Soft Turn-off
 | Half Bridge -2 | Verification of SCP Signal Generation | Waveform Obs. | dI/dt creation
 | Half Bridge -2 | Verification of SC Protection Mechanism | Waveform Obs. | Safe Turn-off
 | Half Bridge -2 | Mid DCV, Single Brg., DPT | Waveform Obs. | Vgs Waveform
 | Half Bridge -2 | Mid DCV, Single Brg., DPT | Waveform Obs. | Vds Waveform
 | Half Bridge -2 | Low DCV, Double Brg., DPT | Vgs Waveform Obs. | Vgs Waveforms
 | Half Bridge -2 | Low DCV, Double Brg., DPT | 9V, 5V Waveform Obs | DC Voltages
 | Half Bridge -2 | Mid DCV, Double Brg., DPT | Vgs Waveform Obs. | Vgs Waveforms
 | Half Bridge -2 | Mid DCV, Double Brg., DPT | Waveform Obs. | Vds Waveform
 | Half Bridge -2 | Mid DCV, Double Brg., DPT | 9V, 5V Waveform Obs | DC Voltages
 |  | BUCK CONVERTER TESTS
