furkankarakaya/GaN-Studies/Thesis/Figures/Ch5/Ch5_CCM_Steps_0.pdf

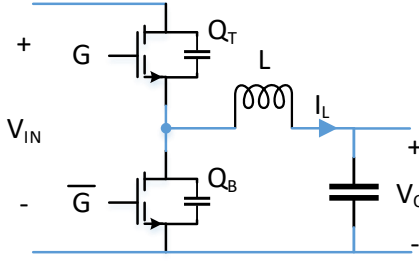
[picture p332: figure]
+-VIN
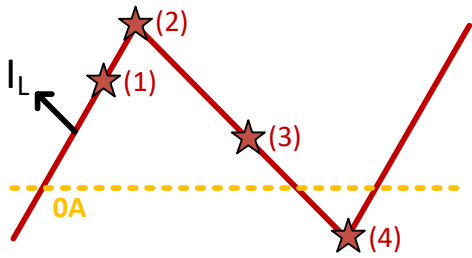
[picture p333: figure]

# +- VOUT
