furkankarakaya/GaN-Studies/Thesis/Figures/Ch5/Ch5_CCM_Steps_1.pdf

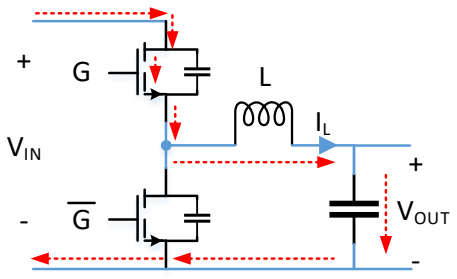
[picture p334: figure]
+-VIN; +- VOUT
