furkankarakaya/GaN-Studies/Thesis/Figures/Ch5/Ch5_CCM_Steps_3.pdf

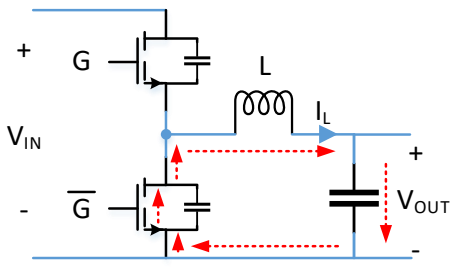
[picture p335: figure]
+-VIN; +- VOUT
