furkankarakaya/GaN-Studies/Thesis/Presentation/CCM_Steps_0.jpg

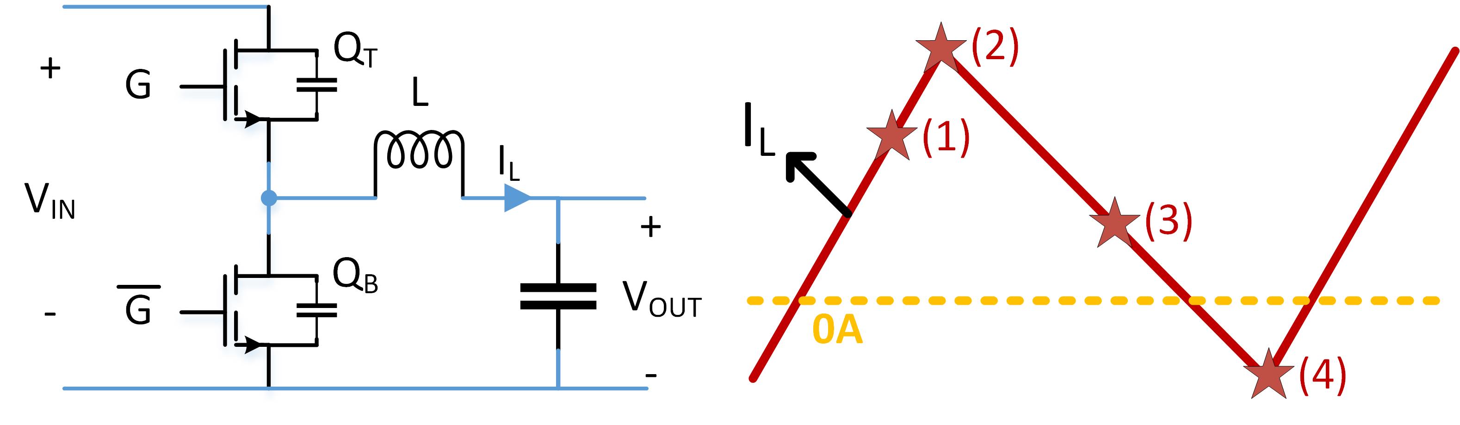
Thesis/Presentation/CCM_Steps_0.jpg
