furkankarakaya/GaN-Studies/Thesis/Presentation/CCM_Steps_1.jpg

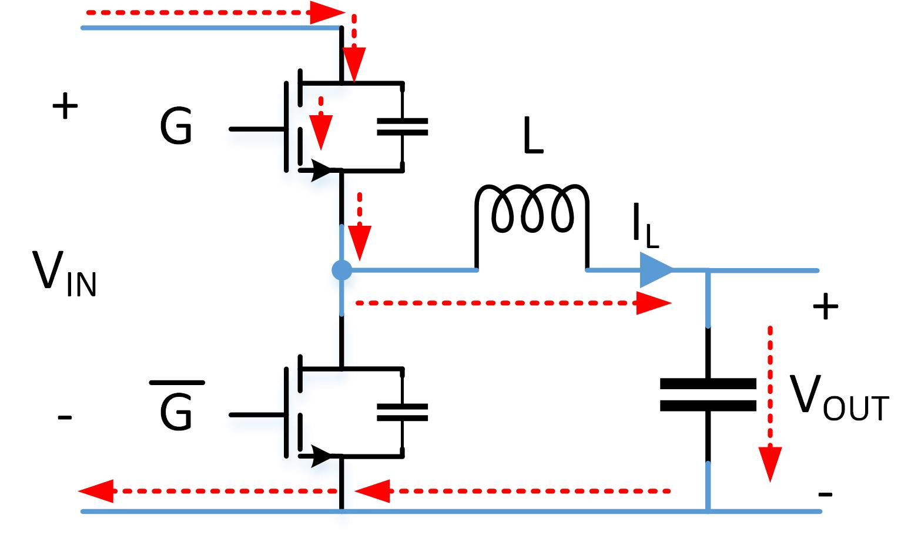
Thesis/Presentation/CCM_Steps_1.jpg
