furkankarakaya/GaN-Studies/Thesis/Presentation/CCM_Steps_2.jpg

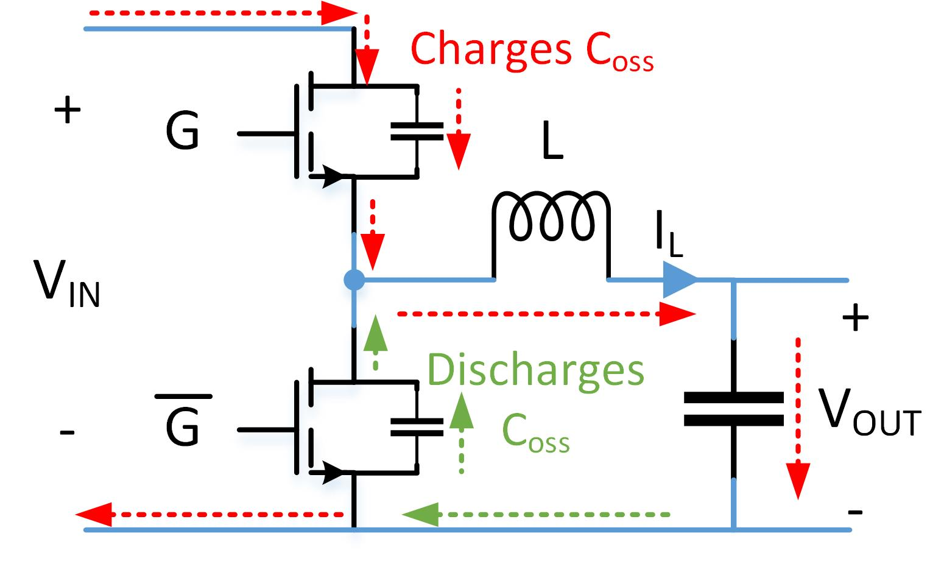
Thesis/Presentation/CCM_Steps_2.jpg
