furkankarakaya/GaN-Studies/Thesis/Presentation/CCM_Steps_3.jpg

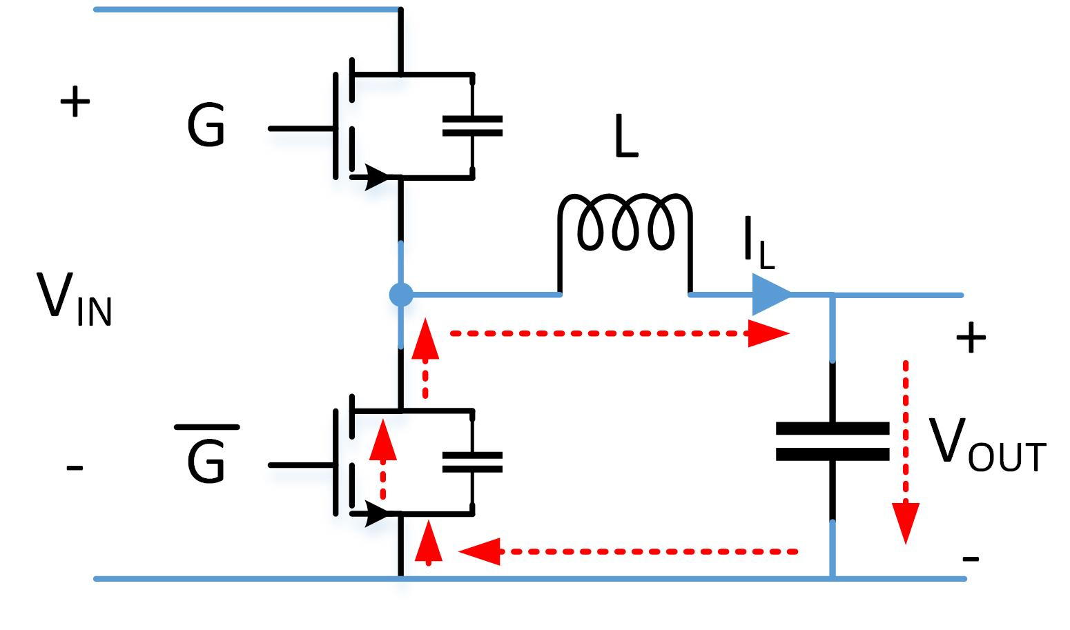
Thesis/Presentation/CCM_Steps_3.jpg
