furkankarakaya/GaN-Studies/Thesis/Presentation/CCM_Steps_4.jpg

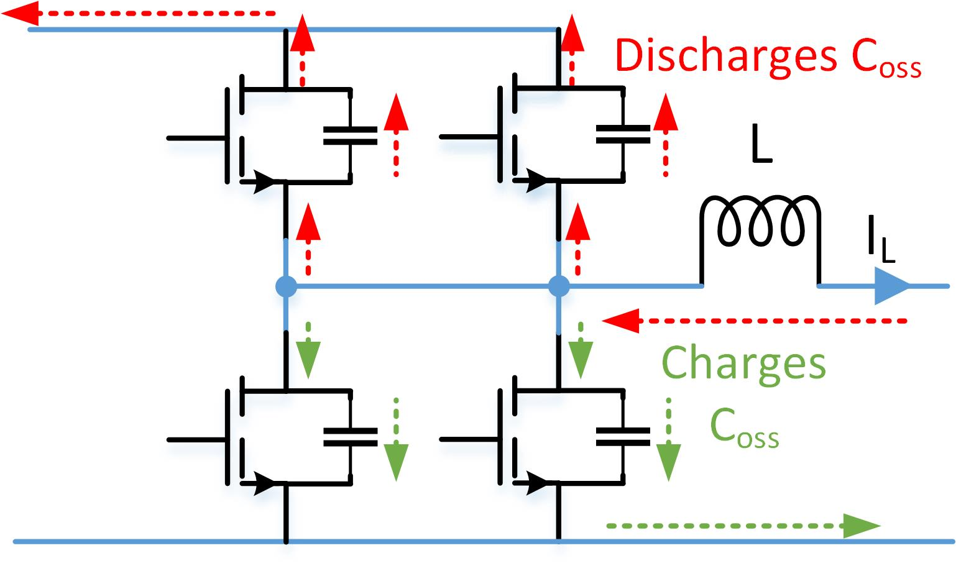
Thesis/Presentation/CCM_Steps_4.jpg
