furkankarakaya/GaN-Studies/Measurement.md

## How to Measure

#### Current Measurement
There are five different methods to measure device current. </br>
* Shunt Resistor
* Rogowski Coil
* Hall sensor & Current transformer
* PCB coupled magnetic measurement design
* Current Probe

##### Pros and Cons of Shunt Resistor
+ Simple method
+ Voltage probe is enough to measures
- Special HBW shunt resistor is required because for standard chip resistors the resistance increases as the frequency increases due to the skin effect and proximity effect; the total impedance of the resistor increases with frequency because of the series inductance(1)
+ Coaxial shunt resistors have BW up to 2 GHz
- Coaxial shunt resistors are rare and expensive
- Protection should be taken into consideration
- The power is limited (2W)
- Increase in parasitic inductance on power loop

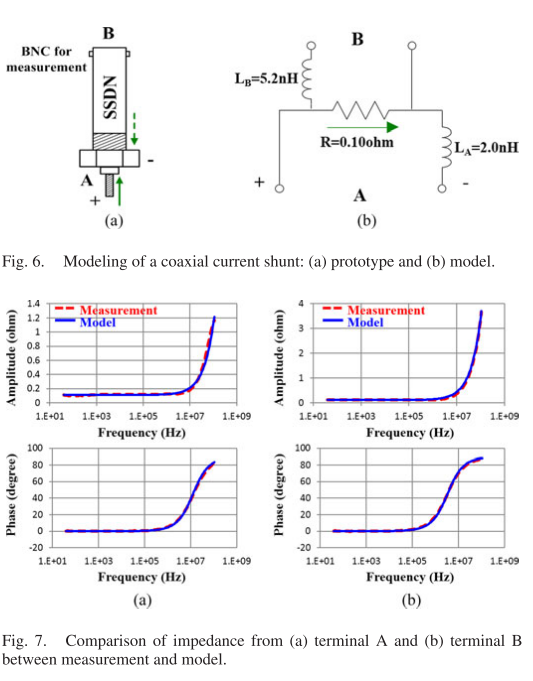
[picture p341: images/ShuntResistorCharacteristic.png]
</br>
</br>(Liu, Z., Huang, X., Lee, F. C., & Li, Q. (2014). Package parasitic inductance extraction and simulation model development for the high-voltage cascode GaN HEMT. IEEE Transactions on Power Electronics, 29(4), 1977–1985. https://doi.org/10.1109/TPEL.2013.2264941)

##### Pros and Cons of Rogowski Coil
+ Simple method
+ Large currents can be measure safely
+ Isolated
- Too low bandwidth (max 30 MHz)

##### Pros and Cons of Hall Sensor & Current transformer
+ Average simplicity
+ Saturation problem, so large amount of currents cannot be measured
+ Mutuality changes with frequencies, compensation is required

##### Pros and Cons of PCB coupled magnetic measurement design(1)
- Complex solution
+ Cheap
+ More research
+ Frequency dependent compensation algorithm is required
+ HBW voltage probe is enough
</br>*(1) https://ieeexplore.ieee.org/document/8025825/*

##### Pros and Cons of Current Probe
- Requires high BW current probe (>350 MHz) so its expensive
+ Very simple

#### Voltage Measurement

Voltage measurement is simpler than current measurement. A voltage probe with BW larger than 350 MHz is enough. </br>
On the PCB, the vias/holes should be placed close to the DUT.

#### Parasitic Inductance Measurement
*  FEA solution: The package geometry is imported into the FEA program

#### Parasitic Capacitance Measurement
* High frequency AC voltage is applied to the terminal whose capacitance is under observation. Another DC bias is connected to change the level. Then, the AC current is followed so that the impedance can be estimated. The resulting impedance is the way how the capacitance is measured. The method is illustrated below:
</br>
</br>(Xie, R., Yang, X., Xu, G., Wei, J., Wang, Y., Wang, H., … Chen, K. J. (2018). Switching Transient Analysis for Normally-Off GaN Transistors with p-GaN Gate in a Phase-Leg Circuit. IEEE Transactions on Power Electronics, PP(c), 1–1. https://doi.org/10.1109/TPEL.2018.2852142)

#### Circuit Inductance Measurement
*  FEA solution: The circuit geometry is imported into the FEA program
