furkankarakaya/GaN-Studies/Measurement Device List.xlsx

Static I-V Char | C-V Char | Impedance Analyzer
Agilent B1505A Power Device Analyzer (https://literature.cdn.keysight.com/litweb/pdf/5990-3853EN.pdf?id=784455) | Agilent B1505A Power Device Analyzer (https://literature.cdn.keysight.com/litweb/pdf/5990-3853EN.pdf?id=784455) | HP4294A (https://www.keysight.com/en/pd-1000000858%3Aepsg%3Apro-pn-4294A/precision-impedance-analyzer-40-hz-to-110-mhz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)
 | Keithley 590 CV Analyzer (https://www.tek.com/manual/model-590-cv-analyzer-instruction-manual-rev-d-197mb) | Wayne-Kerr 65120P (LCR Meter) (http://www.waynekerr.com/productDetail6500P.shtml)
 |  | Agilent 4935A network analyzer (https://www.keysight.com/en/pd-4935A%3Aepsg%3Apro-pn-4935A/transmission-impairment-measurement-set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)
