furkankarakaya/GaN-Studies/Test Results/InductorThermalTest.xlsx

fsw | Duty | Vin | Vout | Dcalc | Ripple | Temp (.C) | FAN
150000 | 0.788 | 171 | 135 | 0.7894736842 | 27.86377709 | 93 | Yes
200000 | 0.717 | 180 | 131 | 0.7277777778 | 26.22140523 | 109 | Yes
