furkankarakaya/GaN-Studies/Test Results/Thermal Current vs Voltage.xlsx

Current | Voltage | mOhm | Loss | Ths | Tamb | Rhs | Rtim | Rjc | Tj
7.51 | 0.33 | 43.94 | 2.4783 | 29.20 | 20.00 | 3.712222088 | 3.50 | 0.50 | 39.11
10.00 | 0.47 | 47.00 | 4.7 | 35.50 | 20.00 | 3.29787234 | 3.50 | 0.50 | 54.30
11.00 | 0.53 | 48.18 | 5.83 | 38.50 | 20.00 | 3.173241852 | 3.50 | 0.50 | 61.82
12.00 | 0.61 | 50.83 | 7.32 | 42.50 | 20.00 | 3.073770492 | 3.50 | 0.50 | 71.78
13.00 | 0.68 | 52.31 | 8.84 | 46.80 | 20.00 | 3.031674208 | 3.50 | 0.50 | 82.16
14.01 | 0.79 | 56.39 | 11.0679 | 51.70 | 20.00 | 2.864138635 | 3.50 | 0.50 | 95.97
15.00 | 0.90 | 60.00 | 13.5 | 58.90 | 20.00 | 2.881481481 | 3.50 | 0.50 | 112.90
15.99 | 1.04 | 65.04 | 16.6296 | 66.50 | 20.00 | 2.796218791 | 3.50 | 0.50 | 133.02
