furkankarakaya/GaN-Studies/Protection Circuits/TPEL Letter/Experiments.xlsx

Sheet: DPT
400V | 40A | 400V | 30A | 300V | 30A
Load Voltage |  | Load Voltage |  | Load Voltage
Load Current |  | Load Current |  | Load Current
VgsTop |  | VgsTop |  | VgsTop
VgsBot |  | VgsBot |  | VgsBot
Vinduced |  | Vinduced |  | Vinduced
Vfiltout |  | Vfiltout |  | Vfiltout
2020.05.04 - STO HTO |  | 2020.04.21 - LowerCurrent
200V | 20A | 100V | 10A
Load Voltage |  | Load Voltage
Load Current |  | Load Current
VgsTop |  | VgsTop
VgsBot |  | VgsBot
Vinduced |  | Vinduced
Vfiltout |  | Vfiltout

Sheet: SCP
100V
Vinduced
Vfiltout
200V
Vinduced
Vfiltout
300V
Vinduced
Vfiltout
400V | 2020.04.28 - SC400
Vinduced
Vfiltout
