furkankarakaya/GaN-Studies/Thesis/Figures/Ch1/Ch1_CapMeasure1.pdf

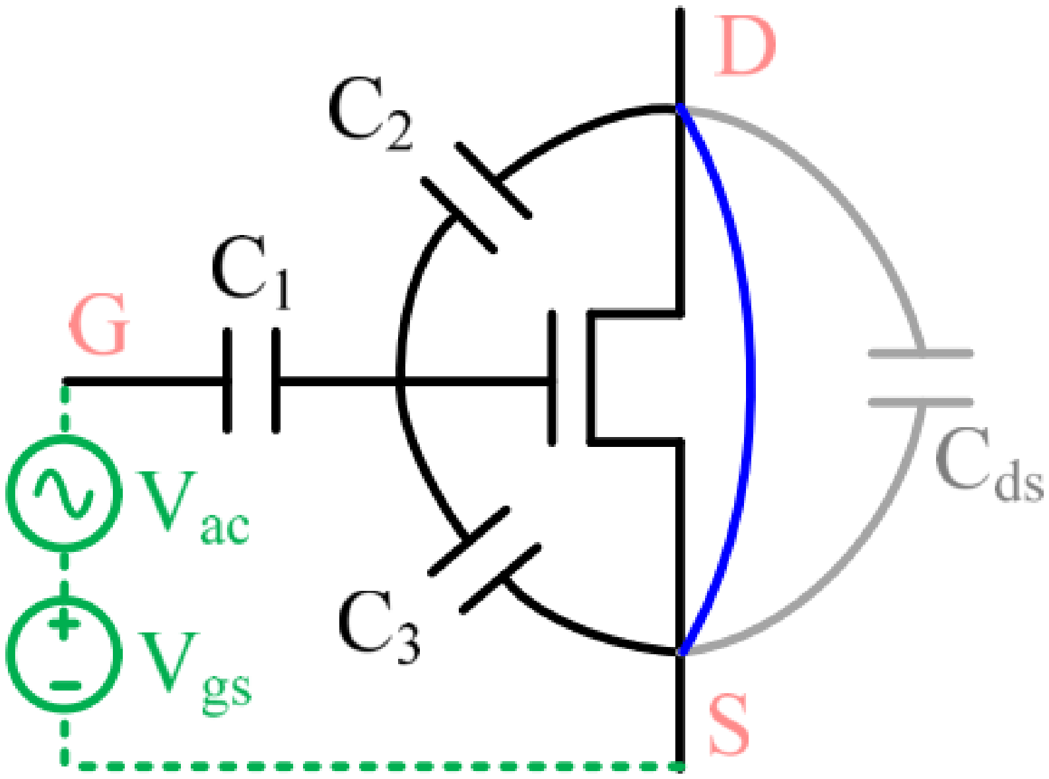
[picture p353: page 1]
