furkankarakaya/GaN-Studies/Coss Characterization/CossVds.xlsx

time | V(pay)/(D(V(Vind,Vtr))/D(time)흏9*V(Vind,Vtr)) | V(vtr)
0 | 4.616946e-07 | 1.000000e퍍
1.056735058e-12 | 0.01223339 | 1.000000e퍍
1.170205181e-12 | 4.461664e-07 | 1.000000e퍍
1.397145428e-12 | 4.46161e-07 | 1.000000e퍍
1.851025922e-12 | 4.461556e-07 | 1.000000e퍍
2.758786909e-12 | 4.461393e-07 | 1.000001e퍍
4.574308884e-12 | 4.75848e-07 | 1.000001e퍍
8.205352834e-12 | 4.757863e-07 | 1.000002e퍍
1.546744073e-11 | 4.673175e-07 | 1.000003e퍍
2.4258215e-11 | 4.751852e-07 | 1.000005e퍍
3.361029054e-11 | 4.924257e-07 | 1.000007e퍍
4.457087743e-11 | 4.982778e-07 | 1.000009e퍍
5.493433614e-11 | 5.09791e-07 | 1.000011e퍍
6.990438965e-11 | 5.255998e-07 | 1.000014e퍍
8.710054729e-11 | 5.518509e-07 | 1.000017e퍍
1.104628129e-10 | 5.712443e-07 | 1.000022e퍍
1.383176612e-10 | 6.028035e-07 | 1.000026e퍍
1.756797133e-10 | 6.561092e-07 | 1.000032e퍍
2.220472264e-10 | 7.276925e-07 | 1.000039e퍍
2.844903084e-10 | 8.33075e-07 | 1.000047e퍍
3.66444081e-10 | 1.012163e-06 | 1.000057e퍍
4.846978126e-10 | 1.276357e-06 | 1.000067e퍍
6.657070054e-10 | 1.578112e-06 | 1.000080e퍍
8.727863604e-10 | 1.865131e-06 | 1.000092e퍍
1.153137845e-09 | 1.991263e-06 | 1.000106e퍍
1.441818922e-09 | 2.222867e-06 | 1.000120e퍍
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
