furkankarakaya/GaN-Studies/Test Results/Buck Thermal Tests/Average Change.xlsx

Sheet: buck
 | without fan |  |  |  |  |  |  |  |  | with fan
Iout | 5.80 | 5.80 | 3.60 | 11.10 | 5.80 | 5.80 | 6.30 | 5.80 | 3.07 | 3.09 | 6.06 | 9.24 | 12.52 | 14.68 | 18.50 | 20.03
Ripple | 27.50 | 20.00 | 20.20 | 20.00 | 15.80 | 10.40 | 23.80 | 23.40 | 28.20 | 28.50 | 28.20 | 28.50 | 28.20 | 28.20 | 28.20 | 28.5
Pin | 844.00 | 790.00 | 331.00 | 1597.00 | 447.00 | 446.00 | 899.00 | 775.00 | 894.00 | 906.00 | 1705.00 | 2590.00 | 3490.00 | 4080.00 | 5094.00 | 5510
Vout |  |  |  |  |  |  |  |  | 272.40 | 274.40 | 270.00 | 271.50 | 270.20 | 270.00 | 267.10 | 266
Rout | 24.20 | 24.20 | 24.20 | 13.50 | 13.50 | 13.50 | 24.20 | 24.05 | 90.00 | 90.00 | 45.00 | 30.00 | 22.50 | 18.00 | 15.00 | 13.5
HS1 | 63.00 | 43.00 | 45.50 | 47.00 | 40.00 | 34.00 | 52.50 | 51.00 | 59.00 | 57.50 | 57.50 | 61.00 | 63.00 | 65.00 | 70.00 | 73 | 25 | 80
HS2 | 62.30 | 42.50 | 45.50 | 46.00 | 39.00 | 33.50 | 52.50 | 49.00 | 55.00 | 52.00 | 52.00 | 55.00 | 57.50 | 60.00 | 63.00 | 66
WIND1 | 120.00 | 73.00 | 79.00 | 76.50 | 56.00 | 40.50 | 93.50 | 93.00 | 131.00 | 86.00 | 87.00 | 88.00 | 90.00 | 92.00 | 92.50 | 98
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
