furkankarakaya/GaN-Studies/Coss Characterization/Sample2.jpg

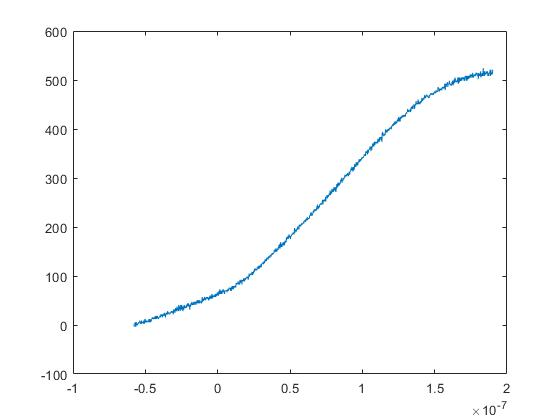
Coss Characterization/Sample2.jpg
