furkankarakaya/GaN-Studies/Coss Characterization/Sample3.jpg

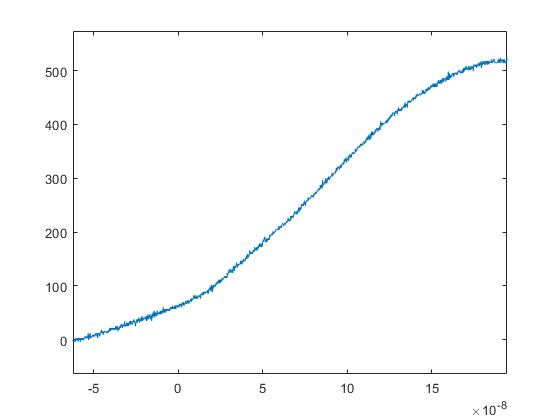
Coss Characterization/Sample3.jpg
