furkankarakaya/GaN-Studies/Coss Characterization/Sample4.jpg

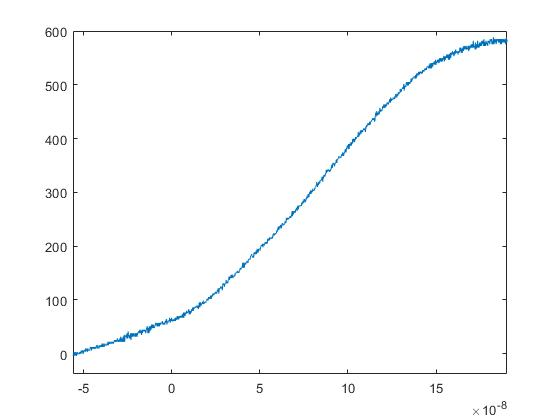
Coss Characterization/Sample4.jpg
