furkankarakaya/GaN-Studies/Coss Characterization/Vds100.jpg

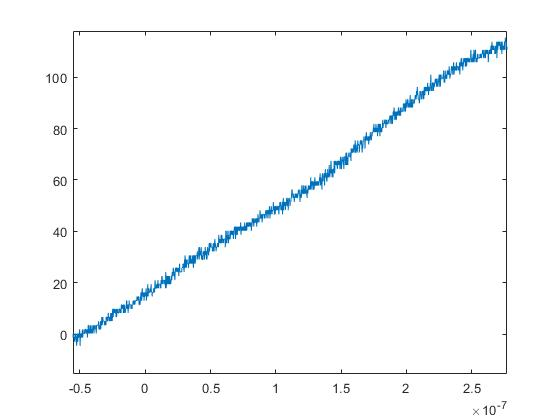
Coss Characterization/Vds100.jpg
