furkankarakaya/GaN-Studies/Coss Characterization/Vds.jpg

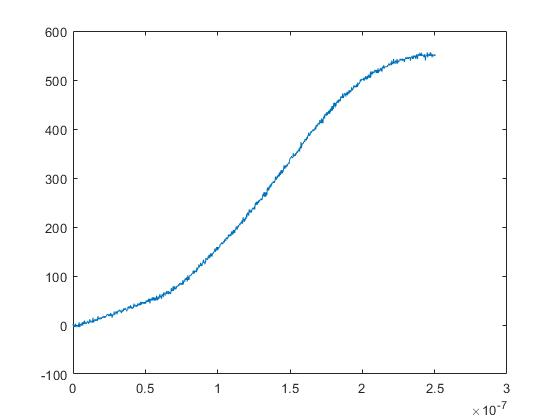
Coss Characterization/Vds.jpg
