furkankarakaya/GaN-Studies/Test Results/2020.08.19 - 270to400Tests/FLIR0866.jpg

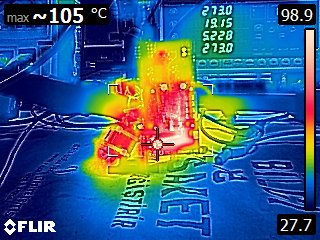
Test Results/2020.08.19 - 270to400Tests/FLIR0866.jpg
