furkankarakaya/GaN-Studies/Thesis/Presentation/CossTestCircuitt.jpg

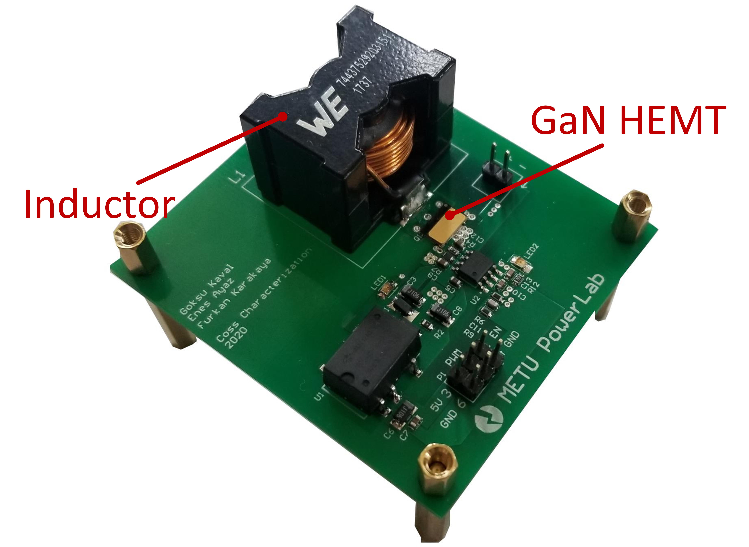
Thesis/Presentation/CossTestCircuitt.jpg
