furkankarakaya/GaN-Studies/Protection Circuits/TPEL Letter/PaperFigures/Fig17-Symbolic Layout-v2.pdf

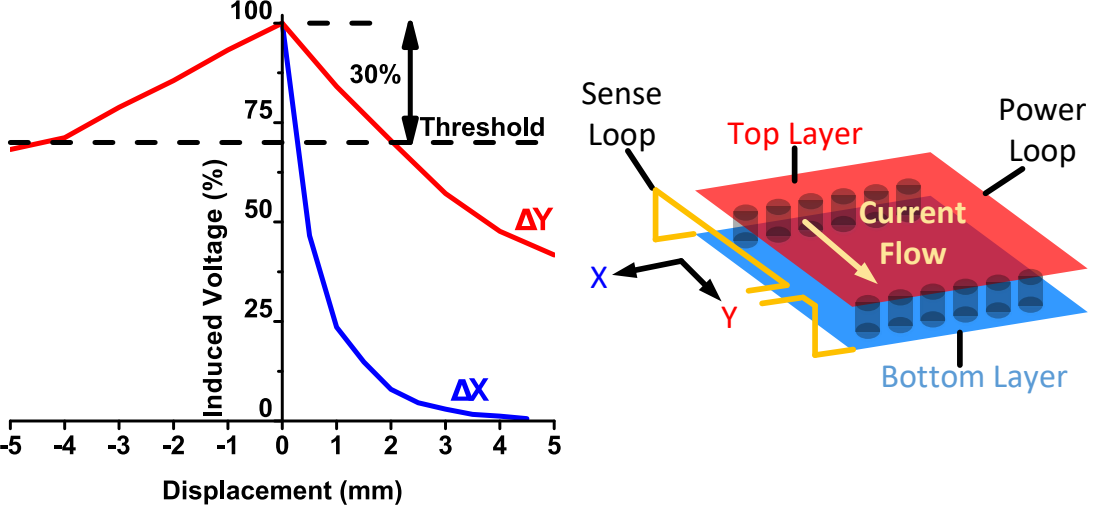
[picture p382: page 1]
Top Layer; Bottom Layer; Sense Loop; Power Loop; Current Flow
