furkankarakaya/GaN-Studies/Protection Circuits/TPEL Letter/PaperFigures/Fig5-SymbolicLayout.pdf

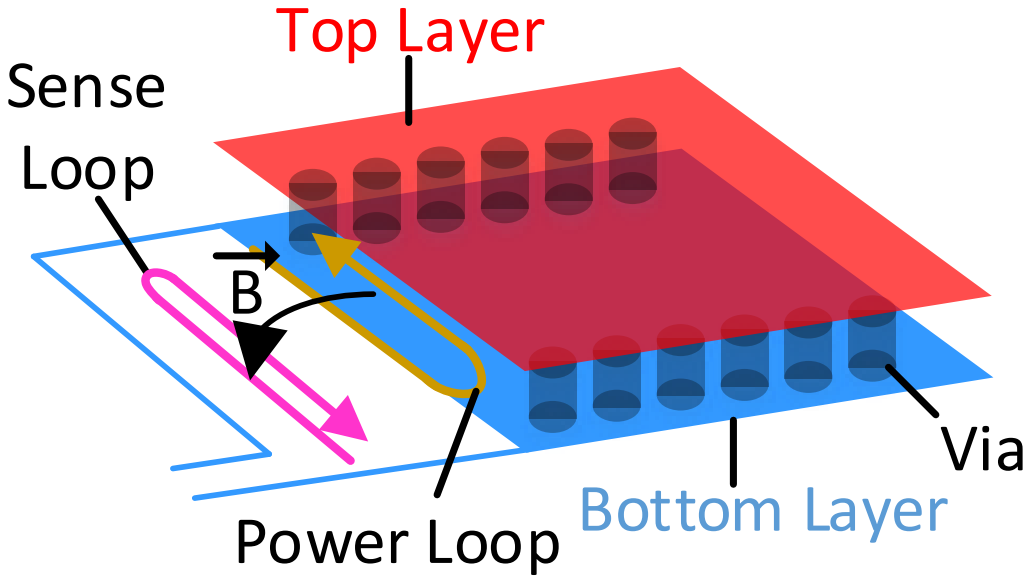
[picture p383: page 1]
Top Layer; Bottom Layer; Via; Sense Loop; Power Loop
