furkankarakaya/GaN-Studies/Protection Circuits/TPEL Letter/PaperFigures/Fig14-DPTandSCPVfiltouts.pdf

0

500

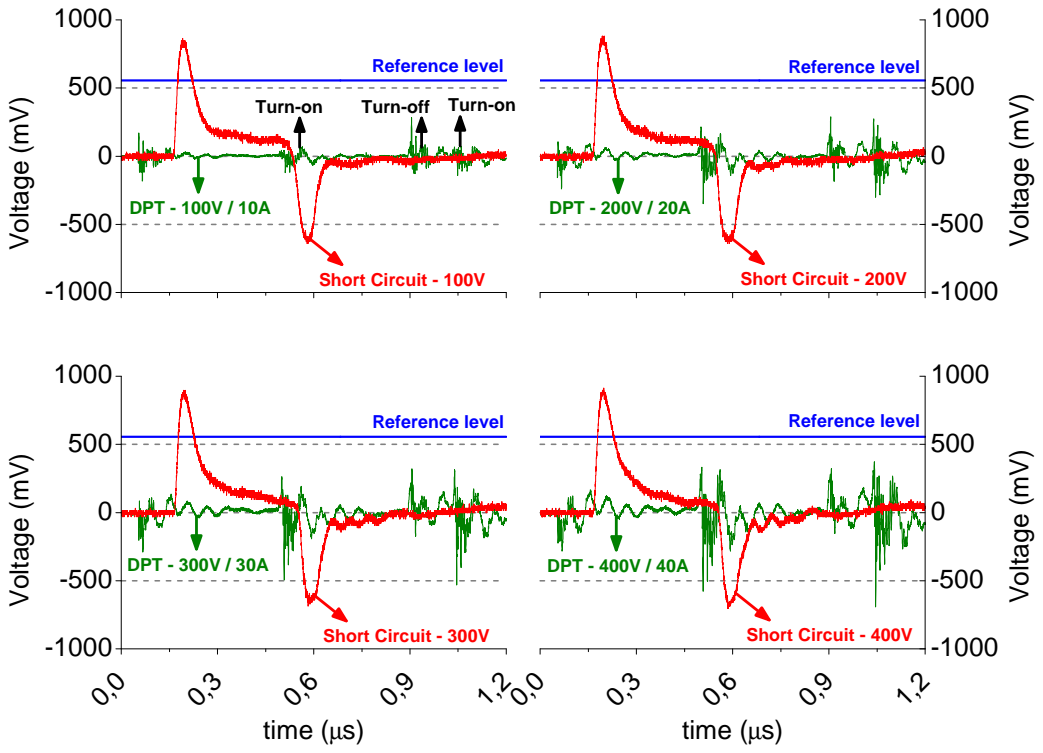
[picture p384: page 1]
DPT - 1 00V / 1 0A; DPT - 200V / 20A; DPT - 300V / 30A; Referen ce; Referen ce l evel l evel; DPT - 400V / 40A

Referen ce l evel
Tu rn -off

Short Circu it - 1 00V

Short Circu it - 200V

Short Circu it - 300V
tim e (µs)

Short Circu it - 400V
