furkankarakaya/GaN-Studies/Protection Circuits/TPEL Letter/PaperFigures/Fig2-SignalProcessingBlock - v2.pdf

μC

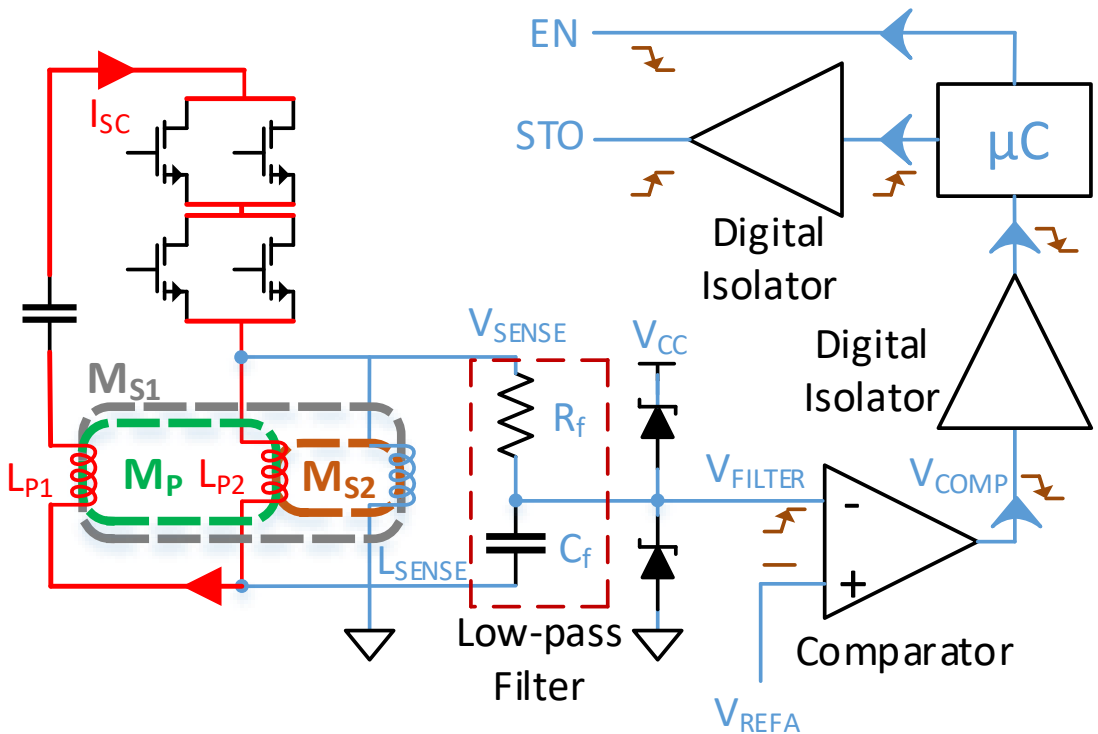
[picture p385: page 1]
VREFA; VCC; ISC; STO; Comparator; Digital Isolator; Low-pass Filter; VFILTER; VCOMP; VSENSE; LSENSE
