furkankarakaya/GaN-Studies/Protection Circuits/TPEL Letter/PaperFigures/Fig6-LayoutDrawing.pdf

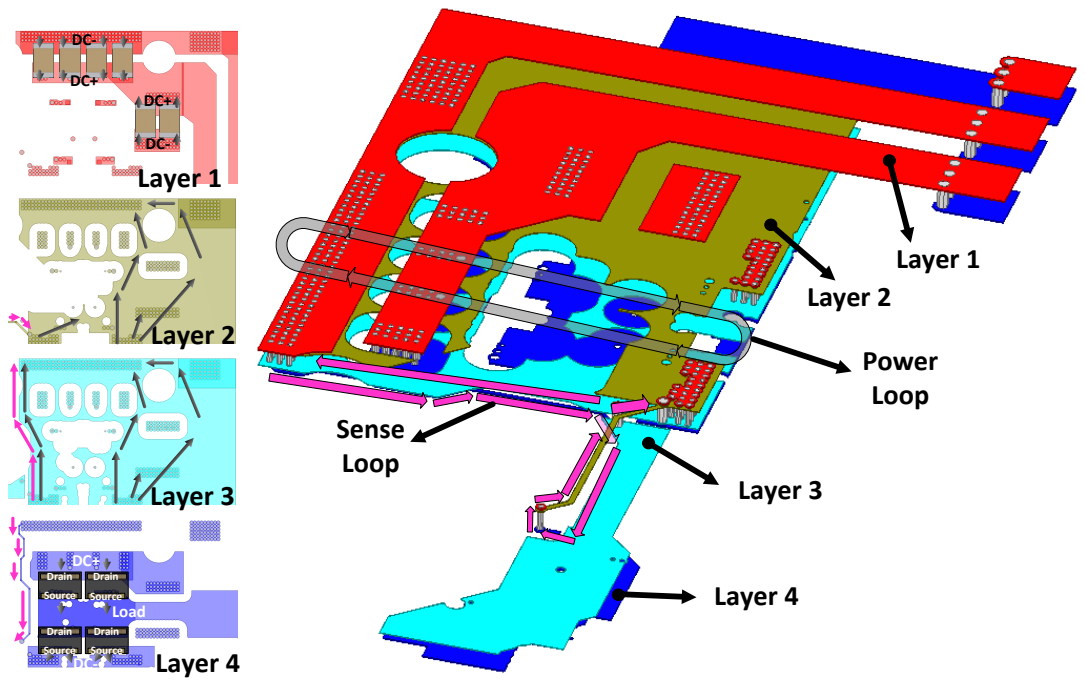
[picture p386: page 1]
Drain; Source; Load; Layer 1; Layer 2; Layer 3; Layer 4; Power Loop; Sense Loop
