furkankarakaya/GaN-Studies/Thesis/Figures/Ch5/Ch5_LogicDiagram.pdf

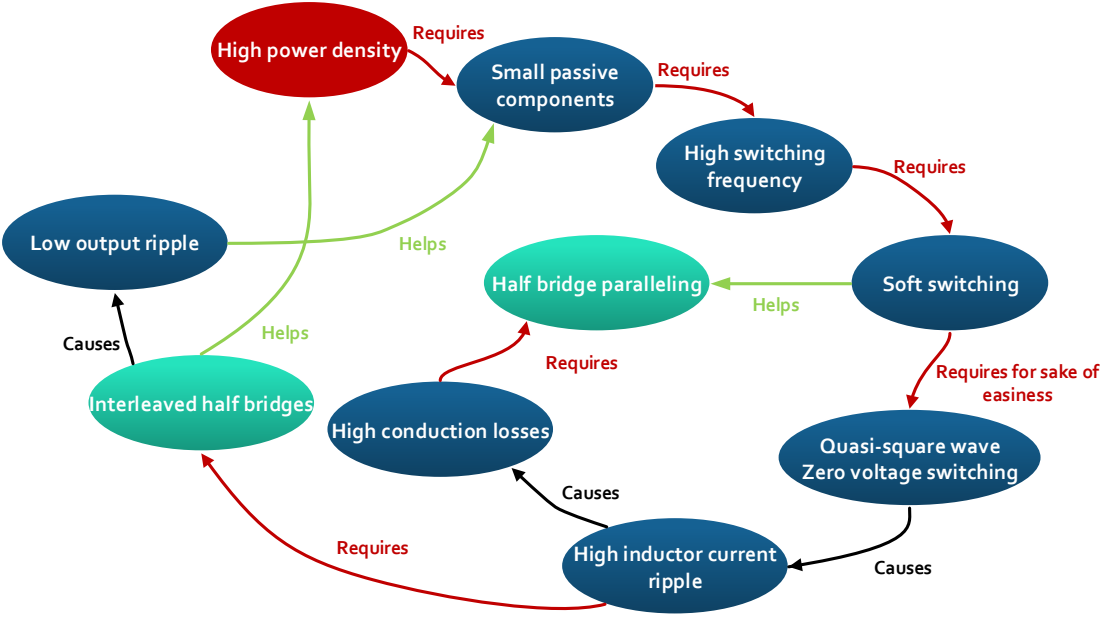
[picture p387: page 1]
High switching frequency; Soft switching; ripple; Small passive components; Requires; Causes; Helps

High power density

Low output ripple

Half bridge paralleling

Requires for sake of
easiness

Interleaved half bridges

High conduction losses

Quasi-square wave
Zero voltage switching

High inductor current
