furkankarakaya/GaN-Studies/Thesis/Figures/Ch6/Ch6_ConverterFOM.pdf

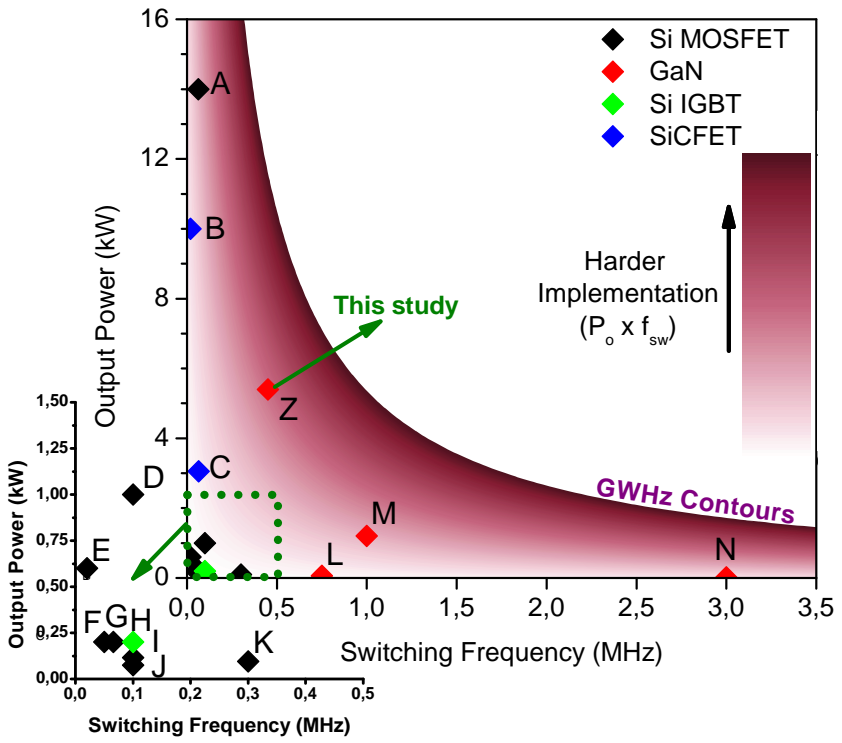
[picture p388: page 1]
GWH z Con tou rs; Th i s study; Si MOSFE T GaN Si I GBT SiCFE T

H arder
I m pl em en tati on

Swi tch i n g Frequ en cy (MH z)
Switch i n g Frequ en cy (MHz)
