furkankarakaya/GaN-Studies/Thesis/Figures/Ch5/Ch5_CCM_HowAchieved.pdf

## +-VIN

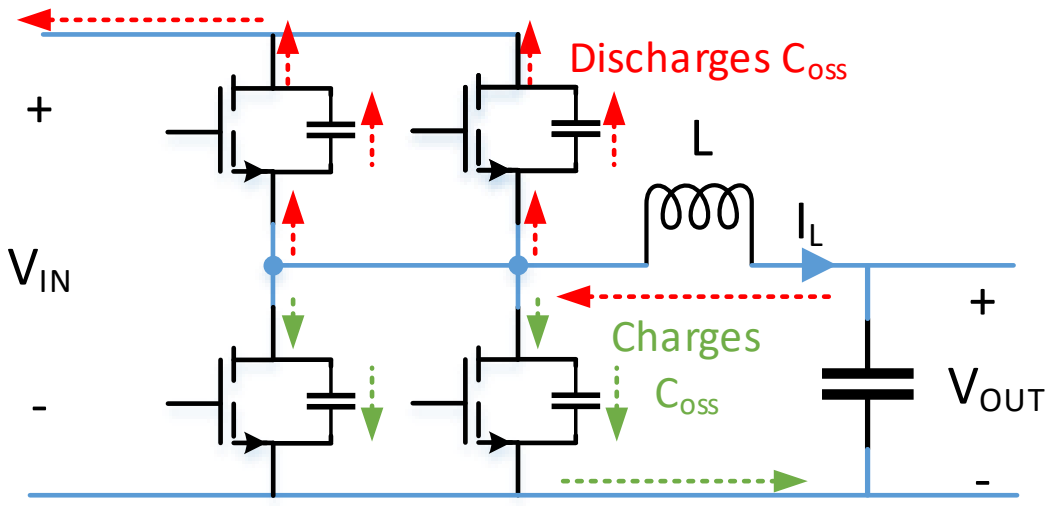
[picture p389: page 1]
Discharges Coss; Charges Coss; +- VOUT
