furkankarakaya/GaN-Studies/Thesis/Figures/Ch5/Ch5_Converter3D.pdf

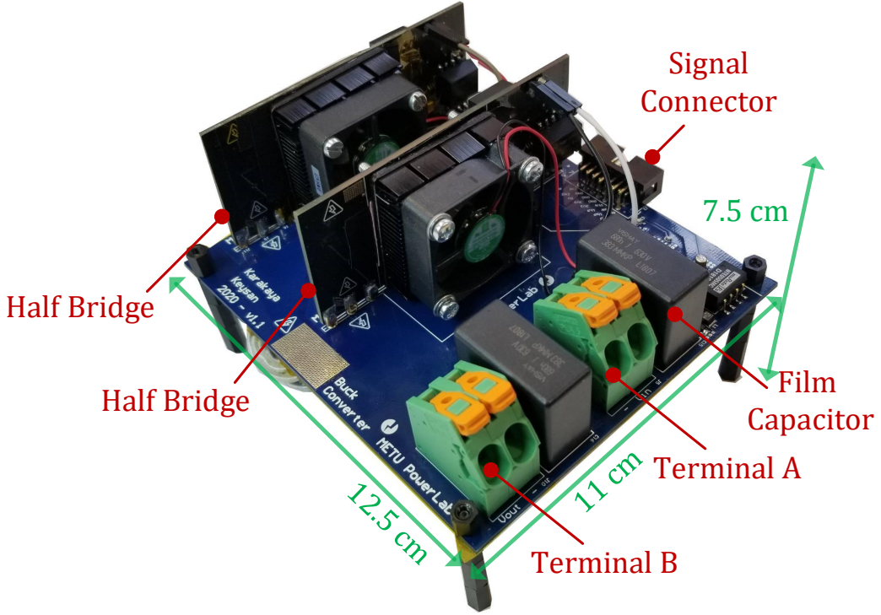
[picture p390: page 1]
Terminal A; Terminal B; Film Capacitor; Half Bridge; Signal Connector
