furkankarakaya/GaN-Studies/Protection Circuits/TPEL Letter/PaperFigures/Fig16-FFT_DPTvsSCPExp.pdf

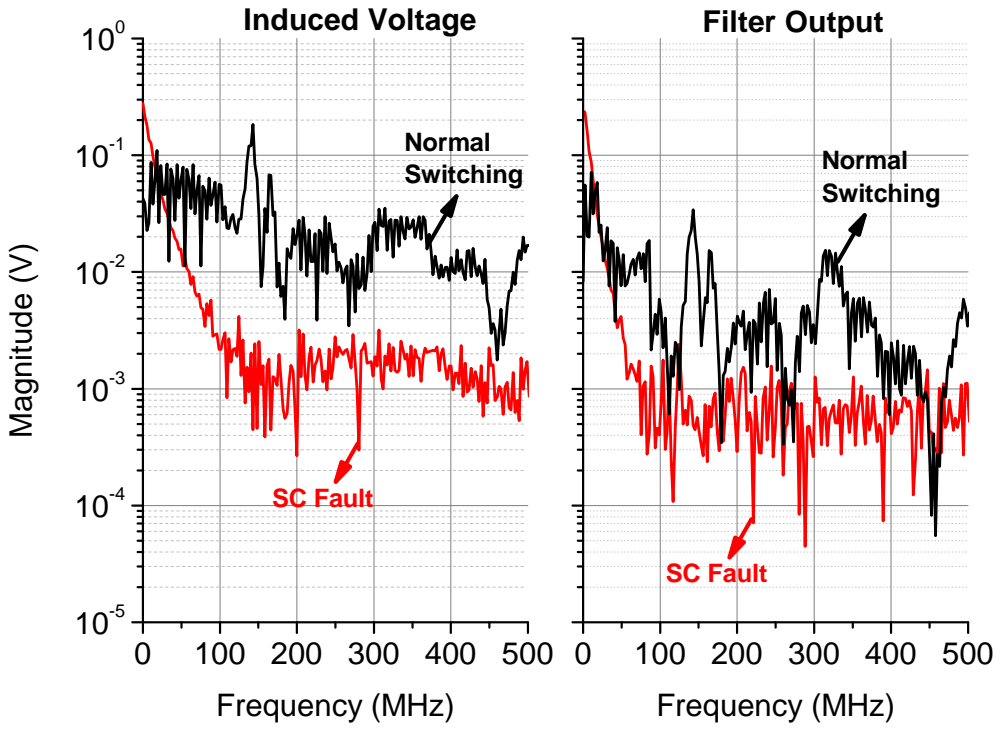
[picture p391: page 1]
I n du ced Voltage; Fi lter Ou tpu t; SC Fau lt; Frequ en cy (MH z); Normal; Switch i ng

SC Fau lt
Frequ en cy (MH z)
