furkankarakaya/GaN-Studies/Protection Circuits/TPEL Letter/PaperFigures/Fig3-GateDriver.pdf

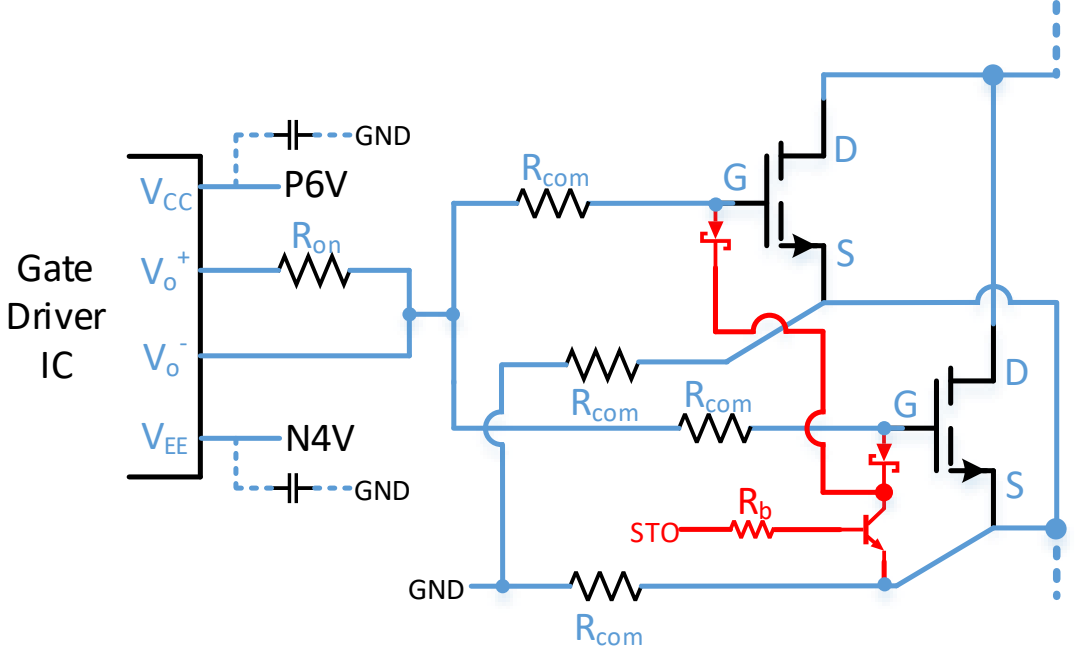
[picture p392: page 1]
Ron; VCC VEE; Gate Driver IC; GND; Rcom; STO; Rcom Rcom
