furkankarakaya/GaN-Studies/Thesis/Figures/Ch4/Ch4_DPT.pdf

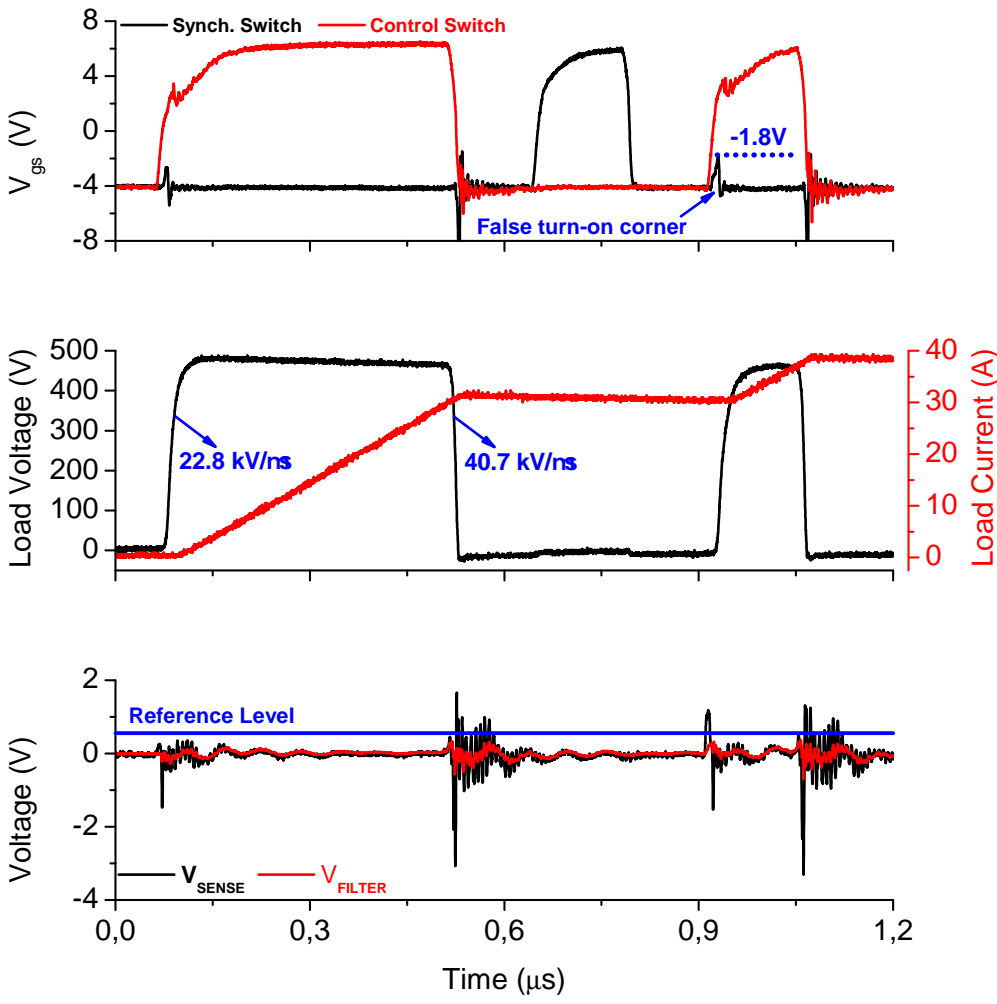
[picture p393: page 1]
Referen ce Level; Syn ch . Switch; Con trol Switch; VSENSE; VFILTER; Tim e (µs)

Fal se tu rn -on corn er
