furkankarakaya/GaN-Studies/Thesis/Figures/Ch4/Ch4_PCBFEA.pdf

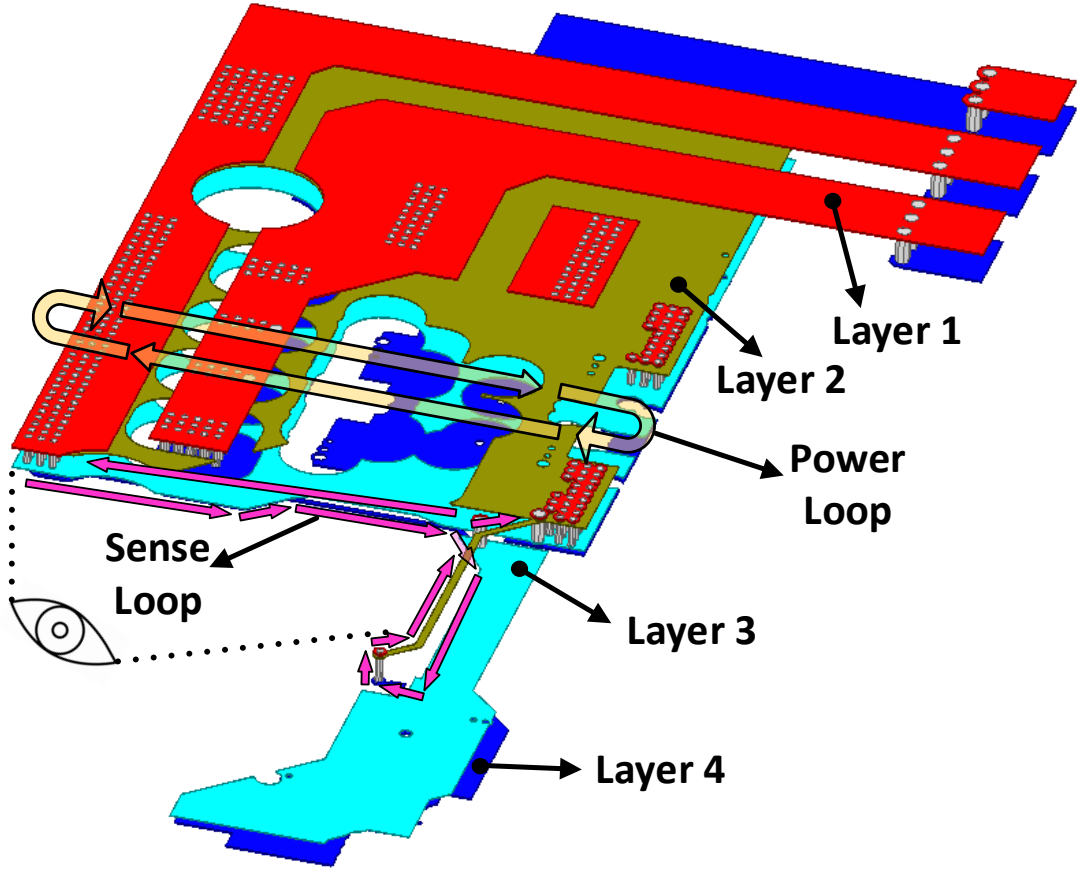
[picture p394: page 1]
Layer; Power Loop; Sense Loop
