furkankarakaya/GaN-Studies/Thesis/Figures/Ch4/Ch4_SCP_Vfiltout_Vind.pdf

0

500

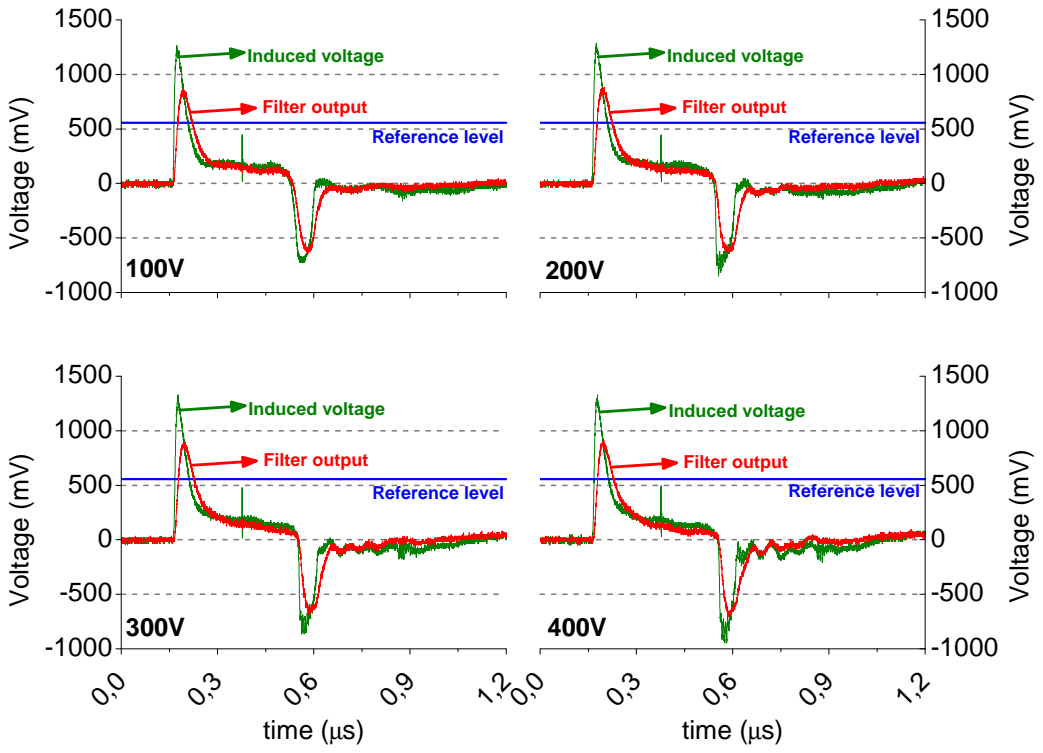
[picture p395: page 1]
I n du ced voltage; Referen ce; Referen ce l evel l evel; tim e (µs)

Fi lter ou tpu t
Referen ce l evel

I n du ced voltage
