furkankarakaya/GaN-Studies/Thesis/Figures/Ch4/Ch4_SignalProcessingBlock.pdf

μC

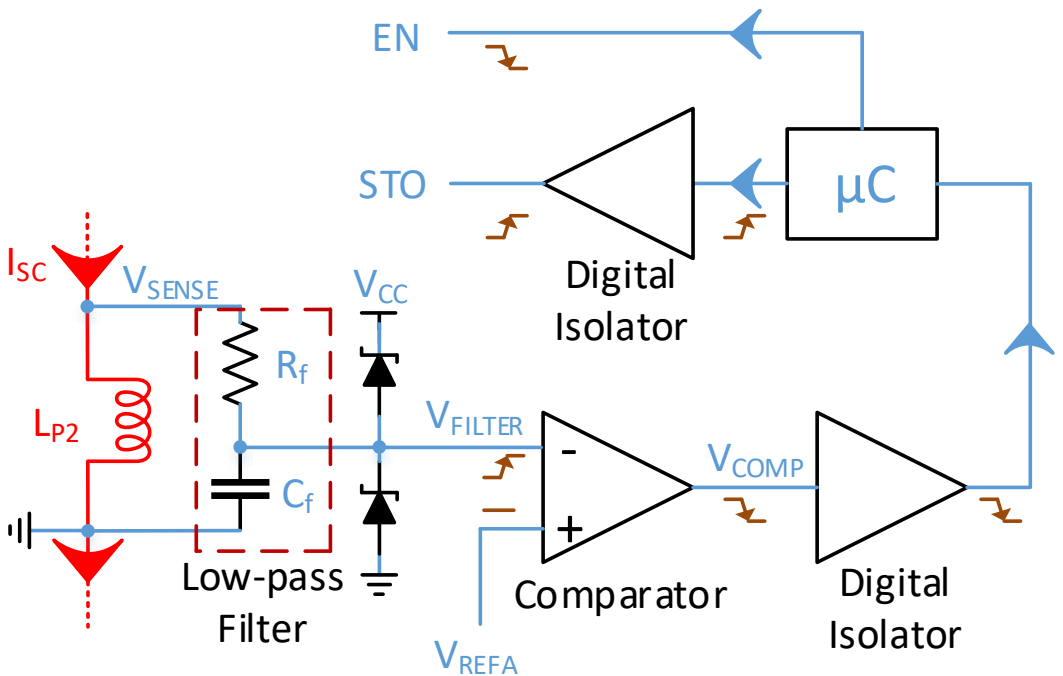
[picture p396: page 1]
VREFA; VCC; ISC; STO; Comparator; Digital; Isolator; Digital Isolator; Low-pass Filter; VFILTER; VCOMP; VSENSE
