furkankarakaya/GaN-Studies/Protection Circuits/TPEL Letter/PaperFigures/Fig8-DPTvsSCP.pdf

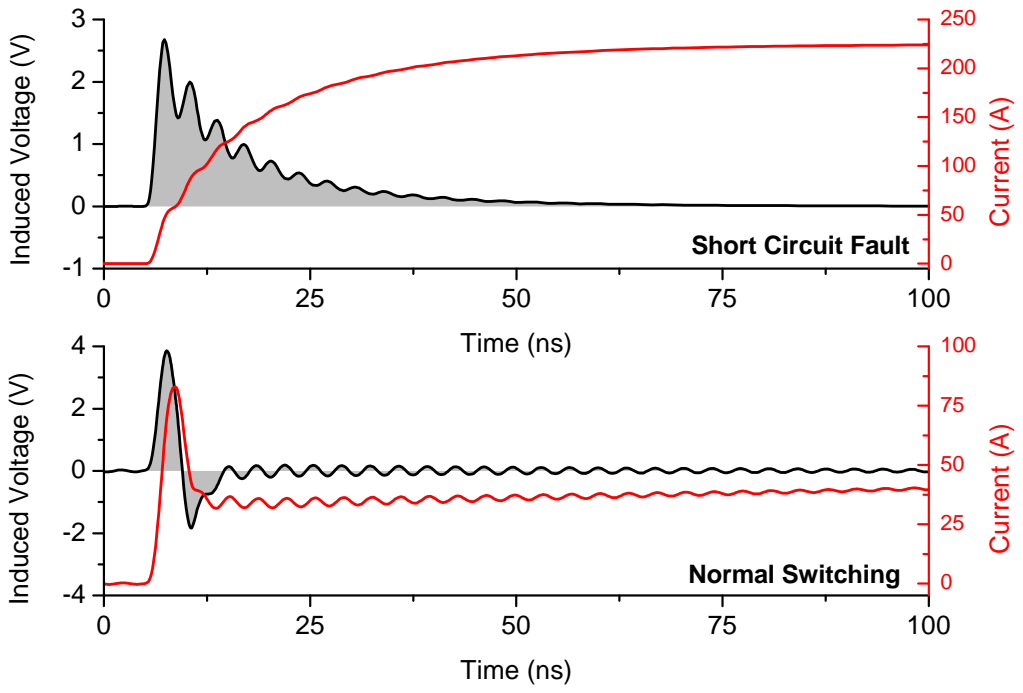
[picture p397: page 1]
Normal Switch i ng; Tim; ort Circ; Cu rren t (A)

I n du ced Vol tage (V)
