furkankarakaya/GaN-Studies/Weekly Reports/Thesis converter.pdf

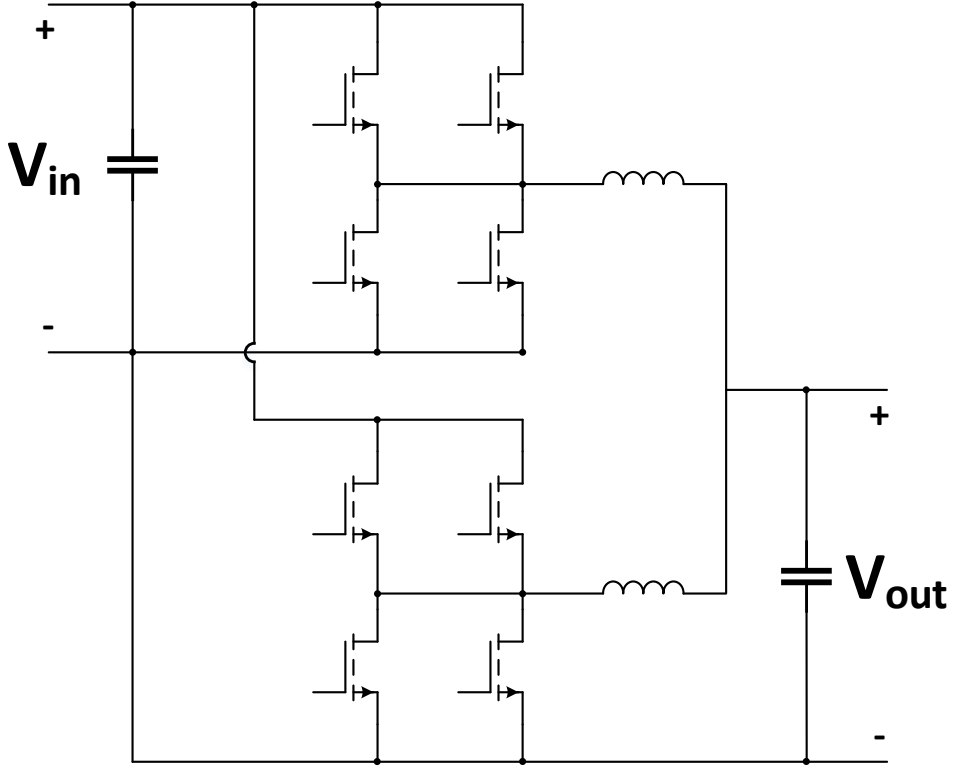
[picture p398: page 1]
Vin; Vout
