furkankarakaya/GaN-Studies/Protection Circuits/TPEL Letter/PaperFigures/Fig13-STOvsHTO.pdf

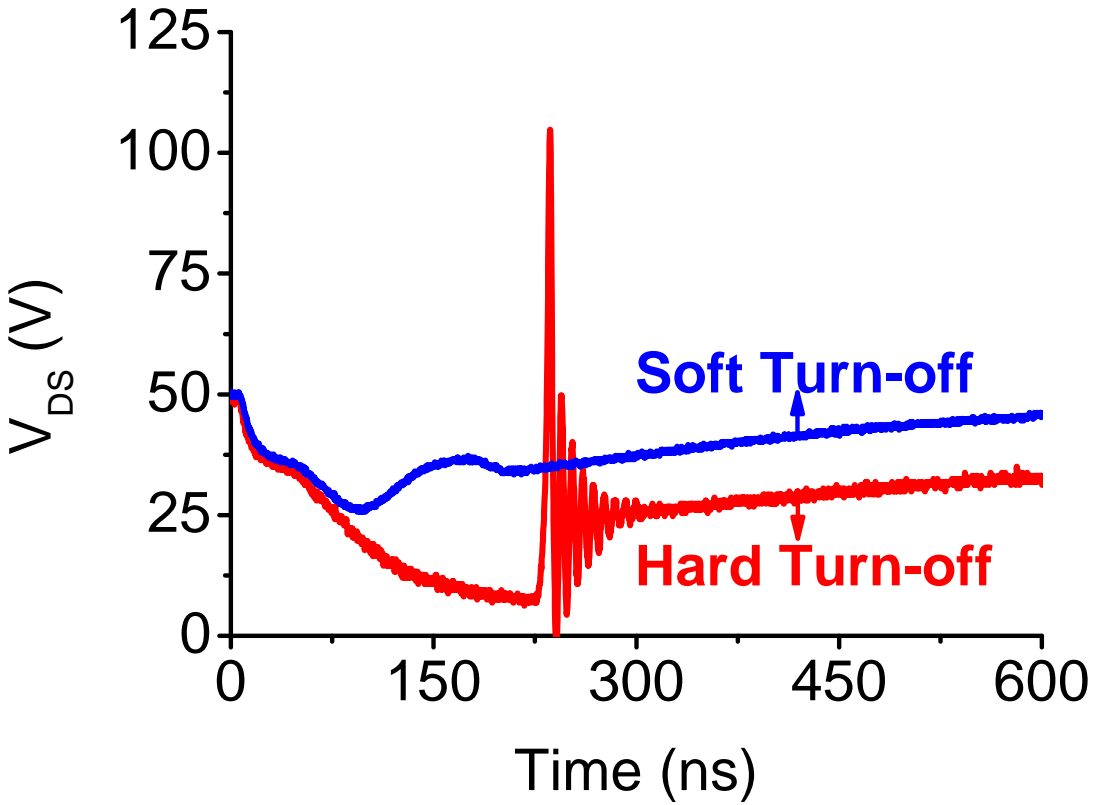
[picture p399: page 1]
Time (n s)

Soft Tu rn -off
Hard Tu rn -off
