furkankarakaya/GaN-Studies/Protection Circuits/TPEL Letter/PaperFigures/Fig18-SenseOptions - v2.pdf

1

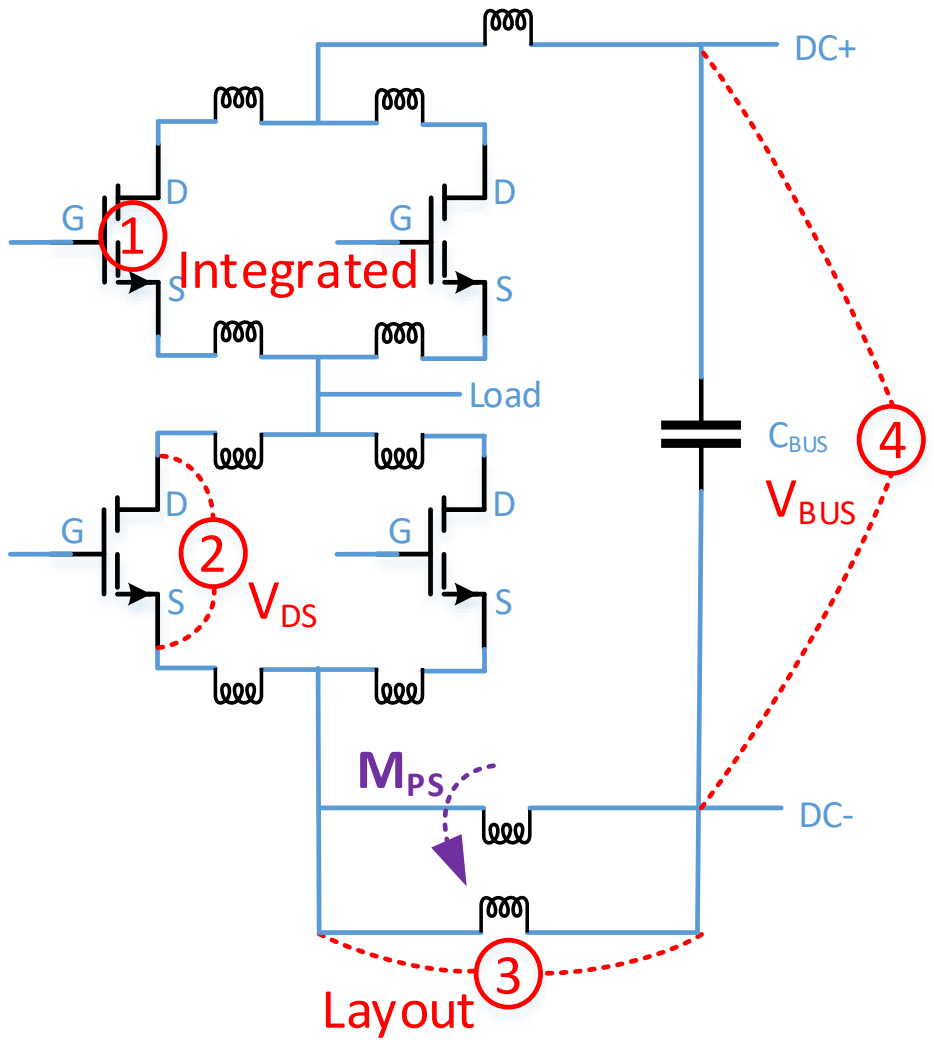
[picture p400: page 1]
Load; CBUS; VDS; Layout; VBUS; Integrated; MPS
