furkankarakaya/GaN-Studies/Protection Circuits/TPEL Letter/PaperFigures/Fig1b-SCDynamics-v2.pdf

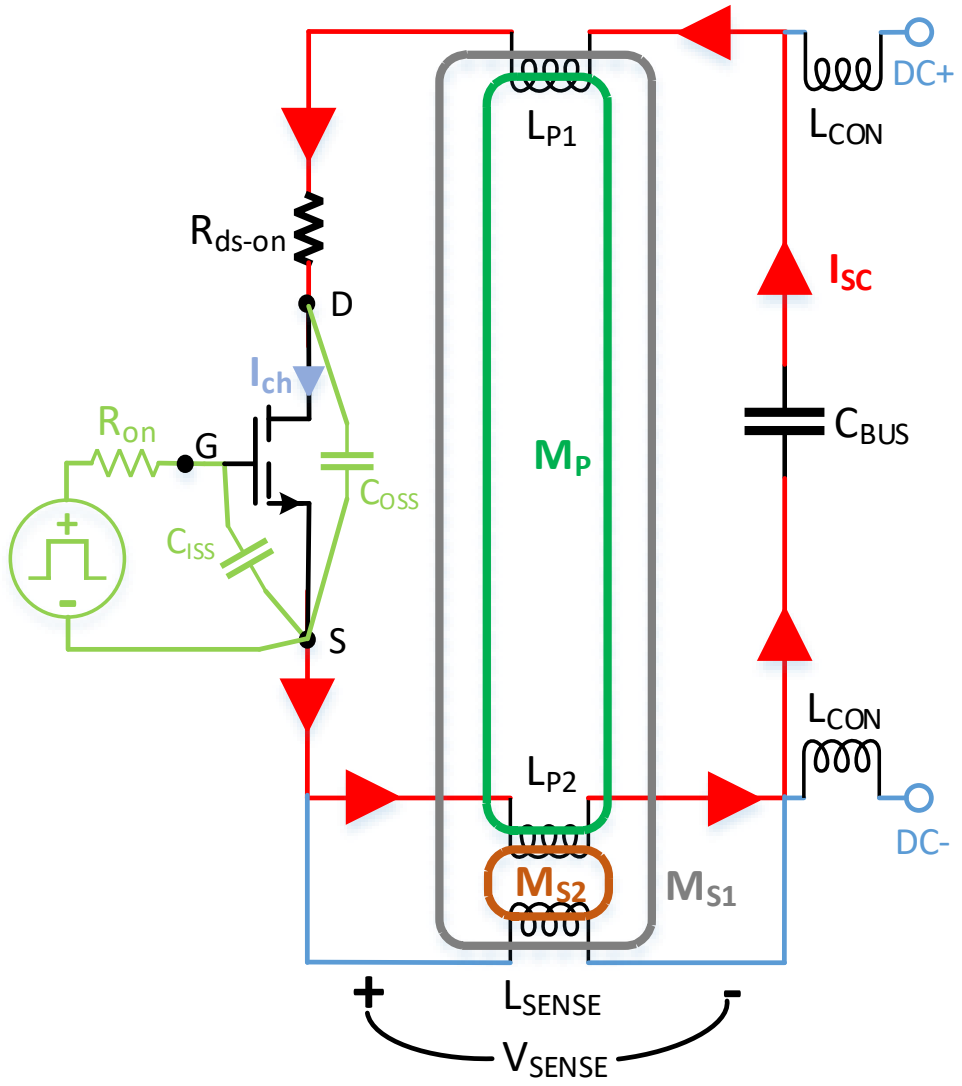
[picture p401: page 1]
CBUS; ISC; Rds-on; CISS; Ron; LSENSE; LCON; VSENSE; COSS; Ich
