furkankarakaya/GaN-Studies/Thesis/Figures/Ch5/Ch5_BoostModeCurrent.pdf

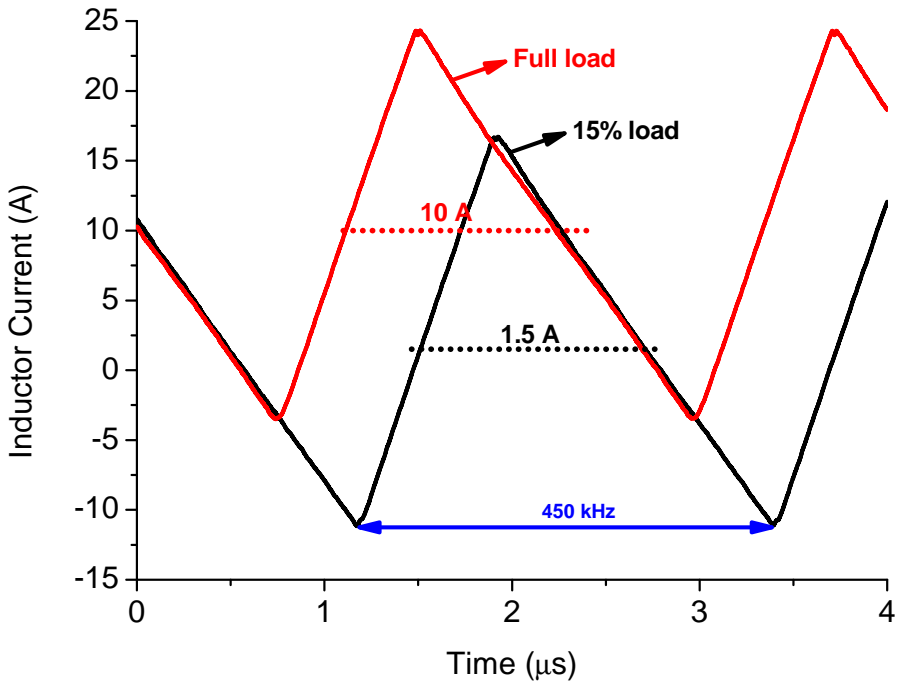
[picture p402: page 1]
450 kHz 1 0 A; Tim

I n du ctor Cu rren t (A)
