furkankarakaya/GaN-Studies/Thesis/Figures/Ch5/Ch5_BoostModeOutputVoltage.pdf

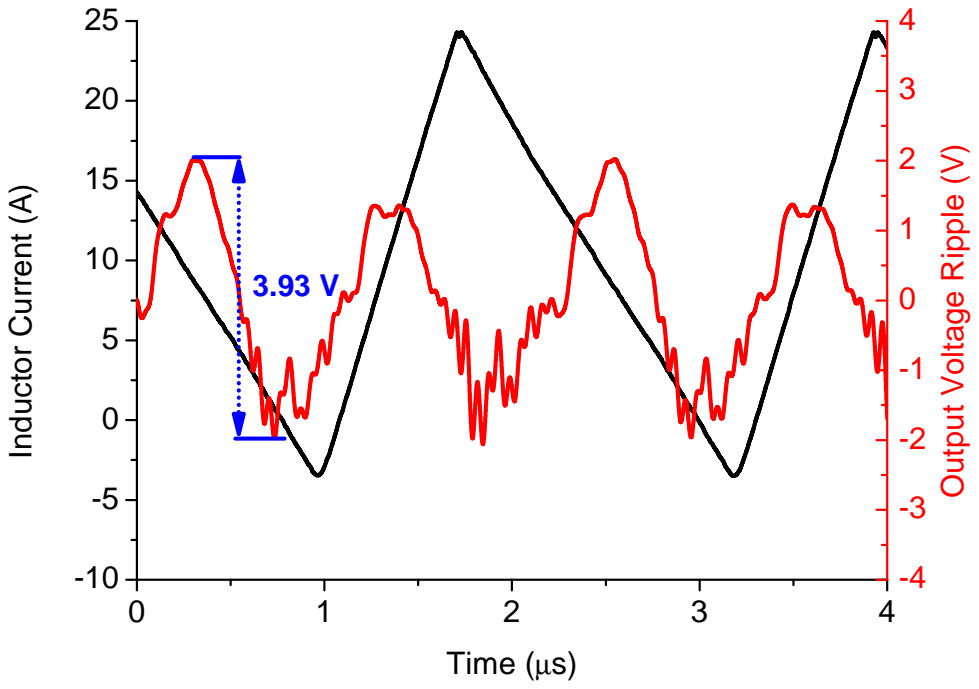
[picture p403: page 1]
Tim

Ou tpu t Vol tage Ri ppl e (V)

I n du ctor Cu rren t (A)
