furkankarakaya/GaN-Studies/Thesis/Figures/Ch5/Ch5_ConverterScheme.pdf

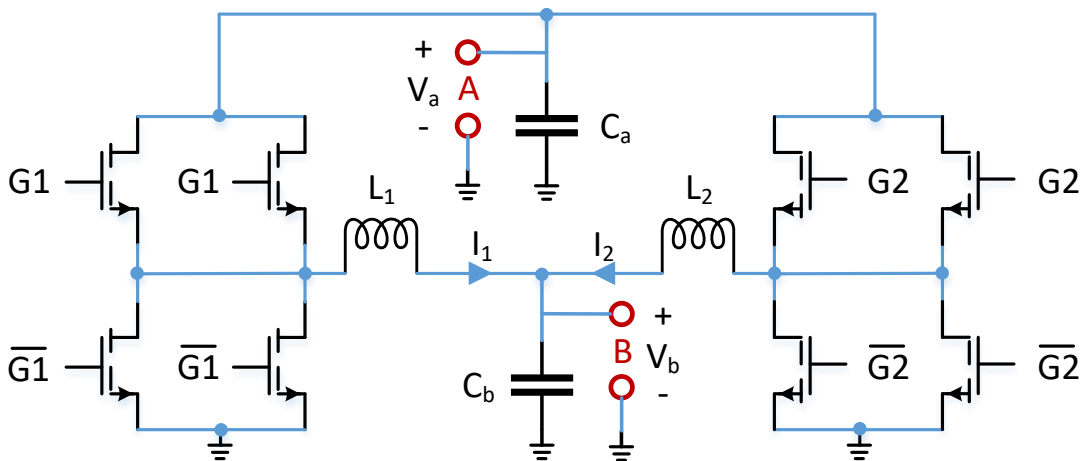
[picture p405: page 1]
