furkankarakaya/GaN-Studies/Thesis/Figures/Ch5/Ch5_InductorFillFactor.pdf

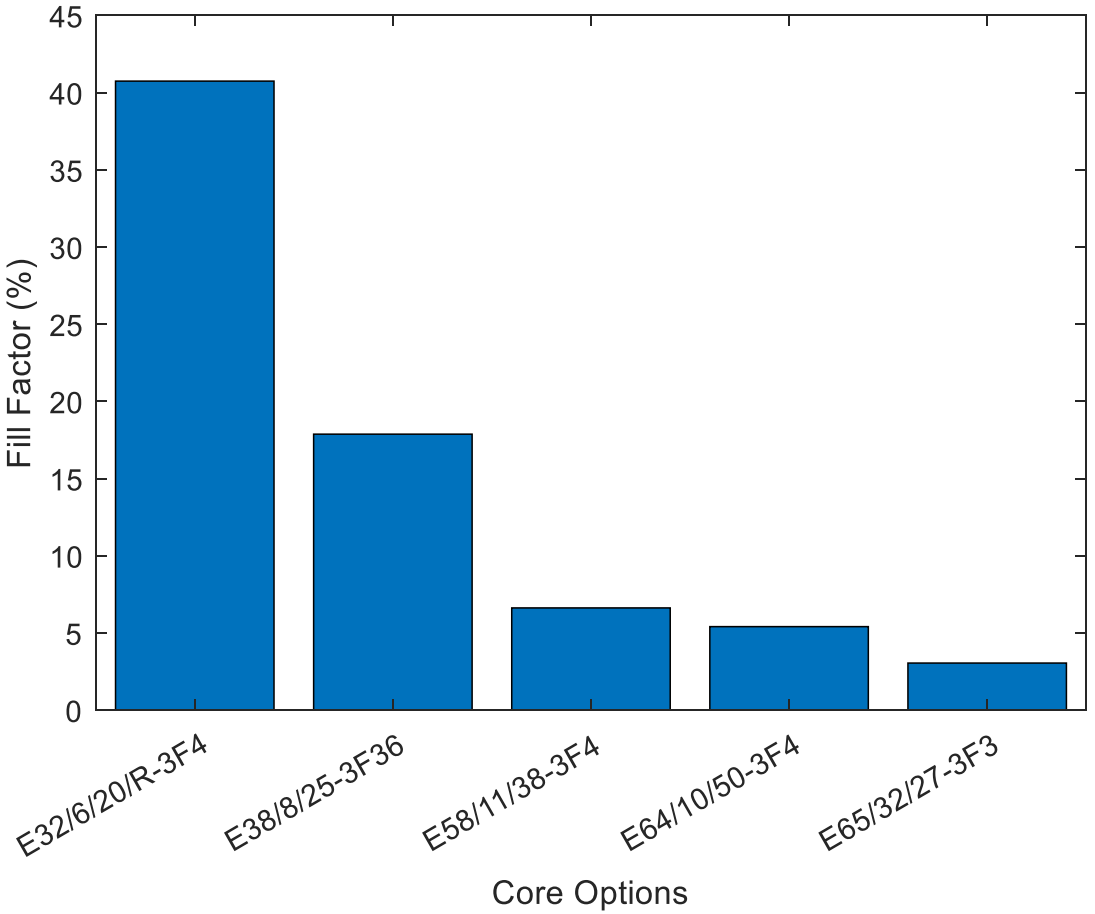
[picture p406: page 1]
