furkankarakaya/GaN-Studies/Thesis/Figures/Ch5/Ch5_InductorHeatingCurrent.pdf

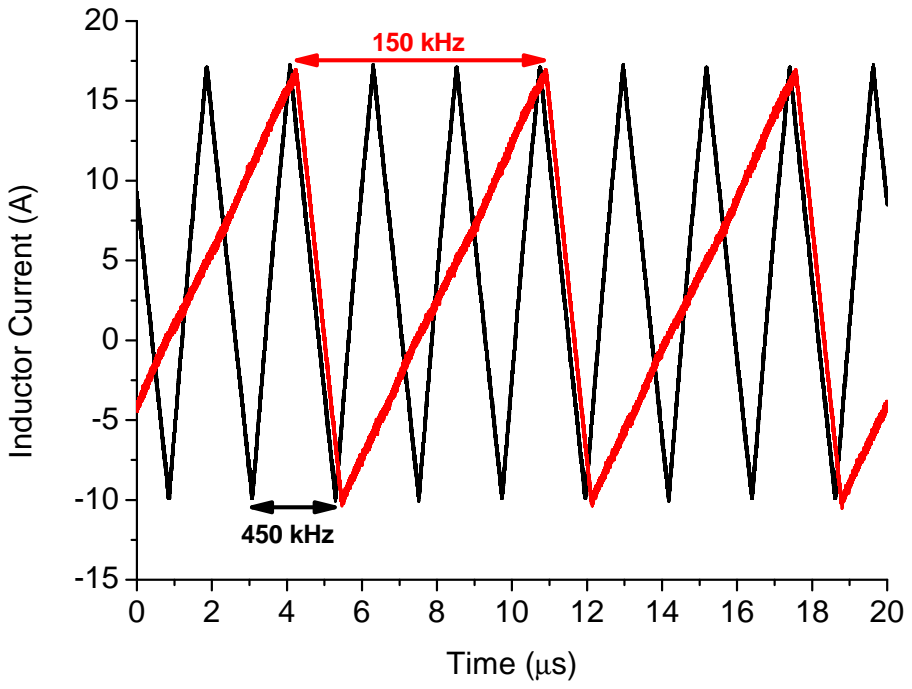
[picture p407: page 1]
1 50 kHz; Tim; s) ⁴⁵⁰ kHz

I n du ctor Cu rren t (A)
