furkankarakaya/GaN-Studies/Thesis/Figures/Ch5/Ch5_InductorLoss.pdf

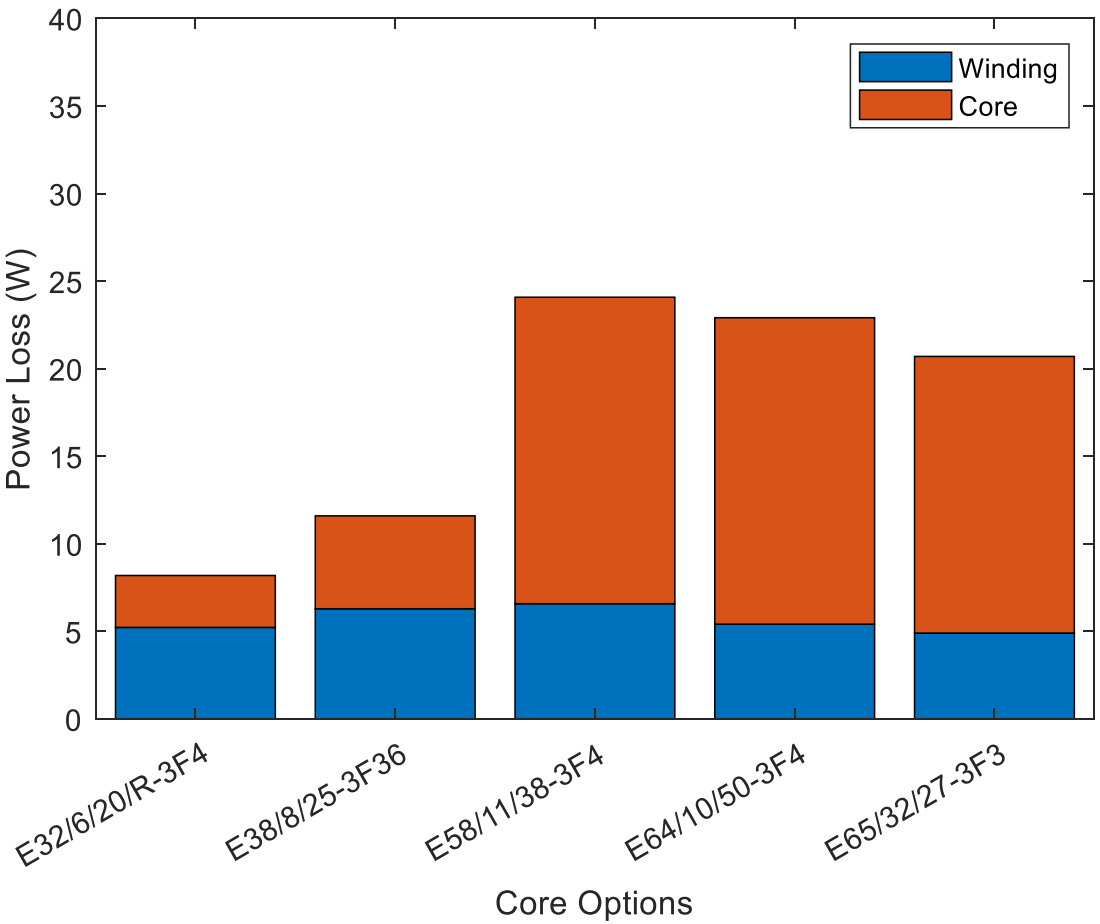
[picture p408: page 1]
