furkankarakaya/GaN-Studies/Thesis/Figures/Ch5/Ch5_InterleavingCurrentsSim.pdf

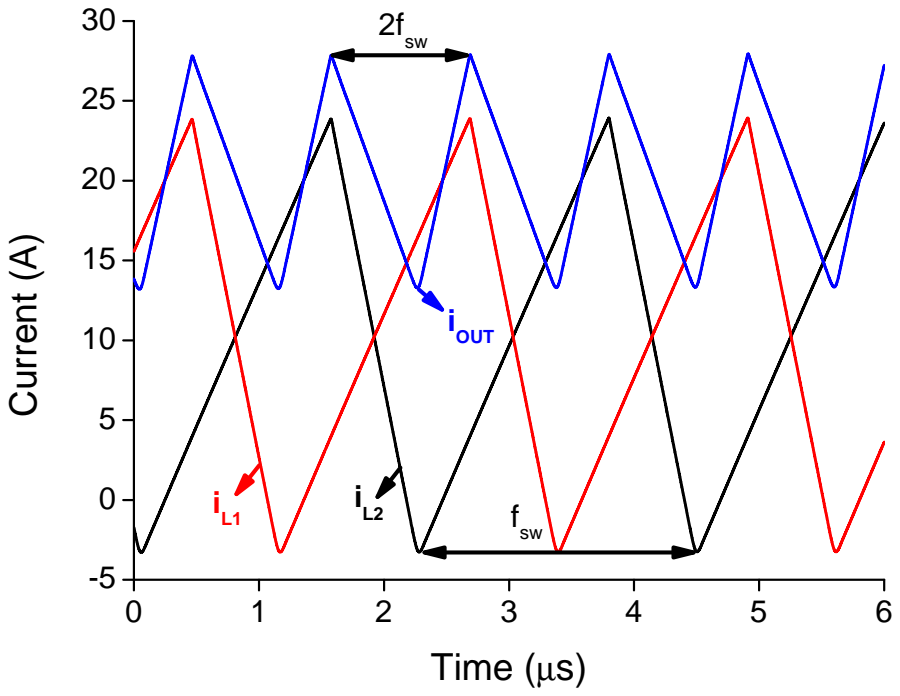
[picture p409: page 1]
Cu rren t (A); Tim; i OUT fsw 2fsw
