furkankarakaya/GaN-Studies/Thesis/Figures/Ch5/Ch5_ZeroVoltageTurnOnSim.pdf

0 -1 , 8 -1 , 5 -1 , 2 -0, 9 -0, 6 -0, 3 0, 0

V

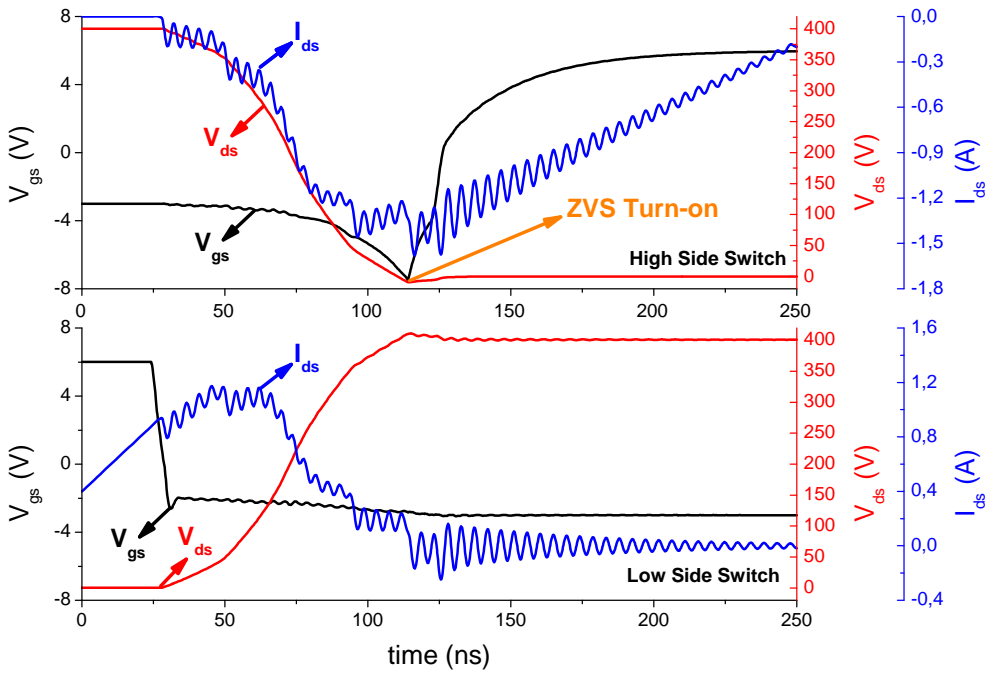
[picture p410: page 1]
witc; Vds (V); gs (V) tim; Vds (V) -0, 4 0, 0 0, 4 0, 8 1 , 2 1 , 6
