furkankarakaya/GaN-Studies/Protection Circuits/TPEL Letter/PaperFigures/Fig12-SCTiming.pdf

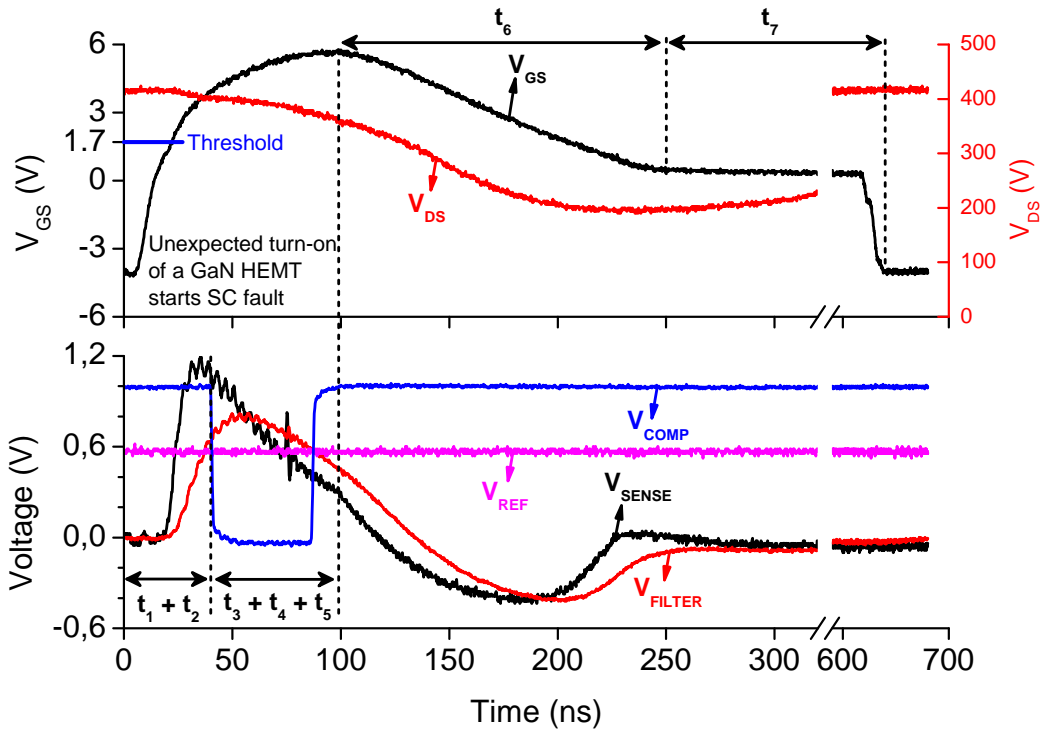
[picture p411: page 1]
cte; starts; VGS (V); VFILTER VSENSE VCOMP t3 + t4 + t5; Vol tage (V); Tim; VDS (V)
