furkankarakaya/GaN-Studies/Thesis/Figures/Ch4/Ch4_DPT_Vfiltouts.pdf

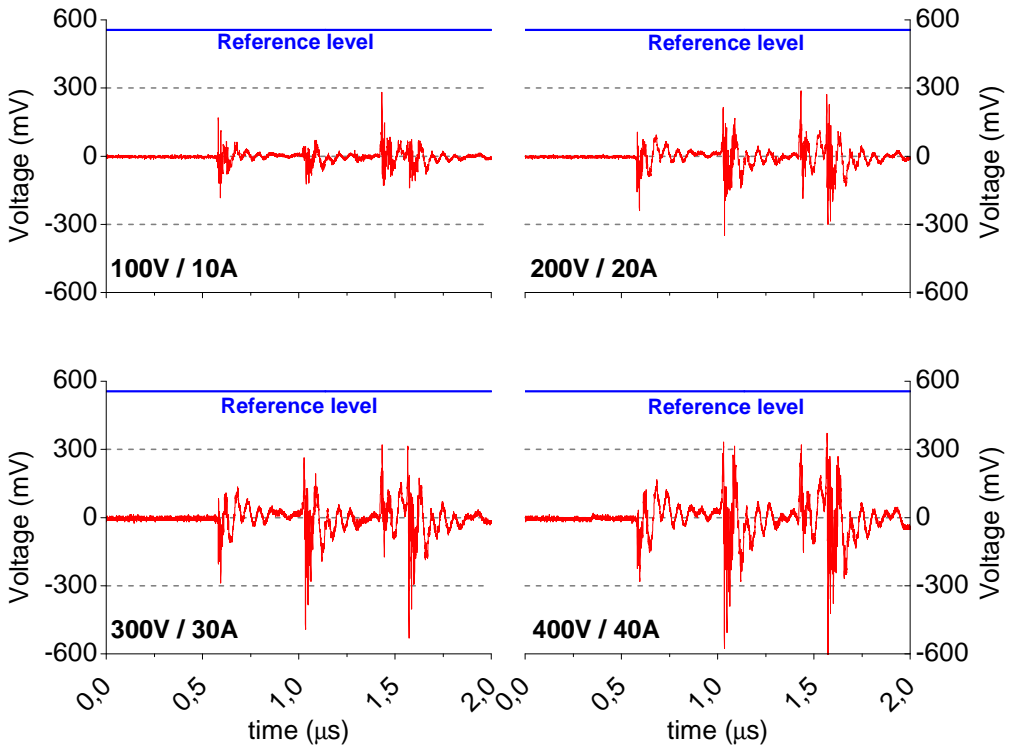
[picture p412: page 1]
Referen ce l evel; tim e (µs)

Referen ce l evel
