furkankarakaya/GaN-Studies/Thesis/Figures/Ch4/Ch4_SCDynamics.pdf

R

L

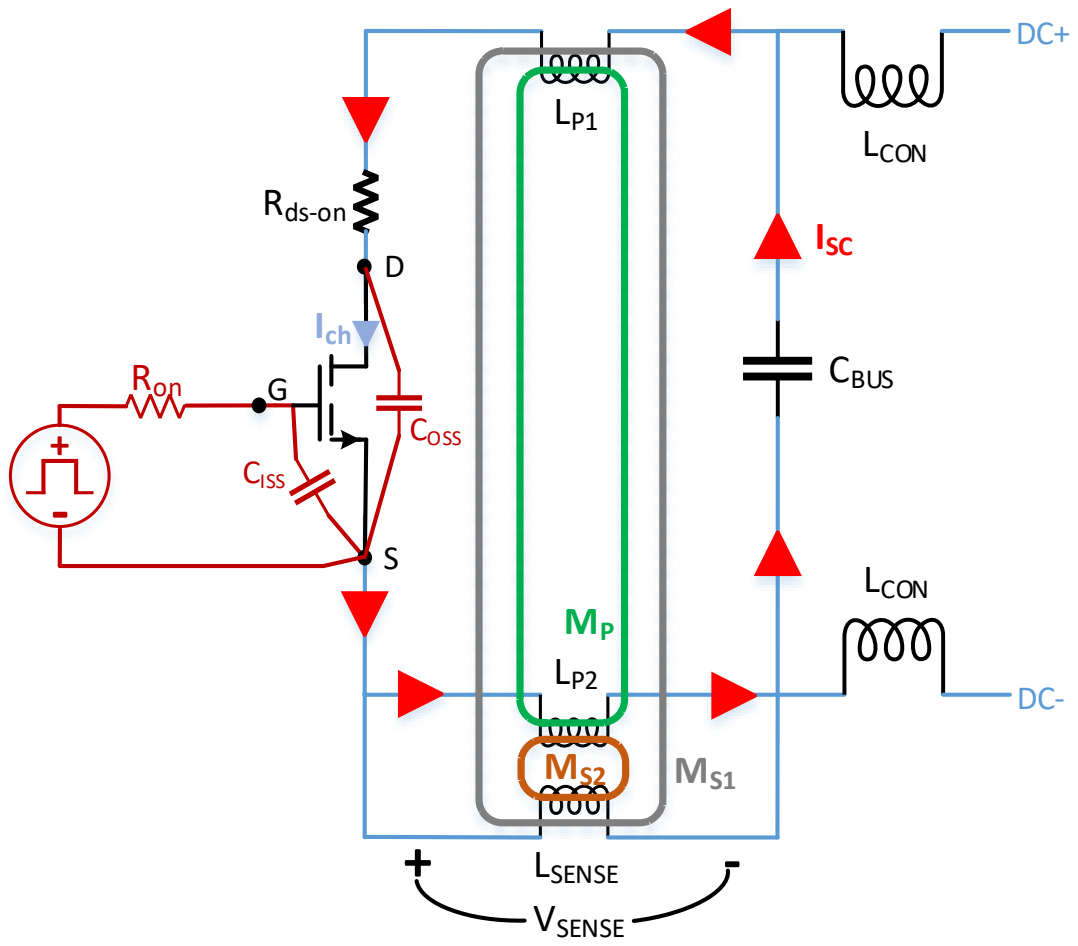
[picture p413: page 1]
CBUS; ISC; CISS; Ron; LSENSE; LCON LCON; VSENSE; COSS; Ich
