furkankarakaya/GaN-Studies/Thesis/Figures/Ch4/Ch4_SenseOptions.pdf

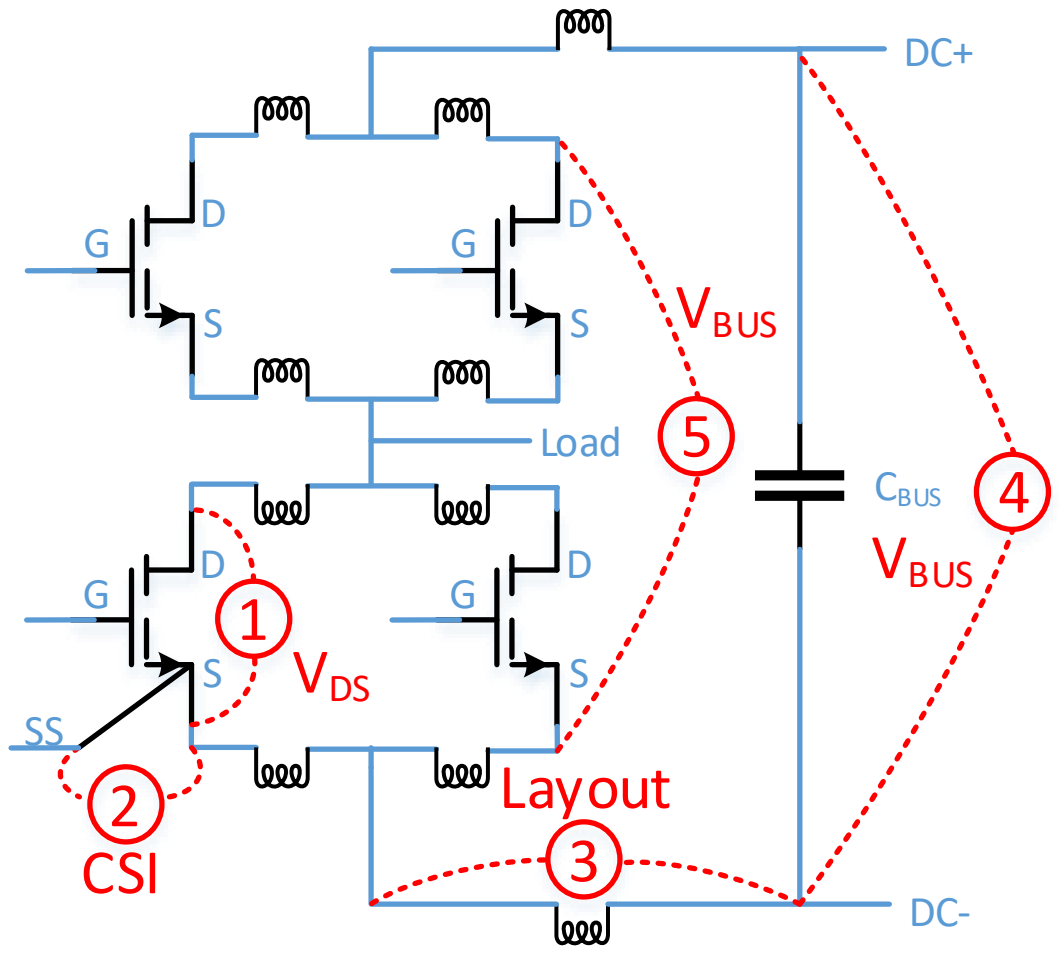
[picture p414: page 1]
Load; CBUS; CSI; VDS; Layout; VBUS
