furkankarakaya/GaN-Studies/Coss Characterization/CossCharc.asc

B1: bv; V = -1*(10+ 1/280e-9 * idt( (time> 210n & time<220n) * V(Vind,Vtr) ))
L1: ind; 280nH; Rser=0
R1: res; 10
R2: res; 1
U1: GaN_E-HEMT_LT_GS66508B_L3V2
V1: voltage; 100
V2: voltage; PULSE(0 6 0 5e-9 5e-9 0.2e-6 10e-6 1)
Named nets: 0, Vtr, Vind, Pay
.tran 0 0.5e-6 0 0.1e-6
