furkankarakaya/GaN-Studies/Thesis/Appendix/BuckConverter.asc

C1: cap; {Cfilt}; V={Vout} Rser=2e-2 Lser=5e-9
C2: cap; {Cbypass}; V={Vin} Rser={Resr} Lser={Lesl}
C3: cap; {Cbypass}; V={Vin} Rser={Resr} Lser={Lesl}
C4: cap; {Cbypass}; V={Vin} Rser={Resr} Lser={Lesl} Rpar={Rparallel}
C5: cap; {Cbypass}; V={Vin} Rser={Resr} Lser={Lesl}
C6: cap; {Cbypass}; V={Vin} Rser={Resr} Lser={Lesl}
C7: cap; {Cbypass}; V={Vin} Rser={Resr} Lser={Lesl}
C8: cap; {Cbypass}; V={Vin} Rser={Resr} Lser={Lesl}
C9: cap; {Cbypass}; V={Vin} Rser={Resr} Lser={Lesl}
C10: cap; {Cbypass}; V={Vin} Rser={Resr} Lser={Lesl}
C11: cap; {Cbypass}; V={Vin} Rser={Resr} Lser={Lesl}
C12: cap; {Cbypass}; V={Vin} Rser={Resr} Lser={Lesl}
C13: cap; {Cbypass}; V={Vin} Rser={Resr} Lser={Lesl}
C14: cap; {Cbypass}; V={Vin} Rser={Resr} Lser={Lesl}
C15: cap; {Cbypass}; V={Vin} Rser={Resr} Lser={Lesl}
C16: cap; {Cbypass}; V={Vin} Rser={Resr} Lser={Lesl}
C17: cap; {Cbypass}; V={Vin} Rser={Resr} Lser={Lesl}
C18: cap; {Cfilt}; V={Vin} Rser=2e-2 Lser=5e-9
C19: cap; 0.68µF; V={Vout} Rser=2e-2 Lser=10e-9
C20: cap; 0.68µF; V={Vin} Rser=2e-2 Lser=10e-9
D1: diode
D2: diode
D3: diode
D4: diode
L1: ind; {Lfilt}; Rser=0.0099
L2: ind; 6.77e-6; Rser=0.0099
L3: ind; 3.08n; Rser=10.4m
L4: ind; 3.08n; Rser=10.3m
L5: ind; 3.08n; Rser=10.3m
L6: ind; 0.135n; Rser=1.41m
L7: ind; 0.13n; Rser=1.15m
L8: ind; 0.127n; Rser=0.981m
L9: ind; 0.126n; Rser=0.945m
L10: ind; 0.128n; Rser=1.03m
L11: ind; 2.13n; Rser=6.88m
L12: ind; 2.12n; Rser=6.64m
L13: ind; 2.12n; Rser=6.46m
L14: ind; 7.96n; Rser=26.1m
L15: ind; 7.96n; Ipk=26.3m
L16: ind; 7.96n; Rser=26.4m
L17: ind; 7.96n; Rser=26.7m
L18: ind; 7.96n; Rser=26.9m
L19: ind; 3.08n; Rser=10.4m
L20: ind; 3.08n; Rser=10.3m
L21: ind; 3.08n; Rser=10.3m
L22: ind; 0.135n; Rser=1.41m
L23: ind; 0.13n; Rser=1.15m
L24: ind; 0.127n; Rser=0.981m
L25: ind; 0.126n; Rser=0.945m
L26: ind; 0.128n; Rser=1.03m
L27: ind; 2.13n; Rser=6.88m
L28: ind; 2.12n; Rser=6.64m
L29: ind; 2.12n; Rser=6.46m
L30: ind; 7.96n; Rser=26.1m
L31: ind; 7.96n; Ipk=26.3m
L32: ind; 7.96n; Rser=26.4m
L33: ind; 7.96n; Rser=26.7m
L34: ind; 7.96n; Rser=26.9m
L35: ind; 1.1n; Rser=2.34m
L36: ind; 1.1n; Rser=2.34m
L37: ind; 1.1n; Rser=2.34m
L38: ind; 1.1n; Rser=2.34m
L39: ind; 1.4n
L40: ind; 1.4n
L41: ind; 1.4n
L42: ind; 1.4n
L43: ind; 2e-6
L44: ind; 2e-6
L45: ind; 2e-6
L46: ind; 2e-6
L47: ind; 100e-9
L48: ind; 100e-9
L49: ind; 100e-9
L50: ind; 100e-9
L51: ind; 100e-9
L52: ind; 100e-9
L53: ind; 2e-9
L54: ind; 2e-9
R1: res; {Rload}
R2: res; {Ron}
R3: res; {Roff}
R4: res; {Ron}
R5: res; {Roff}
R6: res; {Ron}
R7: res; {Roff}
R8: res; {Ron}
R9: res; {Roff}
U1: GaN_E-HEMT_LT_GS66508T_L3V2
U2: GaN_E-HEMT_LT_GS66508T_L3V2
U3: GaN_E-HEMT_LT_GS66508T_L3V2
U4: GaN_E-HEMT_LT_GS66508T_L3V2
U5: GaN_E-HEMT_LT_GS66508T_L3V2
U6: GaN_E-HEMT_LT_GS66508T_L3V2
U7: GaN_E-HEMT_LT_GS66508T_L3V2
U8: GaN_E-HEMT_LT_GS66508T_L3V2
V1: voltage; PULSE({Voff} {Von} {DeadTime} 2e-9 2e-9 {D/fsw} {1/fsw})
V2: voltage; {Tj}
V3: voltage; {Tj}
V4: voltage; {Tj}
V5: voltage; {Tj}
V6: voltage; {Tj}
V7: voltage; {Tj}
V8: voltage; {Tj}
V9: voltage; {Tj}
V10: voltage; PULSE({Voff} {Von} {2*DeadTime+D/fsw} 2e-9 2e-9 {(1-D)/fsw-2*DeadTime} {1/fsw})
V11: voltage; {Vin}
V12: voltage; PULSE({Voff} {Von} {DeadTime + phase} 2e-9 2e-9 {D/fsw} {1/fsw})
V13: voltage; PULSE({Voff} {Von} {2*DeadTime+D/fsw + phase} 2e-9 2e-9 {(1-D)/fsw-2*DeadTime} {1/fsw})
Named nets: 0, GateTop, GateTop2, GateBot, GateBot2, SWnode, Vo, SWnode2, DCBus1, DCBus2, GND2, NEG1, NEG2
.param Rload = Vout / Iout;
.param Ron=20 Roff=2;
.param Iout=20 Vin=400 Vout=270;
.param D = 0.66;
.param fsw =450k
.param K = 0.25;
;param Lfilt = 1/K * (1- Vout/Vin)*Vout/Iout*1/fsw
.param Cfilt=0.6e-6;
.params Von = 6 Voff = -3;
.param DeadTime = 100e-9;
.tran 0 0.4e-3 10e-6
.param Tj = 150
.ic V(Vo) = {Vout}
.param phase = 180/360 * 1/fsw
.param Cbypass 220e-9
.param Lfilt = 6.85e-6
.param Lesl=0.7e-9 Resr=0.0134 Rparallel=2.27e9
