furkankarakaya/GaN-Studies/Protection Circuits/SC Parallel Simulation.asc

C1: cap; {Cbypass}; V={Vin} Rser={Resr} Lser={Lesl} Rpar={Rparallel}
C2: cap; 1nF
C3: cap; 9.5pF
C4: cap; 16pF
C5: cap; 16pF
C6: cap; 0.38pF
D1: diode
D2: diode
D3: diode
D4: diode
D5: diode
D6: diode
L1: ind; 4.7e-6
L2: ind; 1e-12
L3: ind2; 0.86nH
L4: ind2; 4e-9
L5: ind2; 4e-9
L6: ind; 2e-9
L7: ind; 2e-9
L8: ind2; 4e-9
L9: ind; 2e-6
L10: ind; 2e-6
L11: ind2; 20nH
L12: ind2; 4e-9
L13: ind; 1pH
L14: ind; 0.55µH
R1: res; 20
R2: res; 20
R3: res; 12.5
R4: res; 2
R5: res; 20
R6: res; 12.5
R7: res; 20
R8: res; 2
R9: res; 120
R10: res; 9Meg
R11: res; 1Meg
R12: res; 0.022
R13: res; 18
U1: GaN_LTspice_GS66508T_L3V4P1
U2: GaN_LTspice_GS66508T_L3V4P1
U3: GaN_LTspice_GS66508T_L3V4P1
U4: GaN_LTspice_GS66508T_L3V4P1
V1: voltage; {Vin}
V2: voltage; 5
V4: voltage; {Tj}
V5: voltage; {Tj}
V6: voltage; {Tj}
V7: voltage; {Tj}
V8: voltage; PWL file=pulse_sc_high.txt
V9: voltage; PWL file=pulse_sc_low.txt
V10: voltage; 0.56
Named nets: PGDH, NGDH, PGDL, NGDL, C3, C4, C2, C1, Tj1, Tj3, Tj4, Tj2, 0, Vinduced, Vfiltout, threshold, ProbePos, ProbeNeg
.tran 0 0.5u 0.4u
.option ITL1 = 500
.option ITL2 = 500
.option ITL4 = 500
.option RELTOL = 0.001
.option ABSTOL=1E-9
.option CHGTOL=1E-12
.option VNTOL=1E-6
.option GMIN=1E-15
.option TRTOL=1
.option noopiter
.option gminsteps=0
.option topologycheck=0
.param Vin=400
.param ISW=20
.param DT=1U
.param T_ON=10U
.param L_DPT=Vin*(T_ON-2*DT)/ISW
.param T_P = 21U
.param L_Load=3n
.param Lesl=0.7e-9 Resr=0.0134 Rparallel=2.27e9
K1 L3 L11 0.0352
Solver
GateDriver
Operation
Parasitics
Simulation
.param Cbypass 220e-9
.param Tj=65
.option Temp= 125
.params Von = 6 Voff = -3;
.param DeadTime = 100e-9;
*K2 L3 L4 0.0593
*K5 L3 L5 0.0593
*K3 L3 L8 0.0593
*K4 L3 L12 0.0593
Use PWL texts for DPT and SC
For DPT
pulse_charge
pulse_freewheel
For SCT
pulse_sc_low
pulse_sc_high
