furkankarakaya/GaN-Studies/Protection Circuits/Draft3.asc

C1: cap; 1nF
R1: res; {Rf}
V1: voltage; ""; AC 1
Named nets: 0
.ac dec 10 1e6 25e6
.step param Rf 10 30 10
