furkankarakaya/GaN-Studies/Buck Converter/SynchBuck.asc

C1: cap; {Cfilt}; V={Vout} Rser=2e-2 Lser=5e-9
C2: cap; {Cfilt}; V={Vin} Rser=2e-2 Lser=5e-9
D1: diode
D2: diode
D3: diode
D4: diode
L1: ind2; {Lfilt}; Rser=0.0099
L2: ind2; {Lfilt}; Rser=0.0099
L3: ind; 2e-6
L4: ind; 2e-6
R1: res; {Rload}
R2: res; {Ron}
R3: res; {Roff}
R4: res; {Ron}
R5: res; {Roff}
R6: res; {Ron}
R7: res; {Roff}
R8: res; {Ron}
R9: res; {Roff}
U1: GaN_E-HEMT_LT_GS66508T_L3V2
U2: GaN_E-HEMT_LT_GS66508T_L3V2
U3: GaN_E-HEMT_LT_GS66508T_L3V2
U4: GaN_E-HEMT_LT_GS66508T_L3V2
U5: GaN_E-HEMT_LT_GS66508T_L3V2
U6: GaN_E-HEMT_LT_GS66508T_L3V2
U7: GaN_E-HEMT_LT_GS66508T_L3V2
U8: GaN_E-HEMT_LT_GS66508T_L3V2
V1: voltage; PULSE({Voff} {Von} {DeadTime} 2e-9 2e-9 {D/fsw} {1/fsw})
V2: voltage; {Tj}
V3: voltage; {Tj}
V4: voltage; {Tj}
V5: voltage; {Tj}
V6: voltage; {Tj}
V7: voltage; {Tj}
V8: voltage; {Tj}
V9: voltage; {Tj}
V10: voltage; PULSE({Voff} {Von} {2*DeadTime+D/fsw} 2e-9 2e-9 {(1-D)/fsw-2*DeadTime} {1/fsw})
V11: voltage; {Vin}
V12: voltage; PULSE({Voff} {Von} {DeadTime + phase} 2e-9 2e-9 {D/fsw} {1/fsw})
V13: voltage; PULSE({Voff} {Von} {2*DeadTime+D/fsw + phase} 2e-9 2e-9 {(1-D)/fsw-2*DeadTime} {1/fsw})
Named nets: 0, GateTop, GateTop2, GateBot, GateBot2, SWnode, DCbus, Vo, SWnode2
.param Rload = Vout / Iout;
.param Ron=20 Roff=2;
.param Iout=20 Vin=540 Vout=400;
.param D = Vout / Vin;
.param fsw = 500k
.param K = 2;
.param Lfilt = 6.8e-6
.param Cfilt=1.1e-6;
.params Von = 6 Voff = -3;
.param DeadTime = 50e-9;
.tran 0 1e-3 0.8e-3
.param Tj = 150
.ic V(Vo) = {Vout}
.param phase = 180/360 * 1/fsw
.param Lfilt = 1/K * (1- Vout/Vin)*Vout/Iout*1/fsw
7443640680B
