furkankarakaya/GaN-Studies/Buck Converter/SynchBuck - DPT version.asc

C1: cap; {Cfilt}; V={0} Rser=2e-2 Lser=5e-9
C18: cap; {Cfilt}; V={Vin} Rser=2e-2 Lser=5e-9
C19: cap; 0.68µF; V={0} Rser=2e-2 Lser=10e-9
C20: cap; 0.68µF; V={Vin} Rser=2e-2 Lser=10e-9
D1: diode
D2: diode
L1: ind; 352µ
L2: ind; {Lfilt}; Rser=0.0099
L43: ind; 2e-6
L44: ind; 2e-6
L45: ind; 50e-9
L46: ind; 50e-9
L47: ind; 100e-9
L49: ind; 100e-9
L50: ind; 100e-9
R2: res; {Ron}
R3: res; {Roff}
R4: res; {Ron}
R5: res; {Roff}
U1: GaN_E-HEMT_LT_GS66508T_L3V2
U5: GaN_E-HEMT_LT_GS66508T_L3V2
V1: voltage; PULSE({Voff} {Von} {DeadTime} 2e-9 2e-9 10e-6 300e-6)
V2: voltage; {Tj}
V6: voltage; {Tj}
V10: voltage; PULSE({Voff} {Von} 10.2e-6 2e-9 2e-9 100n 300e-6)
V11: voltage; {Vin}
Named nets: 0, GateTop, GateBot, SWnode, DCbus
.param Ron=20 Roff=2;
.param fsw =500k
.param Lfilt = 6.8e-6
.param Cfilt=0.44e-6;
.params Von = 6 Voff = -3;
.param DeadTime = 100e-9;
.tran 0 300e-6 0
.param Tj = 25
.param Vin = 5
