furkankarakaya/GaN-Studies/Protection Circuits/Paralleling.asc

C1: cap; 5e-6; IC={VBUS} Rser=23e-3 Lser=19.9e-9
C2: cap; 0.1µ; Rser=17.5m Lser=0.75n IC={VBUS}
C3: cap; 0.1µ; Rser=17.5m Lser=0.75n IC={VBUS}
C4: cap; 0.1µ; Rser=17.5m Lser=0.75n IC={VBUS}
D1: diode
D2: diode
D3: diode
D4: diode
L1: ind; 2e-9
L2: ind; 2e-9
L3: ind; 18e-9
L4: ind; 2e-9
L5: ind; 2e-9
L6: ind; {L_Load}
L7: ind; {L_Load}
L8: ind; {L_DPT}
L9: ind2; 29.8n; Rser=1037u
L10: ind; 48.6n; Rser=1422u
L11: ind2; 7.14n; Rser=854u
L12: ind2; 5.658n; Rser=664u
L13: ind2; 6.28n
L14: ind; {Lright}
L15: ind; {Lleft}
R1: res; 10
R2: res; 10
R3: res; 2
R4: res; 2
R5: res; 10
R6: res; 2
R7: res; 10
R8: res; 2
U1: GaN_E-HEMT_LT_GS66508B_L3V2
U2: GaN_E-HEMT_LT_GS66508B_L3V2
U3: GaN_E-HEMT_LT_GS66508B_L3V2
U4: GaN_E-HEMT_LT_GS66508B_L3V2
V2: voltage; PULSE(-3 6 {DT} 1n 1n {T_ON-2*DT} {T_P} 2)
V3: voltage; PULSE(6 -3 0 1n 1n {T_ON} {T_P} 2)
V4: voltage; {VBUS}; Rser=0
Named nets: 0, PGDH, NGDH, PGDL, NGDL
.tran 0 30U 0
.option ITL1 = 500
.option ITL2 = 500
.option ITL4 = 500
.option RELTOL = 0.01
.option ABSTOL=1E-09
.option CHGTOL=1E-12
.option VNTOL=1E-6
.option GMIN=1E-15
.option TRTOL=1
.option noopiter
.option gminsteps=0
.option topologycheck=0
.option temp=25
.param VBUS=125
.param ISW=20
.step param L_Load list 1e-12 10e-9 20e-9
.param Rgoff = 2
.param VDRV_P=6
.param VDRV_N=3
.param DT=1U
.param T_ON=10U
.param L_DPT=VBUS*(T_ON-2*DT)/ISW
.param T_P = 21U
.param L_GTOPPOS = 6.5N
.param LS_EX = 10p
.param L_Load=3n
.param L_GTOPNEG = 2.8N
.param L_GBOTPOS = 5.03N
.param L_GBOTNEG = 2.92N
