furkankarakaya/GaN-Studies/Protection Circuits/ParasiticProtection.asc

C2: cap; {C}
C3: cap; 1e-9
D1: diode
D2: diode
I1: current; 20
L1: ind; 2e-9
L2: ind; 2e-9
L4: ind; 18e-9
Lparasitic: ind; 0.66097n; Rser=0
R1: res; 10
R2: res; 10
R3: res; 10k
R4: res; 2
R5: res; 2
R6: res; 10k
R7: res; 10k
R8: res; 0.243e-3
R9: res; 1.4k
R10: res; 2.43k
R11: res; 10k
R18: res; 1k
R19: res; {Rntc}
R20: res; 1.5k
U1: GaN_E-HEMT_LT_GS66508B_L1V2
U2: GaN_E-HEMT_LT_GS66508B_L1V2
U5: LTC6252
U6: LTC6252
V1: voltage; 270
V2: voltage; PULSE(6 -3 10000e-9 1e-9 1e-9 9900e-9 20000e-9)
V3: voltage; PULSE(-3 6 10000e-9 1e-9 1e-9 9900e-9 20000e-9)
V4: voltage; 2.5
V5: voltage; -2.5
V6: voltage; SINE(0 0.1 1Meg); AC 1
Named nets: 0, Vpos, Vneg, Vgnd, Vcp, Vcn, Vamp
.tran 25e-6
.option temp=25
;ac dec 10 1 1Meg
For 155.5 x 155.5 mil trace (Source Pin Dimension)
2 oz/ft^2 thickness
 
25C - 0.243 mohm
50C - 0.267 mohm
75C - 0.29 mohm
100C - 0.314 mohm
125C - 0.338 mohm
150C - 0.361 mohm
L = 1.108404 nH
.param Rntc=10k*exp(B*(1/(temp + 273.5 )+1/(273.5+25)))
.param B = 3380
;step param C list 2.7p 10p 40p 100p 300p
.param C 2.7p
