furkankarakaya/GaN-Studies/Protection Circuits/ParasiticProtection - ECCE.asc

C1: cap; 100p
C3: cap; 200e-12
C4: cap; 1µ; IC = 270
D1: diode
D2: diode
L1: ind; 20e-9
L2: ind; 2e-9
L4: ind; 200e-9
Lparasitic: ind; 0.84nH; Rser=0
R1: res; 0
R2: res; 10
R3: res; 10k
R4: res; 1k
R5: res; 2
R6: res; 10k
R7: res; 10k
R8: res; 1.7e-3
R9: res; 2.21k
R10: res; 2.43k
R11: res; 20k
S1: sw; MYSW
U1: GaN_E-HEMT_LT_GS66508B_L3V2
U2: LT1714
U3: LT1813
U5: LT1813
V1: voltage; 270
V2: voltage; 25
V3: voltage; PULSE(-3 6 100e-9 1e-9 1e-9 500e-9 20000e-9)
V4: voltage; 5
V5: voltage; -5
V6: voltage; 1.2
Named nets: 0, Vpos, Vneg, Vgnd, Vcp, Vcn, Vamp, JunctionTop, Vcomp
.tran 1e-6
.option temp=25
;ac dec 5 1 5000e6
For 155.5 x 155.5 mil trace (Source Pin Dimension)
2 oz/ft^2 thickness
 
25C - 0.243 mohm
50C - 0.267 mohm
75C - 0.29 mohm
100C - 0.314 mohm
125C - 0.338 mohm
150C - 0.361 mohm
L = 1.108404 nH
.param Rntc=10k*exp(B*(1/(temp + 273.5 )+1/(273.5+25)))
.param B = 3380
.model MYSW SW(Ron=1m Roff=1Meg Vt=.5 Vh=-.4)
