furkankarakaya/GaN-Studies/Protection Circuits/Draft1.asc

R1: res; 10K
R2: res; 10k
R3: res; 2.43K
R4: res; 10K
R5: res; 20K
U1: UniversalOpamp2; Avol=31.6228k GBW=3900Meg Slew=950Meg
U2: UniversalOpamp2; Avol=31.6228k GBW=3900Meg Slew=950Meg
V1: voltage; 5
V2: voltage; -5
V3: voltage; SINE(10e-3 20e-3 100e6); AC 0
Named nets: Vpos, Vneg, Vgnd, Vamp, 0
.tran 10e-6
;ac dec 10e-6 1 4e9
