furkankarakaya/GaN-Studies/Protection Circuits/Draft2.asc

D1: diode
D2: diode
D3: diode
D4: diode
I1: current; 20
L1: ind; 2e-9
L2: ind; 2e-9
L3: ind; 18e-9
L4: ind; 2e-9
L5: ind; 2e-9
R1: res; 10
R2: res; 10
R3: res; 2
R4: res; 2
R5: res; 10
R6: res; 2
R7: res; 10
R8: res; 2
U1: GaN_E-HEMT_LT_GS66508B_L3V2
U2: GaN_E-HEMT_LT_GS66508B_L3V2
U3: GaN_E-HEMT_LT_GS66508B_L3V2
U4: GaN_E-HEMT_LT_GS66508B_L3V2
V1: voltage; 270
V2: voltage; PULSE(6 -3 10000e-9 1e-9 1e-9 9900e-9 20000e-9)
V3: voltage; PULSE(-3 6 10000e-9 1e-9 1e-9 9900e-9 20000e-9)
Named nets: 0, PGDH, NGDH, PGDL, NGDL
.tran 50e-6
.option temp=125
;ac dec 5 1 5000e6
