furkankarakaya/GaN-Studies/(list of files, drawings)

Other design files:
Protection Circuits/TPEL Letter/OLAB/DPT.opj
Protection Circuits/TPEL Letter/OLAB/HTOvsSTO.opj
