furkankarakaya/GaN-Studies/(commit log)

2018-07-13 @ozank hocam, Furkan ile biraz konuştuk üzerine. Siz de bi göz atın bi ara konuşalım.
2018-07-18 Current measurement methods are listed.
2018-08-09 Measurement devices founded in the literature are listed.
    [Measurement Device List.xlsx]
2018-10-11 Protection circuit options are being tested. The most important and hardest part is deciding the reference level which is greatly changes with junction temperature.
2018-11-02 Protection circuit schematic design is going on.
2018-11-03 Protection circuit simulation work.
2018-11-06 The protection circuit is corrected.
2018-11-08 NTC thermistor and series / parallel resistors are selected using a MATLAB script which is used to find optimum resistance values for minimal gain change with temperature.
2018-11-12 Device paralleling is studied in simulation platform.
2018-11-17 On DC Link capacitor selection of inverter (3-ph). For single capacitor.
2018-11-20 BOM is finalized for protection circuit.
    [GaNCharBoard.xls]
2019-09-04 Coss characterization is studied in simulation platform.
    [CossVds.xlsx, Loss Analytical.xlsx]
2019-09-05 Looking for a skeleton application for my thesis. Zero-voltage Resonant Transition Buck Converter with Paralleled Half-Bridges is investigated. Some example operating points are analyzed for transist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
2019-09-06 Design procedure is going on for zvrt switching buck converter.
2019-09-11 SS Buck converter design is verified on paper for parasitic inductances as well. The results are promising.
2019-09-12 Soft switching and interleaving performances are verified with experimental results. @EnesAyaz
2019-09-16 Magnetic design is verified with help of @gkhnckl and @EnEsAyAz
2019-09-20 Capacitor selection is completed. Thermal design needs to be verified.
2019-09-24 Weekly report submission: capacitor selection is finalized and heatsink options are listed. They will be discussed tomorrow with @ozank
2019-09-27 Schematic design for the half-bridge board is almost completed except short-circuit protection.
2019-11-25 Test procedure is being arranged.
    [Soldering & Test Procedure.xlsx]
2019-11-26 Soft switching conditions are defined. Test procedure is developed.
    [Soldering & Test Procedure.xlsx]
2019-12-08 @hakansrc ile DSP'ye giriş yapıldı.
    [Soldering & Test Procedure.xlsx]
2019-12-12 Important progress has been achieved on software: - PWM signals for Interleaved Buck Converter are generated successfully. - LED / Push Button / Enable Signal codes are completed. - DSP is able to un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
    The next step is reading analog signals as single channel or differential. @ozank
    [Soldering & Test Procedure.xlsx]
2019-12-17 The software for OL control is fully completed with all phases.
    [Soldering & Test Procedure.xlsx]
2020-01-14 Power loop analysis is finalized and added to weekly report.
2020-01-22 The results from thermal tests are reported. Based on the results, 10 kW/lt power density is achievable by shortening the longer edge from 134 mm to 125 mm. Thanks to powerful fan selection, there wo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
2020-03-05 400V / 40A Double Pulse Test has been achieved without any failure. Mis-trig level for SCP is increased upto 350V. Experiments are going on for the paper.
2020-03-07 SCP Tests were conducted for 200ns fault duration. The SC behavior is the same with 100ns faulty case.
2020-03-17 Weekly report for previous week is added. FEA solutions have been succesffuly obtained for power loop. Experimental tests are going on for SCP mechanism.
2020-03-18 Further experiments are going on for SCP tests. There is a dip over isolated supplies and main supply voltages under high dV/dt transient.
2020-03-27 First draft of TPEL paper is finished. Submission is postponed until next spring. :)
2020-04-02 Weekly reports and thesis files.
    [DPT.opj, HTOvsSTO.opj]
2020-05-03 Chapter 2 and Chapter 4 is completed. Protection letter figures are organized. Weekly report is added.
    [HTOvsSTO.opj, Loss.xlsx, Nisan2020.xlsx, Thermal Current vs Voltage.csv, Thermal Current vs Voltage.xlsx, ThermalTestPowerLossvsCurrent.csv]
2020-05-04 High freq. oscillation problem is solved.
    [main.c]
2020-05-06 Cover Letter is uploaded.
    [HTOvsSTO.opj]
2020-05-12 The critical points for soft-starting are defined.
    [Derivative.xlsx]
2020-06-18 - Introduction is 85% completed. - TPEL Review is analyzed. - Simulation Model for SC is prepared.
    [Experiments.xlsx, TPEL-Review.xlsx]
2020-06-26 Simulation model is developed and filter options are evaluated. Exp. verification is required.
2020-07-03 Protection: Layout design is explained in detail. DPT waveforms are changed. Sense and filter output voltages are given for varying DPT and SCT conditions. Filter design study is being added.
2020-07-03 Filter design is completed.
2020-07-24 Cover letter is updated.
    [TPEL-Review.xlsx]
2020-07-24 Cover letter second version is prepared.
    [TPEL-Review.xlsx]
2020-08-22 The thesis is almost finished.
    [Average Change.xlsx]
2020-08-22 The code used for the tests of buck and boost modes.
    [InductorThermalTest.xlsx]
2020-08-26 Appendix files are uploaded.
    [CossCharacteristics.GBL, CossCharacteristics.GBO, CossCharacteristics.GTL, CossCharacteristics.GTO, Gate_Loss_GS66508T.GTL, Gate_Loss_GS66508T.GTO, HalfBridge.GBL, HalfBridge.GBO]
2020-09-03 Presentation is almost finished.
    [Excel Plots.xlsx, HTOvsSTO.opj]
2020-10-25 Protection paper documents are updated.
    [HTOvsSTO.opj]
2020-10-26 journal figures are updated.
    [JESTPE-Review.xlsx]
2021-01-11 Minor changes.
    [YDrop.xlsx]
2021-02-23 Lots of changes through the time.
    [TransistorLoss.xlsx]
