furkankarakaya/GaN-Studies/Thesis/Presentation/Ch5_FanPlacedView.jpg

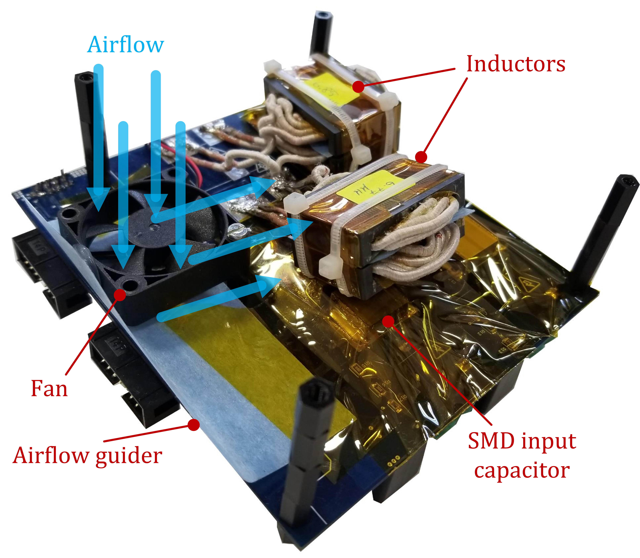
Thesis/Presentation/Ch5_FanPlacedView.jpg
